mishravipul361-blip/Ferrite-motor-design/femm_em/dq_summary.txt

D-Q MAP  (path values, peak; phase current = 2 x path current)
  magnet flux linkage psi_m            0.0211 Wb-turn
  Ld per path, unsat (id=-37.5 A)      219.1 uH    -> per delta phase 109.6 uH
  Lq per path, unsat (iq=37.5 A)       307.2 uH    -> per delta phase 153.6 uH
  at load (id -75, iq 112.5, ~rated):    Ld 187.1 uH, Lq 228.8 uH per path (delta phase 93.5 / 114.4 uH), Lq/Ld 1.22
  characteristic current psi_m/Ld      96 A path peak = 236 A rms line  (current limit 360 A rms)
  d-q torque formula vs FEMM torque    max diff 0.4 N.m

TORQUE-SPEED ENVELOPE  360 A rms + 11 kW DC, 52 V (phase peak 49.4 V), R at 100 C, inverter eff 0.97
     rpm    T N.m  shaft kW  DC kW  Cu loss W  I A rms    id    iq   V peak
       0    44.96     0.00    0.90       871      360    -64   132     2.0
    1000    44.96     4.71    5.75       871      360    -64   132    17.0
    2000    44.96     9.42   10.60       871      360    -64   132    32.5
    3000    32.64    10.25   11.00       414      248    -26    98    45.3
    4000    24.84    10.40   10.98       245      191    -37    69    49.2
    5000    19.85    10.39   10.97       252      194    -60    51    44.8
    6000    16.55    10.40   10.95       220      181    -60    43    47.7
    7000    14.20    10.41   10.95       212      178    -62    37    49.1
    8000    12.34    10.34   10.91       245      191    -71    32    46.2
    9000    10.91    10.29   10.89       280      204    -78    28    43.2
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

Calibration (motor_config.json): {'magnet_temp_C': 35.0, 'stacking': 0.95, 'mu_mag': 1.1}
Not included: end-winding leakage inductance (adds to Ld and Lq -> lower base speed),
iron and mechanical losses (shaft power is a little lower, DC power a little higher), 3D magnet end leakage.
