mishravipul361-blip/Ferrite-motor-design/Design9795_1/report_alu_f40/index.html

12-slot / 10-pole ferrite spoke

# Design9795 aluminium winding

FEMM 4.2 · Motor-CAD-equivalent model
OD 160–170 · M235-35A
Al: fill ≤ 0.40, bundle AC loss, end winding 1.136
Cu: busbar, fill 0.513, 0.7
17 Oct 2026

Design9795 · aluminium winding · conventional winding, fill ≤ 0.40

## Summary

#### Busbar copper against conventional aluminium

The copper reference is Design9795_1 as built: busbar-connected tooth coils, insulated wire fill 0.513, Motor-CAD armature end-winding MLT multiplier 0.7 (mean turn 203.6 mm, 13.48 mΩ per path at 100 °C). Every aluminium design is a conventional winding: insulated wire fill at most 0.40, standard wire sizes, end-winding multiplier 1.136 (end turns 1.623 × longer), and the strands in hand treated as one bundle for proximity loss, as Motor-CAD does with Include Bundle Effect: more strands do not reduce the AC loss. The rotor is unchanged; only the stator, stack length and winding change.

Aluminium can replace the copper winding of Design9795_1 with stator-only changes (rotor cross-section, magnets, air gap and M235-35A kept), and a conventional winding at 40 % fill, but not at equal efficiency up to OD 170. The best balance saves ₹418 per motor (10 % of active-material cost) for 3.73 % range.

#### Recommended · OD 170 · 86 mm

−₹418

Range -3.73 % (telematics), -3.75 % (WMTC). Stator K6 (OD 170, yoke 7.85 mm, slot 23.65 mm deep, tooth 13.54 mm), 86 mm stack, 8 turns × 3 × 2.12 mm Al. Torque within 0.8 % of copper at every speed, +1.82 kg. Winding loss at peak torque +24 %.

#### Alternative, 98.5 % torque at high speed · OD 170 · 80 mm

−₹612

Range -3.10 % / -3.32 %. Stator K2 (OD 170, yoke 7.85 mm, slot 23.65 mm deep, tooth 15.54 mm), 80 mm stack, 8 turns × 1 × 3.55 mm Al. Winding loss at peak +28 %, +1.41 kg.

#### Least range loss · OD 170 · 90 mm

−₹124

Range -3.12 % / -3.38 %. Stator K1 (OD 170, yoke 8.85 mm, slot 22.65 mm deep, tooth 15.54 mm), 90 mm stack, 7 turns × 4 × 1.83 mm Al. Winding loss at peak +13 %, +2.68 kg.

### Cost against range, all designs

Every aluminium design evaluated (2946), Al wire at ₹370/kg. Lines: best designs at each O

Every aluminium design evaluated (2946), Al wire at ₹370/kg. Lines: best designs at each OD (none both cheaper and better on range). Left: torque within 1 % of copper at every speed. Right: up to 3 % short in the high-speed, DC-power-limited region.

### Best designs at each OD (full torque)

OD | Least range loss | Range | Saving (INR) | Largest saving | Range | Saving (INR)
OD 160 | no design keeps full torque (stack up to 100 mm) | – | – | – | – | –
OD 163 | G3 L94 N7 3x2.00 | −3.81 % | 252 | G5 L94 N7 1x3.55 | −3.97 % | 299
OD 165 | B3 L92 N7 1x3.55 | −3.57 % | 278 | B4 L92 N7 4x1.80 | −3.65 % | 281
OD 167 | F2 L90 N7 4x1.80 | −3.32 % | 263 | F2 L90 N7 4x1.80 | −3.32 % | 263
OD 170 | K1 L90 N7 4x1.83 | −3.12 % | 124 | K6 L86 N8 3x2.12 | −3.73 % | 418

Range parity is not reached: aluminium needs 1.64 × copper's conductor area for the same resistance (about 2.0 × with the longer end turns of the 1.136 multiplier). At 0.40 fill instead of 0.513, the stators up to OD 170 give only 0.78–1.30 × copper's conductor area at the same turns, so fewer turns and longer stacks carry the design. Each OD page has the details: stator variants, all best designs, efficiency maps, OP1–OP3, drive cycle and cost.

### Key designs

| Copper (today) | Least range loss | Alternative, 98.5 % torque at high speed | Recommended | Drop-in (reference)
Design | Cu SWG 11 | K1 L90 N7 4x1.83 | K2 L80 N8 1x3.55 | K6 L86 N8 3x2.12 | drop-in (SWG 11, 64 mm)
Stator OD (mm) | 160 | 170 | 170 | 170 | 160
Stator variant | D0 | K1 | K2 | K6 | D0
Stack length, stator = rotor = magnets (mm) | 64 | 90 | 80 | 86 | 64
Slot depth (mm) | 17.65 | 22.65 | 23.65 | 23.65 | 17.65
Tooth width (mm) | 15.54 | 15.54 | 15.54 | 13.54 | 15.54
Yoke (mm) | 8.85 | 8.85 | 7.85 | 7.85 | 8.85
Slot area (mm²) | 281.2 (×1.000) | 395.9 (×1.408) | 420.4 (×1.495) | 462.1 (×1.643) | 281.2 (×1.000)
Turns per coil | 10 | 7 | 8 | 8 | 10
Strands × bare diameter (mm) | 1 × 2.95 | 4 × 1.83 | 1 × 3.55 | 3 × 2.12 | 1 × 2.95
Conductor area (mm²) | 6.82 | 10.51 | 9.90 | 10.59 | 6.82
Insulated fill | 0.513 | 0.400 | 0.396 | 0.392 | 0.513
Mean turn length (mm) | 203.6 | 306.2 | 286.9 | 297.1 | 250.7
Resistance per path, 100 °C (mΩ) | 13.48 | 15.24 | 17.33 | 16.78 | 27.49
Peak torque, 1000 rpm (N·m) | 44.11 | 44.63 | 44.38 | 46.04 | 44.11
Worst envelope ratio vs copper | – | 99.4 % | 98.5 % | 99.2 % | 95.2 %
Winding loss at peak torque (W) | 885 | 996 | 1132 | 1096 | 1786
Current density at peak (A/mm² rms) | 15.2 | 9.9 | 10.5 | 9.8 | 15.2
Peak efficiency (%) | 95.36 | 94.54 | 94.40 | 94.44 | 94.27
Map efficiency, mean change (points) | – | −1.92 | −2.19 | −2.10 | −3.55
Telematics: Wh/km at motor terminals | 61.291 | 63.265 | 63.251 | 63.667 | 63.574
Range change, telematics | – | −3.12 % | −3.10 % | −3.73 % | −3.59 %
Range change, WMTC Class 1 | – | −3.38 % | −3.32 % | −3.75 % | −3.31 %
Winding mass (kg) | 1.488 | 0.731 | 0.737 | 0.816 | 0.555
Stator laminations (kg) | 3.635 | 5.921 | 5.089 | 5.151 | 3.635
Rotor laminations + magnets (kg) | 2.832 | 3.982 | 3.540 | 3.805 | 2.832
Active mass (kg) | 7.955 | 10.634 | 9.365 | 9.772 | 7.021
Material cost (INR) | 4349 | 4225 | 3737 | 3931 | 2846
Saving vs copper (INR) | – | 124 (2.8 %) | 612 (14.1 %) | 418 (9.6 %) | 1504 (34.6 %)

### Operating points OP1–OP3

Efficiency change vs copper (points) | Least range loss | Alternative, 98.5 % torque at high speed | Recommended | Drop-in
OP1: 9000 rpm, maximum power | +0.26 | −0.05 | −0.21 | −1.56
OP2: 9339 rpm, 3.24 N·m | −4.69 | −3.37 | −4.79 | −0.91
OP3: 2000 rpm, maximum torque | −1.00 | −2.20 | −1.60 | −7.12

AC winding loss at 9000 rpm (OP1): copper's single 2.95 mm wire 505 W; the key aluminium designs 327–351 W with the bundle effect (aluminium's higher resistivity lowers eddy loss at the same bundle size; its strands do not). At peak torque (OP3) the higher DC resistance costs efficiency. Full tables on the OD 170 page.

Design9795 · aluminium winding · conventional winding, fill ≤ 0.40

## Busbar fill vs 40 % fill

The same aluminium study run twice against the same copper reference (busbar, fill 0.513, multiplier 0.7). Earlier: aluminium allowed copper's 0.513 fill, AC loss strand by strand, OD up to 167. Now: conventional winding at fill ≤ 0.40, AC loss with the bundle effect, OD up to 170, stacks up to 100 mm, 7–10 turns.

OD | Choice | Fill 0.513 design | Range | Saving (INR) | Fill 0.40 design | Range | Saving (INR)
OD 160 | least range loss | A5 L82 N8 4x1.80 | −2.36 % | 819 | – | – | –
OD 160 | largest saving | A5 L82 N8 5x1.60 | −2.38 % | 823 | – | – | –
OD 163 | least range loss | G3 L80 N8 4x1.83 | −1.96 % | 782 | G3 L94 N7 3x2.00 | −3.81 % | 252
OD 163 | within 2 % range | G3 L80 N8 5x1.63 | −1.97 % | 786 | – | – | –
OD 163 | largest saving | G3 L78 N9 6x1.40 | −2.60 % | 871 | G5 L94 N7 1x3.55 | −3.97 % | 299
OD 165 | least range loss | B2 L80 N8 6x1.50 | −1.83 % | 698 | B3 L92 N7 1x3.55 | −3.57 % | 278
OD 165 | within 2 % range | B3 L80 N8 6x1.50 | −2.00 % | 739 | – | – | –
OD 165 | largest saving | B3 L78 N9 6x1.42 | −2.61 % | 822 | B4 L92 N7 4x1.80 | −3.65 % | 281
OD 167 | least range loss | F1 L78 N8 6x1.50 | −1.54 % | 696 | F2 L90 N7 4x1.80 | −3.32 % | 263
OD 167 | within 2 % range | F4 L74 N9 4x1.90 | −1.96 % | 952 | – | – | –
OD 167 | largest saving | F4 L74 N9 4x1.90 | −1.96 % | 952 | F2 L90 N7 4x1.80 | −3.32 % | 263
OD 170 | least range loss | – | – | – | K1 L90 N7 4x1.83 | −3.12 % | 124
OD 170 | largest saving | – | – | – | K6 L86 N8 3x2.12 | −3.73 % | 418
All ODs | least range loss | F1 L78 N8 6x1.50 | −1.54 % | 696 | K1 L90 N7 4x1.83 | −3.12 % | 124
All ODs | within 2 % range | F4 L74 N9 4x1.90 | −1.96 % | 952 | – | – | –
All ODs | largest saving | F4 L74 N9 4x1.90 | −1.96 % | 952 | K6 L86 N8 3x2.12 | −3.73 % | 418

Full torque at every speed (envelope ≥ 99 %, peak ≥ 99.5 % of copper). Range on the telematics cycle; savings against copper at Al ₹370/kg.

Design9795 · aluminium winding · conventional winding, fill ≤ 0.40

## Method and copper baseline

Every number comes from the Motor-CAD-equivalent FEMM model of Design9795_1, extended with FEMM solutions of each stator variant, then run through the vehicle drive cycles.

Stage | Script | What it computes | Count
1. Copper model | lab_model.py (v3), make_lab_v2.py | Motor-CAD-equivalent Lab model: skew slices, Motor-CAD torque, minor-loop hysteresis + harmonic eddy iron loss | validated on 840 Motor-CAD map points
2. Stator variants | alu9795_femm.py (FEMM) | Torque, d-q flux, stator iron-loss sums, slot field, tooth and yoke flux density on a 4 × 4 current grid × 2 rotor positions | 28 stators × 32 = 896 solves
3. Design search | alu9795_study.py, alu9795_search.py | Each stator × stack 64–100 mm × 7/8/9/10 turns per coil × wire (largest area at fill ≤ 0.40; also the fewest strands within 3 % of it): envelope, efficiency map, peak point, drive cycles, cost | 2946 designs
4. Best designs | alu9795_analyse.py | Cost against range fronts per OD and criterion; Al price sensitivity | 5 ODs × 2 criteria × 3 prices
5. FEMM check | alu9795_verify.py | Direct solves between grid nodes, 4 rotor positions, against the interpolation | 60 solves
6. Operating points | alu9795_ops.py | OP1–OP3: currents, phase advance, voltage, flux, power factor, loss breakdown | 16 designs

### Copper baseline (Design9795_1)

Stator OD 160 mm, bore 107 mm, 12 slots, slot depth 17.65 mm, tooth 15.54 mm, yoke 8.85 mm, slot 281.2 mm²; 10-pole spoke ferrite rotor; 64 mm stack; delta, 2 parallel paths, 10 turns per coil of SWG 11 (2.946 mm) copper, fill 0.513; M235-35A. Drive: 52 V, modulation 0.95 (49.4 V phase peak), 360 A rms line, 280 A DC, MTPA. Winding and magnets at 100 °C.

#### Busbar copper against conventional aluminium

The copper reference is Design9795_1 as built: busbar-connected tooth coils, insulated wire fill 0.513, Motor-CAD armature end-winding MLT multiplier 0.7 (mean turn 203.6 mm, 13.48 mΩ per path at 100 °C). Every aluminium design is a conventional winding: insulated wire fill at most 0.40, standard wire sizes, end-winding multiplier 1.136 (end turns 1.623 × longer), and the strands in hand treated as one bundle for proximity loss, as Motor-CAD does with Include Bundle Effect: more strands do not reduce the AC loss. The rotor is unchanged; only the stator, stack length and winding change.

The FEMM copper model matches Motor-CAD Lab within 0.28 efficiency points (mean over 840 map points), 1.6 % torque and 2.7 % total loss; envelope torque within 0.7 % from 1000 to 9000 rpm (see the Lab validation report).

Copper efficiency map from the Motor-CAD-equivalent FEMM model, with the three operating p

Copper efficiency map from the Motor-CAD-equivalent FEMM model, with the three operating points.

OP1 · 9000 rpm, maximum power | Motor-CAD, copper | Copper (FEMM)
Shaft torque (N·m) | 13.98 | 14.05
Electromagnetic torque (N·m) | 14.46 | 14.50
Shaft power (W) | 13178 | 13239
Input power (W) | 14560 | 14552
Efficiency (%) | 90.51 | 90.97
Line current (A rms) | 247.2 | 236.3
Phase current (A rms, delta) | 142.7 | 136.4
Id, phase (A peak) | −184.2 | −173.3
Iq, phase (A peak) | 82.5 | 84.7
Phase advance (° el) | 65.9 | 63.9
Phase voltage (V peak, limit 49.4) | 49.40 | 49.38
Power factor | 0.974 | 0.983
ψd (mV·s) | 1.72 | 2.68
ψq (mV·s) | 9.69 | 9.85
DC bus current (A) | 280.0 | 279.9
Current density (A/mm² rms) | – | 10.0
Active limit | – | voltage, DC current
DC winding loss (W) | 411.7 | 376.2
AC winding loss (W) | 526.5 | 505.5
Stator hysteresis (W) | – | 71.6
Stator eddy (W) | – | 125.7
Stator iron total (W) | 205.3 | 197.4
Rotor iron (W) | 89.4 | 85.7
Iron total (W) | 294.7 | 283.1
Bearings + windage (W) | 148.9 | 148.9
Total loss (W) | 1381.8 | 1313.6

OP2 · 9339 rpm, 3.24 N·m | Copper (FEMM)
Shaft torque (N·m) | 3.27
Electromagnetic torque (N·m) | 3.62
Shaft power (W) | 3195
Input power (W) | 3785
Efficiency (%) | 84.41
Line current (A rms) | 120.7
Phase current (A rms, delta) | 69.7
Id, phase (A peak) | −96.2
Iq, phase (A peak) | 21.8
Phase advance (° el) | 77.2
Phase voltage (V peak, limit 49.4) | 49.22
Power factor | 0.499
ψd (mV·s) | 9.59
ψq (mV·s) | 2.84
DC bus current (A) | 72.8
Current density (A/mm² rms) | 5.1
Active limit | voltage
DC winding loss (W) | 98.3
AC winding loss (W) | 150.4
Stator hysteresis (W) | 54.2
Stator eddy (W) | 99.6
Stator iron total (W) | 153.8
Rotor iron (W) | 31.6
Iron total (W) | 185.4
Bearings + windage (W) | 156.2
Total loss (W) | 590.2

OP3 · 2000 rpm, maximum torque | Motor-CAD, copper | Copper (FEMM)
Shaft torque (N·m) | 44.11 | 44.06
Electromagnetic torque (N·m) | 44.76 | 44.67
Shaft power (W) | 9239 | 9227
Input power (W) | 10306 | 10284
Efficiency (%) | 89.65 | 89.73
Line current (A rms) | 360.0 | 360.0
Phase current (A rms, delta) | 207.8 | 207.8
Id, phase (A peak) | −85.0 | −90.8
Iq, phase (A peak) | 281.4 | 279.6
Phase advance (° el) | 16.8 | 18.0
Phase voltage (V peak, limit 49.4) | 34.36 | 33.85
Power factor | 0.680 | 0.685
ψd (mV·s) | 12.48 | 12.00
ψq (mV·s) | 28.90 | 28.65
DC bus current (A) | 198.2 | 197.8
Current density (A/mm² rms) | – | 15.2
Active limit | – | 360 A
DC winding loss (W) | 873.5 | 873.5
AC winding loss (W) | 57.4 | 54.7
Stator hysteresis (W) | – | 61.2
Stator eddy (W) | – | 20.4
Stator iron total (W) | 87.4 | 81.5
Rotor iron (W) | 27.7 | 25.9
Iron total (W) | 115.1 | 107.4
Bearings + windage (W) | 21.1 | 21.1
Total loss (W) | 1067.1 | 1056.6

Motor-CAD values from its envelope export (OP1, OP3). Motor-CAD splits iron loss into stator/rotor and hysteresis/eddy for the machine; its OP1 hysteresis 111 W, eddy 184 W. FEMM's OP1 iron loss is lower (the known hysteresis gap), so copper's FEMM efficiency is +0.46 points against Motor-CAD at OP1 and +0.08 at OP3. Aluminium designs are compared with FEMM copper, so this offset cancels.

### How an aluminium design is evaluated

- Turns: currents scaled by turns (same ampere-turns give the same field), flux linkage × turns, end-winding inductance × turns².
- Stack length: flux, torque, iron loss and windage scale with length (2D); end-turn length unchanged.
- Stator variant: FEMM differences against the copper stator at the same ampere-turns, added to the copper model (flux), or as ratios (stator iron loss, slot field). Checked against direct FEMM solves: ψq within 0.88 %, iron-loss ratio within 1.6 %.
- Winding: aluminium EC-1350 (2.826 × 10⁻⁸ Ω·m at 20 °C, 0.00403/K, 2703 kg/m³) at 100 °C; conventional winding with insulated wire fill at most 0.40 (copper's busbar winding: 0.513); standard IEC and SWG wire sizes from 1.0 mm, 1–8 strands; mean turn = 2L + 1.136/0.7 × end turn corrected for tooth width and coil thickness; AC loss by Motor-CAD's hybrid method (factor 2) with FEMM's slot field and the bundle effect: the strands in hand count as one round conductor of the same total area (loss ∝ turns × (strands × d²)²), so it does not fall with more strands.
- Acceptance: full = peak torque ≥ 99.5 % of copper and envelope ≥ 99 % at every speed 0–9500 rpm; relaxed = envelope ≥ 97 % (shortfall only in the DC-power-limited region above about 3000 rpm).

Design9795 · aluminium winding · conventional winding, fill ≤ 0.40

## OD 160 mm

Same OD and housing as copper. The slot can only grow inward (thinner yoke) or sideways (thinner teeth), and both cost torque per ampere-turn: −1.3 % per mm of yoke, −1.9 % per mm of tooth. Aluminium therefore needs a long stack. 723 designs evaluated at this OD; 0 keep full torque at every speed, 120 stay within 3 %.

### Stator variants at OD 160

Stator | OD | Slot depth | Tooth | Yoke | Slot area (mm²) | vs copper | Max torque (N·m)* | vs copper | Tooth B 99 % (T) | Yoke B 99 % (T) | Stator steel (kg)*
D0 | 160 | 17.65 | 15.54 | 8.85 | 281.2 | ×1.000 | 50.62 | +0.0 % | 2.28 | 1.70 | 3.635
A1 | 160 | 18.65 | 15.54 | 7.85 | 303.1 | ×1.078 | 49.97 | −1.3 % | 2.28 | 1.78 | 3.510
A2 | 160 | 19.65 | 15.54 | 6.85 | 325.5 | ×1.157 | 48.38 | −4.4 % | 2.25 | 1.83 | 3.382
A3 | 160 | 17.65 | 14.54 | 8.85 | 296.2 | ×1.053 | 49.68 | −1.9 % | 2.27 | 1.66 | 3.550
A4 | 160 | 18.65 | 14.54 | 7.85 | 319.0 | ×1.135 | 49.16 | −2.9 % | 2.26 | 1.76 | 3.419
A5 | 160 | 19.65 | 14.54 | 6.85 | 342.5 | ×1.218 | 47.74 | −5.7 % | 2.24 | 1.82 | 3.285
A6 | 160 | 18.65 | 13.54 | 7.85 | 334.7 | ×1.190 | 48.06 | −5.0 % | 2.26 | 1.74 | 3.330

* FEMM 2D, 64 mm stack, 10 turns per coil, peak over the 4 × 4 current grid at 360 A (no skew). Dimensions in mm.

Slot outlines of the OD 160 stators against the copper stator (D0). Tooth tip and slot ope

Slot outlines of the OD 160 stators against the copper stator (D0). Tooth tip and slot opening are unchanged in every variant.

### Cost against range

All designs at OD 160. Dark: full torque at every speed; light blue: within 3 %; grey: nei

All designs at OD 160. Dark: full torque at every speed; light blue: within 3 %; grey: neither. Line: best designs (full). Circles: designs detailed below.

#### Best designs, full torque at every speed

No design at this OD meets this criterion.

#### Best designs, up to 3 % torque shortfall at high speed

Design | Stator | Yoke (mm) | Stack (mm) | Turns × (strands × d) | Worst envelope | Range, telematics | Range, WMTC | Saving (INR) | Winding loss at peak (W) | Mass change (kg)
A3 L90 N7 2x2.24 | A3 | 8.85 | 90 | 7 × (2 × 2.24) | 97.8 % | −3.67 % | −3.87 % | 477 | 1302 | +1.56
A3 L90 N7 1x3.15 | A3 | 8.85 | 90 | 7 × (1 × 3.15) | 97.8 % | −3.72 % | −3.93 % | 479 | 1317 | +1.55
A4 L90 N7 4x1.63 | A4 | 7.85 | 90 | 7 × (4 × 1.63) | 98.0 % | −3.74 % | −4.04 % | 520 | 1240 | +1.41
A4 L90 N7 1x3.25 | A4 | 7.85 | 90 | 7 × (1 × 3.25) | 98.0 % | −3.74 % | −4.04 % | 520 | 1241 | +1.41
A6 L82 N8 1x3.15 | A6 | 7.85 | 82 | 8 × (1 × 3.15) | 97.2 % | −3.94 % | −4.02 % | 872 | 1425 | +0.52
A5 L82 N8 3x1.83 | A5 | 6.85 | 82 | 8 × (3 × 1.83) | 97.2 % | −4.03 % | −4.15 % | 886 | 1416 | +0.47
A5 L82 N8 1x3.15 | A5 | 6.85 | 82 | 8 × (1 × 3.15) | 97.1 % | −4.09 % | −4.20 % | 888 | 1432 | +0.46

At the copper stack of 64 mm, no design at this OD meets either criterion: aluminium at 64 mm loses torque either at low speed (fewer turns, 360 A limit) or above 2500 rpm (10 turns, higher resistance).

### Effect of stack length and turns

Best design (range) at each stack length and turn count at OD 160, among those within 3 %

Best design (range) at each stack length and turn count at OD 160, among those within 3 % of copper torque; filled dots also meet the full criterion. Fewer turns need a longer stack for the same torque at 360 A.

### Designs in detail

| Copper (today) | Least range loss, ≤ 3 % high-speed torque | Largest saving, ≤ 3 % high-speed torque
Design | Cu SWG 11 | A3 L90 N7 2x2.24 | A5 L82 N8 1x3.15
Stator OD (mm) | 160 | 160 | 160
Stator variant | D0 | A3 | A5
Stack length, stator = rotor = magnets (mm) | 64 | 90 | 82
Slot depth (mm) | 17.65 | 17.65 | 19.65
Tooth width (mm) | 15.54 | 14.54 | 14.54
Yoke (mm) | 8.85 | 8.85 | 6.85
Slot area (mm²) | 281.2 (×1.000) | 296.2 (×1.053) | 342.5 (×1.218)
Turns per coil | 10 | 7 | 8
Strands × bare diameter (mm) | 1 × 2.95 | 2 × 2.24 | 1 × 3.15
Conductor area (mm²) | 6.82 | 7.88 | 7.79
Insulated fill | 0.513 | 0.397 | 0.384
Mean turn length (mm) | 203.6 | 301.8 | 287.2
Resistance per path, 100 °C (mΩ) | 13.48 | 20.04 | 22.04
Peak torque, 1000 rpm (N·m) | 44.11 | 44.25 | 44.32
Worst envelope ratio vs copper | – | 97.8 % | 97.1 %
Winding loss at peak torque (W) | 885 | 1302 | 1432
Current density at peak (A/mm² rms) | 15.2 | 13.2 | 13.3
Peak efficiency (%) | 95.36 | 94.31 | 94.13
Map efficiency, mean change (points) | – | −2.96 | −3.26
Telematics: Wh/km at motor terminals | 61.291 | 63.623 | 63.903
Range change, telematics | – | −3.67 % | −4.09 %
Range change, WMTC Class 1 | – | −3.87 % | −4.20 %
Winding mass (kg) | 1.488 | 0.540 | 0.581
Stator laminations (kg) | 3.635 | 4.992 | 4.209
Rotor laminations + magnets (kg) | 2.832 | 3.982 | 3.628
Active mass (kg) | 7.955 | 9.514 | 8.419
Material cost (INR) | 4349 | 3872 | 3461
Saving vs copper (INR) | – | 477 (11.0 %) | 888 (20.4 %)

### Torque-speed envelope

Maximum shaft torque at each speed against copper, same drive limits. Right: ratio to copp

Maximum shaft torque at each speed against copper, same drive limits. Right: ratio to copper; dotted lines 99 % and 97 %.

### Efficiency maps against copper

Efficiency change against copper at the same speed and shaft torque (blue = aluminium bett

Efficiency change against copper at the same speed and shaft torque (blue = aluminium better). Triangles: OP1–OP3.

Efficiency map of A5 L82 N8 1x3.15.

Efficiency map of A5 L82 N8 1x3.15.

### Operating points OP1, OP2, OP3

Efficiency change vs copper (points) | Least range loss, ≤ 3 % high-speed torque | Largest saving, ≤ 3 % high-speed torque
OP1: 9000 rpm, maximum power | −0.12 | −0.25
OP2: 9339 rpm, 3.24 N·m | −4.67 | −4.17
OP3: 2000 rpm, maximum torque | −3.40 | −4.47

Loss breakdown at the operating points; label = total loss and efficiency.

Loss breakdown at the operating points; label = total loss and efficiency.

OP1 · 9000 rpm, maximum power | Motor-CAD, copper | Copper (FEMM) | Least range loss, ≤ 3 % high-speed torque | Largest saving, ≤ 3 % high-speed torque
Shaft torque (N·m) | 13.98 | 14.05 | 14.03 | 13.99
Electromagnetic torque (N·m) | 14.46 | 14.50 | 14.54 | 14.51
Shaft power (W) | 13178 | 13239 | 13227 | 13187
Input power (W) | 14560 | 14552 | 14559 | 14535
Efficiency (%) | 90.51 | 90.97 | 90.85 | 90.73
Line current (A rms) | 247.2 | 236.3 | 254.2 | 240.0
Phase current (A rms, delta) | 142.7 | 136.4 | 146.8 | 138.6
Id, phase (A peak) | −184.2 | −173.3 | −187.7 | −176.6
Iq, phase (A peak) | 82.5 | 84.7 | 88.8 | 84.9
Phase advance (° el) | 65.9 | 63.9 | 64.7 | 64.3
Phase voltage (V peak, limit 49.4) | 49.40 | 49.38 | 47.86 | 49.18
Power factor | 0.974 | 0.983 | 0.963 | 0.990
ψd (mV·s) | 1.72 | 2.68 | 6.47 | 5.63
ψq (mV·s) | 9.69 | 9.85 | 7.27 | 8.25
DC bus current (A) | 280.0 | 279.9 | 280.0 | 279.5
Current density (A/mm² rms) | – | 10.0 | 9.3 | 8.9
Active limit | – | voltage, DC current | DC current | voltage, DC current
DC winding loss (W) | 411.7 | 376.2 | 647.6 | 634.7
AC winding loss (W) | 526.5 | 505.5 | 207.9 | 229.4
Stator hysteresis (W) | – | 71.6 | 84.8 | 89.2
Stator eddy (W) | – | 125.7 | 148.9 | 155.4
Stator iron total (W) | 205.3 | 197.4 | 233.7 | 244.7
Rotor iron (W) | 89.4 | 85.7 | 75.3 | 77.6
Iron total (W) | 294.7 | 283.1 | 309.0 | 322.3
Bearings + windage (W) | 148.9 | 148.9 | 167.0 | 161.4
Total loss (W) | 1381.8 | 1313.6 | 1331.5 | 1347.8

OP2 · 9339 rpm, 3.24 N·m | Copper (FEMM) | Least range loss, ≤ 3 % high-speed torque | Largest saving, ≤ 3 % high-speed torque
Shaft torque (N·m) | 3.27 | 3.29 | 3.24
Electromagnetic torque (N·m) | 3.62 | 3.75 | 3.69
Shaft power (W) | 3195 | 3221 | 3172
Input power (W) | 3785 | 4039 | 3953
Efficiency (%) | 84.41 | 79.74 | 80.24
Line current (A rms) | 120.7 | 165.0 | 150.0
Phase current (A rms, delta) | 69.7 | 95.3 | 86.6
Id, phase (A peak) | −96.2 | −132.7 | −120.5
Iq, phase (A peak) | 21.8 | 23.2 | 21.9
Phase advance (° el) | 77.2 | 80.1 | 79.7
Phase voltage (V peak, limit 49.4) | 49.22 | 49.39 | 49.36
Power factor | 0.499 | 0.395 | 0.425
ψd (mV·s) | 9.59 | 9.78 | 9.71
ψq (mV·s) | 2.84 | 2.05 | 2.31
DC bus current (A) | 72.8 | 77.7 | 76.0
Current density (A/mm² rms) | 5.1 | 6.0 | 5.6
Active limit | voltage | voltage | voltage
DC winding loss (W) | 98.3 | 272.7 | 247.9
AC winding loss (W) | 150.4 | 98.0 | 100.1
Stator hysteresis (W) | 54.2 | 81.8 | 79.7
Stator eddy (W) | 99.6 | 147.4 | 144.3
Stator iron total (W) | 153.8 | 229.2 | 223.9
Rotor iron (W) | 31.6 | 43.1 | 40.0
Iron total (W) | 185.4 | 272.3 | 264.0
Bearings + windage (W) | 156.2 | 175.2 | 169.4
Total loss (W) | 590.2 | 818.2 | 781.4

OP3 · 2000 rpm, maximum torque | Motor-CAD, copper | Copper (FEMM) | Least range loss, ≤ 3 % high-speed torque | Largest saving, ≤ 3 % high-speed torque
Shaft torque (N·m) | 44.11 | 44.06 | 44.17 | 44.25
Electromagnetic torque (N·m) | 44.76 | 44.67 | 44.87 | 44.97
Shaft power (W) | 9239 | 9227 | 9251 | 9268
Input power (W) | 10306 | 10284 | 10716 | 10870
Efficiency (%) | 89.65 | 89.73 | 86.33 | 85.26
Line current (A rms) | 360.0 | 360.0 | 360.0 | 360.0
Phase current (A rms, delta) | 207.8 | 207.8 | 207.8 | 207.8
Id, phase (A peak) | −85.0 | −90.8 | −72.4 | −89.9
Iq, phase (A peak) | 281.4 | 279.6 | 284.9 | 279.8
Phase advance (° el) | 16.8 | 18.0 | 14.3 | 17.8
Phase voltage (V peak, limit 49.4) | 34.36 | 33.85 | 30.32 | 31.57
Power factor | 0.680 | 0.685 | 0.800 | 0.779
ψd (mV·s) | 12.48 | 12.00 | 15.45 | 13.64
ψq (mV·s) | 28.90 | 28.65 | 21.85 | 24.22
DC bus current (A) | 198.2 | 197.8 | 206.1 | 209.0
Current density (A/mm² rms) | – | 15.2 | 13.2 | 13.3
Active limit | – | 360 A | 360 A | 360 A
DC winding loss (W) | 873.5 | 873.5 | 1298.3 | 1428.1
AC winding loss (W) | 57.4 | 54.7 | 20.5 | 23.3
Stator hysteresis (W) | – | 61.2 | 73.3 | 78.0
Stator eddy (W) | – | 20.4 | 23.1 | 24.5
Stator iron total (W) | 87.4 | 81.5 | 96.4 | 102.6
Rotor iron (W) | 27.7 | 25.9 | 25.9 | 25.5
Iron total (W) | 115.1 | 107.4 | 122.3 | 128.1
Bearings + windage (W) | 21.1 | 21.1 | 23.6 | 22.8
Total loss (W) | 1067.1 | 1056.6 | 1464.8 | 1602.2

### Drive cycle and range

Design | Cycle | Net Wh/km | Shaft out, motoring | Electrical in, motoring | η motoring (%) | Shaft in, regen | Electrical out, regen | η regen (%) | DC winding loss | AC winding loss | Iron loss | Mech. loss | Total loss | Range change
Copper | Telematics | 61.291 | 81.53 | 87.83 | 92.82 | 28.55 | 26.54 | 92.97 | 2.82 | 0.84 | 3.04 | 1.61 | 8.32 | –
| WMTC Class 1 | 60.520 | 76.21 | 81.72 | 93.26 | 22.91 | 21.20 | 92.55 | 2.13 | 0.40 | 3.10 | 1.59 | 7.22 | –
Least range loss, ≤ 3 % high-speed torque | Telematics | 63.623 | 81.52 | 89.58 | 91.01 | 28.55 | 25.95 | 90.91 | 4.35 | 0.32 | 4.17 | 1.81 | 10.65 | −3.67 %
| WMTC Class 1 | 62.958 | 76.21 | 83.56 | 91.21 | 22.91 | 20.60 | 89.92 | 3.45 | 0.16 | 4.27 | 1.78 | 9.66 | −3.87 %
Largest saving, ≤ 3 % high-speed torque | Telematics | 63.903 | 81.43 | 89.77 | 90.71 | 28.54 | 25.86 | 90.63 | 4.65 | 0.38 | 4.24 | 1.75 | 11.01 | −4.09 %
| WMTC Class 1 | 63.175 | 76.21 | 83.72 | 91.03 | 22.91 | 20.54 | 89.67 | 3.60 | 0.18 | 4.37 | 1.72 | 9.87 | −4.20 %

Energies and losses in Wh/km at the motor (motor losses only; inverter, battery and vehicle are the same for every design).

Motor losses over the telematics cycle by type.

Motor losses over the telematics cycle by type.

Where the range is lost: extra loss against copper over the telematics cycle, by motor spe

Where the range is lost: extra loss against copper over the telematics cycle, by motor speed band, motoring (left) and regenerating (right).

### Cost

Design | Winding (kg) | Wire (INR) | Laminations (kg) | Laminations (INR) | Magnets (kg) | Magnets (INR) | Total (INR) | Saving, Al ₹370 | Saving, Al ₹230 | Saving, Al ₹450
Copper | 1.488 | 1719 | 5.087 | 1526 | 1.380 | 1104 | 4349 | – | – | –
Least range loss, ≤ 3 % high-speed torque | 0.540 | 210 | 7.033 | 2110 | 1.941 | 1553 | 3872 | 477 | 556 | 431
Largest saving, ≤ 3 % high-speed torque | 0.581 | 226 | 6.069 | 1821 | 1.768 | 1415 | 3461 | 888 | 973 | 839

Design9795 · aluminium winding · conventional winding, fill ≤ 0.40

## OD 163 mm

Three extra millimetres of OD deepen the slot by 1.5 mm with the copper yoke and tooth (slot ×1.118), or by 2.5 mm with a 1 mm thinner yoke. 494 designs evaluated at this OD; 4 keep full torque at every speed, 109 stay within 3 %.

### Stator variants at OD 163

Stator | OD | Slot depth | Tooth | Yoke | Slot area (mm²) | vs copper | Max torque (N·m)* | vs copper | Tooth B 99 % (T) | Yoke B 99 % (T) | Stator steel (kg)*
D0 | 160 | 17.65 | 15.54 | 8.85 | 281.2 | ×1.000 | 50.62 | +0.0 % | 2.28 | 1.70 | 3.635
G1 | 163 | 19.15 | 15.54 | 8.85 | 314.3 | ×1.118 | 50.48 | −0.3 % | 2.29 | 1.71 | 3.808
G2 | 163 | 20.15 | 15.54 | 7.85 | 336.9 | ×1.198 | 49.80 | −1.6 % | 2.27 | 1.78 | 3.679
G3 | 163 | 20.15 | 14.54 | 7.85 | 354.4 | ×1.260 | 48.96 | −3.3 % | 2.26 | 1.76 | 3.579
G4 | 163 | 21.15 | 15.54 | 6.85 | 360.1 | ×1.281 | 48.17 | −4.8 % | 2.25 | 1.83 | 3.546
G5 | 163 | 21.15 | 14.54 | 6.85 | 378.6 | ×1.346 | 47.52 | −6.1 % | 2.24 | 1.82 | 3.441

* FEMM 2D, 64 mm stack, 10 turns per coil, peak over the 4 × 4 current grid at 360 A (no skew). Dimensions in mm.

Slot outlines of the OD 163 stators against the copper stator (D0). Tooth tip and slot ope

Slot outlines of the OD 163 stators against the copper stator (D0). Tooth tip and slot opening are unchanged in every variant.

### Cost against range

All designs at OD 163. Dark: full torque at every speed; light blue: within 3 %; grey: nei

All designs at OD 163. Dark: full torque at every speed; light blue: within 3 %; grey: neither. Line: best designs (full). Circles: designs detailed below.

#### Best designs, full torque at every speed

Design | Stator | Yoke (mm) | Stack (mm) | Turns × (strands × d) | Worst envelope | Range, telematics | Range, WMTC | Saving (INR) | Winding loss at peak (W) | Mass change (kg)
G3 L94 N7 3x2.00 | G3 | 7.85 | 94 | 7 × (3 × 2.00) | 99.1 % | −3.81 % | −3.90 % | 252 | 1127 | +2.13
G5 L94 N7 1x3.55 | G5 | 6.85 | 94 | 7 × (1 × 3.55) | 99.0 % | −3.97 % | −4.21 % | 299 | 1076 | +1.96

#### Best designs, up to 3 % torque shortfall at high speed

Design | Stator | Yoke (mm) | Stack (mm) | Turns × (strands × d) | Worst envelope | Range, telematics | Range, WMTC | Saving (INR) | Winding loss at peak (W) | Mass change (kg)
G3 L80 N8 1x3.25 | G3 | 7.85 | 80 | 8 × (1 × 3.25) | 97.5 % | −3.48 % | −3.70 % | 845 | 1330 | +0.67
G5 L78 N9 2x2.24 | G5 | 6.85 | 78 | 9 × (2 × 2.24) | 97.3 % | −4.27 % | −3.90 % | 964 | 1557 | +0.33
G5 L78 N9 1x3.15 | G5 | 6.85 | 78 | 9 × (1 × 3.15) | 97.2 % | −4.34 % | −3.95 % | 967 | 1574 | +0.33

At the copper stack of 64 mm, no design at this OD meets either criterion: aluminium at 64 mm loses torque either at low speed (fewer turns, 360 A limit) or above 2500 rpm (10 turns, higher resistance).

### Effect of stack length and turns

Best design (range) at each stack length and turn count at OD 163, among those within 3 %

Best design (range) at each stack length and turn count at OD 163, among those within 3 % of copper torque; filled dots also meet the full criterion. Fewer turns need a longer stack for the same torque at 360 A.

### Designs in detail

| Copper (today) | Least range loss | Largest saving, full torque | Largest saving, ≤ 3 % high-speed torque
Design | Cu SWG 11 | G3 L94 N7 3x2.00 | G5 L94 N7 1x3.55 | G5 L78 N9 1x3.15
Stator OD (mm) | 160 | 163 | 163 | 163
Stator variant | D0 | G3 | G5 | G5
Stack length, stator = rotor = magnets (mm) | 64 | 94 | 94 | 78
Slot depth (mm) | 17.65 | 20.15 | 21.15 | 21.15
Tooth width (mm) | 15.54 | 14.54 | 14.54 | 14.54
Yoke (mm) | 8.85 | 7.85 | 6.85 | 6.85
Slot area (mm²) | 281.2 (×1.000) | 354.4 (×1.260) | 378.6 (×1.346) | 378.6 (×1.346)
Turns per coil | 10 | 7 | 7 | 9
Strands × bare diameter (mm) | 1 × 2.95 | 3 × 2.00 | 1 × 3.55 | 1 × 3.15
Conductor area (mm²) | 6.82 | 9.42 | 9.90 | 7.79
Insulated fill | 0.513 | 0.399 | 0.385 | 0.391
Mean turn length (mm) | 203.6 | 311.6 | 312.3 | 280.3
Resistance per path, 100 °C (mΩ) | 13.48 | 17.30 | 16.51 | 24.19
Peak torque, 1000 rpm (N·m) | 44.11 | 45.73 | 44.89 | 46.55
Worst envelope ratio vs copper | – | 99.1 % | 99.0 % | 97.2 %
Winding loss at peak torque (W) | 885 | 1127 | 1076 | 1574
Current density at peak (A/mm² rms) | 15.2 | 11.0 | 10.5 | 13.3
Peak efficiency (%) | 95.36 | 94.44 | 94.37 | 94.16
Map efficiency, mean change (points) | – | −2.37 | −2.44 | −3.09
Telematics: Wh/km at motor terminals | 61.291 | 63.721 | 63.823 | 64.069
Range change, telematics | – | −3.81 % | −3.97 % | −4.34 %
Range change, WMTC Class 1 | – | −3.90 % | −4.21 % | −3.95 %
Winding mass (kg) | 1.488 | 0.667 | 0.702 | 0.638
Stator laminations (kg) | 3.635 | 5.256 | 5.053 | 4.193
Rotor laminations + magnets (kg) | 2.832 | 4.159 | 4.159 | 3.451
Active mass (kg) | 7.955 | 10.082 | 9.914 | 8.282
Material cost (INR) | 4349 | 4097 | 4050 | 3382
Saving vs copper (INR) | – | 252 (5.8 %) | 299 (6.9 %) | 967 (22.2 %)

### Torque-speed envelope

Maximum shaft torque at each speed against copper, same drive limits. Right: ratio to copp

Maximum shaft torque at each speed against copper, same drive limits. Right: ratio to copper; dotted lines 99 % and 97 %.

### Efficiency maps against copper

Efficiency change against copper at the same speed and shaft torque (blue = aluminium bett

Efficiency change against copper at the same speed and shaft torque (blue = aluminium better). Triangles: OP1–OP3.

Efficiency map of G5 L78 N9 1x3.15.

Efficiency map of G5 L78 N9 1x3.15.

### Operating points OP1, OP2, OP3

Efficiency change vs copper (points) | Least range loss | Largest saving, full torque | Largest saving, ≤ 3 % high-speed torque
OP1: 9000 rpm, maximum power | −0.11 | −0.05 | −0.98
OP2: 9339 rpm, 3.24 N·m | −5.86 | −5.80 | −4.06
OP3: 2000 rpm, maximum torque | −1.79 | −1.60 | −5.00

Loss breakdown at the operating points; label = total loss and efficiency.

Loss breakdown at the operating points; label = total loss and efficiency.

OP1 · 9000 rpm, maximum power | Motor-CAD, copper | Copper (FEMM) | Least range loss | Largest saving, full torque | Largest saving, ≤ 3 % high-speed torque
Shaft torque (N·m) | 13.98 | 14.05 | 14.04 | 14.05 | 13.89
Electromagnetic torque (N·m) | 14.46 | 14.50 | 14.57 | 14.60 | 14.41
Shaft power (W) | 13178 | 13239 | 13229 | 13238 | 13092
Input power (W) | 14560 | 14552 | 14560 | 14559 | 14548
Efficiency (%) | 90.51 | 90.97 | 90.86 | 90.92 | 89.99
Line current (A rms) | 247.2 | 236.3 | 251.2 | 248.3 | 237.0
Phase current (A rms, delta) | 142.7 | 136.4 | 145.1 | 143.3 | 136.8
Id, phase (A peak) | −184.2 | −173.3 | −186.6 | −183.8 | −176.8
Iq, phase (A peak) | 82.5 | 84.7 | 85.3 | 85.5 | 78.7
Phase advance (° el) | 65.9 | 63.9 | 65.4 | 65.1 | 66.0
Phase voltage (V peak, limit 49.4) | 49.40 | 49.38 | 48.44 | 48.95 | 49.13
Power factor | 0.974 | 0.983 | 0.958 | 0.958 | 1.000
ψd (mV·s) | 1.72 | 2.68 | 6.62 | 6.73 | 4.02
ψq (mV·s) | 9.69 | 9.85 | 7.39 | 7.46 | 9.08
DC bus current (A) | 280.0 | 279.9 | 280.0 | 280.0 | 279.8
Current density (A/mm² rms) | – | 10.0 | 7.7 | 7.2 | 8.8
Active limit | – | voltage, DC current | DC current | DC current | voltage, DC current
DC winding loss (W) | 411.7 | 376.2 | 545.9 | 508.6 | 679.4
AC winding loss (W) | 526.5 | 505.5 | 279.6 | 292.6 | 287.7
Stator hysteresis (W) | – | 71.6 | 93.8 | 99.6 | 88.6
Stator eddy (W) | – | 125.7 | 165.6 | 175.3 | 156.6
Stator iron total (W) | 205.3 | 197.4 | 259.4 | 274.8 | 245.2
Rotor iron (W) | 89.4 | 85.7 | 76.2 | 75.4 | 85.0
Iron total (W) | 294.7 | 283.1 | 335.6 | 350.2 | 330.2
Bearings + windage (W) | 148.9 | 148.9 | 169.8 | 169.8 | 158.6
Total loss (W) | 1381.8 | 1313.6 | 1331.0 | 1321.3 | 1456.0

OP2 · 9339 rpm, 3.24 N·m | Copper (FEMM) | Least range loss | Largest saving, full torque | Largest saving, ≤ 3 % high-speed torque
Shaft torque (N·m) | 3.27 | 3.26 | 3.28 | 3.24
Electromagnetic torque (N·m) | 3.62 | 3.74 | 3.78 | 3.67
Shaft power (W) | 3195 | 3184 | 3210 | 3173
Input power (W) | 3785 | 4053 | 4084 | 3949
Efficiency (%) | 84.41 | 78.55 | 78.61 | 80.35
Line current (A rms) | 120.7 | 170.2 | 168.7 | 141.8
Phase current (A rms, delta) | 69.7 | 98.3 | 97.4 | 81.8
Id, phase (A peak) | −96.2 | −137.2 | −135.9 | −113.9
Iq, phase (A peak) | 21.8 | 22.2 | 22.4 | 20.3
Phase advance (° el) | 77.2 | 80.8 | 80.6 | 79.9
Phase voltage (V peak, limit 49.4) | 49.22 | 49.20 | 49.37 | 49.34
Power factor | 0.499 | 0.381 | 0.386 | 0.448
ψd (mV·s) | 9.59 | 9.76 | 9.79 | 9.63
ψq (mV·s) | 2.84 | 2.06 | 2.09 | 2.58
DC bus current (A) | 72.8 | 77.9 | 78.5 | 75.9
Current density (A/mm² rms) | 5.1 | 5.2 | 4.9 | 5.3
Active limit | voltage | voltage | voltage | voltage
DC winding loss (W) | 98.3 | 250.7 | 235.0 | 243.1
AC winding loss (W) | 150.4 | 142.6 | 149.9 | 114.9
Stator hysteresis (W) | 54.2 | 90.0 | 94.7 | 75.0
Stator eddy (W) | 99.6 | 162.3 | 170.4 | 137.0
Stator iron total (W) | 153.8 | 252.3 | 265.0 | 212.0
Rotor iron (W) | 31.6 | 45.7 | 45.5 | 39.5
Iron total (W) | 185.4 | 298.0 | 310.5 | 251.6
Bearings + windage (W) | 156.2 | 178.2 | 178.2 | 166.4
Total loss (W) | 590.2 | 869.5 | 873.6 | 776.0

OP3 · 2000 rpm, maximum torque | Motor-CAD, copper | Copper (FEMM) | Least range loss | Largest saving, full torque | Largest saving, ≤ 3 % high-speed torque
Shaft torque (N·m) | 44.11 | 44.06 | 45.62 | 44.78 | 46.47
Electromagnetic torque (N·m) | 44.76 | 44.67 | 46.40 | 45.57 | 47.22
Shaft power (W) | 9239 | 9227 | 9555 | 9379 | 9733
Input power (W) | 10306 | 10284 | 10867 | 10642 | 11487
Efficiency (%) | 89.65 | 89.73 | 87.93 | 88.12 | 84.73
Line current (A rms) | 360.0 | 360.0 | 360.0 | 360.0 | 360.0
Phase current (A rms, delta) | 207.8 | 207.8 | 207.8 | 207.8 | 207.8
Id, phase (A peak) | −85.0 | −90.8 | −76.1 | −81.6 | −99.0
Iq, phase (A peak) | 281.4 | 279.6 | 283.9 | 282.4 | 276.8
Phase advance (° el) | 16.8 | 18.0 | 15.0 | 16.1 | 19.7
Phase voltage (V peak, limit 49.4) | 34.36 | 33.85 | 30.97 | 30.17 | 34.73
Power factor | 0.680 | 0.685 | 0.794 | 0.798 | 0.748
ψd (mV·s) | 12.48 | 12.00 | 15.68 | 15.04 | 12.76
ψq (mV·s) | 28.90 | 28.65 | 22.82 | 22.42 | 27.93
DC bus current (A) | 198.2 | 197.8 | 209.0 | 204.7 | 220.9
Current density (A/mm² rms) | – | 15.2 | 11.0 | 10.5 | 13.3
Active limit | – | 360 A | 360 A | 360 A | 360 A
DC winding loss (W) | 873.5 | 873.5 | 1120.8 | 1069.6 | 1567.7
AC winding loss (W) | 57.4 | 54.7 | 27.6 | 28.2 | 29.1
Stator hysteresis (W) | – | 61.2 | 85.5 | 88.5 | 82.0
Stator eddy (W) | – | 20.4 | 26.8 | 27.6 | 26.3
Stator iron total (W) | 87.4 | 81.5 | 112.3 | 116.1 | 108.3
Rotor iron (W) | 27.7 | 25.9 | 26.6 | 26.0 | 26.9
Iron total (W) | 115.1 | 107.4 | 138.9 | 142.1 | 135.2
Bearings + windage (W) | 21.1 | 21.1 | 24.0 | 24.0 | 22.4
Total loss (W) | 1067.1 | 1056.6 | 1311.3 | 1264.0 | 1754.5

### Drive cycle and range

Design | Cycle | Net Wh/km | Shaft out, motoring | Electrical in, motoring | η motoring (%) | Shaft in, regen | Electrical out, regen | η regen (%) | DC winding loss | AC winding loss | Iron loss | Mech. loss | Total loss | Range change
Copper | Telematics | 61.291 | 81.53 | 87.83 | 92.82 | 28.55 | 26.54 | 92.97 | 2.82 | 0.84 | 3.04 | 1.61 | 8.32 | –
| WMTC Class 1 | 60.520 | 76.21 | 81.72 | 93.26 | 22.91 | 21.20 | 92.55 | 2.13 | 0.40 | 3.10 | 1.59 | 7.22 | –
Least range loss | Telematics | 63.721 | 81.67 | 89.72 | 91.03 | 28.55 | 26.00 | 91.04 | 3.68 | 0.44 | 4.65 | 1.84 | 10.60 | −3.81 %
| WMTC Class 1 | 62.975 | 76.21 | 83.60 | 91.16 | 22.91 | 20.63 | 90.04 | 2.84 | 0.22 | 4.80 | 1.81 | 9.67 | −3.90 %
Largest saving, full torque | Telematics | 63.823 | 81.62 | 89.78 | 90.91 | 28.56 | 25.96 | 90.90 | 3.53 | 0.46 | 4.93 | 1.84 | 10.76 | −3.97 %
| WMTC Class 1 | 63.181 | 76.21 | 83.76 | 90.98 | 22.91 | 20.58 | 89.84 | 2.74 | 0.23 | 5.10 | 1.81 | 9.88 | −4.21 %
Largest saving, ≤ 3 % high-speed torque | Telematics | 64.069 | 81.46 | 89.91 | 90.60 | 28.52 | 25.84 | 90.61 | 4.89 | 0.48 | 4.05 | 1.72 | 11.13 | −4.34 %
| WMTC Class 1 | 63.010 | 76.21 | 83.60 | 91.16 | 22.91 | 20.59 | 89.89 | 3.59 | 0.22 | 4.20 | 1.69 | 9.71 | −3.95 %

Energies and losses in Wh/km at the motor (motor losses only; inverter, battery and vehicle are the same for every design).

Motor losses over the telematics cycle by type.

Motor losses over the telematics cycle by type.

Where the range is lost: extra loss against copper over the telematics cycle, by motor spe

Where the range is lost: extra loss against copper over the telematics cycle, by motor speed band, motoring (left) and regenerating (right).

### Cost

Design | Winding (kg) | Wire (INR) | Laminations (kg) | Laminations (INR) | Magnets (kg) | Magnets (INR) | Total (INR) | Saving, Al ₹370 | Saving, Al ₹230 | Saving, Al ₹450
Copper | 1.488 | 1719 | 5.087 | 1526 | 1.380 | 1104 | 4349 | – | – | –
Least range loss | 0.667 | 259 | 7.389 | 2217 | 2.027 | 1622 | 4097 | 252 | 350 | 196
Largest saving, full torque | 0.702 | 273 | 7.185 | 2156 | 2.027 | 1622 | 4050 | 299 | 402 | 240
Largest saving, ≤ 3 % high-speed torque | 0.638 | 248 | 5.962 | 1789 | 1.682 | 1346 | 3382 | 967 | 1061 | 914

Design9795 · aluminium winding · conventional winding, fill ≤ 0.40

## OD 165 mm

Five extra millimetres deepen the slot by 2.5 mm with the copper yoke and tooth (slot ×1.198), up to ×1.346 with a 1 mm thinner yoke and tooth. 570 designs evaluated at this OD; 11 keep full torque at every speed, 156 stay within 3 %.

### Stator variants at OD 165

Stator | OD | Slot depth | Tooth | Yoke | Slot area (mm²) | vs copper | Max torque (N·m)* | vs copper | Tooth B 99 % (T) | Yoke B 99 % (T) | Stator steel (kg)*
D0 | 160 | 17.65 | 15.54 | 8.85 | 281.2 | ×1.000 | 50.62 | +0.0 % | 2.28 | 1.70 | 3.635
B1 | 165 | 20.15 | 15.54 | 8.85 | 336.9 | ×1.198 | 50.41 | −0.4 % | 2.28 | 1.70 | 3.923
B2 | 165 | 21.15 | 15.54 | 7.85 | 360.1 | ×1.281 | 49.68 | −1.9 % | 2.28 | 1.78 | 3.791
B3 | 165 | 21.15 | 14.54 | 7.85 | 378.6 | ×1.346 | 48.81 | −3.6 % | 2.26 | 1.76 | 3.685
B4 | 165 | 22.15 | 15.54 | 6.85 | 383.8 | ×1.365 | 48.03 | −5.1 % | 2.25 | 1.83 | 3.655
B5 | 165 | 22.15 | 14.54 | 6.85 | 403.3 | ×1.434 | 47.37 | −6.4 % | 2.24 | 1.82 | 3.544

* FEMM 2D, 64 mm stack, 10 turns per coil, peak over the 4 × 4 current grid at 360 A (no skew). Dimensions in mm.

Slot outlines of the OD 165 stators against the copper stator (D0). Tooth tip and slot ope

Slot outlines of the OD 165 stators against the copper stator (D0). Tooth tip and slot opening are unchanged in every variant.

### Cost against range

All designs at OD 165. Dark: full torque at every speed; light blue: within 3 %; grey: nei

All designs at OD 165. Dark: full torque at every speed; light blue: within 3 %; grey: neither. Line: best designs (full). Circles: designs detailed below.

#### Best designs, full torque at every speed

Design | Stator | Yoke (mm) | Stack (mm) | Turns × (strands × d) | Worst envelope | Range, telematics | Range, WMTC | Saving (INR) | Winding loss at peak (W) | Mass change (kg)
B3 L92 N7 1x3.55 | B3 | 7.85 | 92 | 7 × (1 × 3.55) | 99.1 % | −3.57 % | −3.87 % | 278 | 1063 | +2.11
B4 L92 N7 4x1.80 | B4 | 6.85 | 92 | 7 × (4 × 1.80) | 99.0 % | −3.65 % | −3.98 % | 281 | 1040 | +2.09

#### Best designs, up to 3 % torque shortfall at high speed

Design | Stator | Yoke (mm) | Stack (mm) | Turns × (strands × d) | Worst envelope | Range, telematics | Range, WMTC | Saving (INR) | Winding loss at peak (W) | Mass change (kg)
B1 L78 N8 2x2.24 | B1 | 8.85 | 78 | 8 × (2 × 2.24) | 97.2 % | −3.31 % | −3.50 % | 816 | 1385 | +0.85
B1 L78 N8 1x3.15 | B1 | 8.85 | 78 | 8 × (1 × 3.15) | 97.1 % | −3.37 % | −3.55 % | 818 | 1401 | +0.84
B3 L76 N9 2x2.24 | B3 | 7.85 | 76 | 9 × (2 × 2.24) | 97.3 % | −3.93 % | −3.60 % | 961 | 1532 | +0.42
B5 L76 N9 1x3.25 | B5 | 6.85 | 76 | 9 × (1 × 3.25) | 97.2 % | −3.99 % | −3.84 % | 998 | 1462 | +0.29

At the copper stack of 64 mm, no design at this OD meets either criterion: aluminium at 64 mm loses torque either at low speed (fewer turns, 360 A limit) or above 2500 rpm (10 turns, higher resistance).

### Effect of stack length and turns

Best design (range) at each stack length and turn count at OD 165, among those within 3 %

Best design (range) at each stack length and turn count at OD 165, among those within 3 % of copper torque; filled dots also meet the full criterion. Fewer turns need a longer stack for the same torque at 360 A.

### Designs in detail

| Copper (today) | Least range loss | Largest saving, full torque | Largest saving, ≤ 3 % high-speed torque
Design | Cu SWG 11 | B3 L92 N7 1x3.55 | B4 L92 N7 4x1.80 | B5 L76 N9 1x3.25
Stator OD (mm) | 160 | 165 | 165 | 165
Stator variant | D0 | B3 | B4 | B5
Stack length, stator = rotor = magnets (mm) | 64 | 92 | 92 | 76
Slot depth (mm) | 17.65 | 21.15 | 22.15 | 22.15
Tooth width (mm) | 15.54 | 14.54 | 15.54 | 14.54
Yoke (mm) | 8.85 | 7.85 | 6.85 | 6.85
Slot area (mm²) | 281.2 (×1.000) | 378.6 (×1.346) | 383.8 (×1.365) | 403.3 (×1.434)
Turns per coil | 10 | 7 | 7 | 9
Strands × bare diameter (mm) | 1 × 2.95 | 1 × 3.55 | 4 × 1.80 | 1 × 3.25
Conductor area (mm²) | 6.82 | 9.90 | 10.18 | 8.30
Insulated fill | 0.513 | 0.385 | 0.399 | 0.391
Mean turn length (mm) | 203.6 | 308.3 | 309.8 | 277.0
Resistance per path, 100 °C (mΩ) | 13.48 | 16.30 | 15.93 | 22.44
Peak torque, 1000 rpm (N·m) | 44.11 | 44.68 | 44.36 | 45.26
Worst envelope ratio vs copper | – | 99.1 % | 99.0 % | 97.2 %
Winding loss at peak torque (W) | 885 | 1063 | 1040 | 1462
Current density at peak (A/mm² rms) | 15.2 | 10.5 | 10.2 | 12.5
Peak efficiency (%) | 95.36 | 94.44 | 94.39 | 94.19
Map efficiency, mean change (points) | – | −2.28 | −2.30 | −2.94
Telematics: Wh/km at motor terminals | 61.291 | 63.562 | 63.615 | 63.836
Range change, telematics | – | −3.57 % | −3.65 % | −3.99 %
Range change, WMTC Class 1 | – | −3.87 % | −3.98 % | −3.84 %
Winding mass (kg) | 1.488 | 0.693 | 0.716 | 0.671
Stator laminations (kg) | 3.635 | 5.297 | 5.254 | 4.208
Rotor laminations + magnets (kg) | 2.832 | 4.071 | 4.071 | 3.363
Active mass (kg) | 7.955 | 10.061 | 10.041 | 8.242
Material cost (INR) | 4349 | 4072 | 4068 | 3352
Saving vs copper (INR) | – | 278 (6.4 %) | 281 (6.5 %) | 998 (22.9 %)

### Torque-speed envelope

Maximum shaft torque at each speed against copper, same drive limits. Right: ratio to copp

Maximum shaft torque at each speed against copper, same drive limits. Right: ratio to copper; dotted lines 99 % and 97 %.

### Efficiency maps against copper

Efficiency change against copper at the same speed and shaft torque (blue = aluminium bett

Efficiency change against copper at the same speed and shaft torque (blue = aluminium better). Triangles: OP1–OP3.

Efficiency map of B5 L76 N9 1x3.25.

Efficiency map of B5 L76 N9 1x3.25.

### Operating points OP1, OP2, OP3

Efficiency change vs copper (points) | Least range loss | Largest saving, full torque | Largest saving, ≤ 3 % high-speed torque
OP1: 9000 rpm, maximum power | +0.18 | +0.03 | −0.77
OP2: 9339 rpm, 3.24 N·m | −5.11 | −5.33 | −3.45
OP3: 2000 rpm, maximum torque | −1.52 | −1.42 | −4.52

Loss breakdown at the operating points; label = total loss and efficiency.

Loss breakdown at the operating points; label = total loss and efficiency.

OP1 · 9000 rpm, maximum power | Motor-CAD, copper | Copper (FEMM) | Least range loss | Largest saving, full torque | Largest saving, ≤ 3 % high-speed torque
Shaft torque (N·m) | 13.98 | 14.05 | 14.07 | 14.04 | 13.90
Electromagnetic torque (N·m) | 14.46 | 14.50 | 14.61 | 14.58 | 14.42
Shaft power (W) | 13178 | 13239 | 13261 | 13229 | 13098
Input power (W) | 14560 | 14552 | 14548 | 14536 | 14521
Efficiency (%) | 90.51 | 90.97 | 91.16 | 91.01 | 90.20
Line current (A rms) | 247.2 | 236.3 | 246.7 | 244.5 | 236.2
Phase current (A rms, delta) | 142.7 | 136.4 | 142.5 | 141.2 | 136.4
Id, phase (A peak) | −184.2 | −173.3 | −181.6 | −180.2 | −175.2
Iq, phase (A peak) | 82.5 | 84.7 | 87.3 | 85.9 | 80.8
Phase advance (° el) | 65.9 | 63.9 | 64.3 | 64.5 | 65.2
Phase voltage (V peak, limit 49.4) | 49.40 | 49.38 | 49.07 | 49.29 | 49.13
Power factor | 0.974 | 0.983 | 0.962 | 0.963 | 1.000
ψd (mV·s) | 1.72 | 2.68 | 6.76 | 6.73 | 3.98
ψq (mV·s) | 9.69 | 9.85 | 7.48 | 7.58 | 9.14
DC bus current (A) | 280.0 | 279.9 | 279.8 | 279.5 | 279.2
Current density (A/mm² rms) | – | 10.0 | 7.2 | 6.9 | 8.2
Active limit | – | voltage, DC current | DC current | voltage, DC current | voltage
DC winding loss (W) | 411.7 | 376.2 | 496.1 | 476.0 | 626.4
AC winding loss (W) | 526.5 | 505.5 | 283.2 | 319.9 | 307.5
Stator hysteresis (W) | – | 71.6 | 96.1 | 97.9 | 90.2
Stator eddy (W) | – | 125.7 | 168.6 | 172.2 | 158.5
Stator iron total (W) | 205.3 | 197.4 | 264.7 | 270.1 | 248.6
Rotor iron (W) | 89.4 | 85.7 | 74.3 | 73.0 | 83.4
Iron total (W) | 294.7 | 283.1 | 339.0 | 343.1 | 332.1
Bearings + windage (W) | 148.9 | 148.9 | 168.4 | 168.4 | 157.2
Total loss (W) | 1381.8 | 1313.6 | 1286.6 | 1307.4 | 1423.1

OP2 · 9339 rpm, 3.24 N·m | Copper (FEMM) | Least range loss | Largest saving, full torque | Largest saving, ≤ 3 % high-speed torque
Shaft torque (N·m) | 3.27 | 3.29 | 3.29 | 3.24
Electromagnetic torque (N·m) | 3.62 | 3.78 | 3.78 | 3.67
Shaft power (W) | 3195 | 3218 | 3218 | 3173
Input power (W) | 3785 | 4059 | 4069 | 3920
Efficiency (%) | 84.41 | 79.29 | 79.08 | 80.95
Line current (A rms) | 120.7 | 165.8 | 164.2 | 138.0
Phase current (A rms, delta) | 69.7 | 95.7 | 94.8 | 79.7
Id, phase (A peak) | −96.2 | −133.4 | −132.2 | −110.7
Iq, phase (A peak) | 21.8 | 22.9 | 22.7 | 20.9
Phase advance (° el) | 77.2 | 80.2 | 80.2 | 79.3
Phase voltage (V peak, limit 49.4) | 49.22 | 49.23 | 49.28 | 49.30
Power factor | 0.499 | 0.392 | 0.394 | 0.456
ψd (mV·s) | 9.59 | 9.76 | 9.76 | 9.62
ψq (mV·s) | 2.84 | 2.10 | 2.13 | 2.60
DC bus current (A) | 72.8 | 78.1 | 78.2 | 75.4
Current density (A/mm² rms) | 5.1 | 4.8 | 4.7 | 4.8
Active limit | voltage | voltage | voltage | voltage
DC winding loss (W) | 98.3 | 223.8 | 214.8 | 213.7
AC winding loss (W) | 150.4 | 141.5 | 160.1 | 117.4
Stator hysteresis (W) | 54.2 | 90.8 | 91.2 | 75.2
Stator eddy (W) | 99.6 | 163.5 | 164.4 | 137.3
Stator iron total (W) | 153.8 | 254.3 | 255.6 | 212.6
Rotor iron (W) | 31.6 | 44.1 | 43.9 | 37.9
Iron total (W) | 185.4 | 298.4 | 299.5 | 250.4
Bearings + windage (W) | 156.2 | 176.7 | 176.7 | 165.0
Total loss (W) | 590.2 | 840.4 | 851.2 | 746.5

OP3 · 2000 rpm, maximum torque | Motor-CAD, copper | Copper (FEMM) | Least range loss | Largest saving, full torque | Largest saving, ≤ 3 % high-speed torque
Shaft torque (N·m) | 44.11 | 44.06 | 44.58 | 44.26 | 45.17
Electromagnetic torque (N·m) | 44.76 | 44.67 | 45.35 | 45.05 | 45.92
Shaft power (W) | 9239 | 9227 | 9336 | 9270 | 9460
Input power (W) | 10306 | 10284 | 10584 | 10498 | 11103
Efficiency (%) | 89.65 | 89.73 | 88.21 | 88.31 | 85.20
Line current (A rms) | 360.0 | 360.0 | 360.0 | 360.0 | 360.0
Phase current (A rms, delta) | 207.8 | 207.8 | 207.8 | 207.8 | 207.8
Id, phase (A peak) | −85.0 | −90.8 | −77.0 | −84.4 | −99.0
Iq, phase (A peak) | 281.4 | 279.6 | 283.7 | 281.6 | 276.8
Phase advance (° el) | 16.8 | 18.0 | 15.2 | 16.7 | 19.7
Phase voltage (V peak, limit 49.4) | 34.36 | 33.85 | 30.24 | 29.90 | 33.76
Power factor | 0.680 | 0.685 | 0.792 | 0.794 | 0.744
ψd (mV·s) | 12.48 | 12.00 | 15.23 | 14.59 | 12.35
ψq (mV·s) | 28.90 | 28.65 | 22.42 | 22.50 | 27.30
DC bus current (A) | 198.2 | 197.8 | 203.5 | 201.9 | 213.5
Current density (A/mm² rms) | – | 15.2 | 10.5 | 10.2 | 12.5
Active limit | – | 360 A | 360 A | 360 A | 360 A
DC winding loss (W) | 873.5 | 873.5 | 1055.9 | 1032.0 | 1454.4
AC winding loss (W) | 57.4 | 54.7 | 28.7 | 31.3 | 31.0
Stator hysteresis (W) | – | 61.2 | 86.4 | 87.9 | 82.6
Stator eddy (W) | – | 20.4 | 27.1 | 27.4 | 26.5
Stator iron total (W) | 87.4 | 81.5 | 113.5 | 115.3 | 109.0
Rotor iron (W) | 27.7 | 25.9 | 25.9 | 25.2 | 26.3
Iron total (W) | 115.1 | 107.4 | 139.4 | 140.5 | 135.3
Bearings + windage (W) | 21.1 | 21.1 | 23.8 | 23.8 | 22.3
Total loss (W) | 1067.1 | 1056.6 | 1247.9 | 1227.6 | 1643.0

### Drive cycle and range

Design | Cycle | Net Wh/km | Shaft out, motoring | Electrical in, motoring | η motoring (%) | Shaft in, regen | Electrical out, regen | η regen (%) | DC winding loss | AC winding loss | Iron loss | Mech. loss | Total loss | Range change
Copper | Telematics | 61.291 | 81.53 | 87.83 | 92.82 | 28.55 | 26.54 | 92.97 | 2.82 | 0.84 | 3.04 | 1.61 | 8.32 | –
| WMTC Class 1 | 60.520 | 76.21 | 81.72 | 93.26 | 22.91 | 21.20 | 92.55 | 2.13 | 0.40 | 3.10 | 1.59 | 7.22 | –
Least range loss | Telematics | 63.562 | 81.61 | 89.58 | 91.11 | 28.56 | 26.01 | 91.09 | 3.50 | 0.45 | 4.73 | 1.82 | 10.51 | −3.57 %
| WMTC Class 1 | 62.955 | 76.21 | 83.59 | 91.17 | 22.91 | 20.64 | 90.07 | 2.75 | 0.23 | 4.89 | 1.80 | 9.65 | −3.87 %
Largest saving, full torque | Telematics | 63.615 | 81.58 | 89.61 | 91.04 | 28.56 | 25.99 | 91.03 | 3.43 | 0.52 | 4.83 | 1.82 | 10.59 | −3.65 %
| WMTC Class 1 | 63.029 | 76.21 | 83.65 | 91.11 | 22.91 | 20.62 | 90.00 | 2.69 | 0.26 | 4.99 | 1.80 | 9.73 | −3.98 %
Largest saving, ≤ 3 % high-speed torque | Telematics | 63.836 | 81.42 | 89.73 | 90.75 | 28.53 | 25.89 | 90.75 | 4.61 | 0.51 | 4.13 | 1.70 | 10.94 | −3.99 %
| WMTC Class 1 | 62.936 | 76.21 | 83.54 | 91.23 | 22.91 | 20.61 | 89.94 | 3.44 | 0.24 | 4.28 | 1.68 | 9.63 | −3.84 %

Energies and losses in Wh/km at the motor (motor losses only; inverter, battery and vehicle are the same for every design).

Motor losses over the telematics cycle by type.

Motor losses over the telematics cycle by type.

Where the range is lost: extra loss against copper over the telematics cycle, by motor spe

Where the range is lost: extra loss against copper over the telematics cycle, by motor speed band, motoring (left) and regenerating (right).

### Cost

Design | Winding (kg) | Wire (INR) | Laminations (kg) | Laminations (INR) | Magnets (kg) | Magnets (INR) | Total (INR) | Saving, Al ₹370 | Saving, Al ₹230 | Saving, Al ₹450
Copper | 1.488 | 1719 | 5.087 | 1526 | 1.380 | 1104 | 4349 | – | – | –
Least range loss | 0.693 | 269 | 7.384 | 2215 | 1.984 | 1587 | 4072 | 278 | 379 | 219
Largest saving, full torque | 0.716 | 278 | 7.341 | 2202 | 1.984 | 1587 | 4068 | 281 | 387 | 221
Largest saving, ≤ 3 % high-speed torque | 0.671 | 261 | 5.932 | 1780 | 1.639 | 1311 | 3352 | 998 | 1096 | 941

Design9795 · aluminium winding · conventional winding, fill ≤ 0.40

## OD 167 mm

With the copper yoke and tooth the slot is 3.5 mm deeper (×1.281); with a 2 mm thinner yoke 5.5 mm deeper (×1.451), with 1 mm thinner teeth as well ×1.524. 551 designs evaluated at this OD; 19 keep full torque at every speed, 159 stay within 3 %.

### Stator variants at OD 167

Stator | OD | Slot depth | Tooth | Yoke | Slot area (mm²) | vs copper | Max torque (N·m)* | vs copper | Tooth B 99 % (T) | Yoke B 99 % (T) | Stator steel (kg)*
D0 | 160 | 17.65 | 15.54 | 8.85 | 281.2 | ×1.000 | 50.62 | +0.0 % | 2.28 | 1.70 | 3.635
F1 | 167 | 21.15 | 15.54 | 8.85 | 360.2 | ×1.281 | 50.31 | −0.6 % | 2.28 | 1.70 | 4.038
F2 | 167 | 22.15 | 15.54 | 7.85 | 383.8 | ×1.365 | 49.58 | −2.1 % | 2.27 | 1.78 | 3.903
F3 | 167 | 22.15 | 14.54 | 7.85 | 403.3 | ×1.434 | 48.67 | −3.9 % | 2.26 | 1.76 | 3.792
F4 | 167 | 23.15 | 14.54 | 6.85 | 428.6 | ×1.524 | 47.25 | −6.6 % | 2.24 | 1.82 | 3.647
F5 | 167 | 23.15 | 15.54 | 6.85 | 408.1 | ×1.451 | 47.86 | −5.4 % | 2.25 | 1.83 | 3.764

* FEMM 2D, 64 mm stack, 10 turns per coil, peak over the 4 × 4 current grid at 360 A (no skew). Dimensions in mm.

Slot outlines of the OD 167 stators against the copper stator (D0). Tooth tip and slot ope

Slot outlines of the OD 167 stators against the copper stator (D0). Tooth tip and slot opening are unchanged in every variant.

### Cost against range

All designs at OD 167. Dark: full torque at every speed; light blue: within 3 %; grey: nei

All designs at OD 167. Dark: full torque at every speed; light blue: within 3 %; grey: neither. Line: best designs (full). Circles: designs detailed below.

#### Best designs, full torque at every speed

Design | Stator | Yoke (mm) | Stack (mm) | Turns × (strands × d) | Worst envelope | Range, telematics | Range, WMTC | Saving (INR) | Winding loss at peak (W) | Mass change (kg)
F2 L90 N7 4x1.80 | F2 | 7.85 | 90 | 7 × (4 × 1.80) | 99.1 % | −3.32 % | −3.62 % | 263 | 1026 | +2.22

#### Best designs, up to 3 % torque shortfall at high speed

Design | Stator | Yoke (mm) | Stack (mm) | Turns × (strands × d) | Worst envelope | Range, telematics | Range, WMTC | Saving (INR) | Winding loss at peak (W) | Mass change (kg)
F1 L78 N8 4x1.63 | F1 | 8.85 | 78 | 8 × (4 × 1.63) | 97.5 % | −3.19 % | −3.41 % | 761 | 1318 | +1.02
F1 L78 N8 1x3.25 | F1 | 8.85 | 78 | 8 × (1 × 3.25) | 97.5 % | −3.20 % | −3.41 % | 761 | 1319 | +1.02
F3 L74 N9 1x3.25 | F3 | 7.85 | 74 | 9 × (1 × 3.25) | 97.2 % | −3.64 % | −3.55 % | 997 | 1438 | +0.36
F4 L74 N9 1x3.35 | F4 | 6.85 | 74 | 9 × (1 × 3.35) | 97.2 % | −3.65 % | −3.75 % | 1030 | 1361 | +0.24

At the copper stack of 64 mm, no design at this OD meets either criterion: aluminium at 64 mm loses torque either at low speed (fewer turns, 360 A limit) or above 2500 rpm (10 turns, higher resistance).

### Effect of stack length and turns

Best design (range) at each stack length and turn count at OD 167, among those within 3 %

Best design (range) at each stack length and turn count at OD 167, among those within 3 % of copper torque; filled dots also meet the full criterion. Fewer turns need a longer stack for the same torque at 360 A.

### Designs in detail

| Copper (today) | Largest saving, full torque / least range loss | Largest saving, ≤ 3 % high-speed torque
Design | Cu SWG 11 | F2 L90 N7 4x1.80 | F4 L74 N9 1x3.35
Stator OD (mm) | 160 | 167 | 167
Stator variant | D0 | F2 | F4
Stack length, stator = rotor = magnets (mm) | 64 | 90 | 74
Slot depth (mm) | 17.65 | 22.15 | 23.15
Tooth width (mm) | 15.54 | 15.54 | 14.54
Yoke (mm) | 8.85 | 7.85 | 6.85
Slot area (mm²) | 281.2 (×1.000) | 383.8 (×1.365) | 428.6 (×1.524)
Turns per coil | 10 | 7 | 9
Strands × bare diameter (mm) | 1 × 2.95 | 4 × 1.80 | 1 × 3.35
Conductor area (mm²) | 6.82 | 10.18 | 8.81
Insulated fill | 0.513 | 0.399 | 0.390
Mean turn length (mm) | 203.6 | 305.8 | 273.7
Resistance per path, 100 °C (mΩ) | 13.48 | 15.72 | 20.89
Peak torque, 1000 rpm (N·m) | 44.11 | 44.27 | 43.94
Worst envelope ratio vs copper | – | 99.1 % | 97.2 %
Winding loss at peak torque (W) | 885 | 1026 | 1361
Current density at peak (A/mm² rms) | 15.2 | 10.2 | 11.8
Peak efficiency (%) | 95.36 | 94.46 | 94.20
Map efficiency, mean change (points) | – | −2.13 | −2.84
Telematics: Wh/km at motor terminals | 61.291 | 63.394 | 63.610
Range change, telematics | – | −3.32 % | −3.65 %
Range change, WMTC Class 1 | – | −3.62 % | −3.75 %
Winding mass (kg) | 1.488 | 0.707 | 0.704
Stator laminations (kg) | 3.635 | 5.488 | 4.217
Rotor laminations + magnets (kg) | 2.832 | 3.982 | 3.274
Active mass (kg) | 7.955 | 10.177 | 8.196
Material cost (INR) | 4349 | 4086 | 3319
Saving vs copper (INR) | – | 263 (6.0 %) | 1030 (23.7 %)

### Torque-speed envelope

Maximum shaft torque at each speed against copper, same drive limits. Right: ratio to copp

Maximum shaft torque at each speed against copper, same drive limits. Right: ratio to copper; dotted lines 99 % and 97 %.

### Efficiency maps against copper

Efficiency change against copper at the same speed and shaft torque (blue = aluminium bett

Efficiency change against copper at the same speed and shaft torque (blue = aluminium better). Triangles: OP1–OP3.

Efficiency map of F4 L74 N9 1x3.35.

Efficiency map of F4 L74 N9 1x3.35.

### Operating points OP1, OP2, OP3

Efficiency change vs copper (points) | Largest saving, full torque / least range loss | Largest saving, ≤ 3 % high-speed torque
OP1: 9000 rpm, maximum power | +0.25 | −0.57
OP2: 9339 rpm, 3.24 N·m | −4.72 | −2.73
OP3: 2000 rpm, maximum torque | −1.32 | −4.11

Loss breakdown at the operating points; label = total loss and efficiency.

Loss breakdown at the operating points; label = total loss and efficiency.

OP1 · 9000 rpm, maximum power | Motor-CAD, copper | Copper (FEMM) | Largest saving, full torque / least range loss | Largest saving, ≤ 3 % high-speed torque
Shaft torque (N·m) | 13.98 | 14.05 | 14.08 | 13.96
Electromagnetic torque (N·m) | 14.46 | 14.50 | 14.61 | 14.49
Shaft power (W) | 13178 | 13239 | 13273 | 13161
Input power (W) | 14560 | 14552 | 14550 | 14559
Efficiency (%) | 90.51 | 90.97 | 91.22 | 90.40
Line current (A rms) | 247.2 | 236.3 | 243.8 | 235.5
Phase current (A rms, delta) | 142.7 | 136.4 | 140.7 | 136.0
Id, phase (A peak) | −184.2 | −173.3 | −178.5 | −173.3
Iq, phase (A peak) | 82.5 | 84.7 | 88.0 | 83.3
Phase advance (° el) | 65.9 | 63.9 | 63.8 | 64.3
Phase voltage (V peak, limit 49.4) | 49.40 | 49.38 | 49.31 | 49.39
Power factor | 0.974 | 0.983 | 0.967 | 0.999
ψd (mV·s) | 1.72 | 2.68 | 6.71 | 3.96
ψq (mV·s) | 9.69 | 9.85 | 7.61 | 9.24
DC bus current (A) | 280.0 | 279.9 | 279.8 | 280.0
Current density (A/mm² rms) | – | 10.0 | 6.9 | 7.7
Active limit | – | voltage, DC current | voltage, DC current | voltage, DC current
DC winding loss (W) | 411.7 | 376.2 | 467.0 | 579.1
AC winding loss (W) | 526.5 | 505.5 | 311.2 | 327.0
Stator hysteresis (W) | – | 71.6 | 94.4 | 92.4
Stator eddy (W) | – | 125.7 | 165.6 | 161.1
Stator iron total (W) | 205.3 | 197.4 | 260.0 | 253.6
Rotor iron (W) | 89.4 | 85.7 | 72.2 | 82.2
Iron total (W) | 294.7 | 283.1 | 332.2 | 335.7
Bearings + windage (W) | 148.9 | 148.9 | 167.0 | 155.8
Total loss (W) | 1381.8 | 1313.6 | 1277.5 | 1397.7

OP2 · 9339 rpm, 3.24 N·m | Copper (FEMM) | Largest saving, full torque / least range loss | Largest saving, ≤ 3 % high-speed torque
Shaft torque (N·m) | 3.27 | 3.27 | 3.28
Electromagnetic torque (N·m) | 3.62 | 3.75 | 3.71
Shaft power (W) | 3195 | 3200 | 3212
Input power (W) | 3785 | 4016 | 3932
Efficiency (%) | 84.41 | 79.69 | 81.68
Line current (A rms) | 120.7 | 160.5 | 134.2
Phase current (A rms, delta) | 69.7 | 92.7 | 77.5
Id, phase (A peak) | −96.2 | −129.0 | −107.4
Iq, phase (A peak) | 21.8 | 23.0 | 21.7
Phase advance (° el) | 77.2 | 79.9 | 78.6
Phase voltage (V peak, limit 49.4) | 49.22 | 49.30 | 49.30
Power factor | 0.499 | 0.399 | 0.470
ψd (mV·s) | 9.59 | 9.77 | 9.61
ψq (mV·s) | 2.84 | 2.13 | 2.66
DC bus current (A) | 72.8 | 77.2 | 75.6
Current density (A/mm² rms) | 5.1 | 4.6 | 4.4
Active limit | voltage | voltage | voltage
DC winding loss (W) | 98.3 | 202.5 | 188.2
AC winding loss (W) | 150.4 | 149.6 | 118.8
Stator hysteresis (W) | 54.2 | 87.7 | 75.6
Stator eddy (W) | 99.6 | 158.1 | 137.9
Stator iron total (W) | 153.8 | 245.8 | 213.5
Rotor iron (W) | 31.6 | 42.6 | 36.3
Iron total (W) | 185.4 | 288.3 | 249.9
Bearings + windage (W) | 156.2 | 175.2 | 163.5
Total loss (W) | 590.2 | 815.7 | 720.4

OP3 · 2000 rpm, maximum torque | Motor-CAD, copper | Copper (FEMM) | Largest saving, full torque / least range loss | Largest saving, ≤ 3 % high-speed torque
Shaft torque (N·m) | 44.11 | 44.06 | 44.16 | 43.86
Electromagnetic torque (N·m) | 44.76 | 44.67 | 44.94 | 44.61
Shaft power (W) | 9239 | 9227 | 9250 | 9185
Input power (W) | 10306 | 10284 | 10463 | 10729
Efficiency (%) | 89.65 | 89.73 | 88.41 | 85.61
Line current (A rms) | 360.0 | 360.0 | 360.0 | 360.0
Phase current (A rms, delta) | 207.8 | 207.8 | 207.8 | 207.8
Id, phase (A peak) | −85.0 | −90.8 | −78.9 | −99.9
Iq, phase (A peak) | 281.4 | 279.6 | 283.2 | 276.4
Phase advance (° el) | 16.8 | 18.0 | 15.6 | 19.9
Phase voltage (V peak, limit 49.4) | 34.36 | 33.85 | 30.08 | 32.76
Power factor | 0.680 | 0.685 | 0.786 | 0.740
ψd (mV·s) | 12.48 | 12.00 | 14.88 | 11.88
ψq (mV·s) | 28.90 | 28.65 | 22.56 | 26.66
DC bus current (A) | 198.2 | 197.8 | 201.2 | 206.3
Current density (A/mm² rms) | – | 15.2 | 10.2 | 11.8
Active limit | – | 360 A | 360 A | 360 A
DC winding loss (W) | 873.5 | 873.5 | 1018.7 | 1353.4
AC winding loss (W) | 57.4 | 54.7 | 32.1 | 33.1
Stator hysteresis (W) | – | 61.2 | 86.5 | 82.9
Stator eddy (W) | – | 20.4 | 27.1 | 26.6
Stator iron total (W) | 87.4 | 81.5 | 113.5 | 109.4
Rotor iron (W) | 27.7 | 25.9 | 25.2 | 25.5
Iron total (W) | 115.1 | 107.4 | 138.7 | 134.9
Bearings + windage (W) | 21.1 | 21.1 | 23.6 | 22.1
Total loss (W) | 1067.1 | 1056.6 | 1213.1 | 1543.4

### Drive cycle and range

Design | Cycle | Net Wh/km | Shaft out, motoring | Electrical in, motoring | η motoring (%) | Shaft in, regen | Electrical out, regen | η regen (%) | DC winding loss | AC winding loss | Iron loss | Mech. loss | Total loss | Range change
Copper | Telematics | 61.291 | 81.53 | 87.83 | 92.82 | 28.55 | 26.54 | 92.97 | 2.82 | 0.84 | 3.04 | 1.61 | 8.32 | –
| WMTC Class 1 | 60.520 | 76.21 | 81.72 | 93.26 | 22.91 | 21.20 | 92.55 | 2.13 | 0.40 | 3.10 | 1.59 | 7.22 | –
Largest saving, full torque / least range loss | Telematics | 63.394 | 81.59 | 89.45 | 91.22 | 28.56 | 26.05 | 91.22 | 3.40 | 0.50 | 4.66 | 1.81 | 10.37 | −3.32 %
| WMTC Class 1 | 62.792 | 76.21 | 83.46 | 91.31 | 22.91 | 20.67 | 90.22 | 2.69 | 0.25 | 4.77 | 1.78 | 9.49 | −3.62 %
Largest saving, ≤ 3 % high-speed torque | Telematics | 63.610 | 81.35 | 89.53 | 90.87 | 28.53 | 25.92 | 90.84 | 4.37 | 0.54 | 4.20 | 1.69 | 10.79 | −3.65 %
| WMTC Class 1 | 62.878 | 76.21 | 83.50 | 91.28 | 22.91 | 20.62 | 89.99 | 3.32 | 0.25 | 4.34 | 1.66 | 9.58 | −3.75 %

Energies and losses in Wh/km at the motor (motor losses only; inverter, battery and vehicle are the same for every design).

Motor losses over the telematics cycle by type.

Motor losses over the telematics cycle by type.

Where the range is lost: extra loss against copper over the telematics cycle, by motor spe

Where the range is lost: extra loss against copper over the telematics cycle, by motor speed band, motoring (left) and regenerating (right).

### Cost

Design | Winding (kg) | Wire (INR) | Laminations (kg) | Laminations (INR) | Magnets (kg) | Magnets (INR) | Total (INR) | Saving, Al ₹370 | Saving, Al ₹230 | Saving, Al ₹450
Copper | 1.488 | 1719 | 5.087 | 1526 | 1.380 | 1104 | 4349 | – | – | –
Largest saving, full torque / least range loss | 0.707 | 275 | 7.530 | 2259 | 1.941 | 1553 | 4086 | 263 | 367 | 204
Largest saving, ≤ 3 % high-speed torque | 0.704 | 274 | 5.896 | 1769 | 1.596 | 1277 | 3319 | 1030 | 1134 | 971

Design9795 · aluminium winding · conventional winding, fill ≤ 0.40

## Comparison across ODs

A larger OD moves the whole cost-range front up and to the right: each mm of OD adds 0.5 mm of slot depth (about 11 mm² per slot) for about 0.06 kg (₹18) of stator steel. That is cheaper than adding stack length, which also lengthens the rotor and magnets.

Left: least range loss at each OD. Right: largest saving at each OD, overall and within 1.

Left: least range loss at each OD. Right: largest saving at each OD, overall and within 1.5 % / 2 % range loss.

OD | Criterion | Choice | Design | Range, telematics | Range, WMTC | Saving (INR) | Winding loss at peak (W) | Mass change (kg)
160 | relaxed | least range loss | A3 L90 N7 2x2.24 | −3.67 % | −3.87 % | 477 | 1302 | +1.56
160 | relaxed | largest saving | A5 L82 N8 1x3.15 | −4.09 % | −4.20 % | 888 | 1432 | +0.46
163 | full | least range loss | G3 L94 N7 3x2.00 | −3.81 % | −3.90 % | 252 | 1127 | +2.13
163 | full | largest saving | G5 L94 N7 1x3.55 | −3.97 % | −4.21 % | 299 | 1076 | +1.96
163 | relaxed | least range loss | G3 L80 N8 1x3.25 | −3.48 % | −3.70 % | 845 | 1330 | +0.67
163 | relaxed | largest saving | G5 L78 N9 1x3.15 | −4.34 % | −3.95 % | 967 | 1574 | +0.33
165 | full | least range loss | B3 L92 N7 1x3.55 | −3.57 % | −3.87 % | 278 | 1063 | +2.11
165 | full | largest saving | B4 L92 N7 4x1.80 | −3.65 % | −3.98 % | 281 | 1040 | +2.09
165 | relaxed | least range loss | B1 L78 N8 2x2.24 | −3.31 % | −3.50 % | 816 | 1385 | +0.85
165 | relaxed | largest saving | B5 L76 N9 1x3.25 | −3.99 % | −3.84 % | 998 | 1462 | +0.29
167 | full | least range loss | F2 L90 N7 4x1.80 | −3.32 % | −3.62 % | 263 | 1026 | +2.22
167 | full | largest saving | F2 L90 N7 4x1.80 | −3.32 % | −3.62 % | 263 | 1026 | +2.22
167 | relaxed | least range loss | F1 L78 N8 4x1.63 | −3.19 % | −3.41 % | 761 | 1318 | +1.02
167 | relaxed | largest saving | F4 L74 N9 1x3.35 | −3.65 % | −3.75 % | 1030 | 1361 | +0.24
170 | full | least range loss | K1 L90 N7 4x1.83 | −3.12 % | −3.38 % | 124 | 996 | +2.68
170 | full | largest saving | K6 L86 N8 3x2.12 | −3.73 % | −3.75 % | 418 | 1096 | +1.82
170 | relaxed | least range loss | K2 L80 N8 1x3.55 | −3.10 % | −3.32 % | 612 | 1132 | +1.41
170 | relaxed | largest saving | K2 L72 N9 1x3.35 | −3.31 % | −3.31 % | 972 | 1345 | +0.51

### Efficiency maps of the key designs at each OD

OD 160: efficiency change against copper.

OD 163: efficiency change against copper.

OD 165: efficiency change against copper.

OD 167: efficiency change against copper.

OD 170: efficiency change against copper.

OD 170: efficiency change against copper.

### What each lever does

Change | Gain | Cost
OD +1 mm (yoke and tooth kept) | Slot +0.5 mm deep, +11 mm²; torque per amp −0.1 % | +0.06 kg stator steel (₹18); new die and housing bore
Yoke −1 mm | Slot +1 mm deep, +22 mm² | Peak torque −1.3 % (yoke B 1.70 → 1.78 T)
Tooth −1 mm | Slot +15 mm² | Peak torque −1.9 %; tooth saturates earlier
Stack +2 mm | Torque and flux +3 %; resistance per N·m falls | +₹83 to ₹86 stator steel, rotor laminations and magnets; iron loss and windage +3 %
10 → 9 → 8 turns per coil | Lower resistance per path (−19 % / −36 %), wider wire | Needs about 11 % / 25 % longer stack for the same torque at 360 A
More strands in hand (same area) | No change in AC or DC loss (bundle effect); thinner wire bends more easily | More wire ends to strip and join at each termination

Design9795 · aluminium winding · conventional winding, fill ≤ 0.40

## Drive cycle and range

Range is computed from energy per km at the motor terminals over two speed traces: the telematics log supplied earlier and WMTC Class 1. Range change = copper Wh/km ÷ aluminium Wh/km − 1, counting motor losses only.

Top: motor speed over the two cycles (the telematics log includes long stops). Bottom: tim

Top: motor speed over the two cycles (the telematics log includes long stops). Bottom: time spent at each operating point, over the copper efficiency map (grey).

### Vehicle and method

- Vehicle (given): GVW 757 kg, CdA 1.117 m², wheel radius 0.30 m, gear ratio 13.9. Assumed: rolling resistance 0.015, gearbox efficiency 0.95, rotating-mass factor 1.05, flat road.
- Motor torque from road load and acceleration at each 1 s step; regenerative braking down to −26.4 N·m (largest regen torque in the log), friction brakes beyond.
- Telematics: 10.75 km, 6363 steps (logging gaps skipped), motor up to 6908 rpm, 18 % of steps motoring. WMTC Class 1: 7.67 km, up to 6139 rpm.
- The logged motor torque is negative even at cruise, so energy is computed from the speed trace through the vehicle model, not from the logged torque.
- Losses are read from each design's own loss map (MTPA) at the cycle's speed and torque; points above a design's torque limit are held at the limit.
- Inverter, battery and vehicle are the same for every design, so the battery-level range change is about the motor-level change.

### All key designs

Design | Cycle | Net Wh/km | Shaft out, motoring | Electrical in, motoring | η motoring (%) | Shaft in, regen | Electrical out, regen | η regen (%) | DC winding loss | AC winding loss | Iron loss | Mech. loss | Total loss | Range change
Copper | Telematics | 61.291 | 81.53 | 87.83 | 92.82 | 28.55 | 26.54 | 92.97 | 2.82 | 0.84 | 3.04 | 1.61 | 8.32 | –
| WMTC Class 1 | 60.520 | 76.21 | 81.72 | 93.26 | 22.91 | 21.20 | 92.55 | 2.13 | 0.40 | 3.10 | 1.59 | 7.22 | –
A3 L90 N7 2x2.24 | Telematics | 63.623 | 81.52 | 89.58 | 91.01 | 28.55 | 25.95 | 90.91 | 4.35 | 0.32 | 4.17 | 1.81 | 10.65 | −3.67 %
| WMTC Class 1 | 62.958 | 76.21 | 83.56 | 91.21 | 22.91 | 20.60 | 89.92 | 3.45 | 0.16 | 4.27 | 1.78 | 9.66 | −3.87 %
A5 L82 N8 1x3.15 | Telematics | 63.903 | 81.43 | 89.77 | 90.71 | 28.54 | 25.86 | 90.63 | 4.65 | 0.38 | 4.24 | 1.75 | 11.01 | −4.09 %
| WMTC Class 1 | 63.175 | 76.21 | 83.72 | 91.03 | 22.91 | 20.54 | 89.67 | 3.60 | 0.18 | 4.37 | 1.72 | 9.87 | −4.20 %
drop-in (SWG 11, 64 mm) | Telematics | 63.574 | 81.14 | 89.41 | 90.75 | 28.50 | 25.83 | 90.64 | 5.79 | 0.52 | 3.02 | 1.61 | 10.94 | −3.59 %
| WMTC Class 1 | 62.589 | 76.21 | 83.23 | 91.57 | 22.91 | 20.64 | 90.08 | 4.37 | 0.24 | 3.08 | 1.59 | 9.29 | −3.31 %
G3 L94 N7 3x2.00 | Telematics | 63.721 | 81.67 | 89.72 | 91.03 | 28.55 | 26.00 | 91.04 | 3.68 | 0.44 | 4.65 | 1.84 | 10.60 | −3.81 %
| WMTC Class 1 | 62.975 | 76.21 | 83.60 | 91.16 | 22.91 | 20.63 | 90.04 | 2.84 | 0.22 | 4.80 | 1.81 | 9.67 | −3.90 %
G5 L78 N9 1x3.15 | Telematics | 64.069 | 81.46 | 89.91 | 90.60 | 28.52 | 25.84 | 90.61 | 4.89 | 0.48 | 4.05 | 1.72 | 11.13 | −4.34 %
| WMTC Class 1 | 63.010 | 76.21 | 83.60 | 91.16 | 22.91 | 20.59 | 89.89 | 3.59 | 0.22 | 4.20 | 1.69 | 9.71 | −3.95 %
G5 L94 N7 1x3.55 | Telematics | 63.823 | 81.62 | 89.78 | 90.91 | 28.56 | 25.96 | 90.90 | 3.53 | 0.46 | 4.93 | 1.84 | 10.76 | −3.97 %
| WMTC Class 1 | 63.181 | 76.21 | 83.76 | 90.98 | 22.91 | 20.58 | 89.84 | 2.74 | 0.23 | 5.10 | 1.81 | 9.88 | −4.21 %
B3 L92 N7 1x3.55 | Telematics | 63.562 | 81.61 | 89.58 | 91.11 | 28.56 | 26.01 | 91.09 | 3.50 | 0.45 | 4.73 | 1.82 | 10.51 | −3.57 %
| WMTC Class 1 | 62.955 | 76.21 | 83.59 | 91.17 | 22.91 | 20.64 | 90.07 | 2.75 | 0.23 | 4.89 | 1.80 | 9.65 | −3.87 %
B4 L92 N7 4x1.80 | Telematics | 63.615 | 81.58 | 89.61 | 91.04 | 28.56 | 25.99 | 91.03 | 3.43 | 0.52 | 4.83 | 1.82 | 10.59 | −3.65 %
| WMTC Class 1 | 63.029 | 76.21 | 83.65 | 91.11 | 22.91 | 20.62 | 90.00 | 2.69 | 0.26 | 4.99 | 1.80 | 9.73 | −3.98 %
B5 L76 N9 1x3.25 | Telematics | 63.836 | 81.42 | 89.73 | 90.75 | 28.53 | 25.89 | 90.75 | 4.61 | 0.51 | 4.13 | 1.70 | 10.94 | −3.99 %
| WMTC Class 1 | 62.936 | 76.21 | 83.54 | 91.23 | 22.91 | 20.61 | 89.94 | 3.44 | 0.24 | 4.28 | 1.68 | 9.63 | −3.84 %
F2 L90 N7 4x1.80 | Telematics | 63.394 | 81.59 | 89.45 | 91.22 | 28.56 | 26.05 | 91.22 | 3.40 | 0.50 | 4.66 | 1.81 | 10.37 | −3.32 %
| WMTC Class 1 | 62.792 | 76.21 | 83.46 | 91.31 | 22.91 | 20.67 | 90.22 | 2.69 | 0.25 | 4.77 | 1.78 | 9.49 | −3.62 %
F4 L74 N9 1x3.35 | Telematics | 63.610 | 81.35 | 89.53 | 90.87 | 28.53 | 25.92 | 90.84 | 4.37 | 0.54 | 4.20 | 1.69 | 10.79 | −3.65 %
| WMTC Class 1 | 62.878 | 76.21 | 83.50 | 91.28 | 22.91 | 20.62 | 89.99 | 3.32 | 0.25 | 4.34 | 1.66 | 9.58 | −3.75 %
K1 L90 N7 4x1.83 | Telematics | 63.265 | 81.62 | 89.36 | 91.34 | 28.56 | 26.09 | 91.36 | 3.28 | 0.53 | 4.58 | 1.81 | 10.20 | −3.12 %
| WMTC Class 1 | 62.639 | 76.21 | 83.35 | 91.44 | 22.91 | 20.71 | 90.38 | 2.60 | 0.27 | 4.69 | 1.78 | 9.34 | −3.38 %
K2 L72 N9 1x3.35 | Telematics | 63.392 | 81.39 | 89.37 | 91.07 | 28.53 | 25.98 | 91.05 | 4.33 | 0.58 | 3.96 | 1.67 | 10.54 | −3.31 %
| WMTC Class 1 | 62.592 | 76.21 | 83.27 | 91.52 | 22.91 | 20.68 | 90.25 | 3.31 | 0.27 | 4.06 | 1.65 | 9.29 | −3.31 %
K2 L80 N8 1x3.55 | Telematics | 63.251 | 81.51 | 89.30 | 91.28 | 28.55 | 26.05 | 91.25 | 3.66 | 0.58 | 4.31 | 1.73 | 10.29 | −3.10 %
| WMTC Class 1 | 62.600 | 76.21 | 83.30 | 91.49 | 22.91 | 20.70 | 90.35 | 2.86 | 0.28 | 4.45 | 1.71 | 9.30 | −3.32 %
K6 L86 N8 3x2.12 | Telematics | 63.667 | 81.64 | 89.67 | 91.04 | 28.55 | 26.00 | 91.09 | 3.46 | 0.58 | 4.75 | 1.78 | 10.57 | −3.73 %
| WMTC Class 1 | 62.879 | 76.21 | 83.53 | 91.24 | 22.91 | 20.65 | 90.14 | 2.61 | 0.28 | 4.94 | 1.75 | 9.58 | −3.75 %

Energies and losses in Wh/km at the motor (motor losses only; inverter, battery and vehicle are the same for every design).

### Where the range goes

Motor losses over the telematics cycle by type.

Motor losses over the telematics cycle by type.

Extra loss against copper by speed band, motoring and regenerating, telematics cycle.

Extra loss against copper by speed band, motoring and regenerating, telematics cycle.

Same for WMTC Class 1.

Same for WMTC Class 1.

- The cycles run mostly at light and medium torque below 6000 rpm. There, aluminium's higher DC resistance and the longer stacks' extra iron loss outweigh its lower AC loss.
- Copper's AC winding loss over the telematics cycle is 0.84 Wh/km; aluminium's is 0.58 Wh/km (recommended, bundle effect), but its DC loss rises from 2.82 to 3.46 Wh/km and iron loss from 3.04 to 4.75 Wh/km.
- Each 1 % of range is about 0.61 Wh/km at the motor. Battery capacity was not given, so the battery cost of making up the range is not included.

Design9795 · aluminium winding · conventional winding, fill ≤ 0.40

## Cost

Active-material cost per motor, at the prices given: copper wire ₹1100/kg, ferrite magnets ₹800/kg, M235-35A laminations ₹300/kg; aluminium wire ₹370/kg (copper ÷ 3.0, from Indian enamelled-wire prices).

Design | Winding (kg) | Wire (INR) | Laminations (kg) | Laminations (INR) | Magnets (kg) | Magnets (INR) | Total (INR) | Saving, Al ₹370 | Saving, Al ₹230 | Saving, Al ₹450
Copper | 1.488 | 1719 | 5.087 | 1526 | 1.380 | 1104 | 4349 | – | – | –
A3 L90 N7 2x2.24 | 0.540 | 210 | 7.033 | 2110 | 1.941 | 1553 | 3872 | 477 | 556 | 431
A5 L82 N8 1x3.15 | 0.581 | 226 | 6.069 | 1821 | 1.768 | 1415 | 3461 | 888 | 973 | 839
drop-in (SWG 11, 64 mm) | 0.555 | 215 | 5.087 | 1526 | 1.380 | 1104 | 2846 | 1504 | 1585 | 1457
G3 L94 N7 3x2.00 | 0.667 | 259 | 7.389 | 2217 | 2.027 | 1622 | 4097 | 252 | 350 | 196
G5 L78 N9 1x3.15 | 0.638 | 248 | 5.962 | 1789 | 1.682 | 1346 | 3382 | 967 | 1061 | 914
G5 L94 N7 1x3.55 | 0.702 | 273 | 7.185 | 2156 | 2.027 | 1622 | 4050 | 299 | 402 | 240
B3 L92 N7 1x3.55 | 0.693 | 269 | 7.384 | 2215 | 1.984 | 1587 | 4072 | 278 | 379 | 219
B4 L92 N7 4x1.80 | 0.716 | 278 | 7.341 | 2202 | 1.984 | 1587 | 4068 | 281 | 387 | 221
B5 L76 N9 1x3.25 | 0.671 | 261 | 5.932 | 1780 | 1.639 | 1311 | 3352 | 998 | 1096 | 941
F2 L90 N7 4x1.80 | 0.707 | 275 | 7.530 | 2259 | 1.941 | 1553 | 4086 | 263 | 367 | 204
F4 L74 N9 1x3.35 | 0.704 | 274 | 5.896 | 1769 | 1.596 | 1277 | 3319 | 1030 | 1134 | 971
K1 L90 N7 4x1.83 | 0.731 | 284 | 7.963 | 2389 | 1.941 | 1553 | 4225 | 124 | 231 | 62
K2 L72 N9 1x3.35 | 0.697 | 271 | 6.213 | 1864 | 1.553 | 1242 | 3377 | 972 | 1075 | 914
K2 L80 N8 1x3.55 | 0.737 | 286 | 6.903 | 2071 | 1.725 | 1380 | 3737 | 612 | 720 | 550
K6 L86 N8 3x2.12 | 0.816 | 317 | 7.101 | 2130 | 1.855 | 1484 | 3931 | 418 | 538 | 349

- Aluminium wire is about 8 % of the recommended motor's material cost, so its price moves the saving by only about ±₹100 between ₹230 and ₹450/kg. The ranking of the designs does not change.
- Longer stacks add stator steel, rotor laminations and magnets: about ₹41–43 per mm of stack. A larger OD adds only stator steel, about ₹18 per mm of OD.
- Lamination cost is on net mass (stator + rotor). The larger blank of a larger OD (gross 12.77 → 19.32 kg for the recommended design) is not included, nor are the die, housing, terminations and winding process.
- Copper's active-material cost is ₹4349: wire ₹1719, laminations ₹1526, magnets ₹1104.

Design9795 · aluminium winding · conventional winding, fill ≤ 0.40

## Recommended design: changes

Stator K6 (OD 170, yoke 7.85 mm, slot 23.65 mm deep, tooth 13.54 mm), 86 mm stack, 8 turns × 3 × 2.12 mm Al: −₹418 per motor, range -3.73 % (telematics) / -3.75 % (WMTC), torque within 0.8 % of copper at every speed.

| Copper (today) | Recommended
Design | Cu SWG 11 | K6 L86 N8 3x2.12
Stator OD (mm) | 160 | 170
Stator variant | D0 | K6
Stack length, stator = rotor = magnets (mm) | 64 | 86
Slot depth (mm) | 17.65 | 23.65
Tooth width (mm) | 15.54 | 13.54
Yoke (mm) | 8.85 | 7.85
Slot area (mm²) | 281.2 (×1.000) | 462.1 (×1.643)
Turns per coil | 10 | 8
Strands × bare diameter (mm) | 1 × 2.95 | 3 × 2.12
Conductor area (mm²) | 6.82 | 10.59
Insulated fill | 0.513 | 0.392
Mean turn length (mm) | 203.6 | 297.1
Resistance per path, 100 °C (mΩ) | 13.48 | 16.78
Peak torque, 1000 rpm (N·m) | 44.11 | 46.04
Worst envelope ratio vs copper | – | 99.2 %
Winding loss at peak torque (W) | 885 | 1096
Current density at peak (A/mm² rms) | 15.2 | 9.8
Peak efficiency (%) | 95.36 | 94.44
Map efficiency, mean change (points) | – | −2.10
Telematics: Wh/km at motor terminals | 61.291 | 63.667
Range change, telematics | – | −3.73 %
Range change, WMTC Class 1 | – | −3.75 %
Winding mass (kg) | 1.488 | 0.816
Stator laminations (kg) | 3.635 | 5.151
Rotor laminations + magnets (kg) | 2.832 | 3.805
Active mass (kg) | 7.955 | 9.772
Material cost (INR) | 4349 | 3931
Saving vs copper (INR) | – | 418 (9.6 %)

Stator lamination

OD 160 → 170 mm. Slot depth 17.65 → 23.65 mm (slot bottom radius 71.15 → 77.15 mm). Yoke 8.85 → 7.85 mm. Tooth 15.54 → 13.54 mm. Unchanged: bore 107 mm, 12 slots, tooth tip, slot opening, slot-bottom corner radius, M235-35A 0.35 mm. Slot area 281.2 → 462.1 mm². New lamination die and housing bore.

Stack length

64 → 86 mm for stator, rotor laminations and magnets (same cross-sections). Shaft, bearing span and housing +22 mm.

Winding

Aluminium EC-1350, grade-2 enamel, 3 strands in hand × 2.12 mm (about 2.19 mm over enamel), 8 turns per coil, delta, 2 parallel paths, one coil per tooth, needle- or flyer-wound with continuous inter-coil connections (no busbar). Insulated wire fill 0.392 (limit 0.40; copper busbar winding 0.513). Mean turn 297.1 mm; 16.78 mΩ per path at 100 °C (copper 13.48).

Terminations

Only the phase-path ends are joined: 3 strands per end, ultrasonic or laser welded to an aluminium lead or a friction-welded Al-Cu terminal (no soldering), sealed against galvanic corrosion.

Drive

Same limits. New flux and resistance tables in the controller (flux and torque per amp ×1.075 against copper: stack × turns); aluminium temperature coefficient 0.00403/K.

Thermal (to check)

Winding loss at peak torque 885 → 1096 W (+24 %), current density 15.2 → 9.8 A/mm². Check the peak duration in Motor-CAD Thermal. Alternative: Stator K2 (OD 170, yoke 7.85 mm, slot 23.65 mm deep, tooth 15.54 mm), 80 mm stack, 8 turns × 1 × 3.55 mm Al, winding loss at peak +28 %, worst-speed torque 98.5 % of copper, ₹194 more saving, range +0.63 % against the recommended design.

Design9795 · aluminium winding · conventional winding, fill ≤ 0.40

## FEMM stator variants

28 stators, each solved at 4 × 4 d-q currents over the 360 A circle and 2 rotor positions (half model, magnets 100 °C, FEA fill 1.0, as the copper model). Variants change only the slot depth, tooth width and OD; the tooth tip, slot opening, bore, rotor and air gap stay as Design9795_1.

Stator | OD | Slot depth | Tooth | Yoke | Slot area (mm²) | vs copper | Max torque (N·m)* | vs copper | Tooth B 99 % (T) | Yoke B 99 % (T) | Stator steel (kg)*
D0 | 160 | 17.65 | 15.54 | 8.85 | 281.2 | ×1.000 | 50.62 | +0.0 % | 2.28 | 1.70 | 3.635
A1 | 160 | 18.65 | 15.54 | 7.85 | 303.1 | ×1.078 | 49.97 | −1.3 % | 2.28 | 1.78 | 3.510
A2 | 160 | 19.65 | 15.54 | 6.85 | 325.5 | ×1.157 | 48.38 | −4.4 % | 2.25 | 1.83 | 3.382
A3 | 160 | 17.65 | 14.54 | 8.85 | 296.2 | ×1.053 | 49.68 | −1.9 % | 2.27 | 1.66 | 3.550
A4 | 160 | 18.65 | 14.54 | 7.85 | 319.0 | ×1.135 | 49.16 | −2.9 % | 2.26 | 1.76 | 3.419
A5 | 160 | 19.65 | 14.54 | 6.85 | 342.5 | ×1.218 | 47.74 | −5.7 % | 2.24 | 1.82 | 3.285
A6 | 160 | 18.65 | 13.54 | 7.85 | 334.7 | ×1.190 | 48.06 | −5.0 % | 2.26 | 1.74 | 3.330
G1 | 163 | 19.15 | 15.54 | 8.85 | 314.3 | ×1.118 | 50.48 | −0.3 % | 2.29 | 1.71 | 3.808
G2 | 163 | 20.15 | 15.54 | 7.85 | 336.9 | ×1.198 | 49.80 | −1.6 % | 2.27 | 1.78 | 3.679
G3 | 163 | 20.15 | 14.54 | 7.85 | 354.4 | ×1.260 | 48.96 | −3.3 % | 2.26 | 1.76 | 3.579
B1 | 165 | 20.15 | 15.54 | 8.85 | 336.9 | ×1.198 | 50.41 | −0.4 % | 2.28 | 1.70 | 3.923
B2 | 165 | 21.15 | 15.54 | 7.85 | 360.1 | ×1.281 | 49.68 | −1.9 % | 2.28 | 1.78 | 3.791
B3 | 165 | 21.15 | 14.54 | 7.85 | 378.6 | ×1.346 | 48.81 | −3.6 % | 2.26 | 1.76 | 3.685
F1 | 167 | 21.15 | 15.54 | 8.85 | 360.2 | ×1.281 | 50.31 | −0.6 % | 2.28 | 1.70 | 4.038
F2 | 167 | 22.15 | 15.54 | 7.85 | 383.8 | ×1.365 | 49.58 | −2.1 % | 2.27 | 1.78 | 3.903
F3 | 167 | 22.15 | 14.54 | 7.85 | 403.3 | ×1.434 | 48.67 | −3.9 % | 2.26 | 1.76 | 3.792
F4 | 167 | 23.15 | 14.54 | 6.85 | 428.6 | ×1.524 | 47.25 | −6.6 % | 2.24 | 1.82 | 3.647
G4 | 163 | 21.15 | 15.54 | 6.85 | 360.1 | ×1.281 | 48.17 | −4.8 % | 2.25 | 1.83 | 3.546
G5 | 163 | 21.15 | 14.54 | 6.85 | 378.6 | ×1.346 | 47.52 | −6.1 % | 2.24 | 1.82 | 3.441
B4 | 165 | 22.15 | 15.54 | 6.85 | 383.8 | ×1.365 | 48.03 | −5.1 % | 2.25 | 1.83 | 3.655
B5 | 165 | 22.15 | 14.54 | 6.85 | 403.3 | ×1.434 | 47.37 | −6.4 % | 2.24 | 1.82 | 3.544
F5 | 167 | 23.15 | 15.54 | 6.85 | 408.1 | ×1.451 | 47.86 | −5.4 % | 2.25 | 1.83 | 3.764
K1 | 170 | 22.65 | 15.54 | 8.85 | 395.9 | ×1.408 | 50.16 | −0.9 % | 2.28 | 1.71 | 4.211
K2 | 170 | 23.65 | 15.54 | 7.85 | 420.4 | ×1.495 | 49.36 | −2.5 % | 2.26 | 1.78 | 4.071
K3 | 170 | 24.65 | 15.54 | 6.85 | 445.5 | ×1.584 | 47.63 | −5.9 % | 2.24 | 1.83 | 3.928
K4 | 170 | 23.65 | 14.54 | 7.85 | 441.4 | ×1.570 | 48.50 | −4.2 % | 2.25 | 1.76 | 3.951
K5 | 170 | 24.65 | 14.54 | 6.85 | 467.4 | ×1.662 | 47.00 | −7.2 % | 2.23 | 1.82 | 3.803
K6 | 170 | 23.65 | 13.54 | 7.85 | 462.1 | ×1.643 | 47.27 | −6.6 % | 2.24 | 1.72 | 3.833

* FEMM 2D, 64 mm stack, 10 turns per coil, peak over the 4 × 4 current grid at 360 A (no skew). Dimensions in mm.

- Thinning the yoke by 1 mm costs about 1.3 % of peak torque (yoke B 1.70 → 1.78 T); by 2 mm, 4.4 %.
- Thinning the teeth by 1 mm costs about 1.9 %; tooth flux density is already 2.2–2.3 T at the 99th percentile at full current in every variant.
- A larger OD with the same yoke and teeth costs at most 0.6 % (deeper slot, slightly more slot leakage).

### Check of the interpolation against direct FEMM solves

Stator | id (A) | iq (A) | ψq, copper stator (mV·s) | Δψq FEMM | Δψq model | Δψd FEMM | Δψd model | Iron-loss ratio FEMM | Iron-loss ratio model
F2 | −22 | 132 | 26.91 | +0.080 | +0.064 | −0.460 | −0.454 | 1.191 | 1.192
F2 | −44 | 88 | 20.64 | +0.328 | +0.294 | −0.318 | −0.333 | 1.211 | 1.204
F2 | −15 | 44 | 12.05 | +0.220 | +0.187 | −0.099 | −0.121 | 1.200 | 1.194
F2 | −73 | 59 | 13.70 | +0.309 | +0.278 | −0.411 | −0.422 | 1.187 | 1.182
F2 | −103 | 103 | 22.21 | +0.407 | +0.396 | −0.591 | −0.589 | 1.232 | 1.232
A4 | −22 | 132 | 26.91 | −0.861 | −0.883 | −0.421 | −0.439 | 1.061 | 1.060
A4 | −44 | 88 | 20.64 | −0.492 | −0.502 | −0.180 | −0.195 | 1.082 | 1.079
A4 | −15 | 44 | 12.05 | −0.298 | −0.325 | −0.103 | −0.135 | 1.104 | 1.098
A4 | −73 | 59 | 13.70 | −0.279 | −0.281 | −0.080 | −0.083 | 1.075 | 1.077
A4 | −103 | 103 | 22.21 | −0.459 | −0.450 | −0.124 | −0.124 | 1.080 | 1.083
F4 | −22 | 132 | 26.91 | −1.315 | −1.313 | −1.100 | −1.094 | 1.219 | 1.223
F4 | −44 | 88 | 20.64 | −0.378 | −0.424 | −0.566 | −0.577 | 1.291 | 1.281
F4 | −15 | 44 | 12.05 | −0.117 | −0.223 | −0.225 | −0.322 | 1.325 | 1.305
F4 | −73 | 59 | 13.70 | +0.017 | −0.058 | −0.461 | −0.487 | 1.281 | 1.273
F4 | −103 | 103 | 22.21 | −0.302 | −0.312 | −0.695 | −0.709 | 1.305 | 1.311
K6 | −22 | 132 | 26.91 | −1.288 | −1.323 | −1.012 | −1.056 | 1.245 | 1.244
K6 | −44 | 88 | 20.64 | −0.598 | −0.629 | −0.564 | −0.593 | 1.294 | 1.286
K6 | −15 | 44 | 12.05 | −0.366 | −0.420 | −0.281 | −0.364 | 1.332 | 1.315
K6 | −73 | 59 | 13.70 | −0.259 | −0.270 | −0.477 | −0.487 | 1.264 | 1.268
K6 | −103 | 103 | 22.21 | −0.477 | −0.483 | −0.688 | −0.696 | 1.305 | 1.311
K2 | −22 | 132 | 26.91 | +0.205 | +0.190 | −0.548 | −0.541 | 1.249 | 1.251
K2 | −44 | 88 | 20.64 | +0.461 | +0.417 | −0.404 | −0.421 | 1.272 | 1.263
K2 | −15 | 44 | 12.05 | +0.285 | +0.250 | −0.128 | −0.152 | 1.254 | 1.247
K2 | −73 | 59 | 13.70 | +0.400 | +0.369 | −0.542 | −0.552 | 1.238 | 1.233
K2 | −103 | 103 | 22.21 | +0.562 | +0.551 | −0.776 | −0.774 | 1.301 | 1.301

Path currents between the grid nodes (10-turn equivalent), mean of 4 rotor positions (0, 3, 6, 9°). Δ = variant − copper stator at the same currents.

Design9795 · aluminium winding · conventional winding, fill ≤ 0.40

## Assumptions and files

### Limits of the study

- 2D FEA; end effects only through the end-turn resistance and end-winding inductance.
- Thermal behaviour not simulated; the higher winding loss at peak torque needs a Motor-CAD thermal check.
- Aluminium insulated wire fill held at or below 0.40 (conventional winding); the real fill depends on the winding process and should be measured on trial coils.
- AC loss by the low-frequency hybrid method with the bundle effect, as Motor-CAD; when the equivalent bundle diameter (√strands × d) exceeds the skin depth (about 2.6 mm hot copper, 3.3 mm aluminium at 750 Hz) it overestimates the loss, so the aluminium figures are on the safe side.
- Flux maps, demagnetisation, torque ripple and THD were not recomputed for these stator-only variants: the rotor is unchanged, and the slot opening and tooth tip are identical to copper's.
- Costs are active materials only.

### Files (folder Design9795_1)

File | Content
alu9795_femm.py / .json | FEMM stator variants (28 stators × 32 solves)
alu9795_study.py | Aluminium design model on the Motor-CAD-equivalent copper model
alu9795_search.py / .json | All 2946 designs: envelope, map, peak, drive cycles, cost
alu9795_analyse.py, alu9795_picks.json | Best designs per OD, criterion and Al price
alu9795_verify.py / .json | FEMM check of the interpolation
alu9795_ops.py / .json | OP1–OP3 details
build_alu9795_f40.py | This report (search: alu9795_search_f40.json)
