mishravipul361-blip/Ferrite-motor-design/Design9795_1/report_alu_ew1136/index.html

12-slot / 10-pole ferrite spoke

# Design9795 aluminium winding

FEMM 4.2 · Motor-CAD-equivalent model
OD 160–167 · M235-35A
Al end-winding multiplier 1.136 (Cu 0.7)
17 Oct 2026

Design9795 · aluminium winding · Al end-winding multiplier 1.136

## Summary

#### Aluminium end-winding multiplier 1.136

The copper reference is Design9795_1 as given, with Motor-CAD's armature end-winding MLT multiplier 0.7 (mean turn 203.6 mm, 13.48 mΩ per path, 6.74 mΩ phase, 4.49 mΩ line to line at 100 °C). Every aluminium winding uses a multiplier of 1.136: the end-winding part of each aluminium turn is 1.623 × longer than at 0.7. The copper-size drop-in, for example, goes from 203.6 to 250.7 mm mean turn and 27.49 mΩ per path. Everything else (fields, iron loss, prices, vehicle, criteria) is as in the 0.7 study.

Aluminium can replace the copper winding of Design9795_1 with stator-only changes (rotor cross-section, magnets, air gap and M235-35A kept), but not at equal efficiency within the 167 mm OD limit. The best balance saves ₹952 per motor (22 % of active-material cost) for 1.96 % range.

#### Recommended · OD 167 · 74 mm

−₹952

Range -1.96 % (telematics), -2.38 % (WMTC). Stator F4 (OD 167, yoke 6.85 mm, slot 23.15 mm deep, tooth 14.54 mm), 74 mm stack, 9 turns × 4 × 1.90 mm Al. Torque within 0.8 % of copper at every speed, +0.44 kg. Winding loss at peak torque +19 %.

#### Alternative, 98.8 % torque at high speed · OD 167 · 72 mm

−₹992

Range -1.86 % / -2.10 %. Stator F2 (OD 167, yoke 7.85 mm, slot 22.15 mm deep, tooth 15.54 mm), 72 mm stack, 9 turns × 5 × 1.60 mm Al. Winding loss at peak +32 %, +0.41 kg.

#### Least range loss · OD 167 · 78 mm

−₹696

Range -1.54 % / -2.01 %. Stator F1 (OD 167, yoke 8.85 mm, slot 21.15 mm deep, tooth 15.54 mm), 78 mm stack, 8 turns × 6 × 1.50 mm Al. Winding loss at peak +16 %, +1.19 kg.

### Cost against range, all designs

Every aluminium design evaluated (4285), Al wire at ₹370/kg. Lines: best designs at each O

Every aluminium design evaluated (4285), Al wire at ₹370/kg. Lines: best designs at each OD (none both cheaper and better on range). Left: torque within 1 % of copper at every speed. Right: up to 3 % short in the high-speed, DC-power-limited region.

### Best designs at each OD (full torque)

OD | Least range loss | Range | Saving (INR) | Largest saving | Range | Saving (INR)
OD 160 | A5 L82 N8 4x1.80 | −2.36 % | 819 | A5 L82 N8 5x1.60 | −2.38 % | 823
OD 163 | G3 L80 N8 4x1.83 | −1.96 % | 782 | G3 L78 N9 6x1.40 | −2.60 % | 871
OD 165 | B2 L80 N8 6x1.50 | −1.83 % | 698 | B3 L78 N9 6x1.42 | −2.61 % | 822
OD 167 | F1 L78 N8 6x1.50 | −1.54 % | 696 | F4 L74 N9 4x1.90 | −1.96 % | 952

Range parity is not reached: aluminium needs 1.64 × copper's conductor area for the same resistance (about 2.0 × with the longer end turns of the 1.136 multiplier); the largest slot that keeps the teeth and yoke from saturating gives 1.37–1.52 ×. Each OD page has the details: stator variants, all best designs, efficiency maps, OP1–OP3, drive cycle and cost.

### Key designs

| Copper (today) | Least range loss | Alternative, 98.8 % torque at high speed | Recommended | Drop-in (reference)
Design | Cu SWG 11 | F1 L78 N8 6x1.50 | F2 L72 N9 5x1.60 | F4 L74 N9 4x1.90 | drop-in (SWG 11, 64 mm)
Stator OD (mm) | 160 | 167 | 167 | 167 | 160
Stator variant | D0 | F1 | F2 | F4 | D0
Stack length, stator = rotor = magnets (mm) | 64 | 78 | 72 | 74 | 64
Slot depth (mm) | 17.65 | 21.15 | 22.15 | 23.15 | 17.65
Tooth width (mm) | 15.54 | 15.54 | 15.54 | 14.54 | 15.54
Yoke (mm) | 8.85 | 8.85 | 7.85 | 6.85 | 8.85
Slot area (mm²) | 281.2 (×1.000) | 360.2 (×1.281) | 383.8 (×1.365) | 428.6 (×1.524) | 281.2 (×1.000)
Turns per coil | 10 | 8 | 9 | 9 | 10
Strands × bare diameter (mm) | 1 × 2.95 | 6 × 1.50 | 5 × 1.60 | 4 × 1.90 | 1 × 2.95
Conductor area (mm²) | 6.82 | 10.60 | 10.05 | 11.34 | 6.82
Insulated fill | 0.513 | 0.511 | 0.510 | 0.511 | 0.513
Mean turn length (mm) | 203.6 | 281.2 | 269.8 | 273.7 | 250.7
Resistance per path, 100 °C (mΩ) | 13.48 | 15.86 | 18.06 | 16.23 | 27.49
Peak torque, 1000 rpm (N·m) | 44.11 | 43.91 | 44.44 | 43.94 | 44.11
Worst envelope ratio vs copper | – | 99.4 % | 98.8 % | 99.2 % | 95.2 %
Winding loss at peak torque (W) | 885 | 1029 | 1170 | 1055 | 1786
Current density at peak (A/mm² rms) | 15.2 | 9.8 | 10.3 | 9.2 | 15.2
Peak efficiency (%) | 95.36 | 95.05 | 94.91 | 94.90 | 94.27
Map efficiency, mean change (points) | – | −1.15 | −1.39 | −1.27 | −3.55
Telematics: Wh/km at motor terminals | 61.291 | 62.248 | 62.454 | 62.517 | 63.574
Range change, telematics | – | −1.54 % | −1.86 % | −1.96 % | −3.59 %
Range change, WMTC Class 1 | – | −2.01 % | −2.10 % | −2.38 % | −3.31 %
Winding mass (kg) | 1.488 | 0.774 | 0.792 | 0.906 | 0.555
Stator laminations (kg) | 3.635 | 4.921 | 4.391 | 4.217 | 3.635
Rotor laminations + magnets (kg) | 2.832 | 3.451 | 3.186 | 3.274 | 2.832
Active mass (kg) | 7.955 | 9.146 | 8.368 | 8.398 | 7.021
Material cost (INR) | 4349 | 3653 | 3357 | 3397 | 2846
Saving vs copper (INR) | – | 696 (16.0 %) | 992 (22.8 %) | 952 (21.9 %) | 1504 (34.6 %)

### Operating points OP1–OP3

Efficiency change vs copper (points) | Least range loss | Alternative, 98.8 % torque at high speed | Recommended | Drop-in
OP1: 9000 rpm, maximum power | +2.15 | +1.50 | +1.47 | −1.56
OP2: 9339 rpm, 3.24 N·m | −0.11 | +0.33 | −0.34 | −0.91
OP3: 2000 rpm, maximum torque | −1.15 | −2.25 | −1.47 | −7.12

Aluminium is better than copper at 9000 rpm (OP1) and at the 9339 rpm cruise point (OP2): copper's single 2.95 mm wire has 505 W AC loss at OP1, aluminium's 1.50–1.90 mm strands 72–139 W. At peak torque (OP3) the higher DC resistance costs efficiency. Full tables on the OD 167 page.

Design9795 · aluminium winding · Al end-winding multiplier 1.136

## Al multiplier 1.136 vs 0.7

The copper reference is unchanged (Design9795_1, multiplier 0.7). Aluminium windings now use an end-winding MLT multiplier of 1.136: longer end turns raise their resistance, mass and loss, so every aluminium design loses more range and saves slightly less than in the 0.7 study.

### Copper reference and the aluminium drop-in (copper wire size, 64 mm)

| Copper (0.7) | Al drop-in, 0.7 | Al drop-in, 1.136
Mean turn length (mm) | 203.6 | 203.6 | 250.7
Resistance per path, 100 °C (mΩ) | 13.48 | 22.32 | 27.49
Phase resistance (mΩ) | 6.740 | 11.161 | 13.743
Line-to-line resistance, delta (mΩ) | 4.493 | 7.441 | 9.162
Winding mass (kg) | 1.488 | 0.450 | 0.555
Winding loss at peak torque (W) | 885 | 1452 | 1786
Telematics Wh/km | 61.291 | 62.650 | 63.574
Range vs copper, telematics | – | −2.17 % | −3.59 %
Range vs copper, WMTC | – | −2.02 % | −3.31 %
Saving vs copper (INR) | – | 1544 | 1504

### Best designs: 0.7 against 1.136 (full torque at every speed)

OD | Choice | Design (0.7) | Range | Saving (INR) | Design (1.136) | Range | Saving (INR)
OD 160 | least range loss | D0 L78 N8 4x1.63 | −1.25 % | 950 | A5 L82 N8 4x1.80 | −2.36 % | 819
OD 160 | largest saving | A5 L74 N9 5x1.50 | −1.58 % | 1205 | A5 L82 N8 5x1.60 | −2.38 % | 823
OD 163 | least range loss | G1 L78 N8 6x1.40 | −0.96 % | 864 | G3 L80 N8 4x1.83 | −1.96 % | 782
OD 163 | largest saving | G3 L72 N9 5x1.50 | −1.33 % | 1189 | G3 L78 N9 6x1.40 | −2.60 % | 871
OD 165 | least range loss | B1 L78 N8 6x1.42 | −0.98 % | 815 | B2 L80 N8 6x1.50 | −1.83 % | 698
OD 165 | largest saving | B3 L68 N10 5x1.50 | −1.35 % | 1302 | B3 L78 N9 6x1.42 | −2.61 % | 822
OD 167 | least range loss | F1 L78 N8 6x1.50 | −0.74 % | 747 | F1 L78 N8 6x1.50 | −1.54 % | 696
OD 167 | largest saving | F2 L66 N10 4x1.70 | −1.09 % | 1314 | F4 L74 N9 4x1.90 | −1.96 % | 952
All ODs | least range loss | F1 L78 N8 6x1.50 | −0.74 % | 747 | F1 L78 N8 6x1.50 | −1.54 % | 696
All ODs | largest saving | F2 L66 N10 4x1.70 | −1.09 % | 1314 | F4 L74 N9 4x1.90 | −1.96 % | 952

Range and saving are against the same copper reference (multiplier 0.7) in both columns.

### The same designs at both multipliers

Design | Mean turn 0.7 (mm) | Mean turn 1.136 | R/path 0.7 (mΩ) | R/path 1.136 | Range 0.7 | Range 1.136 | Saving 0.7 (INR) | Saving 1.136 (INR) | Peak winding loss 0.7 (W) | Peak winding loss 1.136 (W)
F4 L74 N9 4x1.90 | 225.4 | 273.7 | 13.37 | 16.23 | −1.16 % | −1.96 % | 1014 | 952 | 869 | 1055
F2 L72 N9 5x1.60 | 221.5 | 269.8 | 14.82 | 18.06 | −0.95 % | −1.86 % | 1047 | 992 | 961 | 1170
F1 L78 N8 6x1.50 | 233.1 | 281.2 | 13.15 | 15.86 | −0.74 % | −1.54 % | 747 | 696 | 854 | 1029

Design9795 · aluminium winding · Al end-winding multiplier 1.136

## Method and copper baseline

Every number comes from the Motor-CAD-equivalent FEMM model of Design9795_1, extended with FEMM solutions of each stator variant, then run through the vehicle drive cycles.

Stage | Script | What it computes | Count
1. Copper model | lab_model.py (v3), make_lab_v2.py | Motor-CAD-equivalent Lab model: skew slices, Motor-CAD torque, minor-loop hysteresis + harmonic eddy iron loss | validated on 840 Motor-CAD map points
2. Stator variants | alu9795_femm.py (FEMM) | Torque, d-q flux, stator iron-loss sums, slot field, tooth and yoke flux density on a 4 × 4 current grid × 2 rotor positions | 17 stators × 32 = 544 solves
3. Design search | alu9795_study.py, alu9795_search.py | Each stator × stack 64–90 mm × 8/9/10 turns per coil × 1–6 strands: envelope, efficiency map, peak point, drive cycles, cost | 4285 designs
4. Best designs | alu9795_analyse.py | Cost against range fronts per OD and criterion; Al price sensitivity | 4 ODs × 2 criteria × 3 prices
5. FEMM check | alu9795_verify.py | Direct solves between grid nodes, 4 rotor positions, against the interpolation | 60 solves
6. Operating points | alu9795_ops.py | OP1–OP3: currents, phase advance, voltage, flux, power factor, loss breakdown | 13 designs

### Copper baseline (Design9795_1)

Stator OD 160 mm, bore 107 mm, 12 slots, slot depth 17.65 mm, tooth 15.54 mm, yoke 8.85 mm, slot 281.2 mm²; 10-pole spoke ferrite rotor; 64 mm stack; delta, 2 parallel paths, 10 turns per coil of SWG 11 (2.946 mm) copper, fill 0.513; M235-35A. Drive: 52 V, modulation 0.95 (49.4 V phase peak), 360 A rms line, 280 A DC, MTPA. Winding and magnets at 100 °C.

#### Aluminium end-winding multiplier 1.136

The copper reference is Design9795_1 as given, with Motor-CAD's armature end-winding MLT multiplier 0.7 (mean turn 203.6 mm, 13.48 mΩ per path, 6.74 mΩ phase, 4.49 mΩ line to line at 100 °C). Every aluminium winding uses a multiplier of 1.136: the end-winding part of each aluminium turn is 1.623 × longer than at 0.7. The copper-size drop-in, for example, goes from 203.6 to 250.7 mm mean turn and 27.49 mΩ per path. Everything else (fields, iron loss, prices, vehicle, criteria) is as in the 0.7 study.

The FEMM copper model matches Motor-CAD Lab within 0.28 efficiency points (mean over 840 map points), 1.6 % torque and 2.7 % total loss; envelope torque within 0.7 % from 1000 to 9000 rpm (see the Lab validation report).

Copper efficiency map from the Motor-CAD-equivalent FEMM model, with the three operating p

Copper efficiency map from the Motor-CAD-equivalent FEMM model, with the three operating points.

OP1 · 9000 rpm, maximum power | Motor-CAD, copper | Copper (FEMM)
Shaft torque (N·m) | 13.98 | 14.05
Electromagnetic torque (N·m) | 14.46 | 14.50
Shaft power (W) | 13178 | 13239
Input power (W) | 14560 | 14552
Efficiency (%) | 90.51 | 90.97
Line current (A rms) | 247.2 | 236.3
Phase current (A rms, delta) | 142.7 | 136.4
Id, phase (A peak) | −184.2 | −173.3
Iq, phase (A peak) | 82.5 | 84.7
Phase advance (° el) | 65.9 | 63.9
Phase voltage (V peak, limit 49.4) | 49.40 | 49.38
Power factor | 0.974 | 0.983
ψd (mV·s) | 1.72 | 2.68
ψq (mV·s) | 9.69 | 9.85
DC bus current (A) | 280.0 | 279.9
Current density (A/mm² rms) | – | 10.0
Active limit | – | voltage, DC current
DC winding loss (W) | 411.7 | 376.2
AC winding loss (W) | 526.5 | 505.5
Stator hysteresis (W) | – | 71.6
Stator eddy (W) | – | 125.7
Stator iron total (W) | 205.3 | 197.4
Rotor iron (W) | 89.4 | 85.7
Iron total (W) | 294.7 | 283.1
Bearings + windage (W) | 148.9 | 148.9
Total loss (W) | 1381.8 | 1313.6

OP2 · 9339 rpm, 3.24 N·m | Copper (FEMM)
Shaft torque (N·m) | 3.27
Electromagnetic torque (N·m) | 3.62
Shaft power (W) | 3195
Input power (W) | 3785
Efficiency (%) | 84.41
Line current (A rms) | 120.7
Phase current (A rms, delta) | 69.7
Id, phase (A peak) | −96.2
Iq, phase (A peak) | 21.8
Phase advance (° el) | 77.2
Phase voltage (V peak, limit 49.4) | 49.22
Power factor | 0.499
ψd (mV·s) | 9.59
ψq (mV·s) | 2.84
DC bus current (A) | 72.8
Current density (A/mm² rms) | 5.1
Active limit | voltage
DC winding loss (W) | 98.3
AC winding loss (W) | 150.4
Stator hysteresis (W) | 54.2
Stator eddy (W) | 99.6
Stator iron total (W) | 153.8
Rotor iron (W) | 31.6
Iron total (W) | 185.4
Bearings + windage (W) | 156.2
Total loss (W) | 590.2

OP3 · 2000 rpm, maximum torque | Motor-CAD, copper | Copper (FEMM)
Shaft torque (N·m) | 44.11 | 44.06
Electromagnetic torque (N·m) | 44.76 | 44.67
Shaft power (W) | 9239 | 9227
Input power (W) | 10306 | 10284
Efficiency (%) | 89.65 | 89.73
Line current (A rms) | 360.0 | 360.0
Phase current (A rms, delta) | 207.8 | 207.8
Id, phase (A peak) | −85.0 | −90.8
Iq, phase (A peak) | 281.4 | 279.6
Phase advance (° el) | 16.8 | 18.0
Phase voltage (V peak, limit 49.4) | 34.36 | 33.85
Power factor | 0.680 | 0.685
ψd (mV·s) | 12.48 | 12.00
ψq (mV·s) | 28.90 | 28.65
DC bus current (A) | 198.2 | 197.8
Current density (A/mm² rms) | – | 15.2
Active limit | – | 360 A
DC winding loss (W) | 873.5 | 873.5
AC winding loss (W) | 57.4 | 54.7
Stator hysteresis (W) | – | 61.2
Stator eddy (W) | – | 20.4
Stator iron total (W) | 87.4 | 81.5
Rotor iron (W) | 27.7 | 25.9
Iron total (W) | 115.1 | 107.4
Bearings + windage (W) | 21.1 | 21.1
Total loss (W) | 1067.1 | 1056.6

Motor-CAD values from its envelope export (OP1, OP3). Motor-CAD splits iron loss into stator/rotor and hysteresis/eddy for the machine; its OP1 hysteresis 111 W, eddy 184 W. FEMM's OP1 iron loss is lower (the known hysteresis gap), so copper's FEMM efficiency is +0.46 points against Motor-CAD at OP1 and +0.08 at OP3. Aluminium designs are compared with FEMM copper, so this offset cancels.

### How an aluminium design is evaluated

- Turns: currents scaled by turns (same ampere-turns give the same field), flux linkage × turns, end-winding inductance × turns².
- Stack length: flux, torque, iron loss and windage scale with length (2D); end-turn length unchanged.
- Stator variant: FEMM differences against the copper stator at the same ampere-turns, added to the copper model (flux), or as ratios (stator iron loss, slot field). Checked against direct FEMM solves: ψq within 0.88 %, iron-loss ratio within 1.6 %.
- Winding: aluminium EC-1350 (2.826 × 10⁻⁸ Ω·m at 20 °C, 0.00403/K, 2703 kg/m³) at 100 °C; insulated fill at or below copper's 0.513; IEC and SWG wire sizes from 1.0 mm, 1–6 strands; mean turn = 2L + end turn corrected for tooth width and coil thickness; AC loss by Motor-CAD's hybrid method (factor 2) with FEMM's slot field.
- Acceptance: full = peak torque ≥ 99.5 % of copper and envelope ≥ 99 % at every speed 0–9500 rpm; relaxed = envelope ≥ 97 % (shortfall only in the DC-power-limited region above about 3000 rpm).

Design9795 · aluminium winding · Al end-winding multiplier 1.136

## OD 160 mm

Same OD and housing as copper. The slot can only grow inward (thinner yoke) or sideways (thinner teeth), and both cost torque per ampere-turn: −1.3 % per mm of yoke, −1.9 % per mm of tooth. Aluminium therefore needs a long stack. 1765 designs evaluated at this OD; 100 keep full torque at every speed, 656 stay within 3 %.

### Stator variants at OD 160

Stator | OD | Slot depth | Tooth | Yoke | Slot area (mm²) | vs copper | Max torque (N·m)* | vs copper | Tooth B 99 % (T) | Yoke B 99 % (T) | Stator steel (kg)*
D0 | 160 | 17.65 | 15.54 | 8.85 | 281.2 | ×1.000 | 50.62 | +0.0 % | 2.28 | 1.70 | 3.635
A1 | 160 | 18.65 | 15.54 | 7.85 | 303.1 | ×1.078 | 49.97 | −1.3 % | 2.28 | 1.78 | 3.510
A2 | 160 | 19.65 | 15.54 | 6.85 | 325.5 | ×1.157 | 48.38 | −4.4 % | 2.25 | 1.83 | 3.382
A3 | 160 | 17.65 | 14.54 | 8.85 | 296.2 | ×1.053 | 49.68 | −1.9 % | 2.27 | 1.66 | 3.550
A4 | 160 | 18.65 | 14.54 | 7.85 | 319.0 | ×1.135 | 49.16 | −2.9 % | 2.26 | 1.76 | 3.419
A5 | 160 | 19.65 | 14.54 | 6.85 | 342.5 | ×1.218 | 47.74 | −5.7 % | 2.24 | 1.82 | 3.285
A6 | 160 | 18.65 | 13.54 | 7.85 | 334.7 | ×1.190 | 48.06 | −5.0 % | 2.26 | 1.74 | 3.330

* FEMM 2D, 64 mm stack, 10 turns per coil, peak over the 4 × 4 current grid at 360 A (no skew). Dimensions in mm.

Slot outlines of the OD 160 stators against the copper stator (D0). Tooth tip and slot ope

Slot outlines of the OD 160 stators against the copper stator (D0). Tooth tip and slot opening are unchanged in every variant.

### Cost against range

All designs at OD 160. Dark: full torque at every speed; light blue: within 3 %; grey: nei

All designs at OD 160. Dark: full torque at every speed; light blue: within 3 %; grey: neither. Line: best designs (full). Circles: designs detailed below.

#### Best designs, full torque at every speed

Design | Stator | Yoke (mm) | Stack (mm) | Turns × (strands × d) | Worst envelope | Range, telematics | Range, WMTC | Saving (INR) | Winding loss at peak (W) | Mass change (kg)
A5 L82 N8 4x1.80 | A5 | 6.85 | 82 | 8 × (4 × 1.80) | 99.1 % | −2.36 % | −2.74 % | 819 | 1094 | +0.64
A5 L82 N8 5x1.60 | A5 | 6.85 | 82 | 8 × (5 × 1.60) | 99.1 % | −2.38 % | −2.77 % | 823 | 1107 | +0.63

#### Best designs, up to 3 % torque shortfall at high speed

Design | Stator | Yoke (mm) | Stack (mm) | Turns × (strands × d) | Worst envelope | Range, telematics | Range, WMTC | Saving (INR) | Winding loss at peak (W) | Mass change (kg)
A4 L80 N8 6x1.40 | A4 | 7.85 | 80 | 8 × (6 × 1.40) | 98.7 % | −2.26 % | −2.63 % | 879 | 1186 | +0.54
D0 L78 N8 4x1.63 | D0 | 8.85 | 78 | 8 × (4 × 1.63) | 98.0 % | −2.26 % | −2.54 % | 910 | 1302 | +0.53
D0 L78 N8 6x1.32 | D0 | 8.85 | 78 | 8 × (6 × 1.32) | 98.0 % | −2.27 % | −2.57 % | 913 | 1316 | +0.52
D0 L78 N8 5x1.42 | D0 | 8.85 | 78 | 8 × (5 × 1.42) | 97.7 % | −2.48 % | −2.76 % | 921 | 1361 | +0.50
A4 L72 N9 4x1.63 | A4 | 7.85 | 72 | 9 × (4 × 1.63) | 97.4 % | −2.53 % | −2.71 % | 1212 | 1399 | −0.28
A4 L72 N9 6x1.32 | A4 | 7.85 | 72 | 9 × (6 × 1.32) | 97.4 % | −2.55 % | −2.73 % | 1215 | 1415 | −0.28
A4 L72 N9 5x1.42 | A4 | 7.85 | 72 | 9 × (5 × 1.42) | 97.1 % | −2.78 % | −2.93 % | 1223 | 1463 | −0.31
A5 L70 N10 4x1.60 | A5 | 6.85 | 70 | 10 × (4 × 1.60) | 97.2 % | −3.13 % | −2.83 % | 1320 | 1584 | −0.58
A5 L70 N10 5x1.42 | A5 | 6.85 | 70 | 10 × (5 × 1.42) | 97.0 % | −3.16 % | −2.87 % | 1324 | 1604 | −0.59

At the copper stack of 64 mm, no design at this OD meets either criterion: aluminium at 64 mm loses torque either at low speed (fewer turns, 360 A limit) or above 2500 rpm (10 turns, higher resistance).

### Effect of stack length and turns

Best design (range) at each stack length and turn count at OD 160, among those within 3 %

Best design (range) at each stack length and turn count at OD 160, among those within 3 % of copper torque; filled dots also meet the full criterion. Fewer turns need a longer stack for the same torque at 360 A.

### Designs in detail

| Copper (today) | Largest saving, full torque / least range loss | Largest saving, ≤ 3 % high-speed torque
Design | Cu SWG 11 | A5 L82 N8 5x1.60 | A5 L70 N10 5x1.42
Stator OD (mm) | 160 | 160 | 160
Stator variant | D0 | A5 | A5
Stack length, stator = rotor = magnets (mm) | 64 | 82 | 70
Slot depth (mm) | 17.65 | 19.65 | 19.65
Tooth width (mm) | 15.54 | 14.54 | 14.54
Yoke (mm) | 8.85 | 6.85 | 6.85
Slot area (mm²) | 281.2 (×1.000) | 342.5 (×1.218) | 342.5 (×1.218)
Turns per coil | 10 | 8 | 10
Strands × bare diameter (mm) | 1 × 2.95 | 5 × 1.60 | 5 × 1.42
Conductor area (mm²) | 6.82 | 10.05 | 7.94
Insulated fill | 0.513 | 0.508 | 0.505
Mean turn length (mm) | 203.6 | 287.2 | 263.2
Resistance per path, 100 °C (mΩ) | 13.48 | 17.08 | 24.78
Peak torque, 1000 rpm (N·m) | 44.11 | 44.32 | 45.83
Worst envelope ratio vs copper | – | 99.1 % | 97.0 %
Winding loss at peak torque (W) | 885 | 1107 | 1604
Current density at peak (A/mm² rms) | 15.2 | 10.3 | 13.1
Peak efficiency (%) | 95.36 | 94.85 | 94.55
Map efficiency, mean change (points) | – | −1.64 | −2.57
Telematics: Wh/km at motor terminals | 61.291 | 62.785 | 63.294
Range change, telematics | – | −2.38 % | −3.16 %
Range change, WMTC Class 1 | – | −2.77 % | −2.87 %
Winding mass (kg) | 1.488 | 0.749 | 0.678
Stator laminations (kg) | 3.635 | 4.209 | 3.593
Rotor laminations + magnets (kg) | 2.832 | 3.628 | 3.097
Active mass (kg) | 7.955 | 8.587 | 7.369
Material cost (INR) | 4349 | 3527 | 3025
Saving vs copper (INR) | – | 823 (18.9 %) | 1324 (30.4 %)

### Torque-speed envelope

Maximum shaft torque at each speed against copper, same drive limits. Right: ratio to copp

Maximum shaft torque at each speed against copper, same drive limits. Right: ratio to copper; dotted lines 99 % and 97 %.

### Efficiency maps against copper

Efficiency change against copper at the same speed and shaft torque (blue = aluminium bett

Efficiency change against copper at the same speed and shaft torque (blue = aluminium better). Triangles: OP1–OP3.

Efficiency map of A5 L70 N10 5x1.42.

Efficiency map of A5 L70 N10 5x1.42.

### Operating points OP1, OP2, OP3

Efficiency change vs copper (points) | Largest saving, full torque / least range loss | Largest saving, ≤ 3 % high-speed torque
OP1: 9000 rpm, maximum power | +1.70 | −0.13
OP2: 9339 rpm, 3.24 N·m | −1.61 | −0.55
OP3: 2000 rpm, maximum torque | −1.74 | −5.24

Loss breakdown at the operating points; label = total loss and efficiency.

Loss breakdown at the operating points; label = total loss and efficiency.

OP1 · 9000 rpm, maximum power | Motor-CAD, copper | Copper (FEMM) | Largest saving, full torque / least range loss | Largest saving, ≤ 3 % high-speed torque
Shaft torque (N·m) | 13.98 | 14.05 | 14.28 | 14.02
Electromagnetic torque (N·m) | 14.46 | 14.50 | 14.80 | 14.54
Shaft power (W) | 13178 | 13239 | 13460 | 13218
Input power (W) | 14560 | 14552 | 14523 | 14551
Efficiency (%) | 90.51 | 90.97 | 92.68 | 90.84
Line current (A rms) | 247.2 | 236.3 | 241.5 | 248.3
Phase current (A rms, delta) | 142.7 | 136.4 | 139.4 | 143.3
Id, phase (A peak) | −184.2 | −173.3 | −177.1 | −186.5
Iq, phase (A peak) | 82.5 | 84.7 | 86.6 | 79.4
Phase advance (° el) | 65.9 | 63.9 | 63.9 | 66.9
Phase voltage (V peak, limit 49.4) | 49.40 | 49.38 | 49.24 | 49.10
Power factor | 0.974 | 0.983 | 0.992 | 0.969
ψd (mV·s) | 1.72 | 2.68 | 5.60 | 1.38
ψq (mV·s) | 9.69 | 9.85 | 8.40 | 9.81
DC bus current (A) | 280.0 | 279.9 | 279.3 | 279.8
Current density (A/mm² rms) | – | 10.0 | 6.9 | 9.0
Active limit | – | voltage, DC current | voltage | voltage, DC current
DC winding loss (W) | 411.7 | 376.2 | 498.2 | 763.5
AC winding loss (W) | 526.5 | 505.5 | 77.3 | 83.6
Stator hysteresis (W) | – | 71.6 | 90.5 | 83.5
Stator eddy (W) | – | 125.7 | 157.2 | 151.6
Stator iron total (W) | 205.3 | 197.4 | 247.7 | 235.1
Rotor iron (W) | 89.4 | 85.7 | 78.9 | 97.7
Iron total (W) | 294.7 | 283.1 | 326.6 | 332.7
Bearings + windage (W) | 148.9 | 148.9 | 161.4 | 153.0
Total loss (W) | 1381.8 | 1313.6 | 1063.5 | 1332.8

OP2 · 9339 rpm, 3.24 N·m | Copper (FEMM) | Largest saving, full torque / least range loss | Largest saving, ≤ 3 % high-speed torque
Shaft torque (N·m) | 3.27 | 3.24 | 3.27
Electromagnetic torque (N·m) | 3.62 | 3.69 | 3.66
Shaft power (W) | 3195 | 3172 | 3198
Input power (W) | 3785 | 3831 | 3814
Efficiency (%) | 84.41 | 82.80 | 83.86
Line current (A rms) | 120.7 | 150.0 | 129.8
Phase current (A rms, delta) | 69.7 | 86.6 | 74.9
Id, phase (A peak) | −96.2 | −120.5 | −104.0
Iq, phase (A peak) | 21.8 | 21.9 | 20.3
Phase advance (° el) | 77.2 | 79.7 | 78.9
Phase voltage (V peak, limit 49.4) | 49.22 | 49.23 | 49.25
Power factor | 0.499 | 0.420 | 0.484
ψd (mV·s) | 9.59 | 9.71 | 9.53
ψq (mV·s) | 2.84 | 2.31 | 2.83
DC bus current (A) | 72.8 | 73.7 | 73.3
Current density (A/mm² rms) | 5.1 | 4.3 | 4.7
Active limit | voltage | voltage | voltage
DC winding loss (W) | 98.3 | 192.2 | 208.6
AC winding loss (W) | 150.4 | 33.3 | 25.7
Stator hysteresis (W) | 54.2 | 79.7 | 65.1
Stator eddy (W) | 99.6 | 144.3 | 119.6
Stator iron total (W) | 153.8 | 223.9 | 184.6
Rotor iron (W) | 31.6 | 40.0 | 36.0
Iron total (W) | 185.4 | 264.0 | 220.6
Bearings + windage (W) | 156.2 | 169.4 | 160.6
Total loss (W) | 590.2 | 658.8 | 615.5

OP3 · 2000 rpm, maximum torque | Motor-CAD, copper | Copper (FEMM) | Largest saving, full torque / least range loss | Largest saving, ≤ 3 % high-speed torque
Shaft torque (N·m) | 44.11 | 44.06 | 44.25 | 45.76
Electromagnetic torque (N·m) | 44.76 | 44.67 | 44.97 | 46.46
Shaft power (W) | 9239 | 9227 | 9268 | 9585
Input power (W) | 10306 | 10284 | 10534 | 11345
Efficiency (%) | 89.65 | 89.73 | 87.98 | 84.49
Line current (A rms) | 360.0 | 360.0 | 360.0 | 360.0
Phase current (A rms, delta) | 207.8 | 207.8 | 207.8 | 207.8
Id, phase (A peak) | −85.0 | −90.8 | −89.9 | −98.1
Iq, phase (A peak) | 281.4 | 279.6 | 279.8 | 277.1
Phase advance (° el) | 16.8 | 18.0 | 17.8 | 19.5
Phase voltage (V peak, limit 49.4) | 34.36 | 33.85 | 31.00 | 35.94
Power factor | 0.680 | 0.685 | 0.770 | 0.715
ψd (mV·s) | 12.48 | 12.00 | 13.64 | 11.86
ψq (mV·s) | 28.90 | 28.65 | 24.22 | 29.64
DC bus current (A) | 198.2 | 197.8 | 202.6 | 218.2
Current density (A/mm² rms) | – | 15.2 | 10.3 | 13.1
Active limit | – | 360 A | 360 A | 360 A
DC winding loss (W) | 873.5 | 873.5 | 1107.0 | 1605.5
AC winding loss (W) | 57.4 | 54.7 | 7.7 | 7.5
Stator hysteresis (W) | – | 61.2 | 78.0 | 73.3
Stator eddy (W) | – | 20.4 | 24.5 | 24.3
Stator iron total (W) | 87.4 | 81.5 | 102.6 | 97.6
Rotor iron (W) | 27.7 | 25.9 | 25.5 | 27.7
Iron total (W) | 115.1 | 107.4 | 128.1 | 125.3
Bearings + windage (W) | 21.1 | 21.1 | 22.8 | 21.7
Total loss (W) | 1067.1 | 1056.6 | 1265.7 | 1760.0

### Drive cycle and range

Design | Cycle | Net Wh/km | Shaft out, motoring | Electrical in, motoring | η motoring (%) | Shaft in, regen | Electrical out, regen | η regen (%) | DC winding loss | AC winding loss | Iron loss | Mech. loss | Total loss | Range change
Copper | Telematics | 61.291 | 81.53 | 87.83 | 92.82 | 28.55 | 26.54 | 92.97 | 2.82 | 0.84 | 3.04 | 1.61 | 8.32 | –
| WMTC Class 1 | 60.520 | 76.21 | 81.72 | 93.26 | 22.91 | 21.20 | 92.55 | 2.13 | 0.40 | 3.10 | 1.59 | 7.22 | –
Largest saving, full torque / least range loss | Telematics | 62.785 | 81.63 | 89.00 | 91.72 | 28.57 | 26.21 | 91.76 | 3.60 | 0.12 | 4.25 | 1.75 | 9.72 | −2.38 %
| WMTC Class 1 | 62.243 | 76.21 | 83.02 | 91.80 | 22.91 | 20.78 | 90.70 | 2.79 | 0.06 | 4.37 | 1.72 | 8.94 | −2.77 %
Largest saving, ≤ 3 % high-speed torque | Telematics | 63.294 | 81.40 | 89.31 | 91.15 | 28.52 | 26.02 | 91.22 | 5.05 | 0.13 | 3.58 | 1.66 | 10.41 | −3.16 %
| WMTC Class 1 | 62.311 | 76.21 | 83.05 | 91.77 | 22.91 | 20.74 | 90.51 | 3.64 | 0.06 | 3.68 | 1.63 | 9.01 | −2.87 %

Energies and losses in Wh/km at the motor (motor losses only; inverter, battery and vehicle are the same for every design).

Motor losses over the telematics cycle by type.

Motor losses over the telematics cycle by type.

Where the range is lost: extra loss against copper over the telematics cycle, by motor spe

Where the range is lost: extra loss against copper over the telematics cycle, by motor speed band, motoring (left) and regenerating (right).

### Cost

Design | Winding (kg) | Wire (INR) | Laminations (kg) | Laminations (INR) | Magnets (kg) | Magnets (INR) | Total (INR) | Saving, Al ₹370 | Saving, Al ₹230 | Saving, Al ₹450
Copper | 1.488 | 1719 | 5.087 | 1526 | 1.380 | 1104 | 4349 | – | – | –
Largest saving, full torque / least range loss | 0.749 | 291 | 6.069 | 1821 | 1.768 | 1415 | 3527 | 823 | 933 | 760
Largest saving, ≤ 3 % high-speed torque | 0.678 | 263 | 5.181 | 1554 | 1.510 | 1208 | 3025 | 1324 | 1423 | 1267

Design9795 · aluminium winding · Al end-winding multiplier 1.136

## OD 163 mm

Three extra millimetres of OD deepen the slot by 1.5 mm with the copper yoke and tooth (slot ×1.118), or by 2.5 mm with a 1 mm thinner yoke. 756 designs evaluated at this OD; 77 keep full torque at every speed, 349 stay within 3 %.

### Stator variants at OD 163

Stator | OD | Slot depth | Tooth | Yoke | Slot area (mm²) | vs copper | Max torque (N·m)* | vs copper | Tooth B 99 % (T) | Yoke B 99 % (T) | Stator steel (kg)*
D0 | 160 | 17.65 | 15.54 | 8.85 | 281.2 | ×1.000 | 50.62 | +0.0 % | 2.28 | 1.70 | 3.635
G1 | 163 | 19.15 | 15.54 | 8.85 | 314.3 | ×1.118 | 50.48 | −0.3 % | 2.29 | 1.71 | 3.808
G2 | 163 | 20.15 | 15.54 | 7.85 | 336.9 | ×1.198 | 49.80 | −1.6 % | 2.27 | 1.78 | 3.679
G3 | 163 | 20.15 | 14.54 | 7.85 | 354.4 | ×1.260 | 48.96 | −3.3 % | 2.26 | 1.76 | 3.579

* FEMM 2D, 64 mm stack, 10 turns per coil, peak over the 4 × 4 current grid at 360 A (no skew). Dimensions in mm.

Slot outlines of the OD 163 stators against the copper stator (D0). Tooth tip and slot ope

Slot outlines of the OD 163 stators against the copper stator (D0). Tooth tip and slot opening are unchanged in every variant.

### Cost against range

All designs at OD 163. Dark: full torque at every speed; light blue: within 3 %; grey: nei

All designs at OD 163. Dark: full torque at every speed; light blue: within 3 %; grey: neither. Line: best designs (full). Circles: designs detailed below.

#### Best designs, full torque at every speed

Design | Stator | Yoke (mm) | Stack (mm) | Turns × (strands × d) | Worst envelope | Range, telematics | Range, WMTC | Saving (INR) | Winding loss at peak (W) | Mass change (kg)
G3 L80 N8 4x1.83 | G3 | 7.85 | 80 | 8 × (4 × 1.83) | 99.3 % | −1.96 % | −2.40 % | 782 | 1048 | +0.83
G3 L80 N8 5x1.63 | G3 | 7.85 | 80 | 8 × (5 × 1.63) | 99.2 % | −1.97 % | −2.43 % | 786 | 1060 | +0.82
G3 L78 N9 6x1.40 | G3 | 7.85 | 78 | 9 × (6 × 1.40) | 99.0 % | −2.60 % | −2.35 % | 871 | 1319 | +0.61

#### Best designs, up to 3 % torque shortfall at high speed

Design | Stator | Yoke (mm) | Stack (mm) | Turns × (strands × d) | Worst envelope | Range, telematics | Range, WMTC | Saving (INR) | Winding loss at peak (W) | Mass change (kg)
G1 L78 N8 6x1.40 | G1 | 8.85 | 78 | 8 × (6 × 1.40) | 98.7 % | −1.87 % | −2.25 % | 820 | 1175 | +0.81
G1 L78 N8 4x1.70 | G1 | 8.85 | 78 | 8 × (4 × 1.70) | 98.5 % | −2.00 % | −2.37 % | 824 | 1196 | +0.80
G1 L78 N8 5x1.50 | G1 | 8.85 | 78 | 8 × (5 × 1.50) | 98.4 % | −2.11 % | −2.48 % | 831 | 1228 | +0.78
G3 L72 N9 6x1.40 | G3 | 7.85 | 72 | 9 × (6 × 1.40) | 98.1 % | −2.12 % | −2.41 % | 1129 | 1262 | −0.02
G3 L72 N9 4x1.70 | G3 | 7.85 | 72 | 9 × (4 × 1.70) | 98.0 % | −2.27 % | −2.54 % | 1134 | 1284 | −0.03
G1 L70 N9 4x1.60 | G1 | 8.85 | 70 | 9 × (4 × 1.60) | 97.2 % | −2.38 % | −2.55 % | 1175 | 1432 | −0.07
G1 L70 N9 5x1.42 | G1 | 8.85 | 70 | 9 × (5 × 1.42) | 97.1 % | −2.43 % | −2.60 % | 1178 | 1449 | −0.08
G1 L70 N9 3x1.83 | G1 | 8.85 | 70 | 9 × (3 × 1.83) | 97.0 % | −2.57 % | −2.70 % | 1180 | 1461 | −0.09
G3 L68 N10 4x1.63 | G3 | 7.85 | 68 | 10 × (4 × 1.63) | 97.3 % | −2.72 % | −2.52 % | 1301 | 1513 | −0.44
G3 L68 N10 6x1.32 | G3 | 7.85 | 68 | 10 × (6 × 1.32) | 97.2 % | −2.73 % | −2.54 % | 1304 | 1530 | −0.45

At the copper stack of 64 mm, no design at this OD meets either criterion: aluminium at 64 mm loses torque either at low speed (fewer turns, 360 A limit) or above 2500 rpm (10 turns, higher resistance).

### Effect of stack length and turns

Best design (range) at each stack length and turn count at OD 163, among those within 3 %

Best design (range) at each stack length and turn count at OD 163, among those within 3 % of copper torque; filled dots also meet the full criterion. Fewer turns need a longer stack for the same torque at 360 A.

### Designs in detail

| Copper (today) | Largest saving within 2.0 % range, ≤ 3 % high-speed torque | Least range loss | Largest saving, full torque
Design | Cu SWG 11 | G1 L78 N8 6x1.40 | G3 L80 N8 4x1.83 | G3 L78 N9 6x1.40
Stator OD (mm) | 160 | 163 | 163 | 163
Stator variant | D0 | G1 | G3 | G3
Stack length, stator = rotor = magnets (mm) | 64 | 78 | 80 | 78
Slot depth (mm) | 17.65 | 19.15 | 20.15 | 20.15
Tooth width (mm) | 15.54 | 15.54 | 14.54 | 14.54
Yoke (mm) | 8.85 | 8.85 | 7.85 | 7.85
Slot area (mm²) | 281.2 (×1.000) | 314.3 (×1.118) | 354.4 (×1.260) | 354.4 (×1.260)
Turns per coil | 10 | 8 | 8 | 9
Strands × bare diameter (mm) | 1 × 2.95 | 6 × 1.40 | 4 × 1.83 | 6 × 1.40
Conductor area (mm²) | 6.82 | 9.24 | 10.51 | 9.24
Insulated fill | 0.513 | 0.513 | 0.510 | 0.511
Mean turn length (mm) | 203.6 | 279.8 | 283.6 | 279.6
Resistance per path, 100 °C (mΩ) | 13.48 | 18.11 | 16.13 | 20.36
Peak torque, 1000 rpm (N·m) | 44.11 | 44.05 | 44.02 | 47.61
Worst envelope ratio vs copper | – | 98.7 % | 99.3 % | 99.0 %
Winding loss at peak torque (W) | 885 | 1175 | 1048 | 1319
Current density at peak (A/mm² rms) | 15.2 | 11.3 | 9.9 | 11.2
Peak efficiency (%) | 95.36 | 94.91 | 94.94 | 94.87
Map efficiency, mean change (points) | – | −1.64 | −1.39 | −1.52
Telematics: Wh/km at motor terminals | 61.291 | 62.457 | 62.515 | 62.926
Range change, telematics | – | −1.87 % | −1.96 % | −2.60 %
Range change, WMTC Class 1 | – | −2.25 % | −2.40 % | −2.35 %
Winding mass (kg) | 1.488 | 0.671 | 0.773 | 0.754
Stator laminations (kg) | 3.635 | 4.641 | 4.473 | 4.362
Rotor laminations + magnets (kg) | 2.832 | 3.451 | 3.540 | 3.451
Active mass (kg) | 7.955 | 8.763 | 8.787 | 8.567
Material cost (INR) | 4349 | 3529 | 3567 | 3478
Saving vs copper (INR) | – | 820 (18.9 %) | 782 (18.0 %) | 871 (20.0 %)

### Torque-speed envelope

Maximum shaft torque at each speed against copper, same drive limits. Right: ratio to copp

Maximum shaft torque at each speed against copper, same drive limits. Right: ratio to copper; dotted lines 99 % and 97 %.

### Efficiency maps against copper

Efficiency change against copper at the same speed and shaft torque (blue = aluminium bett

Efficiency change against copper at the same speed and shaft torque (blue = aluminium better). Triangles: OP1–OP3.

Efficiency map of G3 L78 N9 6x1.40.

Efficiency map of G3 L78 N9 6x1.40.

### Operating points OP1, OP2, OP3

Efficiency change vs copper (points) | Largest saving within 2.0 % range, ≤ 3 % high-speed torque | Least range loss | Largest saving, full torque
OP1: 9000 rpm, maximum power | +1.86 | +1.80 | +1.04
OP2: 9339 rpm, 3.24 N·m | −0.38 | −1.08 | −1.14
OP3: 2000 rpm, maximum torque | −2.28 | −1.32 | −2.68

Loss breakdown at the operating points; label = total loss and efficiency.

Loss breakdown at the operating points; label = total loss and efficiency.

OP1 · 9000 rpm, maximum power | Motor-CAD, copper | Copper (FEMM) | Largest saving within 2.0 % range, ≤ 3 % high-speed torque | Least range loss | Largest saving, full torque
Shaft torque (N·m) | 13.98 | 14.05 | 14.33 | 14.32 | 14.21
Electromagnetic torque (N·m) | 14.46 | 14.50 | 14.81 | 14.83 | 14.72
Shaft power (W) | 13178 | 13239 | 13503 | 13498 | 13392
Input power (W) | 14560 | 14552 | 14545 | 14550 | 14553
Efficiency (%) | 90.51 | 90.97 | 92.83 | 92.77 | 92.02
Line current (A rms) | 247.2 | 236.3 | 241.5 | 241.5 | 243.8
Phase current (A rms, delta) | 142.7 | 136.4 | 139.4 | 139.4 | 140.7
Id, phase (A peak) | −184.2 | −173.3 | −175.7 | −176.0 | −182.1
Iq, phase (A peak) | 82.5 | 84.7 | 89.5 | 88.9 | 80.4
Phase advance (° el) | 65.9 | 63.9 | 63.0 | 63.2 | 66.2
Phase voltage (V peak, limit 49.4) | 49.40 | 49.38 | 49.21 | 49.13 | 48.54
Power factor | 0.974 | 0.983 | 0.995 | 0.994 | 0.999
ψd (mV·s) | 1.72 | 2.68 | 5.45 | 5.52 | 3.63
ψq (mV·s) | 9.69 | 9.85 | 8.46 | 8.45 | 9.18
DC bus current (A) | 280.0 | 279.9 | 279.7 | 279.8 | 279.9
Current density (A/mm² rms) | – | 10.0 | 7.5 | 6.6 | 7.6
Active limit | – | voltage, DC current | voltage, DC current | voltage, DC current | DC current
DC winding loss (W) | 411.7 | 376.2 | 528.2 | 470.5 | 604.9
AC winding loss (W) | 526.5 | 505.5 | 58.7 | 101.6 | 73.2
Stator hysteresis (W) | – | 71.6 | 80.7 | 88.4 | 85.1
Stator eddy (W) | – | 125.7 | 139.8 | 153.0 | 151.1
Stator iron total (W) | 205.3 | 197.4 | 220.5 | 241.4 | 236.2
Rotor iron (W) | 89.4 | 85.7 | 76.5 | 78.1 | 88.9
Iron total (W) | 294.7 | 283.1 | 297.0 | 319.5 | 325.0
Bearings + windage (W) | 148.9 | 148.9 | 158.6 | 160.0 | 158.6
Total loss (W) | 1381.8 | 1313.6 | 1042.5 | 1051.6 | 1161.8

OP2 · 9339 rpm, 3.24 N·m | Copper (FEMM) | Largest saving within 2.0 % range, ≤ 3 % high-speed torque | Least range loss | Largest saving, full torque
Shaft torque (N·m) | 3.27 | 3.28 | 3.26 | 3.27
Electromagnetic torque (N·m) | 3.62 | 3.69 | 3.69 | 3.69
Shaft power (W) | 3195 | 3204 | 3185 | 3202
Input power (W) | 3785 | 3813 | 3822 | 3845
Efficiency (%) | 84.41 | 84.03 | 83.33 | 83.27
Line current (A rms) | 120.7 | 143.2 | 146.2 | 142.5
Phase current (A rms, delta) | 69.7 | 82.7 | 84.4 | 82.3
Id, phase (A peak) | −96.2 | −114.7 | −117.3 | −114.5
Iq, phase (A peak) | 21.8 | 22.8 | 22.5 | 20.5
Phase advance (° el) | 77.2 | 78.8 | 79.1 | 79.9
Phase voltage (V peak, limit 49.4) | 49.22 | 49.24 | 49.18 | 49.29
Power factor | 0.499 | 0.439 | 0.429 | 0.444
ψd (mV·s) | 9.59 | 9.69 | 9.70 | 9.64
ψq (mV·s) | 2.84 | 2.36 | 2.33 | 2.58
DC bus current (A) | 72.8 | 73.3 | 73.5 | 73.9
Current density (A/mm² rms) | 5.1 | 4.5 | 4.0 | 4.5
Active limit | voltage | voltage | voltage | voltage
DC winding loss (W) | 98.3 | 185.8 | 172.6 | 206.7
AC winding loss (W) | 150.4 | 23.3 | 41.6 | 28.0
Stator hysteresis (W) | 54.2 | 69.7 | 77.1 | 71.5
Stator eddy (W) | 99.6 | 126.6 | 139.7 | 130.9
Stator iron total (W) | 153.8 | 196.4 | 216.8 | 202.4
Rotor iron (W) | 31.6 | 37.3 | 38.6 | 39.7
Iron total (W) | 185.4 | 233.6 | 255.4 | 242.1
Bearings + windage (W) | 156.2 | 166.4 | 167.9 | 166.4
Total loss (W) | 590.2 | 609.2 | 637.4 | 643.3

OP3 · 2000 rpm, maximum torque | Motor-CAD, copper | Copper (FEMM) | Largest saving within 2.0 % range, ≤ 3 % high-speed torque | Least range loss | Largest saving, full torque
Shaft torque (N·m) | 44.11 | 44.06 | 43.96 | 43.92 | 47.55
Electromagnetic torque (N·m) | 44.76 | 44.67 | 44.63 | 44.64 | 48.29
Shaft power (W) | 9239 | 9227 | 9206 | 9199 | 9958
Input power (W) | 10306 | 10284 | 10528 | 10405 | 11440
Efficiency (%) | 89.65 | 89.73 | 87.45 | 88.41 | 87.04
Line current (A rms) | 360.0 | 360.0 | 360.0 | 360.0 | 360.0
Phase current (A rms, delta) | 207.8 | 207.8 | 207.8 | 207.8 | 207.8
Id, phase (A peak) | −85.0 | −90.8 | −81.6 | −84.4 | −91.7
Iq, phase (A peak) | 281.4 | 279.6 | 282.4 | 281.6 | 279.3
Phase advance (° el) | 16.8 | 18.0 | 16.1 | 16.7 | 18.2
Phase voltage (V peak, limit 49.4) | 34.36 | 33.85 | 31.43 | 31.01 | 35.33
Power factor | 0.680 | 0.685 | 0.759 | 0.760 | 0.734
ψd (mV·s) | 12.48 | 12.00 | 14.02 | 13.87 | 13.66
ψq (mV·s) | 28.90 | 28.65 | 24.39 | 24.24 | 28.60
DC bus current (A) | 198.2 | 197.8 | 202.5 | 200.1 | 220.0
Current density (A/mm² rms) | – | 15.2 | 11.3 | 9.9 | 11.3
Active limit | – | 360 A | 360 A | 360 A | 360 A
DC winding loss (W) | 873.5 | 873.5 | 1173.7 | 1045.5 | 1319.5
AC winding loss (W) | 57.4 | 54.7 | 6.3 | 10.6 | 7.4
Stator hysteresis (W) | – | 61.2 | 71.3 | 77.5 | 79.8
Stator eddy (W) | – | 20.4 | 22.6 | 24.5 | 25.7
Stator iron total (W) | 87.4 | 81.5 | 93.9 | 102.0 | 105.5
Rotor iron (W) | 27.7 | 25.9 | 25.1 | 25.4 | 27.6
Iron total (W) | 115.1 | 107.4 | 119.0 | 127.4 | 133.2
Bearings + windage (W) | 21.1 | 21.1 | 22.4 | 22.6 | 22.4
Total loss (W) | 1067.1 | 1056.6 | 1321.4 | 1206.2 | 1482.5

### Drive cycle and range

Design | Cycle | Net Wh/km | Shaft out, motoring | Electrical in, motoring | η motoring (%) | Shaft in, regen | Electrical out, regen | η regen (%) | DC winding loss | AC winding loss | Iron loss | Mech. loss | Total loss | Range change
Copper | Telematics | 61.291 | 81.53 | 87.83 | 92.82 | 28.55 | 26.54 | 92.97 | 2.82 | 0.84 | 3.04 | 1.61 | 8.32 | –
| WMTC Class 1 | 60.520 | 76.21 | 81.72 | 93.26 | 22.91 | 21.20 | 92.55 | 2.13 | 0.40 | 3.10 | 1.59 | 7.22 | –
Largest saving within 2.0 % range, ≤ 3 % high-speed torque | Telematics | 62.457 | 81.61 | 88.72 | 91.98 | 28.57 | 26.27 | 91.95 | 3.87 | 0.10 | 3.73 | 1.72 | 9.42 | −1.87 %
| WMTC Class 1 | 61.914 | 76.21 | 82.75 | 92.09 | 22.91 | 20.84 | 90.96 | 3.06 | 0.05 | 3.82 | 1.69 | 8.61 | −2.25 %
Least range loss | Telematics | 62.515 | 81.63 | 88.79 | 91.94 | 28.57 | 26.27 | 91.97 | 3.43 | 0.16 | 4.12 | 1.73 | 9.45 | −1.96 %
| WMTC Class 1 | 62.010 | 76.21 | 82.85 | 91.99 | 22.91 | 20.84 | 90.95 | 2.69 | 0.08 | 4.24 | 1.71 | 8.71 | −2.40 %
Largest saving, full torque | Telematics | 62.926 | 81.74 | 89.14 | 91.70 | 28.55 | 26.21 | 91.80 | 4.08 | 0.12 | 3.83 | 1.72 | 9.74 | −2.60 %
| WMTC Class 1 | 61.975 | 76.21 | 82.81 | 92.03 | 22.91 | 20.84 | 90.96 | 2.98 | 0.05 | 3.95 | 1.69 | 8.67 | −2.35 %

Energies and losses in Wh/km at the motor (motor losses only; inverter, battery and vehicle are the same for every design).

Motor losses over the telematics cycle by type.

Motor losses over the telematics cycle by type.

Where the range is lost: extra loss against copper over the telematics cycle, by motor spe

Where the range is lost: extra loss against copper over the telematics cycle, by motor speed band, motoring (left) and regenerating (right).

### Cost

Design | Winding (kg) | Wire (INR) | Laminations (kg) | Laminations (INR) | Magnets (kg) | Magnets (INR) | Total (INR) | Saving, Al ₹370 | Saving, Al ₹230 | Saving, Al ₹450
Copper | 1.488 | 1719 | 5.087 | 1526 | 1.380 | 1104 | 4349 | – | – | –
Largest saving within 2.0 % range, ≤ 3 % high-speed torque | 0.671 | 261 | 6.410 | 1923 | 1.682 | 1346 | 3529 | 820 | 919 | 764
Least range loss | 0.773 | 300 | 6.288 | 1886 | 1.725 | 1380 | 3567 | 782 | 896 | 717
Largest saving, full torque | 0.754 | 293 | 6.131 | 1839 | 1.682 | 1346 | 3478 | 871 | 982 | 808

Design9795 · aluminium winding · Al end-winding multiplier 1.136

## OD 165 mm

Five extra millimetres deepen the slot by 2.5 mm with the copper yoke and tooth (slot ×1.198), up to ×1.346 with a 1 mm thinner yoke and tooth. 756 designs evaluated at this OD; 114 keep full torque at every speed, 401 stay within 3 %.

### Stator variants at OD 165

Stator | OD | Slot depth | Tooth | Yoke | Slot area (mm²) | vs copper | Max torque (N·m)* | vs copper | Tooth B 99 % (T) | Yoke B 99 % (T) | Stator steel (kg)*
D0 | 160 | 17.65 | 15.54 | 8.85 | 281.2 | ×1.000 | 50.62 | +0.0 % | 2.28 | 1.70 | 3.635
B1 | 165 | 20.15 | 15.54 | 8.85 | 336.9 | ×1.198 | 50.41 | −0.4 % | 2.28 | 1.70 | 3.923
B2 | 165 | 21.15 | 15.54 | 7.85 | 360.1 | ×1.281 | 49.68 | −1.9 % | 2.28 | 1.78 | 3.791
B3 | 165 | 21.15 | 14.54 | 7.85 | 378.6 | ×1.346 | 48.81 | −3.6 % | 2.26 | 1.76 | 3.685

* FEMM 2D, 64 mm stack, 10 turns per coil, peak over the 4 × 4 current grid at 360 A (no skew). Dimensions in mm.

Slot outlines of the OD 165 stators against the copper stator (D0). Tooth tip and slot ope

Slot outlines of the OD 165 stators against the copper stator (D0). Tooth tip and slot opening are unchanged in every variant.

### Cost against range

All designs at OD 165. Dark: full torque at every speed; light blue: within 3 %; grey: nei

All designs at OD 165. Dark: full torque at every speed; light blue: within 3 %; grey: neither. Line: best designs (full). Circles: designs detailed below.

#### Best designs, full torque at every speed

Design | Stator | Yoke (mm) | Stack (mm) | Turns × (strands × d) | Worst envelope | Range, telematics | Range, WMTC | Saving (INR) | Winding loss at peak (W) | Mass change (kg)
B2 L80 N8 6x1.50 | B2 | 7.85 | 80 | 8 × (6 × 1.50) | 99.5 % | −1.83 % | −2.21 % | 698 | 1044 | +1.11
B2 L80 N8 4x1.83 | B2 | 7.85 | 80 | 8 × (4 × 1.83) | 99.4 % | −1.94 % | −2.29 % | 701 | 1054 | +1.10
B2 L80 N8 5x1.63 | B2 | 7.85 | 80 | 8 × (5 × 1.63) | 99.4 % | −1.95 % | −2.32 % | 705 | 1066 | +1.09
B3 L80 N8 6x1.50 | B3 | 7.85 | 80 | 8 × (6 × 1.50) | 99.3 % | −2.00 % | −2.52 % | 739 | 1040 | +0.97
B3 L80 N8 4x1.83 | B3 | 7.85 | 80 | 8 × (4 × 1.83) | 99.2 % | −2.11 % | −2.59 % | 742 | 1050 | +0.97
B3 L80 N8 5x1.63 | B3 | 7.85 | 80 | 8 × (5 × 1.63) | 99.2 % | −2.12 % | −2.62 % | 745 | 1063 | +0.96
B1 L78 N9 5x1.50 | B1 | 8.85 | 78 | 9 × (5 × 1.50) | 99.0 % | −2.58 % | −2.09 % | 757 | 1386 | +1.00
B2 L78 N9 6x1.40 | B2 | 7.85 | 78 | 9 × (6 × 1.40) | 99.1 % | −2.59 % | −2.23 % | 792 | 1326 | +0.87
B3 L78 N9 6x1.42 | B3 | 7.85 | 78 | 9 × (6 × 1.42) | 99.2 % | −2.61 % | −2.39 % | 822 | 1281 | +0.77

#### Best designs, up to 3 % torque shortfall at high speed

Design | Stator | Yoke (mm) | Stack (mm) | Turns × (strands × d) | Worst envelope | Range, telematics | Range, WMTC | Saving (INR) | Winding loss at peak (W) | Mass change (kg)
B2 L80 N8 6x1.50 | B2 | 7.85 | 80 | 8 × (6 × 1.50) | 99.5 % | −1.83 % | −2.21 % | 698 | 1044 | +1.11
B1 L78 N8 6x1.42 | B1 | 8.85 | 78 | 8 × (6 × 1.42) | 98.9 % | −1.87 % | −2.29 % | 769 | 1142 | +0.97
B1 L72 N9 5x1.50 | B1 | 8.85 | 72 | 9 × (5 × 1.50) | 98.2 % | −2.10 % | −2.15 % | 1024 | 1326 | +0.34
B2 L72 N9 6x1.40 | B2 | 7.85 | 72 | 9 × (6 × 1.40) | 98.3 % | −2.13 % | −2.29 % | 1056 | 1269 | +0.22
B2 L72 N9 4x1.70 | B2 | 7.85 | 72 | 9 × (4 × 1.70) | 98.1 % | −2.28 % | −2.41 % | 1061 | 1292 | +0.21
B3 L66 N10 5x1.50 | B3 | 7.85 | 66 | 10 × (5 × 1.50) | 97.3 % | −2.30 % | −2.42 % | 1336 | 1404 | −0.50
B3 L66 N10 2x2.36 | B3 | 7.85 | 66 | 10 × (2 × 2.36) | 97.1 % | −2.60 % | −2.62 % | 1339 | 1421 | −0.51

At the copper stack of 64 mm, no design at this OD meets either criterion: aluminium at 64 mm loses torque either at low speed (fewer turns, 360 A limit) or above 2500 rpm (10 turns, higher resistance).

### Effect of stack length and turns

Best design (range) at each stack length and turn count at OD 165, among those within 3 %

Best design (range) at each stack length and turn count at OD 165, among those within 3 % of copper torque; filled dots also meet the full criterion. Fewer turns need a longer stack for the same torque at 360 A.

### Designs in detail

| Copper (today) | Least range loss | Largest saving within 2.0 % range, ≤ 3 % high-speed torque | Largest saving, full torque
Design | Cu SWG 11 | B2 L80 N8 6x1.50 | B1 L78 N8 6x1.42 | B3 L78 N9 6x1.42
Stator OD (mm) | 160 | 165 | 165 | 165
Stator variant | D0 | B2 | B1 | B3
Stack length, stator = rotor = magnets (mm) | 64 | 80 | 78 | 78
Slot depth (mm) | 17.65 | 21.15 | 20.15 | 21.15
Tooth width (mm) | 15.54 | 15.54 | 15.54 | 14.54
Yoke (mm) | 8.85 | 7.85 | 8.85 | 7.85
Slot area (mm²) | 281.2 (×1.000) | 360.1 (×1.281) | 336.9 (×1.198) | 378.6 (×1.346)
Turns per coil | 10 | 8 | 8 | 9
Strands × bare diameter (mm) | 1 × 2.95 | 6 × 1.50 | 6 × 1.42 | 6 × 1.42
Conductor area (mm²) | 6.82 | 10.60 | 9.53 | 9.53
Insulated fill | 0.513 | 0.512 | 0.493 | 0.493
Mean turn length (mm) | 203.6 | 285.1 | 280.5 | 280.3
Resistance per path, 100 °C (mΩ) | 13.48 | 16.08 | 17.60 | 19.79
Peak torque, 1000 rpm (N·m) | 44.11 | 44.59 | 43.98 | 47.50
Worst envelope ratio vs copper | – | 99.5 % | 98.9 % | 99.2 %
Winding loss at peak torque (W) | 885 | 1044 | 1142 | 1281
Current density at peak (A/mm² rms) | 15.2 | 9.8 | 10.9 | 10.9
Peak efficiency (%) | 95.36 | 95.02 | 94.91 | 94.87
Map efficiency, mean change (points) | – | −1.20 | −1.57 | −1.46
Telematics: Wh/km at motor terminals | 61.291 | 62.431 | 62.460 | 62.933
Range change, telematics | – | −1.83 % | −1.87 % | −2.61 %
Range change, WMTC Class 1 | – | −2.21 % | −2.29 % | −2.39 %
Winding mass (kg) | 1.488 | 0.785 | 0.693 | 0.780
Stator laminations (kg) | 3.635 | 4.738 | 4.781 | 4.491
Rotor laminations + magnets (kg) | 2.832 | 3.540 | 3.451 | 3.451
Active mass (kg) | 7.955 | 9.063 | 8.926 | 8.722
Material cost (INR) | 4349 | 3651 | 3580 | 3527
Saving vs copper (INR) | – | 698 (16.1 %) | 769 (17.7 %) | 822 (18.9 %)

### Torque-speed envelope

Maximum shaft torque at each speed against copper, same drive limits. Right: ratio to copp

Maximum shaft torque at each speed against copper, same drive limits. Right: ratio to copper; dotted lines 99 % and 97 %.

### Efficiency maps against copper

Efficiency change against copper at the same speed and shaft torque (blue = aluminium bett

Efficiency change against copper at the same speed and shaft torque (blue = aluminium better). Triangles: OP1–OP3.

Efficiency map of B3 L78 N9 6x1.42.

Efficiency map of B3 L78 N9 6x1.42.

### Operating points OP1, OP2, OP3

Efficiency change vs copper (points) | Least range loss | Largest saving within 2.0 % range, ≤ 3 % high-speed torque | Largest saving, full torque
OP1: 9000 rpm, maximum power | +2.03 | +1.91 | +1.23
OP2: 9339 rpm, 3.24 N·m | −0.59 | −0.42 | −1.15
OP3: 2000 rpm, maximum torque | −1.15 | −2.05 | −2.45

Loss breakdown at the operating points; label = total loss and efficiency.

Loss breakdown at the operating points; label = total loss and efficiency.

OP1 · 9000 rpm, maximum power | Motor-CAD, copper | Copper (FEMM) | Least range loss | Largest saving within 2.0 % range, ≤ 3 % high-speed torque | Largest saving, full torque
Shaft torque (N·m) | 13.98 | 14.05 | 14.33 | 14.32 | 14.24
Electromagnetic torque (N·m) | 14.46 | 14.50 | 14.84 | 14.81 | 14.76
Shaft power (W) | 13178 | 13239 | 13510 | 13501 | 13423
Input power (W) | 14560 | 14552 | 14527 | 14535 | 14558
Efficiency (%) | 90.51 | 90.97 | 93.00 | 92.88 | 92.20
Line current (A rms) | 247.2 | 236.3 | 240.8 | 241.5 | 240.8
Phase current (A rms, delta) | 142.7 | 136.4 | 139.0 | 139.4 | 139.0
Id, phase (A peak) | −184.2 | −173.3 | −176.0 | −175.7 | −179.3
Iq, phase (A peak) | 82.5 | 84.7 | 87.5 | 89.5 | 80.5
Phase advance (° el) | 65.9 | 63.9 | 63.6 | 63.0 | 65.8
Phase voltage (V peak, limit 49.4) | 49.40 | 49.38 | 49.25 | 49.13 | 49.15
Power factor | 0.974 | 0.983 | 0.995 | 0.996 | 0.999
ψd (mV·s) | 1.72 | 2.68 | 5.39 | 5.37 | 3.79
ψq (mV·s) | 9.69 | 9.85 | 8.56 | 8.51 | 9.27
DC bus current (A) | 280.0 | 279.9 | 279.4 | 279.5 | 280.0
Current density (A/mm² rms) | – | 10.0 | 6.6 | 7.3 | 7.3
Active limit | – | voltage, DC current | voltage | voltage, DC current | voltage, DC current
DC winding loss (W) | 411.7 | 376.2 | 466.0 | 513.2 | 573.4
AC winding loss (W) | 526.5 | 505.5 | 74.3 | 60.6 | 73.9
Stator hysteresis (W) | – | 71.6 | 87.3 | 82.6 | 87.3
Stator eddy (W) | – | 125.7 | 151.9 | 143.2 | 154.5
Stator iron total (W) | 205.3 | 197.4 | 239.3 | 225.8 | 241.7
Rotor iron (W) | 89.4 | 85.7 | 77.2 | 76.5 | 87.6
Iron total (W) | 294.7 | 283.1 | 316.5 | 302.3 | 329.3
Bearings + windage (W) | 148.9 | 148.9 | 160.0 | 158.6 | 158.6
Total loss (W) | 1381.8 | 1313.6 | 1016.8 | 1034.7 | 1135.2

OP2 · 9339 rpm, 3.24 N·m | Copper (FEMM) | Least range loss | Largest saving within 2.0 % range, ≤ 3 % high-speed torque | Largest saving, full torque
Shaft torque (N·m) | 3.27 | 3.27 | 3.25 | 3.25
Electromagnetic torque (N·m) | 3.62 | 3.69 | 3.66 | 3.67
Shaft power (W) | 3195 | 3194 | 3180 | 3179
Input power (W) | 3785 | 3811 | 3786 | 3819
Efficiency (%) | 84.41 | 83.81 | 83.99 | 83.25
Line current (A rms) | 120.7 | 144.8 | 142.5 | 141.8
Phase current (A rms, delta) | 69.7 | 83.6 | 82.3 | 81.8
Id, phase (A peak) | −96.2 | −116.1 | −114.1 | −113.9
Iq, phase (A peak) | 21.8 | 22.3 | 22.7 | 20.3
Phase advance (° el) | 77.2 | 79.1 | 78.8 | 79.9
Phase voltage (V peak, limit 49.4) | 49.22 | 49.34 | 49.18 | 49.23
Power factor | 0.499 | 0.432 | 0.438 | 0.443
ψd (mV·s) | 9.59 | 9.72 | 9.69 | 9.63
ψq (mV·s) | 2.84 | 2.38 | 2.36 | 2.58
DC bus current (A) | 72.8 | 73.3 | 72.8 | 73.4
Current density (A/mm² rms) | 5.1 | 3.9 | 4.3 | 4.3
Active limit | voltage | voltage | voltage | voltage
DC winding loss (W) | 98.3 | 168.5 | 178.7 | 198.8
AC winding loss (W) | 150.4 | 30.1 | 23.7 | 28.6
Stator hysteresis (W) | 54.2 | 75.3 | 71.1 | 72.8
Stator eddy (W) | 99.6 | 136.7 | 129.1 | 133.3
Stator iron total (W) | 153.8 | 212.0 | 200.3 | 206.1
Rotor iron (W) | 31.6 | 38.4 | 37.2 | 39.5
Iron total (W) | 185.4 | 250.4 | 237.5 | 245.7
Bearings + windage (W) | 156.2 | 167.9 | 166.4 | 166.4
Total loss (W) | 590.2 | 616.8 | 606.3 | 639.5

OP3 · 2000 rpm, maximum torque | Motor-CAD, copper | Copper (FEMM) | Least range loss | Largest saving within 2.0 % range, ≤ 3 % high-speed torque | Largest saving, full torque
Shaft torque (N·m) | 44.11 | 44.06 | 44.51 | 43.89 | 47.44
Electromagnetic torque (N·m) | 44.76 | 44.67 | 45.23 | 44.58 | 48.20
Shaft power (W) | 9239 | 9227 | 9321 | 9192 | 9936
Input power (W) | 10306 | 10284 | 10523 | 10483 | 11385
Efficiency (%) | 89.65 | 89.73 | 88.58 | 87.68 | 87.27
Line current (A rms) | 360.0 | 360.0 | 360.0 | 360.0 | 360.0
Phase current (A rms, delta) | 207.8 | 207.8 | 207.8 | 207.8 | 207.8
Id, phase (A peak) | −85.0 | −90.8 | −86.2 | −82.6 | −92.7
Iq, phase (A peak) | 281.4 | 279.6 | 281.0 | 282.1 | 279.0
Phase advance (° el) | 16.8 | 18.0 | 17.1 | 16.3 | 18.4
Phase voltage (V peak, limit 49.4) | 34.36 | 33.85 | 31.57 | 31.40 | 35.27
Power factor | 0.680 | 0.685 | 0.756 | 0.757 | 0.732
ψd (mV·s) | 12.48 | 12.00 | 13.82 | 13.90 | 13.51
ψq (mV·s) | 28.90 | 28.65 | 24.90 | 24.49 | 28.69
DC bus current (A) | 198.2 | 197.8 | 202.4 | 201.6 | 218.9
Current density (A/mm² rms) | – | 15.2 | 9.8 | 10.9 | 10.9
Active limit | – | 360 A | 360 A | 360 A | 360 A
DC winding loss (W) | 873.5 | 873.5 | 1042.0 | 1140.4 | 1282.1
AC winding loss (W) | 57.4 | 54.7 | 7.7 | 6.4 | 7.6
Stator hysteresis (W) | – | 61.2 | 79.5 | 73.9 | 82.5
Stator eddy (W) | – | 20.4 | 25.1 | 23.4 | 26.6
Stator iron total (W) | 87.4 | 81.5 | 104.6 | 97.3 | 109.1
Rotor iron (W) | 27.7 | 25.9 | 25.2 | 25.0 | 27.5
Iron total (W) | 115.1 | 107.4 | 129.8 | 122.3 | 136.6
Bearings + windage (W) | 21.1 | 21.1 | 22.6 | 22.4 | 22.4
Total loss (W) | 1067.1 | 1056.6 | 1202.2 | 1291.6 | 1448.8

### Drive cycle and range

Design | Cycle | Net Wh/km | Shaft out, motoring | Electrical in, motoring | η motoring (%) | Shaft in, regen | Electrical out, regen | η regen (%) | DC winding loss | AC winding loss | Iron loss | Mech. loss | Total loss | Range change
Copper | Telematics | 61.291 | 81.53 | 87.83 | 92.82 | 28.55 | 26.54 | 92.97 | 2.82 | 0.84 | 3.04 | 1.61 | 8.32 | –
| WMTC Class 1 | 60.520 | 76.21 | 81.72 | 93.26 | 22.91 | 21.20 | 92.55 | 2.13 | 0.40 | 3.10 | 1.59 | 7.22 | –
Least range loss | Telematics | 62.431 | 81.69 | 88.74 | 92.05 | 28.57 | 26.31 | 92.09 | 3.40 | 0.12 | 4.07 | 1.73 | 9.32 | −1.83 %
| WMTC Class 1 | 61.889 | 76.21 | 82.75 | 92.10 | 22.91 | 20.86 | 91.06 | 2.64 | 0.06 | 4.18 | 1.71 | 8.59 | −2.21 %
Largest saving within 2.0 % range, ≤ 3 % high-speed torque | Telematics | 62.460 | 81.61 | 88.73 | 91.98 | 28.57 | 26.27 | 91.96 | 3.77 | 0.10 | 3.83 | 1.72 | 9.42 | −1.87 %
| WMTC Class 1 | 61.939 | 76.21 | 82.78 | 92.07 | 22.91 | 20.84 | 90.95 | 2.97 | 0.05 | 3.92 | 1.69 | 8.64 | −2.29 %
Largest saving, full torque | Telematics | 62.933 | 81.75 | 89.15 | 91.70 | 28.56 | 26.22 | 91.81 | 3.98 | 0.12 | 3.93 | 1.72 | 9.74 | −2.61 %
| WMTC Class 1 | 61.999 | 76.21 | 82.84 | 92.00 | 22.91 | 20.84 | 90.94 | 2.90 | 0.06 | 4.06 | 1.69 | 8.70 | −2.39 %

Energies and losses in Wh/km at the motor (motor losses only; inverter, battery and vehicle are the same for every design).

Motor losses over the telematics cycle by type.

Motor losses over the telematics cycle by type.

Where the range is lost: extra loss against copper over the telematics cycle, by motor spe

Where the range is lost: extra loss against copper over the telematics cycle, by motor speed band, motoring (left) and regenerating (right).

### Cost

Design | Winding (kg) | Wire (INR) | Laminations (kg) | Laminations (INR) | Magnets (kg) | Magnets (INR) | Total (INR) | Saving, Al ₹370 | Saving, Al ₹230 | Saving, Al ₹450
Copper | 1.488 | 1719 | 5.087 | 1526 | 1.380 | 1104 | 4349 | – | – | –
Least range loss | 0.785 | 305 | 6.553 | 1966 | 1.725 | 1380 | 3651 | 698 | 814 | 632
Largest saving within 2.0 % range, ≤ 3 % high-speed torque | 0.693 | 269 | 6.550 | 1965 | 1.682 | 1346 | 3580 | 769 | 871 | 711
Largest saving, full torque | 0.780 | 303 | 6.261 | 1878 | 1.682 | 1346 | 3527 | 822 | 937 | 757

Design9795 · aluminium winding · Al end-winding multiplier 1.136

## OD 167 mm

The housing limit. With the copper yoke and tooth the slot is 3.5 mm deeper (×1.281); with a 1 mm thinner yoke 4.5 mm deeper (×1.365). This OD gives the best designs at every cost level. 1008 designs evaluated at this OD; 215 keep full torque at every speed, 563 stay within 3 %.

### Stator variants at OD 167

Stator | OD | Slot depth | Tooth | Yoke | Slot area (mm²) | vs copper | Max torque (N·m)* | vs copper | Tooth B 99 % (T) | Yoke B 99 % (T) | Stator steel (kg)*
D0 | 160 | 17.65 | 15.54 | 8.85 | 281.2 | ×1.000 | 50.62 | +0.0 % | 2.28 | 1.70 | 3.635
F1 | 167 | 21.15 | 15.54 | 8.85 | 360.2 | ×1.281 | 50.31 | −0.6 % | 2.28 | 1.70 | 4.038
F2 | 167 | 22.15 | 15.54 | 7.85 | 383.8 | ×1.365 | 49.58 | −2.1 % | 2.27 | 1.78 | 3.903
F3 | 167 | 22.15 | 14.54 | 7.85 | 403.3 | ×1.434 | 48.67 | −3.9 % | 2.26 | 1.76 | 3.792
F4 | 167 | 23.15 | 14.54 | 6.85 | 428.6 | ×1.524 | 47.25 | −6.6 % | 2.24 | 1.82 | 3.647

* FEMM 2D, 64 mm stack, 10 turns per coil, peak over the 4 × 4 current grid at 360 A (no skew). Dimensions in mm.

Slot outlines of the OD 167 stators against the copper stator (D0). Tooth tip and slot ope

Slot outlines of the OD 167 stators against the copper stator (D0). Tooth tip and slot opening are unchanged in every variant.

### Cost against range

All designs at OD 167. Dark: full torque at every speed; light blue: within 3 %; grey: nei

All designs at OD 167. Dark: full torque at every speed; light blue: within 3 %; grey: neither. Line: best designs (full). Circles: designs detailed below.

#### Best designs, full torque at every speed

Design | Stator | Yoke (mm) | Stack (mm) | Turns × (strands × d) | Worst envelope | Range, telematics | Range, WMTC | Saving (INR) | Winding loss at peak (W) | Mass change (kg)
F1 L78 N8 6x1.50 | F1 | 8.85 | 78 | 8 × (6 × 1.50) | 99.4 % | −1.54 % | −2.01 % | 696 | 1029 | +1.19
F1 L78 N8 4x1.83 | F1 | 8.85 | 78 | 8 × (4 × 1.83) | 99.3 % | −1.65 % | −2.09 % | 698 | 1039 | +1.18
F1 L78 N8 5x1.63 | F1 | 8.85 | 78 | 8 × (5 × 1.63) | 99.3 % | −1.66 % | −2.11 % | 702 | 1051 | +1.17
F4 L74 N9 4x1.90 | F4 | 6.85 | 74 | 9 × (4 × 1.90) | 99.2 % | −1.96 % | −2.38 % | 952 | 1055 | +0.44

#### Best designs, up to 3 % torque shortfall at high speed

Design | Stator | Yoke (mm) | Stack (mm) | Turns × (strands × d) | Worst envelope | Range, telematics | Range, WMTC | Saving (INR) | Winding loss at peak (W) | Mass change (kg)
F1 L78 N8 6x1.50 | F1 | 8.85 | 78 | 8 × (6 × 1.50) | 99.4 % | −1.54 % | −2.01 % | 696 | 1029 | +1.19
F1 L78 N8 4x1.83 | F1 | 8.85 | 78 | 8 × (4 × 1.83) | 99.3 % | −1.65 % | −2.09 % | 698 | 1039 | +1.18
F1 L78 N8 5x1.63 | F1 | 8.85 | 78 | 8 × (5 × 1.63) | 99.3 % | −1.66 % | −2.11 % | 702 | 1051 | +1.17
F2 L72 N9 5x1.60 | F2 | 7.85 | 72 | 9 × (5 × 1.60) | 98.8 % | −1.86 % | −2.10 % | 992 | 1170 | +0.41
F2 L72 N9 6x1.42 | F2 | 7.85 | 72 | 9 × (6 × 1.42) | 98.4 % | −2.11 % | −2.32 % | 1008 | 1233 | +0.37
F4 L68 N10 4x1.80 | F4 | 6.85 | 68 | 10 × (4 × 1.80) | 98.1 % | −2.20 % | −2.36 % | 1215 | 1246 | −0.21
F2 L66 N10 4x1.70 | F2 | 7.85 | 66 | 10 × (4 × 1.70) | 97.6 % | −2.21 % | −2.19 % | 1259 | 1376 | −0.25
F2 L66 N10 5x1.50 | F2 | 7.85 | 66 | 10 × (5 × 1.50) | 97.5 % | −2.32 % | −2.30 % | 1267 | 1413 | −0.27
F2 L66 N10 2x2.36 | F2 | 7.85 | 66 | 10 × (2 × 2.36) | 97.2 % | −2.63 % | −2.51 % | 1270 | 1430 | −0.28
F2 L66 N10 3x1.90 | F2 | 7.85 | 66 | 10 × (3 × 1.90) | 97.1 % | −2.64 % | −2.56 % | 1278 | 1469 | −0.30

At the copper stack of 64 mm, no design at this OD meets either criterion: aluminium at 64 mm loses torque either at low speed (fewer turns, 360 A limit) or above 2500 rpm (10 turns, higher resistance).

### Effect of stack length and turns

Best design (range) at each stack length and turn count at OD 167, among those within 3 %

Best design (range) at each stack length and turn count at OD 167, among those within 3 % of copper torque; filled dots also meet the full criterion. Fewer turns need a longer stack for the same torque at 360 A.

### Designs in detail

| Copper (today) | Least range loss | Alternative, 98.8 % torque at high speed | Recommended
Design | Cu SWG 11 | F1 L78 N8 6x1.50 | F2 L72 N9 5x1.60 | F4 L74 N9 4x1.90
Stator OD (mm) | 160 | 167 | 167 | 167
Stator variant | D0 | F1 | F2 | F4
Stack length, stator = rotor = magnets (mm) | 64 | 78 | 72 | 74
Slot depth (mm) | 17.65 | 21.15 | 22.15 | 23.15
Tooth width (mm) | 15.54 | 15.54 | 15.54 | 14.54
Yoke (mm) | 8.85 | 8.85 | 7.85 | 6.85
Slot area (mm²) | 281.2 (×1.000) | 360.2 (×1.281) | 383.8 (×1.365) | 428.6 (×1.524)
Turns per coil | 10 | 8 | 9 | 9
Strands × bare diameter (mm) | 1 × 2.95 | 6 × 1.50 | 5 × 1.60 | 4 × 1.90
Conductor area (mm²) | 6.82 | 10.60 | 10.05 | 11.34
Insulated fill | 0.513 | 0.511 | 0.510 | 0.511
Mean turn length (mm) | 203.6 | 281.2 | 269.8 | 273.7
Resistance per path, 100 °C (mΩ) | 13.48 | 15.86 | 18.06 | 16.23
Peak torque, 1000 rpm (N·m) | 44.11 | 43.91 | 44.44 | 43.94
Worst envelope ratio vs copper | – | 99.4 % | 98.8 % | 99.2 %
Winding loss at peak torque (W) | 885 | 1029 | 1170 | 1055
Current density at peak (A/mm² rms) | 15.2 | 9.8 | 10.3 | 9.2
Peak efficiency (%) | 95.36 | 95.05 | 94.91 | 94.90
Map efficiency, mean change (points) | – | −1.15 | −1.39 | −1.27
Telematics: Wh/km at motor terminals | 61.291 | 62.248 | 62.454 | 62.517
Range change, telematics | – | −1.54 % | −1.86 % | −1.96 %
Range change, WMTC Class 1 | – | −2.01 % | −2.10 % | −2.38 %
Winding mass (kg) | 1.488 | 0.774 | 0.792 | 0.906
Stator laminations (kg) | 3.635 | 4.921 | 4.391 | 4.217
Rotor laminations + magnets (kg) | 2.832 | 3.451 | 3.186 | 3.274
Active mass (kg) | 7.955 | 9.146 | 8.368 | 8.398
Material cost (INR) | 4349 | 3653 | 3357 | 3397
Saving vs copper (INR) | – | 696 (16.0 %) | 992 (22.8 %) | 952 (21.9 %)

### Torque-speed envelope

Maximum shaft torque at each speed against copper, same drive limits. Right: ratio to copp

Maximum shaft torque at each speed against copper, same drive limits. Right: ratio to copper; dotted lines 99 % and 97 %.

### Efficiency maps against copper

Efficiency change against copper at the same speed and shaft torque (blue = aluminium bett

Efficiency change against copper at the same speed and shaft torque (blue = aluminium better). Triangles: OP1–OP3.

Efficiency map of F4 L74 N9 4x1.90.

Efficiency map of F4 L74 N9 4x1.90.

### Operating points OP1, OP2, OP3

Efficiency change vs copper (points) | Least range loss | Alternative, 98.8 % torque at high speed | Recommended
OP1: 9000 rpm, maximum power | +2.15 | +1.50 | +1.47
OP2: 9339 rpm, 3.24 N·m | −0.11 | +0.33 | −0.34
OP3: 2000 rpm, maximum torque | −1.15 | −2.25 | −1.47

Loss breakdown at the operating points; label = total loss and efficiency.

Loss breakdown at the operating points; label = total loss and efficiency.

OP1 · 9000 rpm, maximum power | Motor-CAD, copper | Copper (FEMM) | Least range loss | Alternative, 98.8 % torque at high speed | Recommended
Shaft torque (N·m) | 13.98 | 14.05 | 14.35 | 14.29 | 14.25
Electromagnetic torque (N·m) | 14.46 | 14.50 | 14.84 | 14.79 | 14.78
Shaft power (W) | 13178 | 13239 | 13520 | 13464 | 13430
Input power (W) | 14560 | 14552 | 14519 | 14559 | 14528
Efficiency (%) | 90.51 | 90.97 | 93.12 | 92.48 | 92.44
Line current (A rms) | 247.2 | 236.3 | 240.8 | 240.8 | 238.5
Phase current (A rms, delta) | 142.7 | 136.4 | 139.0 | 139.0 | 137.7
Id, phase (A peak) | −184.2 | −173.3 | −174.9 | −176.9 | −175.2
Iq, phase (A peak) | 82.5 | 84.7 | 89.8 | 85.8 | 85.0
Phase advance (° el) | 65.9 | 63.9 | 62.8 | 64.1 | 64.1
Phase voltage (V peak, limit 49.4) | 49.40 | 49.38 | 49.16 | 49.22 | 49.36
Power factor | 0.974 | 0.983 | 0.997 | 0.996 | 0.998
ψd (mV·s) | 1.72 | 2.68 | 5.35 | 3.58 | 3.80
ψq (mV·s) | 9.69 | 9.85 | 8.57 | 9.41 | 9.40
DC bus current (A) | 280.0 | 279.9 | 279.2 | 280.0 | 279.4
Current density (A/mm² rms) | – | 10.0 | 6.6 | 6.9 | 6.1
Active limit | – | voltage, DC current | voltage | voltage, DC current | voltage
DC winding loss (W) | 411.7 | 376.2 | 459.5 | 523.2 | 461.6
AC winding loss (W) | 526.5 | 505.5 | 72.5 | 99.2 | 138.7
Stator hysteresis (W) | – | 71.6 | 84.8 | 85.6 | 93.8
Stator eddy (W) | – | 125.7 | 146.8 | 149.6 | 163.4
Stator iron total (W) | 205.3 | 197.4 | 231.5 | 235.2 | 257.3
Rotor iron (W) | 89.4 | 85.7 | 76.4 | 83.2 | 84.2
Iron total (W) | 294.7 | 283.1 | 307.9 | 318.3 | 341.4
Bearings + windage (W) | 148.9 | 148.9 | 158.6 | 154.4 | 155.8
Total loss (W) | 1381.8 | 1313.6 | 998.5 | 1095.2 | 1097.7

OP2 · 9339 rpm, 3.24 N·m | Copper (FEMM) | Least range loss | Alternative, 98.8 % torque at high speed | Recommended
Shaft torque (N·m) | 3.27 | 3.26 | 3.28 | 3.28
Electromagnetic torque (N·m) | 3.62 | 3.68 | 3.68 | 3.71
Shaft power (W) | 3195 | 3188 | 3209 | 3212
Input power (W) | 3785 | 3781 | 3787 | 3821
Efficiency (%) | 84.41 | 84.30 | 84.73 | 84.06
Line current (A rms) | 120.7 | 141.0 | 131.2 | 134.2
Phase current (A rms, delta) | 69.7 | 81.4 | 75.8 | 77.5
Id, phase (A peak) | −96.2 | −112.8 | −104.9 | −107.4
Iq, phase (A peak) | 21.8 | 22.8 | 21.9 | 21.7
Phase advance (° el) | 77.2 | 78.6 | 78.2 | 78.6
Phase voltage (V peak, limit 49.4) | 49.22 | 49.38 | 49.25 | 49.18
Power factor | 0.499 | 0.440 | 0.474 | 0.466
ψd (mV·s) | 9.59 | 9.73 | 9.62 | 9.61
ψq (mV·s) | 2.84 | 2.38 | 2.67 | 2.66
DC bus current (A) | 72.8 | 72.7 | 72.8 | 73.5
Current density (A/mm² rms) | 5.1 | 3.8 | 3.8 | 3.4
Active limit | voltage | voltage | voltage | voltage
DC winding loss (W) | 98.3 | 157.6 | 155.5 | 146.3
AC winding loss (W) | 150.4 | 27.8 | 33.1 | 49.2
Stator hysteresis (W) | 54.2 | 72.7 | 68.1 | 75.6
Stator eddy (W) | 99.6 | 132.1 | 124.5 | 137.9
Stator iron total (W) | 153.8 | 204.8 | 192.6 | 213.5
Rotor iron (W) | 31.6 | 37.1 | 35.0 | 36.3
Iron total (W) | 185.4 | 241.8 | 227.5 | 249.9
Bearings + windage (W) | 156.2 | 166.4 | 162.0 | 163.5
Total loss (W) | 590.2 | 593.7 | 578.2 | 608.8

OP3 · 2000 rpm, maximum torque | Motor-CAD, copper | Copper (FEMM) | Least range loss | Alternative, 98.8 % torque at high speed | Recommended
Shaft torque (N·m) | 44.11 | 44.06 | 43.81 | 44.39 | 43.86
Electromagnetic torque (N·m) | 44.76 | 44.67 | 44.52 | 45.11 | 44.61
Shaft power (W) | 9239 | 9227 | 9176 | 9296 | 9185
Input power (W) | 10306 | 10284 | 10359 | 10627 | 10408
Efficiency (%) | 89.65 | 89.73 | 88.58 | 87.47 | 88.25
Line current (A rms) | 360.0 | 360.0 | 360.0 | 360.0 | 360.0
Phase current (A rms, delta) | 207.8 | 207.8 | 207.8 | 207.8 | 207.8
Id, phase (A peak) | −85.0 | −90.8 | −82.6 | −92.7 | −99.9
Iq, phase (A peak) | 281.4 | 279.6 | 282.1 | 279.0 | 276.4
Phase advance (° el) | 16.8 | 18.0 | 16.3 | 18.4 | 19.9
Phase voltage (V peak, limit 49.4) | 34.36 | 33.85 | 31.25 | 33.26 | 32.26
Power factor | 0.680 | 0.685 | 0.751 | 0.724 | 0.731
ψd (mV·s) | 12.48 | 12.00 | 13.85 | 12.51 | 11.88
ψq (mV·s) | 28.90 | 28.65 | 24.58 | 27.24 | 26.66
DC bus current (A) | 198.2 | 197.8 | 199.2 | 204.4 | 200.1
Current density (A/mm² rms) | – | 15.2 | 9.8 | 10.3 | 9.2
Active limit | – | 360 A | 360 A | 360 A | 360 A
DC winding loss (W) | 873.5 | 873.5 | 1027.4 | 1170.0 | 1051.8
AC winding loss (W) | 57.4 | 54.7 | 7.7 | 10.1 | 13.7
Stator hysteresis (W) | – | 61.2 | 76.5 | 78.5 | 82.9
Stator eddy (W) | – | 20.4 | 24.3 | 25.3 | 26.6
Stator iron total (W) | 87.4 | 81.5 | 100.8 | 103.7 | 109.4
Rotor iron (W) | 27.7 | 25.9 | 25.0 | 25.4 | 25.5
Iron total (W) | 115.1 | 107.4 | 125.8 | 129.2 | 134.9
Bearings + windage (W) | 21.1 | 21.1 | 22.4 | 21.9 | 22.1
Total loss (W) | 1067.1 | 1056.6 | 1183.4 | 1331.1 | 1222.4

### Drive cycle and range

Design | Cycle | Net Wh/km | Shaft out, motoring | Electrical in, motoring | η motoring (%) | Shaft in, regen | Electrical out, regen | η regen (%) | DC winding loss | AC winding loss | Iron loss | Mech. loss | Total loss | Range change
Copper | Telematics | 61.291 | 81.53 | 87.83 | 92.82 | 28.55 | 26.54 | 92.97 | 2.82 | 0.84 | 3.04 | 1.61 | 8.32 | –
| WMTC Class 1 | 60.520 | 76.21 | 81.72 | 93.26 | 22.91 | 21.20 | 92.55 | 2.13 | 0.40 | 3.10 | 1.59 | 7.22 | –
Least range loss | Telematics | 62.248 | 81.65 | 88.59 | 92.17 | 28.57 | 26.34 | 92.20 | 3.40 | 0.12 | 3.94 | 1.72 | 9.17 | −1.54 %
| WMTC Class 1 | 61.760 | 76.21 | 82.65 | 92.21 | 22.91 | 20.89 | 91.18 | 2.68 | 0.06 | 4.03 | 1.69 | 8.46 | −2.01 %
Alternative, 98.8 % torque at high speed | Telematics | 62.454 | 81.57 | 88.73 | 91.94 | 28.56 | 26.27 | 92.00 | 3.79 | 0.16 | 3.82 | 1.67 | 9.44 | −1.86 %
| WMTC Class 1 | 61.821 | 76.21 | 82.69 | 92.17 | 22.91 | 20.86 | 91.07 | 2.88 | 0.07 | 3.92 | 1.65 | 8.52 | −2.10 %
Recommended | Telematics | 62.517 | 81.56 | 88.78 | 91.87 | 28.56 | 26.26 | 91.95 | 3.40 | 0.22 | 4.21 | 1.69 | 9.52 | −1.96 %
| WMTC Class 1 | 61.993 | 76.21 | 82.83 | 92.01 | 22.91 | 20.84 | 90.96 | 2.58 | 0.10 | 4.35 | 1.66 | 8.69 | −2.38 %

Energies and losses in Wh/km at the motor (motor losses only; inverter, battery and vehicle are the same for every design).

Motor losses over the telematics cycle by type.

Motor losses over the telematics cycle by type.

Where the range is lost: extra loss against copper over the telematics cycle, by motor spe

Where the range is lost: extra loss against copper over the telematics cycle, by motor speed band, motoring (left) and regenerating (right).

### Cost

Design | Winding (kg) | Wire (INR) | Laminations (kg) | Laminations (INR) | Magnets (kg) | Magnets (INR) | Total (INR) | Saving, Al ₹370 | Saving, Al ₹230 | Saving, Al ₹450
Copper | 1.488 | 1719 | 5.087 | 1526 | 1.380 | 1104 | 4349 | – | – | –
Least range loss | 0.774 | 301 | 6.691 | 2007 | 1.682 | 1346 | 3653 | 696 | 810 | 631
Alternative, 98.8 % torque at high speed | 0.792 | 308 | 6.024 | 1807 | 1.553 | 1242 | 3357 | 992 | 1109 | 926
Recommended | 0.906 | 352 | 5.896 | 1769 | 1.596 | 1277 | 3397 | 952 | 1085 | 876

Design9795 · aluminium winding · Al end-winding multiplier 1.136

## Comparison across ODs

A larger OD moves the whole cost-range front up and to the right: each mm of OD adds 0.5 mm of slot depth (about 11 mm² per slot) for about 0.06 kg (₹18) of stator steel. That is cheaper than adding stack length, which also lengthens the rotor and magnets.

Left: least range loss at each OD. Right: largest saving at each OD, overall and within 1.

Left: least range loss at each OD. Right: largest saving at each OD, overall and within 1.5 % / 2 % range loss.

OD | Criterion | Choice | Design | Range, telematics | Range, WMTC | Saving (INR) | Winding loss at peak (W) | Mass change (kg)
160 | full | least range loss | A5 L82 N8 4x1.80 | −2.36 % | −2.74 % | 819 | 1094 | +0.64
160 | full | largest saving | A5 L82 N8 5x1.60 | −2.38 % | −2.77 % | 823 | 1107 | +0.63
160 | relaxed | least range loss | A4 L80 N8 6x1.40 | −2.26 % | −2.63 % | 879 | 1186 | +0.54
160 | relaxed | largest saving | A5 L70 N10 5x1.42 | −3.16 % | −2.87 % | 1324 | 1604 | −0.59
163 | full | least range loss | G3 L80 N8 4x1.83 | −1.96 % | −2.40 % | 782 | 1048 | +0.83
163 | full | within 2 % | G3 L80 N8 5x1.63 | −1.97 % | −2.43 % | 786 | 1060 | +0.82
163 | full | largest saving | G3 L78 N9 6x1.40 | −2.60 % | −2.35 % | 871 | 1319 | +0.61
163 | relaxed | least range loss | G1 L78 N8 6x1.40 | −1.87 % | −2.25 % | 820 | 1175 | +0.81
163 | relaxed | within 2 % | G1 L78 N8 6x1.40 | −1.87 % | −2.25 % | 820 | 1175 | +0.81
163 | relaxed | largest saving | G3 L68 N10 6x1.32 | −2.73 % | −2.54 % | 1304 | 1530 | −0.45
165 | full | least range loss | B2 L80 N8 6x1.50 | −1.83 % | −2.21 % | 698 | 1044 | +1.11
165 | full | within 2 % | B3 L80 N8 6x1.50 | −2.00 % | −2.52 % | 739 | 1040 | +0.97
165 | full | largest saving | B3 L78 N9 6x1.42 | −2.61 % | −2.39 % | 822 | 1281 | +0.77
165 | relaxed | least range loss | B2 L80 N8 6x1.50 | −1.83 % | −2.21 % | 698 | 1044 | +1.11
165 | relaxed | within 2 % | B1 L78 N8 6x1.42 | −1.87 % | −2.29 % | 769 | 1142 | +0.97
165 | relaxed | largest saving | B3 L66 N10 2x2.36 | −2.60 % | −2.62 % | 1339 | 1421 | −0.51
167 | full | least range loss | F1 L78 N8 6x1.50 | −1.54 % | −2.01 % | 696 | 1029 | +1.19
167 | full | within 2 % | F4 L74 N9 4x1.90 | −1.96 % | −2.38 % | 952 | 1055 | +0.44
167 | full | largest saving | F4 L74 N9 4x1.90 | −1.96 % | −2.38 % | 952 | 1055 | +0.44
167 | relaxed | least range loss | F1 L78 N8 6x1.50 | −1.54 % | −2.01 % | 696 | 1029 | +1.19
167 | relaxed | within 2 % | F2 L72 N9 5x1.60 | −1.86 % | −2.10 % | 992 | 1170 | +0.41
167 | relaxed | largest saving | F2 L66 N10 3x1.90 | −2.64 % | −2.56 % | 1278 | 1469 | −0.30

### Efficiency maps of the key designs at each OD

OD 160: efficiency change against copper.

OD 163: efficiency change against copper.

OD 165: efficiency change against copper.

OD 167: efficiency change against copper.

### What each lever does

Change | Gain | Cost
OD +1 mm (yoke and tooth kept) | Slot +0.5 mm deep, +11 mm²; torque per amp −0.1 % | +0.06 kg stator steel (₹18); new die and housing bore
Yoke −1 mm | Slot +1 mm deep, +22 mm² | Peak torque −1.3 % (yoke B 1.70 → 1.78 T)
Tooth −1 mm | Slot +15 mm² | Peak torque −1.9 %; tooth saturates earlier
Stack +2 mm | Torque and flux +3 %; resistance per N·m falls | +₹83 to ₹86 stator steel, rotor laminations and magnets; iron loss and windage +3 %
10 → 9 → 8 turns per coil | Lower resistance per path (−19 % / −36 %), wider wire | Needs about 11 % / 25 % longer stack for the same torque at 360 A
More strands of thinner wire | AC loss at high speed falls steeply (∝ d²) | Wire cost about the same; more strands to handle in winding

Design9795 · aluminium winding · Al end-winding multiplier 1.136

## Drive cycle and range

Range is computed from energy per km at the motor terminals over two speed traces: the telematics log supplied earlier and WMTC Class 1. Range change = copper Wh/km ÷ aluminium Wh/km − 1, counting motor losses only.

Top: motor speed over the two cycles (the telematics log includes long stops). Bottom: tim

Top: motor speed over the two cycles (the telematics log includes long stops). Bottom: time spent at each operating point, over the copper efficiency map (grey).

### Vehicle and method

- Vehicle (given): GVW 757 kg, CdA 1.117 m², wheel radius 0.30 m, gear ratio 13.9. Assumed: rolling resistance 0.015, gearbox efficiency 0.95, rotating-mass factor 1.05, flat road.
- Motor torque from road load and acceleration at each 1 s step; regenerative braking down to −26.4 N·m (largest regen torque in the log), friction brakes beyond.
- Telematics: 10.75 km, 6363 steps (logging gaps skipped), motor up to 6908 rpm, 18 % of steps motoring. WMTC Class 1: 7.67 km, up to 6139 rpm.
- The logged motor torque is negative even at cruise, so energy is computed from the speed trace through the vehicle model, not from the logged torque.
- Losses are read from each design's own loss map (MTPA) at the cycle's speed and torque; points above a design's torque limit are held at the limit.
- Inverter, battery and vehicle are the same for every design, so the battery-level range change is about the motor-level change.

### All key designs

Design | Cycle | Net Wh/km | Shaft out, motoring | Electrical in, motoring | η motoring (%) | Shaft in, regen | Electrical out, regen | η regen (%) | DC winding loss | AC winding loss | Iron loss | Mech. loss | Total loss | Range change
Copper | Telematics | 61.291 | 81.53 | 87.83 | 92.82 | 28.55 | 26.54 | 92.97 | 2.82 | 0.84 | 3.04 | 1.61 | 8.32 | –
| WMTC Class 1 | 60.520 | 76.21 | 81.72 | 93.26 | 22.91 | 21.20 | 92.55 | 2.13 | 0.40 | 3.10 | 1.59 | 7.22 | –
A5 L70 N10 5x1.42 | Telematics | 63.294 | 81.40 | 89.31 | 91.15 | 28.52 | 26.02 | 91.22 | 5.05 | 0.13 | 3.58 | 1.66 | 10.41 | −3.16 %
| WMTC Class 1 | 62.311 | 76.21 | 83.05 | 91.77 | 22.91 | 20.74 | 90.51 | 3.64 | 0.06 | 3.68 | 1.63 | 9.01 | −2.87 %
A5 L82 N8 5x1.60 | Telematics | 62.785 | 81.63 | 89.00 | 91.72 | 28.57 | 26.21 | 91.76 | 3.60 | 0.12 | 4.25 | 1.75 | 9.72 | −2.38 %
| WMTC Class 1 | 62.243 | 76.21 | 83.02 | 91.80 | 22.91 | 20.78 | 90.70 | 2.79 | 0.06 | 4.37 | 1.72 | 8.94 | −2.77 %
drop-in (SWG 11, 64 mm) | Telematics | 63.574 | 81.14 | 89.41 | 90.75 | 28.50 | 25.83 | 90.64 | 5.79 | 0.52 | 3.02 | 1.61 | 10.94 | −3.59 %
| WMTC Class 1 | 62.589 | 76.21 | 83.23 | 91.57 | 22.91 | 20.64 | 90.08 | 4.37 | 0.24 | 3.08 | 1.59 | 9.29 | −3.31 %
G1 L78 N8 6x1.40 | Telematics | 62.457 | 81.61 | 88.72 | 91.98 | 28.57 | 26.27 | 91.95 | 3.87 | 0.10 | 3.73 | 1.72 | 9.42 | −1.87 %
| WMTC Class 1 | 61.914 | 76.21 | 82.75 | 92.09 | 22.91 | 20.84 | 90.96 | 3.06 | 0.05 | 3.82 | 1.69 | 8.61 | −2.25 %
G3 L78 N9 6x1.40 | Telematics | 62.926 | 81.74 | 89.14 | 91.70 | 28.55 | 26.21 | 91.80 | 4.08 | 0.12 | 3.83 | 1.72 | 9.74 | −2.60 %
| WMTC Class 1 | 61.975 | 76.21 | 82.81 | 92.03 | 22.91 | 20.84 | 90.96 | 2.98 | 0.05 | 3.95 | 1.69 | 8.67 | −2.35 %
G3 L80 N8 4x1.83 | Telematics | 62.515 | 81.63 | 88.79 | 91.94 | 28.57 | 26.27 | 91.97 | 3.43 | 0.16 | 4.12 | 1.73 | 9.45 | −1.96 %
| WMTC Class 1 | 62.010 | 76.21 | 82.85 | 91.99 | 22.91 | 20.84 | 90.95 | 2.69 | 0.08 | 4.24 | 1.71 | 8.71 | −2.40 %
B1 L78 N8 6x1.42 | Telematics | 62.460 | 81.61 | 88.73 | 91.98 | 28.57 | 26.27 | 91.96 | 3.77 | 0.10 | 3.83 | 1.72 | 9.42 | −1.87 %
| WMTC Class 1 | 61.939 | 76.21 | 82.78 | 92.07 | 22.91 | 20.84 | 90.95 | 2.97 | 0.05 | 3.92 | 1.69 | 8.64 | −2.29 %
B2 L80 N8 6x1.50 | Telematics | 62.431 | 81.69 | 88.74 | 92.05 | 28.57 | 26.31 | 92.09 | 3.40 | 0.12 | 4.07 | 1.73 | 9.32 | −1.83 %
| WMTC Class 1 | 61.889 | 76.21 | 82.75 | 92.10 | 22.91 | 20.86 | 91.06 | 2.64 | 0.06 | 4.18 | 1.71 | 8.59 | −2.21 %
B3 L78 N9 6x1.42 | Telematics | 62.933 | 81.75 | 89.15 | 91.70 | 28.56 | 26.22 | 91.81 | 3.98 | 0.12 | 3.93 | 1.72 | 9.74 | −2.61 %
| WMTC Class 1 | 61.999 | 76.21 | 82.84 | 92.00 | 22.91 | 20.84 | 90.94 | 2.90 | 0.06 | 4.06 | 1.69 | 8.70 | −2.39 %
F1 L78 N8 6x1.50 | Telematics | 62.248 | 81.65 | 88.59 | 92.17 | 28.57 | 26.34 | 92.20 | 3.40 | 0.12 | 3.94 | 1.72 | 9.17 | −1.54 %
| WMTC Class 1 | 61.760 | 76.21 | 82.65 | 92.21 | 22.91 | 20.89 | 91.18 | 2.68 | 0.06 | 4.03 | 1.69 | 8.46 | −2.01 %
F2 L72 N9 5x1.60 | Telematics | 62.454 | 81.57 | 88.73 | 91.94 | 28.56 | 26.27 | 92.00 | 3.79 | 0.16 | 3.82 | 1.67 | 9.44 | −1.86 %
| WMTC Class 1 | 61.821 | 76.21 | 82.69 | 92.17 | 22.91 | 20.86 | 91.07 | 2.88 | 0.07 | 3.92 | 1.65 | 8.52 | −2.10 %
F4 L74 N9 4x1.90 | Telematics | 62.517 | 81.56 | 88.78 | 91.87 | 28.56 | 26.26 | 91.95 | 3.40 | 0.22 | 4.21 | 1.69 | 9.52 | −1.96 %
| WMTC Class 1 | 61.993 | 76.21 | 82.83 | 92.01 | 22.91 | 20.84 | 90.96 | 2.58 | 0.10 | 4.35 | 1.66 | 8.69 | −2.38 %

Energies and losses in Wh/km at the motor (motor losses only; inverter, battery and vehicle are the same for every design).

### Where the range goes

Motor losses over the telematics cycle by type.

Motor losses over the telematics cycle by type.

Extra loss against copper by speed band, motoring and regenerating, telematics cycle.

Extra loss against copper by speed band, motoring and regenerating, telematics cycle.

Same for WMTC Class 1.

Same for WMTC Class 1.

- The cycles run mostly at light and medium torque below 6000 rpm. There, aluminium's higher DC resistance and the longer stacks' extra iron loss outweigh its lower AC loss.
- Copper's AC winding loss over the telematics cycle is 0.84 Wh/km; aluminium's thin strands cut it to 0.22 Wh/km (recommended), but its DC loss rises from 2.82 to 3.40 Wh/km and iron loss from 3.04 to 4.21 Wh/km.
- Each 1 % of range is about 0.61 Wh/km at the motor. Battery capacity was not given, so the battery cost of making up the range is not included.

Design9795 · aluminium winding · Al end-winding multiplier 1.136

## Cost

Active-material cost per motor, at the prices given: copper wire ₹1100/kg, ferrite magnets ₹800/kg, M235-35A laminations ₹300/kg; aluminium wire ₹370/kg (copper ÷ 3.0, from Indian enamelled-wire prices).

Design | Winding (kg) | Wire (INR) | Laminations (kg) | Laminations (INR) | Magnets (kg) | Magnets (INR) | Total (INR) | Saving, Al ₹370 | Saving, Al ₹230 | Saving, Al ₹450
Copper | 1.488 | 1719 | 5.087 | 1526 | 1.380 | 1104 | 4349 | – | – | –
A5 L70 N10 5x1.42 | 0.678 | 263 | 5.181 | 1554 | 1.510 | 1208 | 3025 | 1324 | 1423 | 1267
A5 L82 N8 5x1.60 | 0.749 | 291 | 6.069 | 1821 | 1.768 | 1415 | 3527 | 823 | 933 | 760
drop-in (SWG 11, 64 mm) | 0.555 | 215 | 5.087 | 1526 | 1.380 | 1104 | 2846 | 1504 | 1585 | 1457
G1 L78 N8 6x1.40 | 0.671 | 261 | 6.410 | 1923 | 1.682 | 1346 | 3529 | 820 | 919 | 764
G3 L78 N9 6x1.40 | 0.754 | 293 | 6.131 | 1839 | 1.682 | 1346 | 3478 | 871 | 982 | 808
G3 L80 N8 4x1.83 | 0.773 | 300 | 6.288 | 1886 | 1.725 | 1380 | 3567 | 782 | 896 | 717
B1 L78 N8 6x1.42 | 0.693 | 269 | 6.550 | 1965 | 1.682 | 1346 | 3580 | 769 | 871 | 711
B2 L80 N8 6x1.50 | 0.785 | 305 | 6.553 | 1966 | 1.725 | 1380 | 3651 | 698 | 814 | 632
B3 L78 N9 6x1.42 | 0.780 | 303 | 6.261 | 1878 | 1.682 | 1346 | 3527 | 822 | 937 | 757
F1 L78 N8 6x1.50 | 0.774 | 301 | 6.691 | 2007 | 1.682 | 1346 | 3653 | 696 | 810 | 631
F2 L72 N9 5x1.60 | 0.792 | 308 | 6.024 | 1807 | 1.553 | 1242 | 3357 | 992 | 1109 | 926
F4 L74 N9 4x1.90 | 0.906 | 352 | 5.896 | 1769 | 1.596 | 1277 | 3397 | 952 | 1085 | 876

- Aluminium wire is about 10 % of the recommended motor's material cost, so its price moves the saving by only about ±₹100 between ₹230 and ₹450/kg. The ranking of the designs does not change.
- Longer stacks add stator steel, rotor laminations and magnets: about ₹41–43 per mm of stack. A larger OD adds only stator steel, about ₹18 per mm of OD.
- Lamination cost is on net mass (stator + rotor). The larger blank at OD 167 (gross 12.77 → 16.06 kg for the recommended design) is not included, nor are the die, housing, terminations and winding process.
- Copper's active-material cost is ₹4349: wire ₹1719, laminations ₹1526, magnets ₹1104.

Design9795 · aluminium winding · Al end-winding multiplier 1.136

## Recommended design: changes

Stator F4 (OD 167, yoke 6.85 mm, slot 23.15 mm deep, tooth 14.54 mm), 74 mm stack, 9 turns × 4 × 1.90 mm Al: −₹952 per motor, range -1.96 % (telematics) / -2.38 % (WMTC), torque within 0.8 % of copper at every speed.

| Copper (today) | Recommended
Design | Cu SWG 11 | F4 L74 N9 4x1.90
Stator OD (mm) | 160 | 167
Stator variant | D0 | F4
Stack length, stator = rotor = magnets (mm) | 64 | 74
Slot depth (mm) | 17.65 | 23.15
Tooth width (mm) | 15.54 | 14.54
Yoke (mm) | 8.85 | 6.85
Slot area (mm²) | 281.2 (×1.000) | 428.6 (×1.524)
Turns per coil | 10 | 9
Strands × bare diameter (mm) | 1 × 2.95 | 4 × 1.90
Conductor area (mm²) | 6.82 | 11.34
Insulated fill | 0.513 | 0.511
Mean turn length (mm) | 203.6 | 273.7
Resistance per path, 100 °C (mΩ) | 13.48 | 16.23
Peak torque, 1000 rpm (N·m) | 44.11 | 43.94
Worst envelope ratio vs copper | – | 99.2 %
Winding loss at peak torque (W) | 885 | 1055
Current density at peak (A/mm² rms) | 15.2 | 9.2
Peak efficiency (%) | 95.36 | 94.90
Map efficiency, mean change (points) | – | −1.27
Telematics: Wh/km at motor terminals | 61.291 | 62.517
Range change, telematics | – | −1.96 %
Range change, WMTC Class 1 | – | −2.38 %
Winding mass (kg) | 1.488 | 0.906
Stator laminations (kg) | 3.635 | 4.217
Rotor laminations + magnets (kg) | 2.832 | 3.274
Active mass (kg) | 7.955 | 8.398
Material cost (INR) | 4349 | 3397
Saving vs copper (INR) | – | 952 (21.9 %)

Stator lamination

OD 160 → 167 mm. Slot depth 17.65 → 23.15 mm (slot bottom radius 71.15 → 76.65 mm). Yoke 8.85 → 6.85 mm. Tooth 15.54 → 14.54 mm. Unchanged: bore 107 mm, 12 slots, tooth tip, slot opening, slot-bottom corner radius, M235-35A 0.35 mm. Slot area 281.2 → 428.6 mm². New lamination die and housing bore.

Stack length

64 → 74 mm for stator, rotor laminations and magnets (same cross-sections). Shaft, bearing span and housing +10 mm.

Winding

Aluminium EC-1350, grade-2 enamel, 4 strands in hand × 1.90 mm (about 1.97 mm over enamel), 9 turns per coil, delta, 2 parallel paths, one coil per tooth. Fill 0.511 (copper 0.513). Mean turn 273.7 mm; 16.23 mΩ per path at 100 °C (copper 13.48).

Terminations

Welded or crimped joints with aluminium-rated lugs or Al-Cu transitions (no soldering), sealed against galvanic corrosion.

Drive

Same limits. New flux and resistance tables in the controller (flux and torque per amp ×1.041 against copper: stack × turns); aluminium temperature coefficient 0.00403/K.

Thermal (to check)

Winding loss at peak torque 885 → 1055 W (+19 %), current density 15.2 → 9.2 A/mm². Check the peak duration in Motor-CAD Thermal. Alternative: Stator F2 (OD 167, yoke 7.85 mm, slot 22.15 mm deep, tooth 15.54 mm), 72 mm stack, 9 turns × 5 × 1.60 mm Al, winding loss at peak +32 %, worst-speed torque 98.8 % of copper, ₹40 more saving, range +0.10 % against the recommended design.

Design9795 · aluminium winding · Al end-winding multiplier 1.136

## FEMM stator variants

17 stators, each solved at 4 × 4 d-q currents over the 360 A circle and 2 rotor positions (half model, magnets 100 °C, FEA fill 1.0, as the copper model). Variants change only the slot depth, tooth width and OD; the tooth tip, slot opening, bore, rotor and air gap stay as Design9795_1.

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

* FEMM 2D, 64 mm stack, 10 turns per coil, peak over the 4 × 4 current grid at 360 A (no skew). Dimensions in mm.

- Thinning the yoke by 1 mm costs about 1.3 % of peak torque (yoke B 1.70 → 1.78 T); by 2 mm, 4.4 %.
- Thinning the teeth by 1 mm costs about 1.9 %; tooth flux density is already 2.2–2.3 T at the 99th percentile at full current in every variant.
- A larger OD with the same yoke and teeth costs at most 0.6 % (deeper slot, slightly more slot leakage).

### Check of the interpolation against direct FEMM solves

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

Path currents between the grid nodes (10-turn equivalent), mean of 4 rotor positions (0, 3, 6, 9°). Δ = variant − copper stator at the same currents.

Design9795 · aluminium winding · Al end-winding multiplier 1.136

## Assumptions and files

### Limits of the study

- 2D FEA; end effects only through the end-turn resistance and end-winding inductance.
- Thermal behaviour not simulated; the higher winding loss at peak torque needs a Motor-CAD thermal check.
- Aluminium wire fill held at copper's 0.513; a real aluminium winding with several strands may reach a different fill.
- AC loss by the low-frequency hybrid method; for single wires near the skin depth (about 2.6 mm hot copper, 3.3 mm aluminium at 750 Hz) it is approximate.
- Flux maps, demagnetisation, torque ripple and THD were not recomputed for these stator-only variants: the rotor is unchanged, and the slot opening and tooth tip are identical to copper's.
- Costs are active materials only.

### Files (folder Design9795_1)

File | Content
alu9795_femm.py / .json | FEMM stator variants (17 stators × 32 solves)
alu9795_study.py | Aluminium design model on the Motor-CAD-equivalent copper model
alu9795_search.py / .json | All 4285 designs: envelope, map, peak, drive cycles, cost
alu9795_analyse.py, alu9795_picks.json | Best designs per OD, criterion and Al price
alu9795_verify.py / .json | FEMM check of the interpolation
alu9795_ops.py / .json | OP1–OP3 details
build_alu9795_full.py | This report
