mishravipul361-blip/Ferrite-motor-design/Design9795_1/report_alu/index.html

12-slot / 10-pole ferrite spoke

# Design9795 aluminium winding

FEMM 4.2 · Motor-CAD-equivalent model
OD 160–167 · M235-35A
17 Oct 2026

Design9795 · aluminium winding

## Summary

Aluminium can replace the copper winding of Design9795_1 with stator-only changes (rotor cross-section, magnets, air gap and M235-35A kept), but not at equal efficiency within the 167 mm OD limit. The best balance saves ₹1314 per motor (30 % of active-material cost) for 1.09 % range.

#### Recommended · OD 167 · 66 mm

−₹1314

Range -1.09 % (telematics), -1.21 % (WMTC). Stator F2 (yoke 7.85 mm, slot 22.15 mm deep), 10 turns × 4 × 1.70 mm Al. Torque within 1 % of copper at every speed, -0.39 kg. Winding loss at peak torque +26 %.

#### Cooler alternative · OD 167 · 72 mm

−₹1047

Range -0.95 % / -1.28 %. 9 turns × 5 × 1.60 mm. Winding loss at peak +9 %, +0.27 kg.

#### Least range loss · OD 167 · 78 mm

−₹747

Range -0.74 % / -1.28 %. Stator F1 (copper yoke), 8 turns × 6 × 1.50 mm. Winding loss at peak -4 %, +1.06 kg.

### Cost against range, all designs

Every aluminium design evaluated (2755), Al wire at ₹370/kg. Lines: best designs at each O

Every aluminium design evaluated (2755), Al wire at ₹370/kg. Lines: best designs at each OD (none both cheaper and better on range). Left: torque within 1 % of copper at every speed. Right: up to 3 % short in the high-speed, DC-power-limited region.

### Best designs at each OD (full torque)

OD | Least range loss | Range | Saving (INR) | Largest saving | Range | Saving (INR)
OD 160 | D0 L78 N8 4x1.63 | −1.25 % | 950 | A5 L74 N9 5x1.50 | −1.58 % | 1205
OD 163 | G1 L78 N8 6x1.40 | −0.96 % | 864 | G3 L72 N9 5x1.50 | −1.33 % | 1189
OD 165 | B1 L78 N8 6x1.42 | −0.98 % | 815 | B3 L68 N10 5x1.50 | −1.35 % | 1302
OD 167 | F1 L78 N8 6x1.50 | −0.74 % | 747 | F2 L66 N10 4x1.70 | −1.09 % | 1314

Range parity is not reached: aluminium needs 1.64 × copper's conductor area for the same resistance; the largest slot that keeps the teeth and yoke from saturating gives 1.37–1.52 ×. Each OD page has the details: stator variants, all best designs, efficiency maps, OP1–OP3, drive cycle and cost.

### Key designs

| Copper (today) | Least range loss | Cooler alternative | Recommended | Drop-in (reference)
Design | Cu SWG 11 | F1 L78 N8 6x1.50 | F2 L72 N9 5x1.60 | F2 L66 N10 4x1.70 | drop-in (SWG 11, 64 mm)
Stator OD (mm) | 160 | 167 | 167 | 167 | 160
Stator variant | D0 | F1 | F2 | F2 | D0
Stack length, stator = rotor = magnets (mm) | 64 | 78 | 72 | 66 | 64
Slot depth (mm) | 17.65 | 21.15 | 22.15 | 22.15 | 17.65
Tooth width (mm) | 15.54 | 15.54 | 15.54 | 15.54 | 15.54
Yoke (mm) | 8.85 | 8.85 | 7.85 | 7.85 | 8.85
Slot area (mm²) | 281.2 (×1.000) | 360.2 (×1.281) | 383.8 (×1.365) | 383.8 (×1.365) | 281.2 (×1.000)
Turns per coil | 10 | 8 | 9 | 10 | 10
Strands × bare diameter (mm) | 1 × 2.95 | 6 × 1.50 | 5 × 1.60 | 4 × 1.70 | 1 × 2.95
Conductor area (mm²) | 6.82 | 10.60 | 10.05 | 9.08 | 6.82
Insulated fill | 0.513 | 0.511 | 0.510 | 0.510 | 0.513
Mean turn length (mm) | 203.6 | 233.1 | 221.5 | 209.5 | 203.6
Resistance per path, 100 °C (mΩ) | 13.48 | 13.15 | 14.82 | 17.25 | 22.32
Peak torque, 1000 rpm (N·m) | 44.11 | 43.91 | 44.44 | 44.62 | 44.11
Worst envelope ratio vs copper | – | 99.5 % | 100.0 % | 99.0 % | 97.0 %
Winding loss at peak torque (W) | 885 | 854 | 961 | 1119 | 1452
Current density at peak (A/mm² rms) | 15.2 | 9.8 | 10.3 | 11.4 | 15.2
Peak efficiency (%) | 95.36 | 95.40 | 95.28 | 95.16 | 94.71
Map efficiency, mean change (points) | – | −0.30 | −0.45 | −0.78 | −2.24
Telematics: Wh/km at motor terminals | 61.291 | 61.750 | 61.878 | 61.968 | 62.650
Range change, telematics | – | −0.74 % | −0.95 % | −1.09 % | −2.17 %
Range change, WMTC Class 1 | – | −1.28 % | −1.28 % | −1.21 % | −2.02 %
Winding mass (kg) | 1.488 | 0.641 | 0.650 | 0.617 | 0.450
Stator laminations (kg) | 3.635 | 4.921 | 4.391 | 4.025 | 3.635
Rotor laminations + magnets (kg) | 2.832 | 3.451 | 3.186 | 2.920 | 2.832
Active mass (kg) | 7.955 | 9.014 | 8.227 | 7.562 | 6.917
Material cost (INR) | 4349 | 3602 | 3302 | 3035 | 2805
Saving vs copper (INR) | – | 747 (17.2 %) | 1047 (24.1 %) | 1314 (30.2 %) | 1544 (35.5 %)

### Operating points OP1–OP3

Efficiency change vs copper (points) | Least range loss | Cooler alternative | Recommended | Drop-in
OP1: 9000 rpm, maximum power | +2.65 | +1.89 | +0.97 | −0.59
OP2: 9339 rpm, 3.24 N·m | +0.50 | +0.95 | +1.39 | −0.07
OP3: 2000 rpm, maximum torque | +0.38 | −0.49 | −1.77 | −4.57

Aluminium is better than copper at 9000 rpm (OP1) and at the 9339 rpm cruise point (OP2): copper's single 2.95 mm wire has 505 W AC loss at OP1, aluminium's 1.50–1.70 mm strands 73–139 W. At peak torque (OP3) the higher DC resistance costs efficiency. Full tables on the OD 167 page.

Design9795 · aluminium winding

## Method and copper baseline

Every number comes from the Motor-CAD-equivalent FEMM model of Design9795_1, extended with FEMM solutions of each stator variant, then run through the vehicle drive cycles.

Stage | Script | What it computes | Count
1. Copper model | lab_model.py (v3), make_lab_v2.py | Motor-CAD-equivalent Lab model: skew slices, Motor-CAD torque, minor-loop hysteresis + harmonic eddy iron loss | validated on 840 Motor-CAD map points
2. Stator variants | alu9795_femm.py (FEMM) | Torque, d-q flux, stator iron-loss sums, slot field, tooth and yoke flux density on a 4 × 4 current grid × 2 rotor positions | 17 stators × 32 = 544 solves
3. Design search | alu9795_study.py, alu9795_search.py | Each stator × stack 64–80 mm × 8/9/10 turns per coil × 1–6 strands: envelope, efficiency map, peak point, drive cycles, cost | 2755 designs
4. Best designs | alu9795_analyse.py | Cost against range fronts per OD and criterion; Al price sensitivity | 4 ODs × 2 criteria × 3 prices
5. FEMM check | alu9795_verify.py | Direct solves between grid nodes, 4 rotor positions, against the interpolation | 60 solves
6. Operating points | alu9795_ops.py | OP1–OP3: currents, phase advance, voltage, flux, power factor, loss breakdown | 14 designs

### Copper baseline (Design9795_1)

Stator OD 160 mm, bore 107 mm, 12 slots, slot depth 17.65 mm, tooth 15.54 mm, yoke 8.85 mm, slot 281.2 mm²; 10-pole spoke ferrite rotor; 64 mm stack; delta, 2 parallel paths, 10 turns per coil of SWG 11 (2.946 mm) copper, fill 0.513; M235-35A. Drive: 52 V, modulation 0.95 (49.4 V phase peak), 360 A rms line, 280 A DC, MTPA. Winding and magnets at 100 °C.

The FEMM model matches Motor-CAD Lab within 0.28 efficiency points (mean over 840 map points), 1.6 % torque and 2.7 % total loss; envelope torque within 0.7 % from 1000 to 9000 rpm (see the Lab validation report).

Copper efficiency map from the Motor-CAD-equivalent FEMM model, with the three operating p

Copper efficiency map from the Motor-CAD-equivalent FEMM model, with the three operating points.

OP1 · 9000 rpm, maximum power | Motor-CAD, copper | Copper (FEMM)
Shaft torque (N·m) | 13.98 | 14.05
Electromagnetic torque (N·m) | 14.46 | 14.50
Shaft power (W) | 13178 | 13239
Input power (W) | 14560 | 14552
Efficiency (%) | 90.51 | 90.97
Line current (A rms) | 247.2 | 236.3
Phase current (A rms, delta) | 142.7 | 136.4
Id, phase (A peak) | −184.2 | −173.3
Iq, phase (A peak) | 82.5 | 84.7
Phase advance (° el) | 65.9 | 63.9
Phase voltage (V peak, limit 49.4) | 49.40 | 49.38
Power factor | 0.974 | 0.983
ψd (mV·s) | 1.72 | 2.68
ψq (mV·s) | 9.69 | 9.85
DC bus current (A) | 280.0 | 279.9
Current density (A/mm² rms) | – | 10.0
Active limit | – | voltage, DC current
DC winding loss (W) | 411.7 | 376.2
AC winding loss (W) | 526.5 | 505.5
Stator hysteresis (W) | – | 71.6
Stator eddy (W) | – | 125.7
Stator iron total (W) | 205.3 | 197.4
Rotor iron (W) | 89.4 | 85.7
Iron total (W) | 294.7 | 283.1
Bearings + windage (W) | 148.9 | 148.9
Total loss (W) | 1381.8 | 1313.6

OP2 · 9339 rpm, 3.24 N·m | Copper (FEMM)
Shaft torque (N·m) | 3.27
Electromagnetic torque (N·m) | 3.62
Shaft power (W) | 3195
Input power (W) | 3785
Efficiency (%) | 84.41
Line current (A rms) | 120.7
Phase current (A rms, delta) | 69.7
Id, phase (A peak) | −96.2
Iq, phase (A peak) | 21.8
Phase advance (° el) | 77.2
Phase voltage (V peak, limit 49.4) | 49.22
Power factor | 0.499
ψd (mV·s) | 9.59
ψq (mV·s) | 2.84
DC bus current (A) | 72.8
Current density (A/mm² rms) | 5.1
Active limit | voltage
DC winding loss (W) | 98.3
AC winding loss (W) | 150.4
Stator hysteresis (W) | 54.2
Stator eddy (W) | 99.6
Stator iron total (W) | 153.8
Rotor iron (W) | 31.6
Iron total (W) | 185.4
Bearings + windage (W) | 156.2
Total loss (W) | 590.2

OP3 · 2000 rpm, maximum torque | Motor-CAD, copper | Copper (FEMM)
Shaft torque (N·m) | 44.11 | 44.06
Electromagnetic torque (N·m) | 44.76 | 44.67
Shaft power (W) | 9239 | 9227
Input power (W) | 10306 | 10284
Efficiency (%) | 89.65 | 89.73
Line current (A rms) | 360.0 | 360.0
Phase current (A rms, delta) | 207.8 | 207.8
Id, phase (A peak) | −85.0 | −90.8
Iq, phase (A peak) | 281.4 | 279.6
Phase advance (° el) | 16.8 | 18.0
Phase voltage (V peak, limit 49.4) | 34.36 | 33.85
Power factor | 0.680 | 0.685
ψd (mV·s) | 12.48 | 12.00
ψq (mV·s) | 28.90 | 28.65
DC bus current (A) | 198.2 | 197.8
Current density (A/mm² rms) | – | 15.2
Active limit | – | 360 A
DC winding loss (W) | 873.5 | 873.5
AC winding loss (W) | 57.4 | 54.7
Stator hysteresis (W) | – | 61.2
Stator eddy (W) | – | 20.4
Stator iron total (W) | 87.4 | 81.5
Rotor iron (W) | 27.7 | 25.9
Iron total (W) | 115.1 | 107.4
Bearings + windage (W) | 21.1 | 21.1
Total loss (W) | 1067.1 | 1056.6

Motor-CAD values from its envelope export (OP1, OP3). Motor-CAD splits iron loss into stator/rotor and hysteresis/eddy for the machine; its OP1 hysteresis 111 W, eddy 184 W. FEMM's OP1 iron loss is lower (the known hysteresis gap), so copper's FEMM efficiency is +0.46 points against Motor-CAD at OP1 and +0.08 at OP3. Aluminium designs are compared with FEMM copper, so this offset cancels.

### How an aluminium design is evaluated

- Turns: currents scaled by turns (same ampere-turns give the same field), flux linkage × turns, end-winding inductance × turns².
- Stack length: flux, torque, iron loss and windage scale with length (2D); end-turn length unchanged.
- Stator variant: FEMM differences against the copper stator at the same ampere-turns, added to the copper model (flux), or as ratios (stator iron loss, slot field). Checked against direct FEMM solves: ψq within 0.27 %, iron-loss ratio within 0.6 %.
- Winding: aluminium EC-1350 (2.826 × 10⁻⁸ Ω·m at 20 °C, 0.00403/K, 2703 kg/m³) at 100 °C; insulated fill at or below copper's 0.513; IEC and SWG wire sizes from 1.0 mm, 1–6 strands; mean turn = 2L + end turn corrected for tooth width and coil thickness; AC loss by Motor-CAD's hybrid method (factor 2) with FEMM's slot field.
- Acceptance: full = peak torque ≥ 99.5 % of copper and envelope ≥ 99 % at every speed 0–9500 rpm; relaxed = envelope ≥ 97 % (shortfall only in the DC-power-limited region above about 3000 rpm).

Design9795 · aluminium winding

## OD 160 mm

Same OD and housing as copper. The slot can only grow inward (thinner yoke) or sideways (thinner teeth), and both cost torque per ampere-turn: −1.3 % per mm of yoke, −1.9 % per mm of tooth. Aluminium therefore needs a long stack (72–78 mm). 1135 designs evaluated at this OD; 117 keep full torque at every speed, 526 stay within 3 %.

### Stator variants at OD 160

Stator | OD | Slot depth | Tooth | Yoke | Slot area (mm²) | vs copper | Max torque (N·m)* | vs copper | Tooth B 99 % (T) | Yoke B 99 % (T) | Stator steel (kg)*
D0 | 160 | 17.65 | 15.54 | 8.85 | 281.2 | ×1.000 | 50.62 | +0.0 % | 2.28 | 1.70 | 3.635
A1 | 160 | 18.65 | 15.54 | 7.85 | 303.1 | ×1.078 | 49.97 | −1.3 % | 2.28 | 1.78 | 3.510
A2 | 160 | 19.65 | 15.54 | 6.85 | 325.5 | ×1.157 | 48.38 | −4.4 % | 2.25 | 1.83 | 3.382
A3 | 160 | 17.65 | 14.54 | 8.85 | 296.2 | ×1.053 | 49.68 | −1.9 % | 2.27 | 1.66 | 3.550
A4 | 160 | 18.65 | 14.54 | 7.85 | 319.0 | ×1.135 | 49.16 | −2.9 % | 2.26 | 1.76 | 3.419
A5 | 160 | 19.65 | 14.54 | 6.85 | 342.5 | ×1.218 | 47.74 | −5.7 % | 2.24 | 1.82 | 3.285
A6 | 160 | 18.65 | 13.54 | 7.85 | 334.7 | ×1.190 | 48.06 | −5.0 % | 2.26 | 1.74 | 3.330

* FEMM 2D, 64 mm stack, 10 turns per coil, peak over the 4 × 4 current grid at 360 A (no skew). Dimensions in mm.

Slot outlines of the OD 160 stators against the copper stator (D0). Tooth tip and slot ope

Slot outlines of the OD 160 stators against the copper stator (D0). Tooth tip and slot opening are unchanged in every variant.

### Cost against range

All designs at OD 160. Dark: full torque at every speed; light blue: within 3 %; grey: nei

All designs at OD 160. Dark: full torque at every speed; light blue: within 3 %; grey: neither. Line: best designs (full). Circles: designs detailed below.

#### Best designs, full torque at every speed

Design | Stator | Yoke (mm) | Stack (mm) | Turns × (strands × d) | Worst envelope | Range, telematics | Range, WMTC | Saving (INR) | Winding loss at peak (W) | Mass change (kg)
D0 L78 N8 4x1.63 | D0 | 8.85 | 78 | 8 × (4 × 1.63) | 99.3 % | −1.25 % | −1.63 % | 950 | 1082 | +0.43
D0 L78 N8 6x1.32 | D0 | 8.85 | 78 | 8 × (6 × 1.32) | 99.3 % | −1.26 % | −1.65 % | 952 | 1094 | +0.42
D0 L78 N8 5x1.42 | D0 | 8.85 | 78 | 8 × (5 × 1.42) | 99.0 % | −1.43 % | −1.81 % | 958 | 1131 | +0.40
A5 L74 N9 5x1.50 | A5 | 6.85 | 74 | 9 × (5 × 1.50) | 99.2 % | −1.58 % | −1.90 % | 1205 | 1106 | −0.30

#### Best designs, up to 3 % torque shortfall at high speed

Design | Stator | Yoke (mm) | Stack (mm) | Turns × (strands × d) | Worst envelope | Range, telematics | Range, WMTC | Saving (INR) | Winding loss at peak (W) | Mass change (kg)
D0 L78 N8 4x1.63 | D0 | 8.85 | 78 | 8 × (4 × 1.63) | 99.3 % | −1.25 % | −1.63 % | 950 | 1082 | +0.43
D0 L78 N8 6x1.32 | D0 | 8.85 | 78 | 8 × (6 × 1.32) | 99.3 % | −1.26 % | −1.65 % | 952 | 1094 | +0.42
D0 L78 N8 5x1.42 | D0 | 8.85 | 78 | 8 × (5 × 1.42) | 99.0 % | −1.43 % | −1.81 % | 958 | 1131 | +0.40
A4 L72 N9 4x1.63 | A4 | 7.85 | 72 | 9 × (4 × 1.63) | 98.9 % | −1.45 % | −1.74 % | 1256 | 1153 | −0.39
A4 L72 N9 6x1.32 | A4 | 7.85 | 72 | 9 × (6 × 1.32) | 98.8 % | −1.45 % | −1.75 % | 1259 | 1165 | −0.40
A4 L72 N9 5x1.42 | A4 | 7.85 | 72 | 9 × (5 × 1.42) | 98.6 % | −1.65 % | −1.92 % | 1265 | 1205 | −0.41
D0 L70 N9 4x1.50 | D0 | 8.85 | 70 | 9 × (4 × 1.50) | 97.9 % | −1.70 % | −1.89 % | 1300 | 1331 | −0.44
A4 L66 N10 6x1.25 | A4 | 7.85 | 66 | 10 × (6 × 1.25) | 97.8 % | −1.73 % | −1.82 % | 1511 | 1363 | −1.01
A4 L66 N10 4x1.50 | A4 | 7.85 | 66 | 10 × (4 × 1.50) | 97.4 % | −2.03 % | −2.06 % | 1519 | 1421 | −1.03
A4 L66 N10 2x2.12 | A4 | 7.85 | 66 | 10 × (2 × 2.12) | 97.3 % | −2.17 % | −2.16 % | 1519 | 1424 | −1.03
A4 L66 N10 5x1.32 | A4 | 7.85 | 66 | 10 × (5 × 1.32) | 97.2 % | −2.19 % | −2.22 % | 1525 | 1467 | −1.05
A4 L66 N10 3x1.70 | A4 | 7.85 | 66 | 10 × (3 × 1.70) | 97.1 % | −2.29 % | −2.29 % | 1526 | 1475 | −1.05

At the copper stack of 64 mm, no design at this OD meets either criterion: aluminium at 64 mm loses torque either at low speed (fewer turns, 360 A limit) or above 2500 rpm (10 turns, higher resistance).

### Effect of stack length and turns

Best design (range) at each stack length and turn count at OD 160, among those within 3 %

Best design (range) at each stack length and turn count at OD 160, among those within 3 % of copper torque; filled dots also meet the full criterion. Fewer turns need a longer stack for the same torque at 360 A.

### Designs in detail

| Copper (today) | Least range loss | Largest saving, full torque | Largest saving, ≤ 3 % high-speed torque
Design | Cu SWG 11 | D0 L78 N8 4x1.63 | A5 L74 N9 5x1.50 | A4 L72 N9 6x1.32
Stator OD (mm) | 160 | 160 | 160 | 160
Stator variant | D0 | D0 | A5 | A4
Stack length, stator = rotor = magnets (mm) | 64 | 78 | 74 | 72
Slot depth (mm) | 17.65 | 17.65 | 19.65 | 18.65
Tooth width (mm) | 15.54 | 15.54 | 14.54 | 14.54
Yoke (mm) | 8.85 | 8.85 | 6.85 | 7.85
Slot area (mm²) | 281.2 (×1.000) | 281.2 (×1.000) | 342.5 (×1.218) | 319.0 (×1.135)
Turns per coil | 10 | 8 | 9 | 9
Strands × bare diameter (mm) | 1 × 2.95 | 4 × 1.63 | 5 × 1.50 | 6 × 1.32
Conductor area (mm²) | 6.82 | 8.31 | 8.84 | 8.21
Insulated fill | 0.513 | 0.511 | 0.504 | 0.507
Mean turn length (mm) | 203.6 | 231.6 | 223.9 | 219.5
Resistance per path, 100 °C (mΩ) | 13.48 | 16.68 | 17.05 | 17.98
Peak torque, 1000 rpm (N·m) | 44.11 | 44.15 | 44.33 | 44.09
Worst envelope ratio vs copper | – | 99.3 % | 99.2 % | 98.8 %
Winding loss at peak torque (W) | 885 | 1082 | 1106 | 1165
Current density at peak (A/mm² rms) | 15.2 | 12.5 | 11.8 | 12.6
Peak efficiency (%) | 95.36 | 95.14 | 95.06 | 95.06
Map efficiency, mean change (points) | – | −1.12 | −1.11 | −1.24
Telematics: Wh/km at motor terminals | 61.291 | 62.069 | 62.274 | 62.196
Range change, telematics | – | −1.25 % | −1.58 % | −1.45 %
Range change, WMTC Class 1 | – | −1.63 % | −1.90 % | −1.75 %
Winding mass (kg) | 1.488 | 0.499 | 0.578 | 0.526
Stator laminations (kg) | 3.635 | 4.430 | 3.799 | 3.846
Rotor laminations + magnets (kg) | 2.832 | 3.451 | 3.274 | 3.186
Active mass (kg) | 7.955 | 8.381 | 7.651 | 7.558
Material cost (INR) | 4349 | 3399 | 3144 | 3090
Saving vs copper (INR) | – | 950 (21.8 %) | 1205 (27.7 %) | 1259 (28.9 %)

### Torque-speed envelope

Maximum shaft torque at each speed against copper, same drive limits. Right: ratio to copp

Maximum shaft torque at each speed against copper, same drive limits. Right: ratio to copper; dotted lines 99 % and 97 %.

### Efficiency maps against copper

Efficiency change against copper at the same speed and shaft torque (blue = aluminium bett

Efficiency change against copper at the same speed and shaft torque (blue = aluminium better). Triangles: OP1–OP3.

Efficiency map of A4 L72 N9 6x1.32.

Efficiency map of A4 L72 N9 6x1.32.

### Operating points OP1, OP2, OP3

Efficiency change vs copper (points) | Least range loss | Largest saving, full torque | Largest saving, ≤ 3 % high-speed torque
OP1: 9000 rpm, maximum power | +2.08 | +1.87 | +1.90
OP2: 9339 rpm, 3.24 N·m | −0.26 | −0.00 | +0.53
OP3: 2000 rpm, maximum torque | −1.44 | −1.67 | −2.17

Loss breakdown at the operating points; label = total loss and efficiency.

Loss breakdown at the operating points; label = total loss and efficiency.

OP1 · 9000 rpm, maximum power | Motor-CAD, copper | Copper (FEMM) | Least range loss | Largest saving, full torque | Largest saving, ≤ 3 % high-speed torque
Shaft torque (N·m) | 13.98 | 14.05 | 14.34 | 14.32 | 14.33
Electromagnetic torque (N·m) | 14.46 | 14.50 | 14.82 | 14.83 | 14.82
Shaft power (W) | 13178 | 13239 | 13516 | 13496 | 13510
Input power (W) | 14560 | 14552 | 14524 | 14536 | 14547
Efficiency (%) | 90.51 | 90.97 | 93.05 | 92.84 | 92.87
Line current (A rms) | 247.2 | 236.3 | 241.5 | 239.3 | 240.8
Phase current (A rms, delta) | 142.7 | 136.4 | 139.4 | 138.1 | 139.0
Id, phase (A peak) | −184.2 | −173.3 | −175.7 | −175.8 | −176.0
Iq, phase (A peak) | 82.5 | 84.7 | 89.5 | 85.3 | 87.5
Phase advance (° el) | 65.9 | 63.9 | 63.0 | 64.1 | 63.6
Phase voltage (V peak, limit 49.4) | 49.40 | 49.38 | 49.16 | 49.38 | 49.20
Power factor | 0.974 | 0.983 | 0.994 | 0.999 | 0.999
ψd (mV·s) | 1.72 | 2.68 | 5.58 | 4.08 | 4.06
ψq (mV·s) | 9.69 | 9.85 | 8.40 | 9.27 | 9.21
DC bus current (A) | 280.0 | 279.9 | 279.3 | 279.5 | 279.7
Current density (A/mm² rms) | – | 10.0 | 8.4 | 7.8 | 8.5
Active limit | – | voltage, DC current | voltage | voltage, DC current | voltage, DC current
DC winding loss (W) | 411.7 | 376.2 | 486.3 | 487.9 | 521.2
AC winding loss (W) | 526.5 | 505.5 | 74.9 | 74.8 | 54.8
Stator hysteresis (W) | – | 71.6 | 77.8 | 86.6 | 81.4
Stator eddy (W) | – | 125.7 | 134.7 | 150.7 | 141.2
Stator iron total (W) | 205.3 | 197.4 | 212.5 | 237.4 | 222.6
Rotor iron (W) | 89.4 | 85.7 | 76.5 | 84.6 | 84.0
Iron total (W) | 294.7 | 283.1 | 288.9 | 322.0 | 306.6
Bearings + windage (W) | 148.9 | 148.9 | 158.6 | 155.8 | 154.4
Total loss (W) | 1381.8 | 1313.6 | 1008.8 | 1040.5 | 1036.9

OP2 · 9339 rpm, 3.24 N·m | Copper (FEMM) | Least range loss | Largest saving, full torque | Largest saving, ≤ 3 % high-speed torque
Shaft torque (N·m) | 3.27 | 3.24 | 3.25 | 3.25
Electromagnetic torque (N·m) | 3.62 | 3.65 | 3.65 | 3.65
Shaft power (W) | 3195 | 3172 | 3174 | 3183
Input power (W) | 3785 | 3770 | 3760 | 3747
Efficiency (%) | 84.41 | 84.15 | 84.41 | 84.94
Line current (A rms) | 120.7 | 144.0 | 136.5 | 133.5
Phase current (A rms, delta) | 69.7 | 83.1 | 78.8 | 77.1
Id, phase (A peak) | −96.2 | −115.4 | −109.4 | −106.8
Iq, phase (A peak) | 21.8 | 22.6 | 21.4 | 22.0
Phase advance (° el) | 77.2 | 78.9 | 78.9 | 78.4
Phase voltage (V peak, limit 49.4) | 49.22 | 49.31 | 49.21 | 49.37
Power factor | 0.499 | 0.430 | 0.454 | 0.462
ψd (mV·s) | 9.59 | 9.73 | 9.64 | 9.67
ψq (mV·s) | 2.84 | 2.31 | 2.57 | 2.57
DC bus current (A) | 72.8 | 72.5 | 72.3 | 72.1
Current density (A/mm² rms) | 5.1 | 5.0 | 4.5 | 4.7
Active limit | voltage | voltage | voltage | voltage
DC winding loss (W) | 98.3 | 172.9 | 158.8 | 160.2
AC winding loss (W) | 150.4 | 30.1 | 27.3 | 19.0
Stator hysteresis (W) | 54.2 | 67.7 | 70.9 | 66.5
Stator eddy (W) | 99.6 | 122.9 | 129.2 | 121.4
Stator iron total (W) | 153.8 | 190.6 | 200.1 | 187.9
Rotor iron (W) | 31.6 | 37.4 | 36.7 | 35.3
Iron total (W) | 185.4 | 227.9 | 236.7 | 223.2
Bearings + windage (W) | 156.2 | 166.4 | 163.5 | 162.0
Total loss (W) | 590.2 | 597.4 | 586.4 | 564.4

OP3 · 2000 rpm, maximum torque | Motor-CAD, copper | Copper (FEMM) | Least range loss | Largest saving, full torque | Largest saving, ≤ 3 % high-speed torque
Shaft torque (N·m) | 44.11 | 44.06 | 44.06 | 44.26 | 44.03
Electromagnetic torque (N·m) | 44.76 | 44.67 | 44.71 | 44.95 | 44.70
Shaft power (W) | 9239 | 9227 | 9228 | 9270 | 9222
Input power (W) | 10306 | 10284 | 10452 | 10528 | 10533
Efficiency (%) | 89.65 | 89.73 | 88.28 | 88.05 | 87.55
Line current (A rms) | 360.0 | 360.0 | 360.0 | 360.0 | 360.0
Phase current (A rms, delta) | 207.8 | 207.8 | 207.8 | 207.8 | 207.8
Id, phase (A peak) | −85.0 | −90.8 | −80.7 | −98.1 | −89.9
Iq, phase (A peak) | 281.4 | 279.6 | 282.6 | 277.1 | 279.8
Phase advance (° el) | 16.8 | 18.0 | 15.9 | 19.5 | 17.8
Phase voltage (V peak, limit 49.4) | 34.36 | 33.85 | 31.23 | 32.31 | 32.56
Power factor | 0.680 | 0.685 | 0.759 | 0.738 | 0.733
ψd (mV·s) | 12.48 | 12.00 | 14.17 | 12.28 | 12.84
ψq (mV·s) | 28.90 | 28.65 | 24.25 | 26.42 | 26.33
DC bus current (A) | 198.2 | 197.8 | 201.0 | 202.5 | 202.6
Current density (A/mm² rms) | – | 15.2 | 12.5 | 11.8 | 12.7
Active limit | – | 360 A | 360 A | 360 A | 360 A
DC winding loss (W) | 873.5 | 873.5 | 1080.5 | 1104.7 | 1165.3
AC winding loss (W) | 57.4 | 54.7 | 8.0 | 7.5 | 5.7
Stator hysteresis (W) | – | 61.2 | 67.4 | 74.0 | 70.0
Stator eddy (W) | – | 20.4 | 21.4 | 23.7 | 22.5
Stator iron total (W) | 87.4 | 81.5 | 88.8 | 97.8 | 92.5
Rotor iron (W) | 27.7 | 25.9 | 25.2 | 25.6 | 25.7
Iron total (W) | 115.1 | 107.4 | 113.9 | 123.4 | 118.2
Bearings + windage (W) | 21.1 | 21.1 | 22.4 | 22.1 | 21.9
Total loss (W) | 1067.1 | 1056.6 | 1224.9 | 1257.7 | 1311.0

### Drive cycle and range

Design | Cycle | Net Wh/km | Shaft out, motoring | Electrical in, motoring | η motoring (%) | Shaft in, regen | Electrical out, regen | η regen (%) | DC winding loss | AC winding loss | Iron loss | Mech. loss | Total loss | Range change
Copper | Telematics | 61.291 | 81.53 | 87.83 | 92.82 | 28.55 | 26.54 | 92.97 | 2.82 | 0.84 | 3.04 | 1.61 | 8.32 | –
| WMTC Class 1 | 60.520 | 76.21 | 81.72 | 93.26 | 22.91 | 21.20 | 92.55 | 2.13 | 0.40 | 3.10 | 1.59 | 7.22 | –
Least range loss | Telematics | 62.069 | 81.67 | 88.45 | 92.33 | 28.57 | 26.38 | 92.33 | 3.56 | 0.12 | 3.58 | 1.72 | 8.97 | −1.25 %
| WMTC Class 1 | 61.525 | 76.21 | 82.47 | 92.42 | 22.91 | 20.94 | 91.40 | 2.81 | 0.06 | 3.66 | 1.69 | 8.22 | −1.63 %
Largest saving, full torque | Telematics | 62.274 | 81.62 | 88.61 | 92.12 | 28.56 | 26.33 | 92.19 | 3.55 | 0.12 | 3.86 | 1.69 | 9.22 | −1.58 %
| WMTC Class 1 | 61.689 | 76.21 | 82.59 | 92.27 | 22.91 | 20.91 | 91.25 | 2.69 | 0.06 | 3.98 | 1.66 | 8.39 | −1.90 %
Largest saving, ≤ 3 % high-speed torque | Telematics | 62.196 | 81.59 | 88.54 | 92.16 | 28.56 | 26.34 | 92.21 | 3.78 | 0.09 | 3.63 | 1.67 | 9.17 | −1.45 %
| WMTC Class 1 | 61.600 | 76.21 | 82.51 | 92.36 | 22.91 | 20.92 | 91.29 | 2.90 | 0.04 | 3.71 | 1.65 | 8.30 | −1.75 %

Energies and losses in Wh/km at the motor (motor losses only; inverter, battery and vehicle are the same for every design).

Motor losses over the telematics cycle by type.

Motor losses over the telematics cycle by type.

Where the range is lost: extra loss against copper over the telematics cycle, by motor spe

Where the range is lost: extra loss against copper over the telematics cycle, by motor speed band, motoring (left) and regenerating (right).

### Cost

Design | Winding (kg) | Wire (INR) | Laminations (kg) | Laminations (INR) | Magnets (kg) | Magnets (INR) | Total (INR) | Saving, Al ₹370 | Saving, Al ₹230 | Saving, Al ₹450
Copper | 1.488 | 1719 | 5.087 | 1526 | 1.380 | 1104 | 4349 | – | – | –
Least range loss | 0.499 | 194 | 6.200 | 1860 | 1.682 | 1346 | 3399 | 950 | 1023 | 908
Largest saving, full torque | 0.578 | 224 | 5.477 | 1643 | 1.596 | 1277 | 3144 | 1205 | 1290 | 1156
Largest saving, ≤ 3 % high-speed torque | 0.526 | 204 | 5.480 | 1644 | 1.553 | 1242 | 3090 | 1259 | 1336 | 1215

Design9795 · aluminium winding

## OD 163 mm

Three extra millimetres of OD deepen the slot by 1.5 mm with the copper yoke and tooth (slot ×1.118), or by 2.5 mm with a 1 mm thinner yoke. 486 designs evaluated at this OD; 90 keep full torque at every speed, 263 stay within 3 %.

### Stator variants at OD 163

Stator | OD | Slot depth | Tooth | Yoke | Slot area (mm²) | vs copper | Max torque (N·m)* | vs copper | Tooth B 99 % (T) | Yoke B 99 % (T) | Stator steel (kg)*
D0 | 160 | 17.65 | 15.54 | 8.85 | 281.2 | ×1.000 | 50.62 | +0.0 % | 2.28 | 1.70 | 3.635
G1 | 163 | 19.15 | 15.54 | 8.85 | 314.3 | ×1.118 | 50.48 | −0.3 % | 2.29 | 1.71 | 3.808
G2 | 163 | 20.15 | 15.54 | 7.85 | 336.9 | ×1.198 | 49.80 | −1.6 % | 2.27 | 1.78 | 3.679
G3 | 163 | 20.15 | 14.54 | 7.85 | 354.4 | ×1.260 | 48.96 | −3.3 % | 2.26 | 1.76 | 3.579

* FEMM 2D, 64 mm stack, 10 turns per coil, peak over the 4 × 4 current grid at 360 A (no skew). Dimensions in mm.

Slot outlines of the OD 163 stators against the copper stator (D0). Tooth tip and slot ope

Slot outlines of the OD 163 stators against the copper stator (D0). Tooth tip and slot opening are unchanged in every variant.

### Cost against range

All designs at OD 163. Dark: full torque at every speed; light blue: within 3 %; grey: nei

All designs at OD 163. Dark: full torque at every speed; light blue: within 3 %; grey: neither. Line: best designs (full). Circles: designs detailed below.

#### Best designs, full torque at every speed

Design | Stator | Yoke (mm) | Stack (mm) | Turns × (strands × d) | Worst envelope | Range, telematics | Range, WMTC | Saving (INR) | Winding loss at peak (W) | Mass change (kg)
G1 L78 N8 6x1.40 | G1 | 8.85 | 78 | 8 × (6 × 1.40) | 99.8 % | −0.96 % | −1.43 % | 864 | 976 | +0.69
G1 L78 N8 4x1.70 | G1 | 8.85 | 78 | 8 × (4 × 1.70) | 99.7 % | −1.09 % | −1.53 % | 868 | 993 | +0.68
G3 L72 N9 6x1.40 | G3 | 7.85 | 72 | 9 × (6 × 1.40) | 99.4 % | −1.12 % | −1.53 % | 1179 | 1039 | −0.15
G3 L72 N9 4x1.70 | G3 | 7.85 | 72 | 9 × (4 × 1.70) | 99.3 % | −1.24 % | −1.64 % | 1183 | 1057 | −0.16
G3 L72 N9 5x1.50 | G3 | 7.85 | 72 | 9 × (5 × 1.50) | 99.2 % | −1.33 % | −1.72 % | 1189 | 1086 | −0.18

#### Best designs, up to 3 % torque shortfall at high speed

Design | Stator | Yoke (mm) | Stack (mm) | Turns × (strands × d) | Worst envelope | Range, telematics | Range, WMTC | Saving (INR) | Winding loss at peak (W) | Mass change (kg)
G1 L78 N8 6x1.40 | G1 | 8.85 | 78 | 8 × (6 × 1.40) | 99.8 % | −0.96 % | −1.43 % | 864 | 976 | +0.69
G1 L78 N8 4x1.70 | G1 | 8.85 | 78 | 8 × (4 × 1.70) | 99.7 % | −1.09 % | −1.53 % | 868 | 993 | +0.68
G3 L72 N9 6x1.40 | G3 | 7.85 | 72 | 9 × (6 × 1.40) | 99.4 % | −1.12 % | −1.53 % | 1179 | 1039 | −0.15
G1 L70 N9 4x1.60 | G1 | 8.85 | 70 | 9 × (4 × 1.60) | 98.7 % | −1.23 % | −1.52 % | 1219 | 1174 | −0.19
G1 L70 N9 5x1.42 | G1 | 8.85 | 70 | 9 × (5 × 1.42) | 98.6 % | −1.27 % | −1.56 % | 1221 | 1189 | −0.19
G3 L66 N10 6x1.32 | G3 | 7.85 | 66 | 10 × (6 × 1.32) | 98.4 % | −1.32 % | −1.55 % | 1439 | 1227 | −0.79
G3 L66 N10 5x1.42 | G3 | 7.85 | 66 | 10 × (5 × 1.42) | 98.2 % | −1.54 % | −1.72 % | 1446 | 1269 | −0.81
G3 L66 N10 3x1.83 | G3 | 7.85 | 66 | 10 × (3 × 1.83) | 98.1 % | −1.68 % | −1.81 % | 1448 | 1279 | −0.81
G1 L64 N10 4x1.50 | G1 | 8.85 | 64 | 10 × (4 × 1.50) | 97.4 % | −1.70 % | −1.76 % | 1485 | 1398 | −0.85
G1 L64 N10 2x2.12 | G1 | 8.85 | 64 | 10 × (2 × 2.12) | 97.3 % | −1.83 % | −1.87 % | 1485 | 1402 | −0.85
G1 L64 N10 5x1.32 | G1 | 8.85 | 64 | 10 × (5 × 1.32) | 97.2 % | −1.85 % | −1.92 % | 1491 | 1444 | −0.86
G1 L64 N10 3x1.70 | G1 | 8.85 | 64 | 10 × (3 × 1.70) | 97.1 % | −1.95 % | −1.99 % | 1492 | 1452 | −0.86

At the copper stack of 64 mm, no design at this OD keeps full torque at every speed; with up to 3 % shortfall at high speed the best is G1 L64 N10 4x1.50: range -1.70 %, saving ₹1485.

### Effect of stack length and turns

Best design (range) at each stack length and turn count at OD 163, among those within 3 %

Best design (range) at each stack length and turn count at OD 163, among those within 3 % of copper torque; filled dots also meet the full criterion. Fewer turns need a longer stack for the same torque at 360 A.

### Designs in detail

| Copper (today) | Least range loss | Largest saving, full torque | Largest saving, ≤ 3 % high-speed torque
Design | Cu SWG 11 | G1 L78 N8 6x1.40 | G3 L72 N9 5x1.50 | G3 L66 N10 6x1.32
Stator OD (mm) | 160 | 163 | 163 | 163
Stator variant | D0 | G1 | G3 | G3
Stack length, stator = rotor = magnets (mm) | 64 | 78 | 72 | 66
Slot depth (mm) | 17.65 | 19.15 | 20.15 | 20.15
Tooth width (mm) | 15.54 | 15.54 | 14.54 | 14.54
Yoke (mm) | 8.85 | 8.85 | 7.85 | 7.85
Slot area (mm²) | 281.2 (×1.000) | 314.3 (×1.118) | 354.4 (×1.260) | 354.4 (×1.260)
Turns per coil | 10 | 8 | 9 | 10
Strands × bare diameter (mm) | 1 × 2.95 | 6 × 1.40 | 5 × 1.50 | 6 × 1.32
Conductor area (mm²) | 6.82 | 9.24 | 8.84 | 8.21
Insulated fill | 0.513 | 0.513 | 0.487 | 0.507
Mean turn length (mm) | 203.6 | 232.3 | 220.2 | 208.2
Resistance per path, 100 °C (mΩ) | 13.48 | 15.04 | 16.76 | 18.95
Peak torque, 1000 rpm (N·m) | 44.11 | 44.05 | 43.94 | 44.11
Worst envelope ratio vs copper | – | 99.8 % | 99.2 % | 98.4 %
Winding loss at peak torque (W) | 885 | 976 | 1086 | 1227
Current density at peak (A/mm² rms) | 15.2 | 11.3 | 11.7 | 12.6
Peak efficiency (%) | 95.36 | 95.28 | 95.10 | 95.06
Map efficiency, mean change (points) | – | −0.72 | −1.04 | −1.23
Telematics: Wh/km at motor terminals | 61.291 | 61.883 | 62.118 | 62.113
Range change, telematics | – | −0.96 % | −1.33 % | −1.32 %
Range change, WMTC Class 1 | – | −1.43 % | −1.72 % | −1.55 %
Winding mass (kg) | 1.488 | 0.557 | 0.568 | 0.554
Stator laminations (kg) | 3.635 | 4.641 | 4.026 | 3.691
Rotor laminations + magnets (kg) | 2.832 | 3.451 | 3.186 | 2.920
Active mass (kg) | 7.955 | 8.649 | 7.780 | 7.165
Material cost (INR) | 4349 | 3485 | 3161 | 2910
Saving vs copper (INR) | – | 864 (19.9 %) | 1189 (27.3 %) | 1439 (33.1 %)

### Torque-speed envelope

Maximum shaft torque at each speed against copper, same drive limits. Right: ratio to copp

Maximum shaft torque at each speed against copper, same drive limits. Right: ratio to copper; dotted lines 99 % and 97 %.

### Efficiency maps against copper

Efficiency change against copper at the same speed and shaft torque (blue = aluminium bett

Efficiency change against copper at the same speed and shaft torque (blue = aluminium better). Triangles: OP1–OP3.

Efficiency map of G3 L66 N10 6x1.32.

Efficiency map of G3 L66 N10 6x1.32.

### Operating points OP1, OP2, OP3

Efficiency change vs copper (points) | Least range loss | Largest saving, full torque | Largest saving, ≤ 3 % high-speed torque
OP1: 9000 rpm, maximum power | +2.47 | +2.00 | +1.25
OP2: 9339 rpm, 3.24 N·m | +0.27 | +0.67 | +1.41
OP3: 2000 rpm, maximum torque | −0.59 | −1.60 | −2.70

Loss breakdown at the operating points; label = total loss and efficiency.

Loss breakdown at the operating points; label = total loss and efficiency.

OP1 · 9000 rpm, maximum power | Motor-CAD, copper | Copper (FEMM) | Least range loss | Largest saving, full torque | Largest saving, ≤ 3 % high-speed torque
Shaft torque (N·m) | 13.98 | 14.05 | 14.42 | 14.33 | 14.22
Electromagnetic torque (N·m) | 14.46 | 14.50 | 14.91 | 14.82 | 14.72
Shaft power (W) | 13178 | 13239 | 13592 | 13502 | 13401
Input power (W) | 14560 | 14552 | 14546 | 14523 | 14532
Efficiency (%) | 90.51 | 90.97 | 93.44 | 92.97 | 92.22
Line current (A rms) | 247.2 | 236.3 | 241.5 | 239.3 | 249.0
Phase current (A rms, delta) | 142.7 | 136.4 | 139.4 | 138.1 | 143.8
Id, phase (A peak) | −184.2 | −173.3 | −175.4 | −174.6 | −184.6
Iq, phase (A peak) | 82.5 | 84.7 | 90.1 | 87.5 | 85.1
Phase advance (° el) | 65.9 | 63.9 | 62.8 | 63.4 | 65.2
Phase voltage (V peak, limit 49.4) | 49.40 | 49.38 | 49.20 | 49.39 | 49.28
Power factor | 0.974 | 0.983 | 0.996 | 0.999 | 0.962
ψd (mV·s) | 1.72 | 2.68 | 5.48 | 4.04 | 1.46
ψq (mV·s) | 9.69 | 9.85 | 8.52 | 9.29 | 9.96
DC bus current (A) | 280.0 | 279.9 | 279.7 | 279.3 | 279.5
Current density (A/mm² rms) | – | 10.0 | 7.5 | 7.8 | 8.8
Active limit | – | voltage, DC current | voltage, DC current | voltage | voltage, DC current
DC winding loss (W) | 411.7 | 376.2 | 438.5 | 479.7 | 587.4
AC winding loss (W) | 526.5 | 505.5 | 58.8 | 71.8 | 69.7
Stator hysteresis (W) | – | 71.6 | 81.1 | 84.6 | 81.9
Stator eddy (W) | – | 125.7 | 140.4 | 146.5 | 146.6
Stator iron total (W) | 205.3 | 197.4 | 221.5 | 231.2 | 228.5
Rotor iron (W) | 89.4 | 85.7 | 76.8 | 83.4 | 94.8
Iron total (W) | 294.7 | 283.1 | 298.2 | 314.6 | 323.3
Bearings + windage (W) | 148.9 | 148.9 | 158.6 | 154.4 | 150.3
Total loss (W) | 1381.8 | 1313.6 | 954.1 | 1020.5 | 1130.6

OP2 · 9339 rpm, 3.24 N·m | Copper (FEMM) | Least range loss | Largest saving, full torque | Largest saving, ≤ 3 % high-speed torque
Shaft torque (N·m) | 3.27 | 3.26 | 3.28 | 3.27
Electromagnetic torque (N·m) | 3.62 | 3.67 | 3.68 | 3.64
Shaft power (W) | 3195 | 3184 | 3211 | 3198
Input power (W) | 3785 | 3760 | 3774 | 3726
Efficiency (%) | 84.41 | 84.68 | 85.08 | 85.82
Line current (A rms) | 120.7 | 142.5 | 132.8 | 123.0
Phase current (A rms, delta) | 69.7 | 82.3 | 76.6 | 71.0
Id, phase (A peak) | −96.2 | −114.1 | −106.1 | −98.1
Iq, phase (A peak) | 21.8 | 22.7 | 22.2 | 21.5
Phase advance (° el) | 77.2 | 78.8 | 78.2 | 77.6
Phase voltage (V peak, limit 49.4) | 49.22 | 49.36 | 49.29 | 49.22
Power factor | 0.499 | 0.434 | 0.468 | 0.500
ψd (mV·s) | 9.59 | 9.74 | 9.65 | 9.55
ψq (mV·s) | 2.84 | 2.34 | 2.61 | 2.86
DC bus current (A) | 72.8 | 72.3 | 72.6 | 71.7
Current density (A/mm² rms) | 5.1 | 4.5 | 4.3 | 4.3
Active limit | voltage | voltage | voltage | voltage
DC winding loss (W) | 98.3 | 152.7 | 147.7 | 143.3
AC winding loss (W) | 150.4 | 23.0 | 24.8 | 19.2
Stator hysteresis (W) | 54.2 | 69.9 | 68.5 | 61.8
Stator eddy (W) | 99.6 | 126.9 | 125.0 | 113.5
Stator iron total (W) | 153.8 | 196.8 | 193.5 | 175.3
Rotor iron (W) | 31.6 | 37.2 | 35.2 | 32.9
Iron total (W) | 185.4 | 234.0 | 228.7 | 208.2
Bearings + windage (W) | 156.2 | 166.4 | 162.0 | 157.7
Total loss (W) | 590.2 | 576.2 | 563.2 | 528.4

OP3 · 2000 rpm, maximum torque | Motor-CAD, copper | Copper (FEMM) | Least range loss | Largest saving, full torque | Largest saving, ≤ 3 % high-speed torque
Shaft torque (N·m) | 44.11 | 44.06 | 43.96 | 43.88 | 44.04
Electromagnetic torque (N·m) | 44.76 | 44.67 | 44.63 | 44.57 | 44.72
Shaft power (W) | 9239 | 9227 | 9206 | 9191 | 9224
Input power (W) | 10306 | 10284 | 10328 | 10429 | 10600
Efficiency (%) | 89.65 | 89.73 | 89.14 | 88.13 | 87.02
Line current (A rms) | 360.0 | 360.0 | 360.0 | 360.0 | 360.0
Phase current (A rms, delta) | 207.8 | 207.8 | 207.8 | 207.8 | 207.8
Id, phase (A peak) | −85.0 | −90.8 | −81.6 | −91.7 | −97.2
Iq, phase (A peak) | 281.4 | 279.6 | 282.4 | 279.3 | 277.4
Phase advance (° el) | 16.8 | 18.0 | 16.1 | 18.2 | 19.3
Phase voltage (V peak, limit 49.4) | 34.36 | 33.85 | 31.09 | 32.42 | 34.28
Power factor | 0.680 | 0.685 | 0.753 | 0.729 | 0.701
ψd (mV·s) | 12.48 | 12.00 | 14.02 | 12.60 | 11.42
ψq (mV·s) | 28.90 | 28.65 | 24.39 | 26.44 | 28.74
DC bus current (A) | 198.2 | 197.8 | 198.6 | 200.6 | 203.8
Current density (A/mm² rms) | – | 15.2 | 11.3 | 11.8 | 12.7
Active limit | – | 360 A | 360 A | 360 A | 360 A
DC winding loss (W) | 873.5 | 873.5 | 974.4 | 1086.1 | 1227.8
AC winding loss (W) | 57.4 | 54.7 | 6.3 | 7.5 | 6.6
Stator hysteresis (W) | – | 61.2 | 71.3 | 73.7 | 70.5
Stator eddy (W) | – | 20.4 | 22.6 | 23.7 | 23.4
Stator iron total (W) | 87.4 | 81.5 | 93.9 | 97.4 | 93.9
Rotor iron (W) | 27.7 | 25.9 | 25.1 | 25.5 | 26.2
Iron total (W) | 115.1 | 107.4 | 119.0 | 122.9 | 120.0
Bearings + windage (W) | 21.1 | 21.1 | 22.4 | 21.9 | 21.3
Total loss (W) | 1067.1 | 1056.6 | 1122.1 | 1238.3 | 1375.7

### Drive cycle and range

Design | Cycle | Net Wh/km | Shaft out, motoring | Electrical in, motoring | η motoring (%) | Shaft in, regen | Electrical out, regen | η regen (%) | DC winding loss | AC winding loss | Iron loss | Mech. loss | Total loss | Range change
Copper | Telematics | 61.291 | 81.53 | 87.83 | 92.82 | 28.55 | 26.54 | 92.97 | 2.82 | 0.84 | 3.04 | 1.61 | 8.32 | –
| WMTC Class 1 | 60.520 | 76.21 | 81.72 | 93.26 | 22.91 | 21.20 | 92.55 | 2.13 | 0.40 | 3.10 | 1.59 | 7.22 | –
Least range loss | Telematics | 61.883 | 81.70 | 88.33 | 92.49 | 28.58 | 26.45 | 92.54 | 3.21 | 0.10 | 3.74 | 1.72 | 8.76 | −0.96 %
| WMTC Class 1 | 61.397 | 76.21 | 82.38 | 92.52 | 22.91 | 20.98 | 91.57 | 2.53 | 0.05 | 3.82 | 1.69 | 8.10 | −1.43 %
Largest saving, full torque | Telematics | 62.118 | 81.59 | 88.48 | 92.21 | 28.57 | 26.36 | 92.29 | 3.53 | 0.12 | 3.78 | 1.67 | 9.09 | −1.33 %
| WMTC Class 1 | 61.581 | 76.21 | 82.51 | 92.37 | 22.91 | 20.93 | 91.35 | 2.71 | 0.06 | 3.87 | 1.65 | 8.28 | −1.72 %
Largest saving, ≤ 3 % high-speed torque | Telematics | 62.113 | 81.47 | 88.44 | 92.12 | 28.55 | 26.33 | 92.21 | 3.98 | 0.11 | 3.48 | 1.62 | 9.19 | −1.32 %
| WMTC Class 1 | 61.471 | 76.21 | 82.41 | 92.48 | 22.91 | 20.94 | 91.40 | 2.96 | 0.05 | 3.56 | 1.60 | 8.17 | −1.55 %

Energies and losses in Wh/km at the motor (motor losses only; inverter, battery and vehicle are the same for every design).

Motor losses over the telematics cycle by type.

Motor losses over the telematics cycle by type.

Where the range is lost: extra loss against copper over the telematics cycle, by motor spe

Where the range is lost: extra loss against copper over the telematics cycle, by motor speed band, motoring (left) and regenerating (right).

### Cost

Design | Winding (kg) | Wire (INR) | Laminations (kg) | Laminations (INR) | Magnets (kg) | Magnets (INR) | Total (INR) | Saving, Al ₹370 | Saving, Al ₹230 | Saving, Al ₹450
Copper | 1.488 | 1719 | 5.087 | 1526 | 1.380 | 1104 | 4349 | – | – | –
Least range loss | 0.557 | 216 | 6.410 | 1923 | 1.682 | 1346 | 3485 | 864 | 946 | 817
Largest saving, full torque | 0.568 | 221 | 5.659 | 1698 | 1.553 | 1242 | 3161 | 1189 | 1272 | 1141
Largest saving, ≤ 3 % high-speed torque | 0.554 | 215 | 5.188 | 1556 | 1.423 | 1139 | 2910 | 1439 | 1520 | 1392

Design9795 · aluminium winding

## OD 165 mm

Five extra millimetres deepen the slot by 2.5 mm with the copper yoke and tooth (slot ×1.198), up to ×1.346 with a 1 mm thinner yoke and tooth. 486 designs evaluated at this OD; 97 keep full torque at every speed, 251 stay within 3 %.

### Stator variants at OD 165

Stator | OD | Slot depth | Tooth | Yoke | Slot area (mm²) | vs copper | Max torque (N·m)* | vs copper | Tooth B 99 % (T) | Yoke B 99 % (T) | Stator steel (kg)*
D0 | 160 | 17.65 | 15.54 | 8.85 | 281.2 | ×1.000 | 50.62 | +0.0 % | 2.28 | 1.70 | 3.635
B1 | 165 | 20.15 | 15.54 | 8.85 | 336.9 | ×1.198 | 50.41 | −0.4 % | 2.28 | 1.70 | 3.923
B2 | 165 | 21.15 | 15.54 | 7.85 | 360.1 | ×1.281 | 49.68 | −1.9 % | 2.28 | 1.78 | 3.791
B3 | 165 | 21.15 | 14.54 | 7.85 | 378.6 | ×1.346 | 48.81 | −3.6 % | 2.26 | 1.76 | 3.685

* FEMM 2D, 64 mm stack, 10 turns per coil, peak over the 4 × 4 current grid at 360 A (no skew). Dimensions in mm.

Slot outlines of the OD 165 stators against the copper stator (D0). Tooth tip and slot ope

Slot outlines of the OD 165 stators against the copper stator (D0). Tooth tip and slot opening are unchanged in every variant.

### Cost against range

All designs at OD 165. Dark: full torque at every speed; light blue: within 3 %; grey: nei

All designs at OD 165. Dark: full torque at every speed; light blue: within 3 %; grey: neither. Line: best designs (full). Circles: designs detailed below.

#### Best designs, full torque at every speed

Design | Stator | Yoke (mm) | Stack (mm) | Turns × (strands × d) | Worst envelope | Range, telematics | Range, WMTC | Saving (INR) | Winding loss at peak (W) | Mass change (kg)
B1 L78 N8 6x1.42 | B1 | 8.85 | 78 | 8 × (6 × 1.42) | 99.7 % | −0.98 % | −1.49 % | 815 | 948 | +0.85
B1 L72 N9 5x1.50 | B1 | 8.85 | 72 | 9 × (5 × 1.50) | 99.5 % | −1.06 % | −1.23 % | 1072 | 1091 | +0.21
B2 L72 N9 6x1.40 | B2 | 7.85 | 72 | 9 × (6 × 1.40) | 99.6 % | −1.11 % | −1.40 % | 1106 | 1043 | +0.09
B2 L72 N9 4x1.70 | B2 | 7.85 | 72 | 9 × (4 × 1.70) | 99.5 % | −1.26 % | −1.51 % | 1110 | 1062 | +0.08
B2 L72 N9 5x1.50 | B2 | 7.85 | 72 | 9 × (5 × 1.50) | 99.3 % | −1.34 % | −1.60 % | 1116 | 1090 | +0.07
B3 L68 N10 5x1.50 | B3 | 7.85 | 68 | 10 × (5 × 1.50) | 99.1 % | −1.35 % | −1.37 % | 1302 | 1165 | −0.42

#### Best designs, up to 3 % torque shortfall at high speed

Design | Stator | Yoke (mm) | Stack (mm) | Turns × (strands × d) | Worst envelope | Range, telematics | Range, WMTC | Saving (INR) | Winding loss at peak (W) | Mass change (kg)
B1 L78 N8 6x1.42 | B1 | 8.85 | 78 | 8 × (6 × 1.42) | 99.7 % | −0.98 % | −1.49 % | 815 | 948 | +0.85
B1 L72 N9 5x1.50 | B1 | 8.85 | 72 | 9 × (5 × 1.50) | 99.5 % | −1.06 % | −1.23 % | 1072 | 1091 | +0.21
B2 L72 N9 6x1.40 | B2 | 7.85 | 72 | 9 × (6 × 1.40) | 99.6 % | −1.11 % | −1.40 % | 1106 | 1043 | +0.09
B3 L66 N10 5x1.50 | B3 | 7.85 | 66 | 10 × (5 × 1.50) | 98.8 % | −1.14 % | −1.41 % | 1389 | 1143 | −0.64
B1 L64 N10 3x1.83 | B1 | 8.85 | 64 | 10 × (3 × 1.83) | 98.1 % | −1.27 % | −1.41 % | 1429 | 1258 | −0.68
B1 L64 N10 5x1.40 | B1 | 8.85 | 64 | 10 × (5 × 1.40) | 98.0 % | −1.29 % | −1.46 % | 1434 | 1287 | −0.69
B1 L64 N10 6x1.25 | B1 | 8.85 | 64 | 10 × (6 × 1.25) | 97.7 % | −1.54 % | −1.67 % | 1443 | 1345 | −0.71
B1 L64 N10 4x1.50 | B1 | 8.85 | 64 | 10 × (4 × 1.50) | 97.4 % | −1.82 % | −1.92 % | 1450 | 1401 | −0.73

At the copper stack of 64 mm, no design at this OD keeps full torque at every speed; with up to 3 % shortfall at high speed the best is B1 L64 N10 3x1.83: range -1.27 %, saving ₹1429.

### Effect of stack length and turns

Best design (range) at each stack length and turn count at OD 165, among those within 3 %

Best design (range) at each stack length and turn count at OD 165, among those within 3 % of copper torque; filled dots also meet the full criterion. Fewer turns need a longer stack for the same torque at 360 A.

### Designs in detail

| Copper (today) | Least range loss | Largest saving, full torque | Largest saving, ≤ 3 % high-speed torque
Design | Cu SWG 11 | B1 L78 N8 6x1.42 | B3 L68 N10 5x1.50 | B1 L64 N10 5x1.40
Stator OD (mm) | 160 | 165 | 165 | 165
Stator variant | D0 | B1 | B3 | B1
Stack length, stator = rotor = magnets (mm) | 64 | 78 | 68 | 64
Slot depth (mm) | 17.65 | 20.15 | 21.15 | 20.15
Tooth width (mm) | 15.54 | 15.54 | 14.54 | 15.54
Yoke (mm) | 8.85 | 8.85 | 7.85 | 8.85
Slot area (mm²) | 281.2 (×1.000) | 336.9 (×1.198) | 378.6 (×1.346) | 336.9 (×1.198)
Turns per coil | 10 | 8 | 10 | 10
Strands × bare diameter (mm) | 1 × 2.95 | 6 × 1.42 | 5 × 1.50 | 5 × 1.40
Conductor area (mm²) | 6.82 | 9.53 | 8.84 | 7.70
Insulated fill | 0.513 | 0.493 | 0.507 | 0.498
Mean turn length (mm) | 203.6 | 232.7 | 212.6 | 204.7
Resistance per path, 100 °C (mΩ) | 13.48 | 14.60 | 17.98 | 19.88
Peak torque, 1000 rpm (N·m) | 44.11 | 43.98 | 45.34 | 43.90
Worst envelope ratio vs copper | – | 99.7 % | 99.1 % | 98.0 %
Winding loss at peak torque (W) | 885 | 948 | 1165 | 1287
Current density at peak (A/mm² rms) | 15.2 | 10.9 | 11.7 | 13.5
Peak efficiency (%) | 95.36 | 95.28 | 95.14 | 95.04
Map efficiency, mean change (points) | – | −0.66 | −0.93 | −1.37
Telematics: Wh/km at motor terminals | 61.291 | 61.900 | 62.132 | 62.092
Range change, telematics | – | −0.98 % | −1.35 % | −1.29 %
Range change, WMTC Class 1 | – | −1.49 % | −1.37 % | −1.46 %
Winding mass (kg) | 1.488 | 0.575 | 0.609 | 0.511
Stator laminations (kg) | 3.635 | 4.781 | 3.916 | 3.923
Rotor laminations + magnets (kg) | 2.832 | 3.451 | 3.009 | 2.832
Active mass (kg) | 7.955 | 8.808 | 7.534 | 7.266
Material cost (INR) | 4349 | 3534 | 3047 | 2915
Saving vs copper (INR) | – | 815 (18.7 %) | 1302 (29.9 %) | 1434 (33.0 %)

### Torque-speed envelope

Maximum shaft torque at each speed against copper, same drive limits. Right: ratio to copp

Maximum shaft torque at each speed against copper, same drive limits. Right: ratio to copper; dotted lines 99 % and 97 %.

### Efficiency maps against copper

Efficiency change against copper at the same speed and shaft torque (blue = aluminium bett

Efficiency change against copper at the same speed and shaft torque (blue = aluminium better). Triangles: OP1–OP3.

Efficiency map of B1 L64 N10 5x1.40.

Efficiency map of B1 L64 N10 5x1.40.

### Operating points OP1, OP2, OP3

Efficiency change vs copper (points) | Least range loss | Largest saving, full torque | Largest saving, ≤ 3 % high-speed torque
OP1: 9000 rpm, maximum power | +2.50 | +1.19 | +1.04
OP2: 9339 rpm, 3.24 N·m | +0.44 | +1.06 | +1.77
OP3: 2000 rpm, maximum torque | −0.39 | −1.97 | −3.22

Loss breakdown at the operating points; label = total loss and efficiency.

Loss breakdown at the operating points; label = total loss and efficiency.

OP1 · 9000 rpm, maximum power | Motor-CAD, copper | Copper (FEMM) | Least range loss | Largest saving, full torque | Largest saving, ≤ 3 % high-speed torque
Shaft torque (N·m) | 13.98 | 14.05 | 14.42 | 14.22 | 14.19
Electromagnetic torque (N·m) | 14.46 | 14.50 | 14.91 | 14.73 | 14.68
Shaft power (W) | 13178 | 13239 | 13590 | 13398 | 13378
Input power (W) | 14560 | 14552 | 14538 | 14537 | 14540
Efficiency (%) | 90.51 | 90.97 | 93.47 | 92.16 | 92.01
Line current (A rms) | 247.2 | 236.3 | 241.5 | 249.0 | 250.5
Phase current (A rms, delta) | 142.7 | 136.4 | 139.4 | 143.8 | 144.6
Id, phase (A peak) | −184.2 | −173.3 | −175.4 | −185.7 | −185.7
Iq, phase (A peak) | 82.5 | 84.7 | 90.1 | 82.7 | 85.6
Phase advance (° el) | 65.9 | 63.9 | 62.8 | 66.0 | 65.2
Phase voltage (V peak, limit 49.4) | 49.40 | 49.38 | 49.13 | 49.30 | 49.27
Power factor | 0.974 | 0.983 | 0.996 | 0.960 | 0.957
ψd (mV·s) | 1.72 | 2.68 | 5.40 | 1.27 | 1.24
ψq (mV·s) | 9.69 | 9.85 | 8.56 | 10.01 | 9.97
DC bus current (A) | 280.0 | 279.9 | 279.6 | 279.6 | 279.6
Current density (A/mm² rms) | – | 10.0 | 7.3 | 8.1 | 9.4
Active limit | – | voltage, DC current | voltage, DC current | voltage, DC current | voltage, DC current
DC winding loss (W) | 411.7 | 376.2 | 425.8 | 557.5 | 623.7
AC winding loss (W) | 526.5 | 505.5 | 60.6 | 96.9 | 80.5
Stator hysteresis (W) | – | 71.6 | 83.1 | 84.3 | 77.2
Stator eddy (W) | – | 125.7 | 143.8 | 152.1 | 138.7
Stator iron total (W) | 205.3 | 197.4 | 226.9 | 236.4 | 215.9
Rotor iron (W) | 89.4 | 85.7 | 76.8 | 96.6 | 92.9
Iron total (W) | 294.7 | 283.1 | 303.6 | 333.1 | 308.8
Bearings + windage (W) | 148.9 | 148.9 | 158.6 | 151.7 | 148.9
Total loss (W) | 1381.8 | 1313.6 | 948.7 | 1139.1 | 1161.8

OP2 · 9339 rpm, 3.24 N·m | Copper (FEMM) | Least range loss | Largest saving, full torque | Largest saving, ≤ 3 % high-speed torque
Shaft torque (N·m) | 3.27 | 3.29 | 3.27 | 3.26
Electromagnetic torque (N·m) | 3.62 | 3.70 | 3.66 | 3.62
Shaft power (W) | 3195 | 3218 | 3200 | 3189
Input power (W) | 3785 | 3793 | 3744 | 3700
Efficiency (%) | 84.41 | 84.85 | 85.47 | 86.18
Line current (A rms) | 120.7 | 141.8 | 125.2 | 119.2
Phase current (A rms, delta) | 69.7 | 81.8 | 72.3 | 68.8
Id, phase (A peak) | −96.2 | −113.4 | −100.1 | −94.9
Iq, phase (A peak) | 21.8 | 23.0 | 20.9 | 21.8
Phase advance (° el) | 77.2 | 78.6 | 78.2 | 77.1
Phase voltage (V peak, limit 49.4) | 49.22 | 49.39 | 49.30 | 49.32
Power factor | 0.499 | 0.440 | 0.491 | 0.511
ψd (mV·s) | 9.59 | 9.74 | 9.57 | 9.56
ψq (mV·s) | 2.84 | 2.38 | 2.87 | 2.89
DC bus current (A) | 72.8 | 72.9 | 72.0 | 71.2
Current density (A/mm² rms) | 5.1 | 4.3 | 4.1 | 4.5
Active limit | voltage | voltage | voltage | voltage
DC winding loss (W) | 98.3 | 146.7 | 141.0 | 141.3
AC winding loss (W) | 150.4 | 23.5 | 27.7 | 20.7
Stator hysteresis (W) | 54.2 | 71.3 | 64.1 | 57.0
Stator eddy (W) | 99.6 | 129.5 | 117.8 | 104.8
Stator iron total (W) | 153.8 | 200.8 | 181.9 | 161.7
Rotor iron (W) | 31.6 | 37.1 | 34.2 | 31.4
Iron total (W) | 185.4 | 237.9 | 216.1 | 193.1
Bearings + windage (W) | 156.2 | 166.4 | 159.1 | 156.2
Total loss (W) | 590.2 | 574.5 | 543.9 | 511.4

OP3 · 2000 rpm, maximum torque | Motor-CAD, copper | Copper (FEMM) | Least range loss | Largest saving, full torque | Largest saving, ≤ 3 % high-speed torque
Shaft torque (N·m) | 44.11 | 44.06 | 43.89 | 45.27 | 43.85
Electromagnetic torque (N·m) | 44.76 | 44.67 | 44.58 | 45.98 | 44.50
Shaft power (W) | 9239 | 9227 | 9192 | 9481 | 9184
Input power (W) | 10306 | 10284 | 10289 | 10804 | 10616
Efficiency (%) | 89.65 | 89.73 | 89.33 | 87.76 | 86.51
Line current (A rms) | 360.0 | 360.0 | 360.0 | 360.0 | 360.0
Phase current (A rms, delta) | 207.8 | 207.8 | 207.8 | 207.8 | 207.8
Id, phase (A peak) | −85.0 | −90.8 | −82.6 | −98.1 | −92.7
Iq, phase (A peak) | 281.4 | 279.6 | 282.1 | 277.1 | 279.0
Phase advance (° el) | 16.8 | 18.0 | 16.3 | 19.5 | 18.4
Phase voltage (V peak, limit 49.4) | 34.36 | 33.85 | 31.07 | 35.16 | 34.63
Power factor | 0.680 | 0.685 | 0.751 | 0.696 | 0.695
ψd (mV·s) | 12.48 | 12.00 | 13.90 | 11.62 | 11.66
ψq (mV·s) | 28.90 | 28.65 | 24.49 | 29.68 | 28.93
DC bus current (A) | 198.2 | 197.8 | 197.9 | 207.8 | 204.2
Current density (A/mm² rms) | – | 15.2 | 10.9 | 11.8 | 13.5
Active limit | – | 360 A | 360 A | 360 A | 360 A
DC winding loss (W) | 873.5 | 873.5 | 946.2 | 1165.2 | 1288.0
AC winding loss (W) | 57.4 | 54.7 | 6.4 | 9.1 | 7.7
Stator hysteresis (W) | – | 61.2 | 73.9 | 75.1 | 67.3
Stator eddy (W) | – | 20.4 | 23.4 | 24.9 | 22.4
Stator iron total (W) | 87.4 | 81.5 | 97.3 | 100.0 | 89.7
Rotor iron (W) | 27.7 | 25.9 | 25.0 | 26.9 | 25.8
Iron total (W) | 115.1 | 107.4 | 122.3 | 126.9 | 115.5
Bearings + windage (W) | 21.1 | 21.1 | 22.4 | 21.5 | 21.1
Total loss (W) | 1067.1 | 1056.6 | 1097.4 | 1322.7 | 1432.3

### Drive cycle and range

Design | Cycle | Net Wh/km | Shaft out, motoring | Electrical in, motoring | η motoring (%) | Shaft in, regen | Electrical out, regen | η regen (%) | DC winding loss | AC winding loss | Iron loss | Mech. loss | Total loss | Range change
Copper | Telematics | 61.291 | 81.53 | 87.83 | 92.82 | 28.55 | 26.54 | 92.97 | 2.82 | 0.84 | 3.04 | 1.61 | 8.32 | –
| WMTC Class 1 | 60.520 | 76.21 | 81.72 | 93.26 | 22.91 | 21.20 | 92.55 | 2.13 | 0.40 | 3.10 | 1.59 | 7.22 | –
Least range loss | Telematics | 61.900 | 81.70 | 88.35 | 92.48 | 28.58 | 26.45 | 92.54 | 3.13 | 0.10 | 3.84 | 1.72 | 8.78 | −0.98 %
| WMTC Class 1 | 61.433 | 76.21 | 82.41 | 92.48 | 22.91 | 20.97 | 91.55 | 2.46 | 0.05 | 3.93 | 1.69 | 8.13 | −1.49 %
Largest saving, full torque | Telematics | 62.132 | 81.60 | 88.50 | 92.20 | 28.55 | 26.37 | 92.35 | 3.70 | 0.15 | 3.60 | 1.64 | 9.09 | −1.35 %
| WMTC Class 1 | 61.363 | 76.21 | 82.34 | 92.56 | 22.91 | 20.98 | 91.56 | 2.70 | 0.07 | 3.68 | 1.62 | 8.06 | −1.37 %
Largest saving, ≤ 3 % high-speed torque | Telematics | 62.092 | 81.42 | 88.40 | 92.11 | 28.54 | 26.31 | 92.17 | 4.22 | 0.12 | 3.25 | 1.61 | 9.21 | −1.29 %
| WMTC Class 1 | 61.418 | 76.21 | 82.36 | 92.53 | 22.91 | 20.94 | 91.42 | 3.17 | 0.06 | 3.31 | 1.59 | 8.12 | −1.46 %

Energies and losses in Wh/km at the motor (motor losses only; inverter, battery and vehicle are the same for every design).

Motor losses over the telematics cycle by type.

Motor losses over the telematics cycle by type.

Where the range is lost: extra loss against copper over the telematics cycle, by motor spe

Where the range is lost: extra loss against copper over the telematics cycle, by motor speed band, motoring (left) and regenerating (right).

### Cost

Design | Winding (kg) | Wire (INR) | Laminations (kg) | Laminations (INR) | Magnets (kg) | Magnets (INR) | Total (INR) | Saving, Al ₹370 | Saving, Al ₹230 | Saving, Al ₹450
Copper | 1.488 | 1719 | 5.087 | 1526 | 1.380 | 1104 | 4349 | – | – | –
Least range loss | 0.575 | 224 | 6.550 | 1965 | 1.682 | 1346 | 3534 | 815 | 899 | 767
Largest saving, full torque | 0.609 | 237 | 5.458 | 1637 | 1.466 | 1173 | 3047 | 1302 | 1392 | 1251
Largest saving, ≤ 3 % high-speed torque | 0.511 | 199 | 5.375 | 1612 | 1.380 | 1104 | 2915 | 1434 | 1509 | 1391

Design9795 · aluminium winding

## OD 167 mm

The housing limit. With the copper yoke and tooth the slot is 3.5 mm deeper (×1.281); with a 1 mm thinner yoke 4.5 mm deeper (×1.365). This OD gives the best designs at every cost level. 648 designs evaluated at this OD; 129 keep full torque at every speed, 295 stay within 3 %.

### Stator variants at OD 167

Stator | OD | Slot depth | Tooth | Yoke | Slot area (mm²) | vs copper | Max torque (N·m)* | vs copper | Tooth B 99 % (T) | Yoke B 99 % (T) | Stator steel (kg)*
D0 | 160 | 17.65 | 15.54 | 8.85 | 281.2 | ×1.000 | 50.62 | +0.0 % | 2.28 | 1.70 | 3.635
F1 | 167 | 21.15 | 15.54 | 8.85 | 360.2 | ×1.281 | 50.31 | −0.6 % | 2.28 | 1.70 | 4.038
F2 | 167 | 22.15 | 15.54 | 7.85 | 383.8 | ×1.365 | 49.58 | −2.1 % | 2.27 | 1.78 | 3.903
F3 | 167 | 22.15 | 14.54 | 7.85 | 403.3 | ×1.434 | 48.67 | −3.9 % | 2.26 | 1.76 | 3.792
F4 | 167 | 23.15 | 14.54 | 6.85 | 428.6 | ×1.524 | 47.25 | −6.6 % | 2.24 | 1.82 | 3.647

* FEMM 2D, 64 mm stack, 10 turns per coil, peak over the 4 × 4 current grid at 360 A (no skew). Dimensions in mm.

Slot outlines of the OD 167 stators against the copper stator (D0). Tooth tip and slot ope

Slot outlines of the OD 167 stators against the copper stator (D0). Tooth tip and slot opening are unchanged in every variant.

### Cost against range

All designs at OD 167. Dark: full torque at every speed; light blue: within 3 %; grey: nei

All designs at OD 167. Dark: full torque at every speed; light blue: within 3 %; grey: neither. Line: best designs (full). Circles: designs detailed below.

#### Best designs, full torque at every speed

Design | Stator | Yoke (mm) | Stack (mm) | Turns × (strands × d) | Worst envelope | Range, telematics | Range, WMTC | Saving (INR) | Winding loss at peak (W) | Mass change (kg)
F1 L78 N8 6x1.50 | F1 | 8.85 | 78 | 8 × (6 × 1.50) | 99.5 % | −0.74 % | −1.28 % | 747 | 854 | +1.06
F1 L78 N8 5x1.63 | F1 | 8.85 | 78 | 8 × (5 × 1.63) | 99.5 % | −0.83 % | −1.37 % | 752 | 872 | +1.05
F2 L72 N9 5x1.60 | F2 | 7.85 | 72 | 9 × (5 × 1.60) | 100.0 % | −0.95 % | −1.28 % | 1047 | 961 | +0.27
F2 L66 N10 4x1.70 | F2 | 7.85 | 66 | 10 × (4 × 1.70) | 99.0 % | −1.09 % | −1.21 % | 1314 | 1119 | −0.39

#### Best designs, up to 3 % torque shortfall at high speed

Design | Stator | Yoke (mm) | Stack (mm) | Turns × (strands × d) | Worst envelope | Range, telematics | Range, WMTC | Saving (INR) | Winding loss at peak (W) | Mass change (kg)
F1 L78 N8 6x1.50 | F1 | 8.85 | 78 | 8 × (6 × 1.50) | 99.5 % | −0.74 % | −1.28 % | 747 | 854 | +1.06
F1 L78 N8 5x1.63 | F1 | 8.85 | 78 | 8 × (5 × 1.63) | 99.5 % | −0.83 % | −1.37 % | 752 | 872 | +1.05
F2 L72 N9 5x1.60 | F2 | 7.85 | 72 | 9 × (5 × 1.60) | 100.0 % | −0.95 % | −1.28 % | 1047 | 961 | +0.27
F2 L66 N10 4x1.70 | F2 | 7.85 | 66 | 10 × (4 × 1.70) | 99.0 % | −1.09 % | −1.21 % | 1314 | 1119 | −0.39
F2 L66 N10 5x1.50 | F2 | 7.85 | 66 | 10 × (5 × 1.50) | 98.9 % | −1.16 % | −1.30 % | 1321 | 1148 | −0.41
F2 L66 N10 3x1.90 | F2 | 7.85 | 66 | 10 × (3 × 1.90) | 98.7 % | −1.45 % | −1.53 % | 1329 | 1194 | −0.43
F2 L66 N10 6x1.32 | F2 | 7.85 | 66 | 10 × (6 × 1.32) | 98.5 % | −1.49 % | −1.60 % | 1337 | 1235 | −0.45

At the copper stack of 64 mm, no design at this OD meets either criterion: aluminium at 64 mm loses torque either at low speed (fewer turns, 360 A limit) or above 2500 rpm (10 turns, higher resistance).

### Effect of stack length and turns

Best design (range) at each stack length and turn count at OD 167, among those within 3 %

Best design (range) at each stack length and turn count at OD 167, among those within 3 % of copper torque; filled dots also meet the full criterion. Fewer turns need a longer stack for the same torque at 360 A.

### Designs in detail

| Copper (today) | Least range loss | Cooler alternative | Recommended
Design | Cu SWG 11 | F1 L78 N8 6x1.50 | F2 L72 N9 5x1.60 | F2 L66 N10 4x1.70
Stator OD (mm) | 160 | 167 | 167 | 167
Stator variant | D0 | F1 | F2 | F2
Stack length, stator = rotor = magnets (mm) | 64 | 78 | 72 | 66
Slot depth (mm) | 17.65 | 21.15 | 22.15 | 22.15
Tooth width (mm) | 15.54 | 15.54 | 15.54 | 15.54
Yoke (mm) | 8.85 | 8.85 | 7.85 | 7.85
Slot area (mm²) | 281.2 (×1.000) | 360.2 (×1.281) | 383.8 (×1.365) | 383.8 (×1.365)
Turns per coil | 10 | 8 | 9 | 10
Strands × bare diameter (mm) | 1 × 2.95 | 6 × 1.50 | 5 × 1.60 | 4 × 1.70
Conductor area (mm²) | 6.82 | 10.60 | 10.05 | 9.08
Insulated fill | 0.513 | 0.511 | 0.510 | 0.510
Mean turn length (mm) | 203.6 | 233.1 | 221.5 | 209.5
Resistance per path, 100 °C (mΩ) | 13.48 | 13.15 | 14.82 | 17.25
Peak torque, 1000 rpm (N·m) | 44.11 | 43.91 | 44.44 | 44.62
Worst envelope ratio vs copper | – | 99.5 % | 100.0 % | 99.0 %
Winding loss at peak torque (W) | 885 | 854 | 961 | 1119
Current density at peak (A/mm² rms) | 15.2 | 9.8 | 10.3 | 11.4
Peak efficiency (%) | 95.36 | 95.40 | 95.28 | 95.16
Map efficiency, mean change (points) | – | −0.30 | −0.45 | −0.78
Telematics: Wh/km at motor terminals | 61.291 | 61.750 | 61.878 | 61.968
Range change, telematics | – | −0.74 % | −0.95 % | −1.09 %
Range change, WMTC Class 1 | – | −1.28 % | −1.28 % | −1.21 %
Winding mass (kg) | 1.488 | 0.641 | 0.650 | 0.617
Stator laminations (kg) | 3.635 | 4.921 | 4.391 | 4.025
Rotor laminations + magnets (kg) | 2.832 | 3.451 | 3.186 | 2.920
Active mass (kg) | 7.955 | 9.014 | 8.227 | 7.562
Material cost (INR) | 4349 | 3602 | 3302 | 3035
Saving vs copper (INR) | – | 747 (17.2 %) | 1047 (24.1 %) | 1314 (30.2 %)

### Torque-speed envelope

Maximum shaft torque at each speed against copper, same drive limits. Right: ratio to copp

Maximum shaft torque at each speed against copper, same drive limits. Right: ratio to copper; dotted lines 99 % and 97 %.

### Efficiency maps against copper

Efficiency change against copper at the same speed and shaft torque (blue = aluminium bett

Efficiency change against copper at the same speed and shaft torque (blue = aluminium better). Triangles: OP1–OP3.

Efficiency map of F2 L66 N10 4x1.70.

Efficiency map of F2 L66 N10 4x1.70.

### Operating points OP1, OP2, OP3

Efficiency change vs copper (points) | Least range loss | Cooler alternative | Recommended
OP1: 9000 rpm, maximum power | +2.65 | +1.89 | +0.97
OP2: 9339 rpm, 3.24 N·m | +0.50 | +0.95 | +1.39
OP3: 2000 rpm, maximum torque | +0.38 | −0.49 | −1.77

Loss breakdown at the operating points; label = total loss and efficiency.

Loss breakdown at the operating points; label = total loss and efficiency.

OP1 · 9000 rpm, maximum power | Motor-CAD, copper | Copper (FEMM) | Least range loss | Cooler alternative | Recommended
Shaft torque (N·m) | 13.98 | 14.05 | 14.44 | 14.34 | 14.20
Electromagnetic torque (N·m) | 14.46 | 14.50 | 14.94 | 14.85 | 14.71
Shaft power (W) | 13178 | 13239 | 13609 | 13518 | 13379
Input power (W) | 14560 | 14552 | 14537 | 14557 | 14551
Efficiency (%) | 90.51 | 90.97 | 93.62 | 92.86 | 91.95
Line current (A rms) | 247.2 | 236.3 | 242.2 | 248.3 | 252.7
Phase current (A rms, delta) | 142.7 | 136.4 | 139.9 | 143.3 | 145.9
Id, phase (A peak) | −184.2 | −173.3 | −175.9 | −183.5 | −188.8
Iq, phase (A peak) | 82.5 | 84.7 | 90.4 | 86.1 | 83.3
Phase advance (° el) | 65.9 | 63.9 | 62.8 | 64.9 | 66.2
Phase voltage (V peak, limit 49.4) | 49.40 | 49.38 | 48.88 | 47.91 | 49.23
Power factor | 0.974 | 0.983 | 0.997 | 0.992 | 0.946
ψd (mV·s) | 1.72 | 2.68 | 5.27 | 3.00 | 0.73
ψq (mV·s) | 9.69 | 9.85 | 8.61 | 9.38 | 10.06
DC bus current (A) | 280.0 | 279.9 | 279.6 | 279.9 | 279.8
Current density (A/mm² rms) | – | 10.0 | 6.6 | 7.1 | 8.0
Active limit | – | voltage, DC current | DC current | DC current | voltage, DC current
DC winding loss (W) | 411.7 | 376.2 | 385.7 | 456.8 | 551.0
AC winding loss (W) | 526.5 | 505.5 | 73.4 | 105.2 | 138.9
Stator hysteresis (W) | – | 71.6 | 85.1 | 85.6 | 83.8
Stator eddy (W) | – | 125.7 | 147.3 | 150.8 | 152.1
Stator iron total (W) | 205.3 | 197.4 | 232.4 | 236.3 | 235.9
Rotor iron (W) | 89.4 | 85.7 | 77.1 | 86.5 | 96.0
Iron total (W) | 294.7 | 283.1 | 309.5 | 322.8 | 331.9
Bearings + windage (W) | 148.9 | 148.9 | 158.6 | 154.4 | 150.3
Total loss (W) | 1381.8 | 1313.6 | 927.2 | 1039.3 | 1172.1

OP2 · 9339 rpm, 3.24 N·m | Copper (FEMM) | Least range loss | Cooler alternative | Recommended
Shaft torque (N·m) | 3.27 | 3.26 | 3.28 | 3.26
Electromagnetic torque (N·m) | 3.62 | 3.68 | 3.68 | 3.64
Shaft power (W) | 3195 | 3188 | 3209 | 3193
Input power (W) | 3785 | 3755 | 3760 | 3722
Efficiency (%) | 84.41 | 84.90 | 85.36 | 85.80
Line current (A rms) | 120.7 | 141.0 | 131.2 | 121.5
Phase current (A rms, delta) | 69.7 | 81.4 | 75.8 | 70.1
Id, phase (A peak) | −96.2 | −112.8 | −104.9 | −96.9
Iq, phase (A peak) | 21.8 | 22.8 | 21.9 | 21.3
Phase advance (° el) | 77.2 | 78.6 | 78.2 | 77.6
Phase voltage (V peak, limit 49.4) | 49.22 | 49.31 | 49.17 | 49.15
Power factor | 0.499 | 0.438 | 0.471 | 0.504
ψd (mV·s) | 9.59 | 9.73 | 9.62 | 9.53
ψq (mV·s) | 2.84 | 2.38 | 2.67 | 2.92
DC bus current (A) | 72.8 | 72.2 | 72.3 | 71.6
Current density (A/mm² rms) | 5.1 | 3.8 | 3.8 | 3.9
Active limit | voltage | voltage | voltage | voltage
DC winding loss (W) | 98.3 | 130.7 | 127.7 | 127.3
AC winding loss (W) | 150.4 | 27.8 | 33.1 | 36.4
Stator hysteresis (W) | 54.2 | 72.7 | 68.1 | 61.5
Stator eddy (W) | 99.6 | 132.1 | 124.5 | 113.1
Stator iron total (W) | 153.8 | 204.8 | 192.6 | 174.5
Rotor iron (W) | 31.6 | 37.1 | 35.0 | 32.6
Iron total (W) | 185.4 | 241.8 | 227.5 | 207.2
Bearings + windage (W) | 156.2 | 166.4 | 162.0 | 157.7
Total loss (W) | 590.2 | 566.8 | 550.4 | 528.5

OP3 · 2000 rpm, maximum torque | Motor-CAD, copper | Copper (FEMM) | Least range loss | Cooler alternative | Recommended
Shaft torque (N·m) | 44.11 | 44.06 | 43.81 | 44.39 | 44.55
Electromagnetic torque (N·m) | 44.76 | 44.67 | 44.52 | 45.11 | 45.26
Shaft power (W) | 9239 | 9227 | 9176 | 9296 | 9331
Input power (W) | 10306 | 10284 | 10184 | 10418 | 10609
Efficiency (%) | 89.65 | 89.73 | 90.10 | 89.23 | 87.96
Line current (A rms) | 360.0 | 360.0 | 360.0 | 360.0 | 360.0
Phase current (A rms, delta) | 207.8 | 207.8 | 207.8 | 207.8 | 207.8
Id, phase (A peak) | −85.0 | −90.8 | −82.6 | −92.7 | −98.1
Iq, phase (A peak) | 281.4 | 279.6 | 282.1 | 279.0 | 277.1
Phase advance (° el) | 16.8 | 18.0 | 16.3 | 18.4 | 19.5
Phase voltage (V peak, limit 49.4) | 34.36 | 33.85 | 30.96 | 32.92 | 34.87
Power factor | 0.680 | 0.685 | 0.746 | 0.717 | 0.689
ψd (mV·s) | 12.48 | 12.00 | 13.85 | 12.51 | 11.30
ψq (mV·s) | 28.90 | 28.65 | 24.58 | 27.24 | 29.60
DC bus current (A) | 198.2 | 197.8 | 195.8 | 200.3 | 204.0
Current density (A/mm² rms) | – | 15.2 | 9.8 | 10.3 | 11.4
Active limit | – | 360 A | 360 A | 360 A | 360 A
DC winding loss (W) | 873.5 | 873.5 | 851.9 | 960.6 | 1117.8
AC winding loss (W) | 57.4 | 54.7 | 7.7 | 10.1 | 12.6
Stator hysteresis (W) | – | 61.2 | 76.5 | 78.5 | 75.2
Stator eddy (W) | – | 20.4 | 24.3 | 25.3 | 24.9
Stator iron total (W) | 87.4 | 81.5 | 100.8 | 103.7 | 100.1
Rotor iron (W) | 27.7 | 25.9 | 25.0 | 25.4 | 26.1
Iron total (W) | 115.1 | 107.4 | 125.8 | 129.2 | 126.2
Bearings + windage (W) | 21.1 | 21.1 | 22.4 | 21.9 | 21.3
Total loss (W) | 1067.1 | 1056.6 | 1007.8 | 1121.7 | 1277.8

### Drive cycle and range

Design | Cycle | Net Wh/km | Shaft out, motoring | Electrical in, motoring | η motoring (%) | Shaft in, regen | Electrical out, regen | η regen (%) | DC winding loss | AC winding loss | Iron loss | Mech. loss | Total loss | Range change
Copper | Telematics | 61.291 | 81.53 | 87.83 | 92.82 | 28.55 | 26.54 | 92.97 | 2.82 | 0.84 | 3.04 | 1.61 | 8.32 | –
| WMTC Class 1 | 60.520 | 76.21 | 81.72 | 93.26 | 22.91 | 21.20 | 92.55 | 2.13 | 0.40 | 3.10 | 1.59 | 7.22 | –
Least range loss | Telematics | 61.750 | 81.74 | 88.25 | 92.62 | 28.59 | 26.50 | 92.71 | 2.82 | 0.12 | 3.95 | 1.72 | 8.60 | −0.74 %
| WMTC Class 1 | 61.303 | 76.21 | 82.32 | 92.58 | 22.91 | 21.01 | 91.72 | 2.22 | 0.06 | 4.03 | 1.69 | 8.00 | −1.28 %
Cooler alternative | Telematics | 61.878 | 81.69 | 88.33 | 92.48 | 28.57 | 26.46 | 92.59 | 3.11 | 0.16 | 3.83 | 1.67 | 8.76 | −0.95 %
| WMTC Class 1 | 61.306 | 76.21 | 82.31 | 92.59 | 22.91 | 21.00 | 91.67 | 2.36 | 0.07 | 3.92 | 1.65 | 8.00 | −1.28 %
Recommended | Telematics | 61.968 | 81.54 | 88.36 | 92.29 | 28.55 | 26.39 | 92.43 | 3.62 | 0.20 | 3.53 | 1.62 | 8.98 | −1.09 %
| WMTC Class 1 | 61.263 | 76.21 | 82.26 | 92.64 | 22.91 | 21.00 | 91.66 | 2.66 | 0.09 | 3.61 | 1.60 | 7.96 | −1.21 %

Energies and losses in Wh/km at the motor (motor losses only; inverter, battery and vehicle are the same for every design).

Motor losses over the telematics cycle by type.

Motor losses over the telematics cycle by type.

Where the range is lost: extra loss against copper over the telematics cycle, by motor spe

Where the range is lost: extra loss against copper over the telematics cycle, by motor speed band, motoring (left) and regenerating (right).

### Cost

Design | Winding (kg) | Wire (INR) | Laminations (kg) | Laminations (INR) | Magnets (kg) | Magnets (INR) | Total (INR) | Saving, Al ₹370 | Saving, Al ₹230 | Saving, Al ₹450
Copper | 1.488 | 1719 | 5.087 | 1526 | 1.380 | 1104 | 4349 | – | – | –
Least range loss | 0.641 | 249 | 6.691 | 2007 | 1.682 | 1346 | 3602 | 747 | 841 | 693
Cooler alternative | 0.650 | 253 | 6.024 | 1807 | 1.553 | 1242 | 3302 | 1047 | 1143 | 993
Recommended | 0.617 | 240 | 5.522 | 1657 | 1.423 | 1139 | 3035 | 1314 | 1405 | 1262

Design9795 · aluminium winding

## Comparison across ODs

A larger OD moves the whole cost-range front up and to the right: each mm of OD adds 0.5 mm of slot depth (about 11 mm² per slot) for about 0.06 kg (₹18) of stator steel. That is cheaper than adding stack length, which also lengthens the rotor and magnets.

Left: least range loss at each OD. Right: largest saving at each OD, overall and within 1

Left: least range loss at each OD. Right: largest saving at each OD, overall and within 1 % / 1.5 % range loss.

OD | Criterion | Choice | Design | Range, telematics | Range, WMTC | Saving (INR) | Winding loss at peak (W) | Mass change (kg)
160 | full | least range loss | D0 L78 N8 4x1.63 | −1.25 % | −1.63 % | 950 | 1082 | +0.43
160 | full | within 1.5 % | D0 L78 N8 5x1.42 | −1.43 % | −1.81 % | 958 | 1131 | +0.40
160 | full | within 2 % | A5 L74 N9 5x1.50 | −1.58 % | −1.90 % | 1205 | 1106 | −0.30
160 | full | largest saving | A5 L74 N9 5x1.50 | −1.58 % | −1.90 % | 1205 | 1106 | −0.30
160 | relaxed | least range loss | D0 L78 N8 4x1.63 | −1.25 % | −1.63 % | 950 | 1082 | +0.43
160 | relaxed | within 1.5 % | A4 L72 N9 6x1.32 | −1.45 % | −1.75 % | 1259 | 1165 | −0.40
160 | relaxed | within 2 % | A4 L66 N10 6x1.25 | −1.73 % | −1.82 % | 1511 | 1363 | −1.01
160 | relaxed | largest saving | A4 L66 N10 3x1.70 | −2.29 % | −2.29 % | 1526 | 1475 | −1.05
163 | full | least range loss | G1 L78 N8 6x1.40 | −0.96 % | −1.43 % | 864 | 976 | +0.69
163 | full | within 1 % range | G1 L78 N8 6x1.40 | −0.96 % | −1.43 % | 864 | 976 | +0.69
163 | full | within 1.5 % | G3 L72 N9 5x1.50 | −1.33 % | −1.72 % | 1189 | 1086 | −0.18
163 | full | within 2 % | G3 L72 N9 5x1.50 | −1.33 % | −1.72 % | 1189 | 1086 | −0.18
163 | full | largest saving | G3 L72 N9 5x1.50 | −1.33 % | −1.72 % | 1189 | 1086 | −0.18
163 | relaxed | least range loss | G1 L78 N8 6x1.40 | −0.96 % | −1.43 % | 864 | 976 | +0.69
163 | relaxed | within 1 % range | G1 L78 N8 6x1.40 | −0.96 % | −1.43 % | 864 | 976 | +0.69
163 | relaxed | within 1.5 % | G3 L66 N10 6x1.32 | −1.32 % | −1.55 % | 1439 | 1227 | −0.79
163 | relaxed | within 2 % | G1 L64 N10 3x1.70 | −1.95 % | −1.99 % | 1492 | 1452 | −0.86
163 | relaxed | largest saving | G1 L64 N10 3x1.70 | −1.95 % | −1.99 % | 1492 | 1452 | −0.86
165 | full | least range loss | B1 L78 N8 6x1.42 | −0.98 % | −1.49 % | 815 | 948 | +0.85
165 | full | within 1 % range | B1 L78 N8 6x1.42 | −0.98 % | −1.49 % | 815 | 948 | +0.85
165 | full | within 1.5 % | B3 L68 N10 5x1.50 | −1.35 % | −1.37 % | 1302 | 1165 | −0.42
165 | full | within 2 % | B3 L68 N10 5x1.50 | −1.35 % | −1.37 % | 1302 | 1165 | −0.42
165 | full | largest saving | B3 L68 N10 5x1.50 | −1.35 % | −1.37 % | 1302 | 1165 | −0.42
165 | relaxed | least range loss | B1 L78 N8 6x1.42 | −0.98 % | −1.49 % | 815 | 948 | +0.85
165 | relaxed | within 1 % range | B1 L78 N8 6x1.42 | −0.98 % | −1.49 % | 815 | 948 | +0.85
165 | relaxed | within 1.5 % | B1 L64 N10 5x1.40 | −1.29 % | −1.46 % | 1434 | 1287 | −0.69
165 | relaxed | within 2 % | B1 L64 N10 4x1.50 | −1.82 % | −1.92 % | 1450 | 1401 | −0.73
165 | relaxed | largest saving | B1 L64 N10 4x1.50 | −1.82 % | −1.92 % | 1450 | 1401 | −0.73
167 | full | least range loss | F1 L78 N8 6x1.50 | −0.74 % | −1.28 % | 747 | 854 | +1.06
167 | full | within 1 % range | F2 L72 N9 5x1.60 | −0.95 % | −1.28 % | 1047 | 961 | +0.27
167 | full | within 1.5 % | F2 L66 N10 4x1.70 | −1.09 % | −1.21 % | 1314 | 1119 | −0.39
167 | full | within 2 % | F2 L66 N10 4x1.70 | −1.09 % | −1.21 % | 1314 | 1119 | −0.39
167 | full | largest saving | F2 L66 N10 4x1.70 | −1.09 % | −1.21 % | 1314 | 1119 | −0.39
167 | relaxed | least range loss | F1 L78 N8 6x1.50 | −0.74 % | −1.28 % | 747 | 854 | +1.06
167 | relaxed | within 1 % range | F2 L72 N9 5x1.60 | −0.95 % | −1.28 % | 1047 | 961 | +0.27
167 | relaxed | within 1.5 % | F2 L66 N10 6x1.32 | −1.49 % | −1.60 % | 1337 | 1235 | −0.45
167 | relaxed | within 2 % | F2 L66 N10 6x1.32 | −1.49 % | −1.60 % | 1337 | 1235 | −0.45
167 | relaxed | largest saving | F2 L66 N10 6x1.32 | −1.49 % | −1.60 % | 1337 | 1235 | −0.45

### Efficiency maps of the key designs at each OD

OD 160: efficiency change against copper.

OD 163: efficiency change against copper.

OD 165: efficiency change against copper.

OD 167: efficiency change against copper.

### What each lever does

Change | Gain | Cost
OD +1 mm (yoke and tooth kept) | Slot +0.5 mm deep, +11 mm²; torque per amp −0.1 % | +0.06 kg stator steel (₹18); new die and housing bore
Yoke −1 mm | Slot +1 mm deep, +22 mm² | Peak torque −1.3 % (yoke B 1.70 → 1.78 T)
Tooth −1 mm | Slot +15 mm² | Peak torque −1.9 %; tooth saturates earlier
Stack +2 mm | Torque and flux +3 %; resistance per N·m falls | +₹83 to ₹86 stator steel, rotor laminations and magnets; iron loss and windage +3 %
10 → 9 → 8 turns per coil | Lower resistance per path (−19 % / −36 %), wider wire | Needs about 11 % / 25 % longer stack for the same torque at 360 A
More strands of thinner wire | AC loss at high speed falls steeply (∝ d²) | Wire cost about the same; more strands to handle in winding

Design9795 · aluminium winding

## Drive cycle and range

Range is computed from energy per km at the motor terminals over two speed traces: the telematics log supplied earlier and WMTC Class 1. Range change = copper Wh/km ÷ aluminium Wh/km − 1, counting motor losses only.

Top: motor speed over the two cycles (the telematics log includes long stops). Bottom: tim

Top: motor speed over the two cycles (the telematics log includes long stops). Bottom: time spent at each operating point, over the copper efficiency map (grey).

### Vehicle and method

- Vehicle (given): GVW 757 kg, CdA 1.117 m², wheel radius 0.30 m, gear ratio 13.9. Assumed: rolling resistance 0.015, gearbox efficiency 0.95, rotating-mass factor 1.05, flat road.
- Motor torque from road load and acceleration at each 1 s step; regenerative braking down to −26.4 N·m (largest regen torque in the log), friction brakes beyond.
- Telematics: 10.75 km, 6363 steps (logging gaps skipped), motor up to 6908 rpm, 18 % of steps motoring. WMTC Class 1: 7.67 km, up to 6139 rpm.
- The logged motor torque is negative even at cruise, so energy is computed from the speed trace through the vehicle model, not from the logged torque.
- Losses are read from each design's own loss map (MTPA) at the cycle's speed and torque; points above a design's torque limit are held at the limit.
- Inverter, battery and vehicle are the same for every design, so the battery-level range change is about the motor-level change.

### All key designs

Design | Cycle | Net Wh/km | Shaft out, motoring | Electrical in, motoring | η motoring (%) | Shaft in, regen | Electrical out, regen | η regen (%) | DC winding loss | AC winding loss | Iron loss | Mech. loss | Total loss | Range change
Copper | Telematics | 61.291 | 81.53 | 87.83 | 92.82 | 28.55 | 26.54 | 92.97 | 2.82 | 0.84 | 3.04 | 1.61 | 8.32 | –
| WMTC Class 1 | 60.520 | 76.21 | 81.72 | 93.26 | 22.91 | 21.20 | 92.55 | 2.13 | 0.40 | 3.10 | 1.59 | 7.22 | –
A4 L72 N9 6x1.32 | Telematics | 62.196 | 81.59 | 88.54 | 92.16 | 28.56 | 26.34 | 92.21 | 3.78 | 0.09 | 3.63 | 1.67 | 9.17 | −1.45 %
| WMTC Class 1 | 61.600 | 76.21 | 82.51 | 92.36 | 22.91 | 20.92 | 91.29 | 2.90 | 0.04 | 3.71 | 1.65 | 8.30 | −1.75 %
A5 L74 N9 5x1.50 | Telematics | 62.274 | 81.62 | 88.61 | 92.12 | 28.56 | 26.33 | 92.19 | 3.55 | 0.12 | 3.86 | 1.69 | 9.22 | −1.58 %
| WMTC Class 1 | 61.689 | 76.21 | 82.59 | 92.27 | 22.91 | 20.91 | 91.25 | 2.69 | 0.06 | 3.98 | 1.66 | 8.39 | −1.90 %
D0 L78 N8 4x1.63 | Telematics | 62.069 | 81.67 | 88.45 | 92.33 | 28.57 | 26.38 | 92.33 | 3.56 | 0.12 | 3.58 | 1.72 | 8.97 | −1.25 %
| WMTC Class 1 | 61.525 | 76.21 | 82.47 | 92.42 | 22.91 | 20.94 | 91.40 | 2.81 | 0.06 | 3.66 | 1.69 | 8.22 | −1.63 %
drop-in (SWG 11, 64 mm) | Telematics | 62.650 | 81.32 | 88.78 | 91.60 | 28.52 | 26.13 | 91.60 | 4.70 | 0.51 | 3.03 | 1.61 | 9.85 | −2.17 %
| WMTC Class 1 | 61.765 | 76.21 | 82.62 | 92.24 | 22.91 | 20.86 | 91.04 | 3.54 | 0.24 | 3.09 | 1.59 | 8.46 | −2.02 %
G1 L78 N8 6x1.40 | Telematics | 61.883 | 81.70 | 88.33 | 92.49 | 28.58 | 26.45 | 92.54 | 3.21 | 0.10 | 3.74 | 1.72 | 8.76 | −0.96 %
| WMTC Class 1 | 61.397 | 76.21 | 82.38 | 92.52 | 22.91 | 20.98 | 91.57 | 2.53 | 0.05 | 3.82 | 1.69 | 8.10 | −1.43 %
G3 L66 N10 6x1.32 | Telematics | 62.113 | 81.47 | 88.44 | 92.12 | 28.55 | 26.33 | 92.21 | 3.98 | 0.11 | 3.48 | 1.62 | 9.19 | −1.32 %
| WMTC Class 1 | 61.471 | 76.21 | 82.41 | 92.48 | 22.91 | 20.94 | 91.40 | 2.96 | 0.05 | 3.56 | 1.60 | 8.17 | −1.55 %
G3 L72 N9 5x1.50 | Telematics | 62.118 | 81.59 | 88.48 | 92.21 | 28.57 | 26.36 | 92.29 | 3.53 | 0.12 | 3.78 | 1.67 | 9.09 | −1.33 %
| WMTC Class 1 | 61.581 | 76.21 | 82.51 | 92.37 | 22.91 | 20.93 | 91.35 | 2.71 | 0.06 | 3.87 | 1.65 | 8.28 | −1.72 %
B1 L64 N10 5x1.40 | Telematics | 62.092 | 81.42 | 88.40 | 92.11 | 28.54 | 26.31 | 92.17 | 4.22 | 0.12 | 3.25 | 1.61 | 9.21 | −1.29 %
| WMTC Class 1 | 61.418 | 76.21 | 82.36 | 92.53 | 22.91 | 20.94 | 91.42 | 3.17 | 0.06 | 3.31 | 1.59 | 8.12 | −1.46 %
B1 L78 N8 6x1.42 | Telematics | 61.900 | 81.70 | 88.35 | 92.48 | 28.58 | 26.45 | 92.54 | 3.13 | 0.10 | 3.84 | 1.72 | 8.78 | −0.98 %
| WMTC Class 1 | 61.433 | 76.21 | 82.41 | 92.48 | 22.91 | 20.97 | 91.55 | 2.46 | 0.05 | 3.93 | 1.69 | 8.13 | −1.49 %
B3 L68 N10 5x1.50 | Telematics | 62.132 | 81.60 | 88.50 | 92.20 | 28.55 | 26.37 | 92.35 | 3.70 | 0.15 | 3.60 | 1.64 | 9.09 | −1.35 %
| WMTC Class 1 | 61.363 | 76.21 | 82.34 | 92.56 | 22.91 | 20.98 | 91.56 | 2.70 | 0.07 | 3.68 | 1.62 | 8.06 | −1.37 %
F1 L78 N8 6x1.50 | Telematics | 61.750 | 81.74 | 88.25 | 92.62 | 28.59 | 26.50 | 92.71 | 2.82 | 0.12 | 3.95 | 1.72 | 8.60 | −0.74 %
| WMTC Class 1 | 61.303 | 76.21 | 82.32 | 92.58 | 22.91 | 21.01 | 91.72 | 2.22 | 0.06 | 4.03 | 1.69 | 8.00 | −1.28 %
F2 L66 N10 4x1.70 | Telematics | 61.968 | 81.54 | 88.36 | 92.29 | 28.55 | 26.39 | 92.43 | 3.62 | 0.20 | 3.53 | 1.62 | 8.98 | −1.09 %
| WMTC Class 1 | 61.263 | 76.21 | 82.26 | 92.64 | 22.91 | 21.00 | 91.66 | 2.66 | 0.09 | 3.61 | 1.60 | 7.96 | −1.21 %
F2 L72 N9 5x1.60 | Telematics | 61.878 | 81.69 | 88.33 | 92.48 | 28.57 | 26.46 | 92.59 | 3.11 | 0.16 | 3.83 | 1.67 | 8.76 | −0.95 %
| WMTC Class 1 | 61.306 | 76.21 | 82.31 | 92.59 | 22.91 | 21.00 | 91.67 | 2.36 | 0.07 | 3.92 | 1.65 | 8.00 | −1.28 %

Energies and losses in Wh/km at the motor (motor losses only; inverter, battery and vehicle are the same for every design).

### Where the range goes

Motor losses over the telematics cycle by type.

Motor losses over the telematics cycle by type.

Extra loss against copper by speed band, motoring and regenerating, telematics cycle.

Extra loss against copper by speed band, motoring and regenerating, telematics cycle.

Same for WMTC Class 1.

Same for WMTC Class 1.

- The cycles run mostly at light and medium torque below 6000 rpm. There, aluminium's higher DC resistance and the longer stacks' extra iron loss outweigh its lower AC loss.
- Copper's AC winding loss over the telematics cycle is 0.84 Wh/km; aluminium's thin strands cut it to 0.20 Wh/km (recommended), but its DC loss rises from 2.82 to 3.62 Wh/km and iron loss from 3.04 to 3.53 Wh/km.
- Each 1 % of range is about 0.61 Wh/km at the motor. Battery capacity was not given, so the battery cost of making up the range is not included.

Design9795 · aluminium winding

## Cost

Active-material cost per motor, at the prices given: copper wire ₹1100/kg, ferrite magnets ₹800/kg, M235-35A laminations ₹300/kg; aluminium wire ₹370/kg (copper ÷ 3.0, from Indian enamelled-wire prices).

Design | Winding (kg) | Wire (INR) | Laminations (kg) | Laminations (INR) | Magnets (kg) | Magnets (INR) | Total (INR) | Saving, Al ₹370 | Saving, Al ₹230 | Saving, Al ₹450
Copper | 1.488 | 1719 | 5.087 | 1526 | 1.380 | 1104 | 4349 | – | – | –
A4 L72 N9 6x1.32 | 0.526 | 204 | 5.480 | 1644 | 1.553 | 1242 | 3090 | 1259 | 1336 | 1215
A5 L74 N9 5x1.50 | 0.578 | 224 | 5.477 | 1643 | 1.596 | 1277 | 3144 | 1205 | 1290 | 1156
D0 L78 N8 4x1.63 | 0.499 | 194 | 6.200 | 1860 | 1.682 | 1346 | 3399 | 950 | 1023 | 908
drop-in (SWG 11, 64 mm) | 0.450 | 175 | 5.087 | 1526 | 1.380 | 1104 | 2805 | 1544 | 1610 | 1506
G1 L78 N8 6x1.40 | 0.557 | 216 | 6.410 | 1923 | 1.682 | 1346 | 3485 | 864 | 946 | 817
G3 L66 N10 6x1.32 | 0.554 | 215 | 5.188 | 1556 | 1.423 | 1139 | 2910 | 1439 | 1520 | 1392
G3 L72 N9 5x1.50 | 0.568 | 221 | 5.659 | 1698 | 1.553 | 1242 | 3161 | 1189 | 1272 | 1141
B1 L64 N10 5x1.40 | 0.511 | 199 | 5.375 | 1612 | 1.380 | 1104 | 2915 | 1434 | 1509 | 1391
B1 L78 N8 6x1.42 | 0.575 | 224 | 6.550 | 1965 | 1.682 | 1346 | 3534 | 815 | 899 | 767
B3 L68 N10 5x1.50 | 0.609 | 237 | 5.458 | 1637 | 1.466 | 1173 | 3047 | 1302 | 1392 | 1251
F1 L78 N8 6x1.50 | 0.641 | 249 | 6.691 | 2007 | 1.682 | 1346 | 3602 | 747 | 841 | 693
F2 L66 N10 4x1.70 | 0.617 | 240 | 5.522 | 1657 | 1.423 | 1139 | 3035 | 1314 | 1405 | 1262
F2 L72 N9 5x1.60 | 0.650 | 253 | 6.024 | 1807 | 1.553 | 1242 | 3302 | 1047 | 1143 | 993

- Aluminium wire is about 8 % of the motor's material cost, so its price moves the saving by only about ±₹100 between ₹230 and ₹450/kg. The ranking of the designs does not change.
- Longer stacks add stator steel, rotor laminations and magnets: about ₹41–43 per mm of stack. A larger OD adds only stator steel, about ₹18 per mm of OD.
- Lamination cost is on net mass (stator + rotor). The larger blank at OD 167 (gross 12.77 → 14.32 kg for the recommended design) is not included, nor are the die, housing, terminations and winding process.
- Copper's active-material cost is ₹4349: wire ₹1719, laminations ₹1526, magnets ₹1104.

Design9795 · aluminium winding

## Recommended design: changes

OD 167 mm, stator F2, 66 mm stack, 10 turns of 4 × 1.70 mm aluminium: −₹1314 per motor, range -1.09 % (telematics) / -1.21 % (WMTC), torque within 1 % of copper at every speed.

| Copper (today) | Recommended
Design | Cu SWG 11 | F2 L66 N10 4x1.70
Stator OD (mm) | 160 | 167
Stator variant | D0 | F2
Stack length, stator = rotor = magnets (mm) | 64 | 66
Slot depth (mm) | 17.65 | 22.15
Tooth width (mm) | 15.54 | 15.54
Yoke (mm) | 8.85 | 7.85
Slot area (mm²) | 281.2 (×1.000) | 383.8 (×1.365)
Turns per coil | 10 | 10
Strands × bare diameter (mm) | 1 × 2.95 | 4 × 1.70
Conductor area (mm²) | 6.82 | 9.08
Insulated fill | 0.513 | 0.510
Mean turn length (mm) | 203.6 | 209.5
Resistance per path, 100 °C (mΩ) | 13.48 | 17.25
Peak torque, 1000 rpm (N·m) | 44.11 | 44.62
Worst envelope ratio vs copper | – | 99.0 %
Winding loss at peak torque (W) | 885 | 1119
Current density at peak (A/mm² rms) | 15.2 | 11.4
Peak efficiency (%) | 95.36 | 95.16
Map efficiency, mean change (points) | – | −0.78
Telematics: Wh/km at motor terminals | 61.291 | 61.968
Range change, telematics | – | −1.09 %
Range change, WMTC Class 1 | – | −1.21 %
Winding mass (kg) | 1.488 | 0.617
Stator laminations (kg) | 3.635 | 4.025
Rotor laminations + magnets (kg) | 2.832 | 2.920
Active mass (kg) | 7.955 | 7.562
Material cost (INR) | 4349 | 3035
Saving vs copper (INR) | – | 1314 (30.2 %)

Stator lamination

OD 160 → 167 mm. Slot depth 17.65 → 22.15 mm (slot bottom radius 71.15 → 75.65 mm). Yoke 8.85 → 7.85 mm. Unchanged: bore 107 mm, 12 slots, tooth 15.54 mm, tooth tip, slot opening, slot-bottom corner radius, M235-35A 0.35 mm. Slot area 281.2 → 383.8 mm². New lamination die and housing bore.

Stack length

64 → 66 mm for stator, rotor laminations and magnets (same cross-sections). Shaft, bearing span and housing +2 mm.

Winding

Aluminium EC-1350, grade-2 enamel, 4 strands in hand × 1.70 mm (about 1.77 mm over enamel), 10 turns per coil, delta, 2 parallel paths, one coil per tooth. Fill 0.510 (copper 0.513). Mean turn 209.5 mm; 17.25 mΩ per path at 100 °C (copper 13.48).

Terminations

Welded or crimped joints with aluminium-rated lugs or Al-Cu transitions (no soldering), sealed against galvanic corrosion.

Drive

Same limits. New flux and resistance tables in the controller (flux and torque per amp +3 % with the 66 mm stack); aluminium temperature coefficient 0.00403/K.

Thermal (to check)

Winding loss at peak torque 885 → 1119 W (+26 %), current density 15.2 → 11.4 A/mm². Check the peak duration in Motor-CAD Thermal. Fallback: the cooler alternative (72 mm, 9 turns × 5 × 1.60 mm, +9 %), ₹267 less saving, range +0.14 %.

Design9795 · aluminium winding

## FEMM stator variants

17 stators, each solved at 4 × 4 d-q currents over the 360 A circle and 2 rotor positions (half model, magnets 100 °C, FEA fill 1.0, as the copper model). Variants change only the slot depth, tooth width and OD; the tooth tip, slot opening, bore, rotor and air gap stay as Design9795_1.

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

* FEMM 2D, 64 mm stack, 10 turns per coil, peak over the 4 × 4 current grid at 360 A (no skew). Dimensions in mm.

- Thinning the yoke by 1 mm costs about 1.3 % of peak torque (yoke B 1.70 → 1.78 T); by 2 mm, 4.4 %.
- Thinning the teeth by 1 mm costs about 1.9 %; tooth flux density is already 2.2–2.3 T at the 99th percentile at full current in every variant.
- A larger OD with the same yoke and teeth costs at most 0.6 % (deeper slot, slightly more slot leakage).

### Check of the interpolation against direct FEMM solves

Stator | id (A) | iq (A) | ψq, copper stator (mV·s) | Δψq FEMM | Δψq model | Δψd FEMM | Δψd model | Iron-loss ratio FEMM | Iron-loss ratio model
F2 | −22 | 132 | 26.91 | +0.080 | +0.064 | −0.460 | −0.454 | 1.191 | 1.192
F2 | −44 | 88 | 20.64 | +0.328 | +0.294 | −0.318 | −0.333 | 1.211 | 1.204
F2 | −15 | 44 | 12.05 | +0.220 | +0.187 | −0.099 | −0.121 | 1.200 | 1.194
F2 | −73 | 59 | 13.70 | +0.309 | +0.278 | −0.411 | −0.422 | 1.187 | 1.182
F2 | −103 | 103 | 22.21 | +0.407 | +0.396 | −0.591 | −0.589 | 1.232 | 1.232
A4 | −22 | 132 | 26.91 | −0.861 | −0.883 | −0.421 | −0.439 | 1.061 | 1.060
A4 | −44 | 88 | 20.64 | −0.492 | −0.502 | −0.180 | −0.195 | 1.082 | 1.079
A4 | −15 | 44 | 12.05 | −0.298 | −0.325 | −0.103 | −0.135 | 1.104 | 1.098
A4 | −73 | 59 | 13.70 | −0.279 | −0.281 | −0.080 | −0.083 | 1.075 | 1.077
A4 | −103 | 103 | 22.21 | −0.459 | −0.450 | −0.124 | −0.124 | 1.080 | 1.083

Path currents between the grid nodes (10-turn equivalent), mean of 4 rotor positions (0, 3, 6, 9°). Δ = variant − copper stator at the same currents.

Design9795 · aluminium winding

## Assumptions and files

### Limits of the study

- 2D FEA; end effects only through the end-turn resistance and end-winding inductance.
- Thermal behaviour not simulated; the higher winding loss at peak torque needs a Motor-CAD thermal check.
- Aluminium wire fill held at copper's 0.513; a real aluminium winding with several strands may reach a different fill.
- AC loss by the low-frequency hybrid method; for single wires near the skin depth (about 2.6 mm hot copper, 3.3 mm aluminium at 750 Hz) it is approximate.
- Flux maps, demagnetisation, torque ripple and THD were not recomputed for these stator-only variants: the rotor is unchanged, and the slot opening and tooth tip are identical to copper's.
- Costs are active materials only.

### Files (folder Design9795_1)

File | Content
alu9795_femm.py / .json | FEMM stator variants (17 stators × 32 solves)
alu9795_study.py | Aluminium design model on the Motor-CAD-equivalent copper model
alu9795_search.py / .json | All 2755 designs: envelope, map, peak, drive cycles, cost
alu9795_analyse.py, alu9795_picks.json | Best designs per OD, criterion and Al price
alu9795_verify.py / .json | FEMM check of the interpolation
alu9795_ops.py / .json | OP1–OP3 details
build_alu9795_full.py | This report
