mishravipul361-blip/Ferrite-motor-design/Design9795_1/report_alu/alu_winding.html

Design9795_1 · copper to aluminium winding · stator only · M235-35A unchanged · OD 160–167 mm (167 hard limit) · 52 V · 360 A rms · Idc 280 A

# Aluminium winding for Design9795: cost against range

Recommended: OD 167 mm, 66 mm stack, 1 mm thinner back-iron with a 4.5 mm deeper slot, 10 turns of 4 × 1.70 mm aluminium. It saves ₹1314 per motor (30 % of the active-material cost), loses 1.09 % of range on the telematics cycle (1.21 % on WMTC Class 1), keeps the copper motor's torque within 1 % at every speed, and is 0.39 kg lighter. Aluminium cannot reach copper's efficiency within OD 167: the smallest range loss found is 0.74 % (OD 167, 78 mm stack, 8 turns), and it saves ₹747. Going from that design to the recommended one buys a further ₹567 for 0.35 % of range.

Headline (telematics cycle, Al wire ₹370/kg) | Copper | Recommended Al | Change
Active-material cost | ₹4349 | ₹3035 | −₹1314 (-30.2 %)
Energy at the motor terminals | 61.29 Wh/km | 61.97 Wh/km | range -1.09 %
Cycle motor efficiency (motoring) | 92.82 % | 92.29 % | -0.53 points
Peak efficiency | 95.36 % | 95.16 % | -0.21 points
Peak torque, 1000 rpm | 44.11 N·m | 44.62 N·m | +1.2 %
Active mass | 7.96 kg | 7.56 kg | -0.39 kg
Winding loss at peak torque (thermal) | 885 W | 1119 W | +26 %

## 1. The trade-off

Cost saving against range change

Every aluminium design evaluated (2755 designs: 17 stators × stack 64–80 mm × 8/9/10 turns per coil × 1–6 strands in hand), Al wire at ₹370/kg. Lines: best designs at each OD (no design is both cheaper and better on range). Left: designs that keep the copper motor's torque within 1 % at every speed. Right: designs allowed to lose up to 3 % in the high-speed, DC-power-limited region.

Points to the right have less range loss, points higher up save more. Every curve slopes down: moving to aluminium always costs some range, and saving more money costs more range. A larger OD moves the whole curve up and to the right, because the deeper slot holds more aluminium, so OD 167 gives the best designs. Range parity with copper is not reached anywhere within OD 167: aluminium needs 1.64× the copper's conductor area for the same resistance, while the largest slot that keeps the teeth and yoke from saturating gives at most 1.37–1.52×.

### Three aluminium designs worth considering

| Copper (today) | Drop-in (same wire size) | Least range loss | Cooler alternative | Recommended
Winding metal | Copper | Aluminium EC-1350 | Aluminium EC-1350 | Aluminium EC-1350 | Aluminium EC-1350
Stator OD (mm) | 160 | 160 | 167 | 167 | 167
Stack length, stator = rotor = magnets (mm) | 64 | 64 | 78 | 72 | 66
Slot depth (mm) | 17.65 | 17.65 | 21.15 | 22.15 | 22.15
Tooth width (mm) | 15.54 | 15.54 | 15.54 | 15.54 | 15.54
Back-iron (yoke) (mm) | 8.85 | 8.85 | 8.85 | 7.85 | 7.85
Slot area (mm²) | 281.2 (×1.000) | 281.2 (×1.000) | 360.2 (×1.281) | 383.8 (×1.365) | 383.8 (×1.365)
Turns per coil | 10 | 10 | 8 | 9 | 10
Strands in hand × bare diameter (mm) | 1 × 2.95 | 1 × 2.95 | 6 × 1.50 | 5 × 1.60 | 4 × 1.70
Conductor area per turn (mm²) | 6.82 | 6.82 | 10.60 | 10.05 | 9.08
Wire fill (insulated) | 0.513 | 0.513 | 0.511 | 0.510 | 0.510
Mean turn length (mm) | 0.2 | 0.2 | 0.2 | 0.2 | 0.2
Resistance per path, 100 °C (mΩ) | 13.48 | 22.32 | 13.15 | 14.82 | 17.25
Peak torque, 1000 rpm (N·m) | 44.11 | 44.11 | 43.91 | 44.44 | 44.62
Lowest envelope ratio vs copper | — | 97.0 % | 99.5 % | 100.0 % | 99.0 %
Winding loss at peak torque (W) | 885 | 1452 | 854 | 961 | 1119
Current density at peak (A/mm² rms) | 15.2 | 15.2 | 9.8 | 10.3 | 11.4
Peak efficiency (%) | 95.36 | 94.71 | 95.40 | 95.28 | 95.16
Map efficiency, mean change (points) | — | -2.24 | -0.30 | -0.45 | -0.78
Telematics energy (Wh/km) | 61.291 | 62.650 | 61.750 | 61.878 | 61.968
Range change, telematics | — | -2.17 % | -0.74 % | -0.95 % | -1.09 %
Range change, WMTC Class 1 | — | -2.02 % | -1.28 % | -1.28 % | -1.21 %
Winding mass (kg) | 1.488 | 0.450 | 0.641 | 0.650 | 0.617
Stator laminations (kg, net) | 3.635 | 3.635 | 4.921 | 4.391 | 4.025
Rotor laminations + magnets (kg) | 2.832 | 2.832 | 3.451 | 3.186 | 2.920
Active mass (kg) | 7.955 | 6.917 | 9.014 | 8.227 | 7.562
Material cost (INR) | 4349 | 2805 | 3602 | 3302 | 3035
Saving vs copper (INR) | — | 1544 (35.5 %) | 747 (17.2 %) | 1047 (24.1 %) | 1314 (30.2 %)

Rows highlighted: what changes against copper. All designs keep the rotor cross-section, magnets, air gap, bore 107 mm, tooth tip and slot opening, delta connection, 2 parallel paths and M235-35A. The drop-in (copper's SWG 11 size in aluminium, nothing else changed) is shown for reference: it saves the most but loses 3 % torque at 3000 rpm (1–2 % above) and 2.2 % range, and its winding loss at peak torque is 64 % higher.

Cost breakdown

Active-material cost: wire (with 5 % waste) at ₹1100/kg copper or ₹370/kg aluminium, net laminations ₹300/kg, ferrite ₹800/kg. A longer stack adds rotor laminations and magnets as well as stator steel, which is why the least-range-loss design saves less.

## 2. Results for each OD from 160 to 167 mm

Best designs at each OD (none of them both cheaper and better on range than another one at the same OD), keeping the copper motor's torque within 1 % at every speed. Highlighted: the recommended design.

OD | Stator | Stack (mm) | Turns × (strands × d) | Yoke (mm) | Envelope (worst) | Range, telematics | Range, WMTC | Saving (INR) | Winding loss at peak
160 | D0 | 78 | 8 × (4 × 1.63) | 8.85 | 99.3 % | -1.25 % | -1.63 % | 950 (21.8 %) | 1082 W
160 | D0 | 78 | 8 × (6 × 1.32) | 8.85 | 99.3 % | -1.26 % | -1.65 % | 952 (21.9 %) | 1094 W
160 | D0 | 78 | 8 × (5 × 1.42) | 8.85 | 99.0 % | -1.43 % | -1.81 % | 958 (22.0 %) | 1131 W
160 | A5 | 74 | 9 × (5 × 1.50) | 6.85 | 99.2 % | -1.58 % | -1.90 % | 1205 (27.7 %) | 1106 W
163 | G1 | 78 | 8 × (6 × 1.40) | 8.85 | 99.8 % | -0.96 % | -1.43 % | 864 (19.9 %) | 976 W
163 | G1 | 78 | 8 × (4 × 1.70) | 8.85 | 99.7 % | -1.09 % | -1.53 % | 868 (20.0 %) | 993 W
163 | G3 | 72 | 9 × (6 × 1.40) | 7.85 | 99.4 % | -1.12 % | -1.53 % | 1179 (27.1 %) | 1039 W
163 | G3 | 72 | 9 × (4 × 1.70) | 7.85 | 99.3 % | -1.24 % | -1.64 % | 1183 (27.2 %) | 1057 W
163 | G3 | 72 | 9 × (5 × 1.50) | 7.85 | 99.2 % | -1.33 % | -1.72 % | 1189 (27.3 %) | 1086 W
165 | B1 | 78 | 8 × (6 × 1.42) | 8.85 | 99.7 % | -0.98 % | -1.49 % | 815 (18.7 %) | 948 W
165 | B1 | 72 | 9 × (5 × 1.50) | 8.85 | 99.5 % | -1.06 % | -1.23 % | 1072 (24.6 %) | 1091 W
165 | B2 | 72 | 9 × (6 × 1.40) | 7.85 | 99.6 % | -1.11 % | -1.40 % | 1106 (25.4 %) | 1043 W
165 | B2 | 72 | 9 × (4 × 1.70) | 7.85 | 99.5 % | -1.26 % | -1.51 % | 1110 (25.5 %) | 1062 W
165 | B2 | 72 | 9 × (5 × 1.50) | 7.85 | 99.3 % | -1.34 % | -1.60 % | 1116 (25.7 %) | 1090 W
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
165 | B3 | 66 | 10 × (5 × 1.50) | 7.85 | 98.8 % | -1.14 % | -1.41 % | 1389 (31.9 %) | 1143 W
165 | B1 | 64 | 10 × (3 × 1.83) | 8.85 | 98.1 % | -1.27 % | -1.41 % | 1429 (32.9 %) | 1258 W
165 | B1 | 64 | 10 × (5 × 1.40) | 8.85 | 98.0 % | -1.29 % | -1.46 % | 1434 (33.0 %) | 1287 W
165 | B1 | 64 | 10 × (6 × 1.25) | 8.85 | 97.7 % | -1.54 % | -1.67 % | 1443 (33.2 %) | 1345 W
165 | B1 | 64 | 10 × (4 × 1.50) | 8.85 | 97.4 % | -1.82 % | -1.92 % | 1450 (33.3 %) | 1401 W
167 | F1 | 78 | 8 × (6 × 1.50) | 8.85 | 99.5 % | -0.74 % | -1.28 % | 747 (17.2 %) | 854 W
167 | F1 | 78 | 8 × (5 × 1.63) | 8.85 | 99.5 % | -0.83 % | -1.37 % | 752 (17.3 %) | 872 W
167 | F2 | 72 | 9 × (5 × 1.60) | 7.85 | 100.0 % | -0.95 % | -1.28 % | 1047 (24.1 %) | 961 W
167 | F2 | 66 | 10 × (4 × 1.70) | 7.85 | 99.0 % | -1.09 % | -1.21 % | 1314 (30.2 %) | 1119 W
167 | F2 | 66 | 10 × (5 × 1.50) | 7.85 | 98.9 % | -1.16 % | -1.30 % | 1321 (30.4 %) | 1148 W
167 | F2 | 66 | 10 × (3 × 1.90) | 7.85 | 98.7 % | -1.45 % | -1.53 % | 1329 (30.6 %) | 1194 W
167 | F2 | 66 | 10 × (6 × 1.32) | 7.85 | 98.5 % | -1.49 % | -1.60 % | 1337 (30.7 %) | 1235 W

What the OD buys, at full performance:

- OD 160 (same housing and lamination blank): the slot can only grow by thinning the yoke and teeth, which costs torque, so a longer stack (74–78 mm) is needed. Best range -1.25 %, best saving ₹1205 at -1.58 %.
- OD 163: best range -0.96 %, best saving ₹1189 at -1.33 %.
- OD 165: best range -0.98 %, best saving ₹1302 at -1.35 %.
- OD 167: best range -0.74 %, best saving ₹1314 at -1.09 %. Each mm of OD adds 0.5 mm of slot depth and about 11 mm² of slot area per slot, for about 0.06 kg of stator steel (₹18).

At the original 64 mm stack, no aluminium design keeps full torque at every speed at any OD up to 167. With 10 turns, the higher resistance costs voltage and power above 2500 rpm; with fewer turns, the 360 A current limit costs low-speed torque. A slightly longer stack (66 mm at OD 167) restores the torque, so the stack length had to change. The rotor lamination and magnet cross-sections stay exactly as they are; only their length changes.

## 3. Effect of stack length and turns (OD 167)

Stack length sweep

Best wire option for each stack length and turn count, stators F1 (OD 167, yoke 8.85 mm as copper) and F2 (OD 167, yoke 7.85 mm). Fewer turns need a longer stack to make the same torque at the 360 A limit; the longer stack then lowers the copper loss per N·m but adds iron loss, windage and material cost.

## 4. Performance of the recommended design

Torque envelopes

Maximum shaft torque at each speed, same drive limits as copper (52 V, modulation 0.95, 360 A rms, 280 A DC, MTPA).

Efficiency maps

Efficiency maps (winding and magnets at 100 °C). Right: change in efficiency points at the same speed and torque. Mean over the map -0.78 points; high torque below 2500 rpm -2.49 points; light load above 2000 rpm +0.07 points. Aluminium is better at high speed and light load, where copper's single 2.95 mm wire has more AC (eddy) loss than 1.70 mm strands. The small steps in the torque ratio come from the current grid of the model (±0.3 %).

### Where the extra energy goes, telematics cycle (Wh/km)

Design | DC winding | AC winding | Iron | Bearings and windage | Total loss | Motoring efficiency (%) | Energy at terminals
Copper | 2.82 | 0.84 | 3.04 | 1.61 | 8.32 | 92.82 | 61.291
Least range loss | 2.82 | 0.12 | 3.95 | 1.72 | 8.60 | 92.62 | 61.750
Cooler alternative | 3.11 | 0.16 | 3.83 | 1.67 | 8.76 | 92.48 | 61.878
Recommended | 3.62 | 0.20 | 3.53 | 1.62 | 8.98 | 92.29 | 61.968
Drop-in (same wire size) | 4.70 | 0.51 | 3.03 | 1.61 | 9.85 | 91.60 | 62.650

The recommended design has more DC winding loss (higher resistance) and more iron loss (longer stack and a slightly more saturated yoke). It has less AC winding loss, because its strands are thinner than the single 2.95 mm copper wire. On this cycle the motor works mostly at light and medium load, where iron loss counts as much as winding loss. That is why making the stack longer for less resistance stops paying back beyond about 78 mm.

## 5. Operating points OP1, OP2 and OP3

The three operating points of the earlier aluminium study: OP1 9000 rpm at maximum power, OP2 9339 rpm at 3.24 N·m (light-load high-speed cruise), OP3 2000 rpm at maximum torque (360 A rms line). In the earlier study OP3 was set at 44.34 N·m, the peak torque of that motor. Design9795 copper makes 44.11 N·m at 2000 rpm (Motor-CAD), so here OP3 is each design's own maximum at 360 A. Each point uses the least current that meets the torque within the 52 V, 360 A and 280 A DC limits (MTPA, with field weakening where needed). Winding and magnets are at 100 °C. Where Motor-CAD's envelope export has the point, copper is also shown as Motor-CAD computes it.

Loss breakdown at OP1-OP3

Loss breakdown at the three operating points; the label gives total loss and efficiency.

Efficiency change vs copper (points) | Recommended | Cooler alternative | Least range loss | Drop-in
OP1: 9000 rpm, maximum power | +0.97 | +1.89 | +2.65 | -0.59
OP2: 9339 rpm, 3.24 N·m | +1.39 | +0.95 | +0.50 | -0.07
OP3: 2000 rpm, maximum torque | -1.77 | -0.49 | +0.38 | -4.57

### OP1: 9000 rpm, maximum power

OP1 | Motor-CAD, copper | Copper (Design9795_1) | Recommended | Cooler alternative | Least range loss | Drop-in
Speed (rpm) | 9000 | 9000 | 9000 | 9000 | 9000 | 9000
Shaft torque (N·m) | 13.98 | 14.05 | 14.20 | 14.34 | 14.44 | 13.93
Electromagnetic torque (N·m) | 14.46 | 14.50 | 14.71 | 14.85 | 14.94 | 14.39
Shaft power (W) | 13178 | 13239 | 13379 | 13518 | 13609 | 13128
Input power (W) | 14560 | 14552 | 14551 | 14557 | 14537 | 14525
Efficiency (%) | 90.51 | 90.97 | 91.95 | 92.86 | 93.62 | 90.38
Line current (A rms) | 247.2 | 236.3 | 252.7 | 248.3 | 242.2 | 240.8
Phase current (A rms, delta) | 142.7 | 136.4 | 145.9 | 143.3 | 139.9 | 139.0
Id, phase (A peak) | -184.2 | -173.3 | -188.8 | -183.5 | -175.9 | -177.7
Iq, phase (A peak) | 82.5 | 84.7 | 83.3 | 86.1 | 90.4 | 84.0
Phase advance (° el) | 65.9 | 63.9 | 66.2 | 64.9 | 62.8 | 64.7
Phase voltage (V peak; limit 49.4) | 49.40 | 49.38 | 49.23 | 47.91 | 48.88 | 49.21
Power factor | 0.974 | 0.983 | 0.946 | 0.992 | 0.997 | 0.979
ψd (mV·s) | 1.72 | 2.68 | 0.73 | 3.00 | 5.27 | 2.26
ψq (mV·s) | 9.69 | 9.85 | 10.06 | 9.38 | 8.61 | 9.73
DC bus current (A) | 280.0 | 279.9 | 279.8 | 279.9 | 279.6 | 279.3
Current density (A/mm² rms) | — | 10.0 | 8.0 | 7.1 | 6.6 | 10.2
Active limit | — | voltage, DC current | voltage, DC current | DC current | DC current | voltage
DC winding loss (W) | 411.7 | 376.2 | 551.0 | 456.8 | 385.7 | 646.9
AC winding loss (W) | 526.5 | 505.5 | 138.9 | 105.2 | 73.4 | 316.4
Stator iron, hysteresis (W) | — | 71.6 | 83.8 | 85.6 | 85.1 | 71.1
Stator iron, eddy (W) | — | 125.7 | 152.1 | 150.8 | 147.3 | 126.1
Stator iron, total (W) | 205.3 | 197.4 | 235.9 | 236.3 | 232.4 | 197.2
Rotor iron (W) | 89.4 | 85.7 | 96.0 | 86.5 | 77.1 | 87.5
Iron, total (W) | 294.7 | 283.1 | 331.9 | 322.8 | 309.5 | 284.7
Bearings + windage (W) | 148.9 | 148.9 | 150.3 | 154.4 | 158.6 | 148.9
Total loss (W) | 1381.8 | 1313.6 | 1172.1 | 1039.3 | 927.2 | 1396.9

### OP2: 9339 rpm, 3.24 N·m

OP2 | Copper (Design9795_1) | Recommended | Cooler alternative | Least range loss | Drop-in
Speed (rpm) | 9339 | 9339 | 9339 | 9339 | 9339
Shaft torque (N·m) | 3.27 | 3.26 | 3.28 | 3.26 | 3.29
Electromagnetic torque (N·m) | 3.62 | 3.64 | 3.68 | 3.68 | 3.64
Shaft power (W) | 3195 | 3193 | 3209 | 3188 | 3218
Input power (W) | 3785 | 3722 | 3760 | 3755 | 3816
Efficiency (%) | 84.41 | 85.80 | 85.36 | 84.90 | 84.33
Line current (A rms) | 120.7 | 121.5 | 131.2 | 141.0 | 121.5
Phase current (A rms, delta) | 69.7 | 70.1 | 75.8 | 81.4 | 70.1
Id, phase (A peak) | -96.2 | -96.9 | -104.9 | -112.8 | -96.8
Iq, phase (A peak) | 21.8 | 21.3 | 21.9 | 22.8 | 21.9
Phase advance (° el) | 77.2 | 77.6 | 78.2 | 78.6 | 77.2
Phase voltage (V peak; limit 49.4) | 49.22 | 49.15 | 49.17 | 49.31 | 49.20
Power factor | 0.499 | 0.504 | 0.471 | 0.438 | 0.509
ψd (mV·s) | 9.59 | 9.53 | 9.62 | 9.73 | 9.53
ψq (mV·s) | 2.84 | 2.92 | 2.67 | 2.38 | 2.86
DC bus current (A) | 72.8 | 71.6 | 72.3 | 72.2 | 73.4
Current density (A/mm² rms) | 5.1 | 3.9 | 3.8 | 3.8 | 5.1
Active limit | voltage | voltage | voltage | voltage | voltage
DC winding loss (W) | 98.3 | 127.3 | 127.7 | 130.7 | 164.8
AC winding loss (W) | 150.4 | 36.4 | 33.1 | 27.8 | 91.8
Stator iron, hysteresis (W) | 54.2 | 61.5 | 68.1 | 72.7 | 54.0
Stator iron, eddy (W) | 99.6 | 113.1 | 124.5 | 132.1 | 99.4
Stator iron, total (W) | 153.8 | 174.5 | 192.6 | 204.8 | 153.4
Rotor iron (W) | 31.6 | 32.6 | 35.0 | 37.1 | 31.7
Iron, total (W) | 185.4 | 207.2 | 227.5 | 241.8 | 185.1
Bearings + windage (W) | 156.2 | 157.7 | 162.0 | 166.4 | 156.2
Total loss (W) | 590.2 | 528.5 | 550.4 | 566.8 | 597.9

### OP3: 2000 rpm, maximum torque at 360 A

OP3 | Motor-CAD, copper | Copper (Design9795_1) | Recommended | Cooler alternative | Least range loss | Drop-in
Speed (rpm) | 2000 | 2000 | 2000 | 2000 | 2000 | 2000
Shaft torque (N·m) | 44.11 | 44.06 | 44.55 | 44.39 | 43.81 | 44.06
Electromagnetic torque (N·m) | 44.76 | 44.67 | 45.26 | 45.11 | 44.52 | 44.67
Shaft power (W) | 9239 | 9227 | 9331 | 9296 | 9176 | 9227
Input power (W) | 10306 | 10284 | 10609 | 10418 | 10184 | 10835
Efficiency (%) | 89.65 | 89.73 | 87.96 | 89.23 | 90.10 | 85.16
Line current (A rms) | 360.0 | 360.0 | 360.0 | 360.0 | 360.0 | 360.0
Phase current (A rms, delta) | 207.8 | 207.8 | 207.8 | 207.8 | 207.8 | 207.8
Id, phase (A peak) | -85.0 | -90.8 | -98.1 | -92.7 | -82.6 | -90.8
Iq, phase (A peak) | 281.4 | 279.6 | 277.1 | 279.0 | 282.1 | 279.6
Phase advance (° el) | 16.8 | 18.0 | 19.5 | 18.4 | 16.3 | 18.0
Phase voltage (V peak; limit 49.4) | 34.36 | 33.85 | 34.87 | 32.92 | 30.96 | 34.75
Power factor | 0.680 | 0.685 | 0.689 | 0.717 | 0.746 | 0.705
ψd (mV·s) | 12.48 | 12.00 | 11.30 | 12.51 | 13.85 | 12.00
ψq (mV·s) | 28.90 | 28.65 | 29.60 | 27.24 | 24.58 | 28.65
DC bus current (A) | 198.2 | 197.8 | 204.0 | 200.3 | 195.8 | 208.4
Current density (A/mm² rms) | — | 15.2 | 11.4 | 10.3 | 9.8 | 15.2
Active limit | — | 360 A | 360 A | 360 A | 360 A | 360 A
DC winding loss (W) | 873.5 | 873.5 | 1117.8 | 960.6 | 851.9 | 1446.5
AC winding loss (W) | 57.4 | 54.7 | 12.6 | 10.1 | 7.7 | 33.0
Stator iron, hysteresis (W) | — | 61.2 | 75.2 | 78.5 | 76.5 | 61.2
Stator iron, eddy (W) | — | 20.4 | 24.9 | 25.3 | 24.3 | 20.4
Stator iron, total (W) | 87.4 | 81.5 | 100.1 | 103.7 | 100.8 | 81.5
Rotor iron (W) | 27.7 | 25.9 | 26.1 | 25.4 | 25.0 | 25.9
Iron, total (W) | 115.1 | 107.4 | 126.2 | 129.2 | 125.8 | 107.4
Bearings + windage (W) | 21.1 | 21.1 | 21.3 | 21.9 | 22.4 | 21.1
Total loss (W) | 1067.1 | 1056.6 | 1277.8 | 1121.7 | 1007.8 | 1608.0

Torque at OP2 within +0.05 N·m of 3.24 (current grid step). Motor-CAD splits its iron loss into stator and rotor, and into hysteresis and eddy over the whole machine (OP1: hysteresis 111 W, eddy 184 W; OP3: 86 W and 30 W), so its stator rows show the total only. At OP1, FEMM's copper iron loss is lower than Motor-CAD's (the residual hysteresis gap noted in the Lab validation) and its AC loss 4 % lower. Copper's efficiency is +0.46 points against Motor-CAD at OP1 and +0.08 at OP3.

- OP1 (9000 rpm): all three aluminium designs are more efficient than copper (+0.97, +1.89 and +2.65 points). Copper's single 2.95 mm wire has 505 W of AC (eddy) winding loss at 750 Hz. Aluminium's thinner strands (1.50–1.70 mm) and higher resistivity cut this to 73–139 W, more than the extra DC loss. The 280 A DC limit applies, so the lower loss leaves more for the shaft.
- OP2 (cruise): AC loss drops in the same way, and the recommended design is +1.39 points against copper. The longer stacks add iron loss and windage, so the least-range-loss design gains less here (+0.50).
- OP3 (peak torque): this is where aluminium costs efficiency. DC winding loss is 1118 W against copper's 873 W in the recommended design (-1.77 points), 961 W in the cooler alternative (-0.49) and 852 W in the least-range-loss design (+0.38, at -0.6 % torque). The drop-in loses 4.6 points.

Over the telematics cycle (section 4 table), the AC winding loss saved by aluminium is smaller than the extra DC winding loss and iron loss, so the range change stays negative even though aluminium wins at OP1 and OP2.

## 6. Aluminium price sensitivity

Design | Saving, Al ₹230/kg | Saving, Al ₹370/kg (base) | Saving, Al ₹450/kg
Least range loss | 841 | 747 | 693
Cooler alternative | 1143 | 1047 | 993
Recommended | 1405 | 1314 | 1262
Drop-in (same wire size) | 1610 | 1544 | 1506

Base ₹370/kg = copper ₹1100 ÷ 3.0 (Indian enamelled aluminium wire is quoted at 2.6–3× below copper; on the metal alone, LME, the ratio is about 4.8×). Aluminium wire is only about 8 % of the motor's material cost, so its price moves the saving by about ±₹100. The ranking of the designs does not change.

## 7. Complete list of changes (recommended design)

Stator lamination

OD 160 → 167 mm. Slot depth 17.65 → 22.15 mm (slot bottom radius 71.15 → 75.65 mm). Back-iron 8.85 → 7.85 mm. Unchanged: bore 107 mm, 12 slots, tooth width 15.54 mm, tooth tip, slot opening, slot-bottom corner radius, M235-35A 0.35 mm. Slot area 281.2 → 383.8 mm² (×1.365). New lamination die and a new housing bore (167 mm).

Stack length

64 → 66 mm for the stator, rotor laminations and magnets (same cross-sections; magnets +2 mm long). Shaft, bearing span and housing length to suit (+2 mm, plus the longer end windings).

Winding

Copper SWG 11 (2.946 mm), 1 strand → aluminium EC-1350 grade 2 enamel, 4 strands in hand of 1.70 mm (IEC size, about 1.77 mm over enamel). 10 turns per coil, delta, 2 parallel paths, concentrated (one coil per tooth), same as copper. Insulated wire fill 0.510 (copper 0.513). Mean turn length 0.2 mm; resistance 17.25 mΩ per path at 100 °C (copper 13.48).

Terminations

Aluminium needs welded or crimped joints with aluminium-compatible lugs or Al-Cu bimetal transitions (no soldering), with sealing against galvanic corrosion at the Al-Cu interface. 4 strands make the coils easier to wind and to form round the tooth than one 2.95 mm wire.

Drive and calibration

Same 52 V / 360 A rms / 280 A DC limits. New flux-linkage and resistance tables in the controller (ψ and torque per amp change by about +3 % with the 66 mm stack). Resistance temperature coefficient 0.00403/K for aluminium.

Thermal

Winding loss at peak torque rises from 885 W to 1119 W (+26 %). The current density falls from 15.2 to 11.4 A/mm², the stator surface is larger and the winding is spread over a longer stack. Check the peak-torque duration in Motor-CAD Thermal before release. If it does not pass, the cooler alternative (72 mm stack, 9 turns of 5 × 1.60 mm) adds only +9 % winding loss, for ₹267 less saving and -0.14 % range.

Mass

Winding 1.49 → 0.62 kg; stator steel 3.64 → 4.02 kg; rotor laminations + magnets 2.83 → 2.92 kg; active total 7.96 → 7.56 kg.

Slot drawing

One slot of the copper stator and of the recommended stator. The tooth, tip and opening are unchanged; the slot is deeper and the OD larger.

## 8. Stator variants solved in FEMM

17 stators, each solved at a 4 × 4 grid of d-q currents over the 360 A circle at 2 rotor positions (half model, magnets 100 °C), on top of the Motor-CAD-equivalent copper model (skew, Motor-CAD torque, v3 iron loss). The differences against the copper stator (flux linkage, stator iron-loss sums, slot field) are applied to the copper Lab model.

Stator | OD | Yoke (mm) | Tooth (mm) | Slot (mm²) | Max torque, 64 mm, 10 turns (N·m, 2D) | Tooth B 99th pct (T) | Yoke B 99th pct (T) | Stator steel (kg, 64 mm)
D0 | 160 | 8.85 | 15.54 | 281.2 | 50.62 | 2.28 | 1.70 | 3.635
A1 | 160 | 7.85 | 15.54 | 303.1 | 49.97 | 2.28 | 1.78 | 3.510
A4 | 160 | 7.85 | 14.54 | 319.0 | 49.16 | 2.26 | 1.76 | 3.419
G1 | 163 | 8.85 | 15.54 | 314.3 | 50.48 | 2.29 | 1.71 | 3.808
B1 | 165 | 8.85 | 15.54 | 336.9 | 50.41 | 2.28 | 1.70 | 3.923
F1 | 167 | 8.85 | 15.54 | 360.2 | 50.31 | 2.28 | 1.70 | 4.038
F2 | 167 | 7.85 | 15.54 | 383.8 | 49.58 | 2.27 | 1.78 | 3.903
F3 | 167 | 7.85 | 14.54 | 403.3 | 48.67 | 2.26 | 1.76 | 3.792
F4 | 167 | 6.85 | 14.54 | 428.6 | 47.25 | 2.24 | 1.82 | 3.647

Thinning the yoke by 1 mm costs about 1.3 % of peak torque (yoke flux density 1.70 → 1.78 T); thinning the teeth by 1 mm costs about 1.9 %. A larger OD with the same yoke and teeth costs only 0.6 % at most (the slot gets deeper, so slot leakage rises slightly). That is why the best designs keep the teeth and thin the yoke by at most 1 mm.

### Check of the interpolation against direct FEMM solves

Stator | id (A) | iq (A) | ψq copper stator (mV·s) | Δψq FEMM | Δψq model | ψd copper stator | Δψd FEMM | Δψd model | Iron-loss ratio FEMM | Iron-loss ratio model
F2 | -22 | 132 | 26.91 | +0.08 | +0.06 | 16.24 | -0.46 | -0.45 | 1.191 | 1.192
F2 | -44 | 88 | 20.64 | +0.33 | +0.29 | 12.74 | -0.32 | -0.33 | 1.211 | 1.204
F2 | -15 | 44 | 12.05 | +0.22 | +0.19 | 17.79 | -0.10 | -0.12 | 1.200 | 1.194
F2 | -73 | 59 | 13.70 | +0.31 | +0.28 | 6.15 | -0.41 | -0.42 | 1.187 | 1.182
F2 | -103 | 103 | 22.21 | +0.41 | +0.40 | 1.65 | -0.59 | -0.59 | 1.232 | 1.232
A4 | -22 | 132 | 26.91 | -0.86 | -0.88 | 16.24 | -0.42 | -0.44 | 1.061 | 1.060
A4 | -44 | 88 | 20.64 | -0.49 | -0.50 | 12.74 | -0.18 | -0.20 | 1.082 | 1.079
A4 | -15 | 44 | 12.05 | -0.30 | -0.33 | 17.79 | -0.10 | -0.13 | 1.104 | 1.098
A4 | -73 | 59 | 13.70 | -0.28 | -0.28 | 6.15 | -0.08 | -0.08 | 1.075 | 1.077
A4 | -103 | 103 | 22.21 | -0.46 | -0.45 | 1.65 | -0.12 | -0.12 | 1.080 | 1.083

Currents between the grid nodes, 4 rotor positions (0, 3, 6, 9°). Largest error of the model in ψq: 0.27 % of ψq; in the stator iron-loss ratio: 0.6 %.

## 9. Method and assumptions

Electromagnetics

Motor-CAD-equivalent FEMM Lab model of Design9795_1 (efficiency within 0.28 points of Motor-CAD over 840 map points), with the stator-variant corrections from FEMM. Turns: currents scaled by turns (same ampere-turns, same field), flux linkage × turns, end-winding inductance × turns². Stack length: flux, torque, iron loss and windage scale with length (2D); end-winding length is unchanged.

Winding

Aluminium EC-1350, 2.826 × 10⁻⁸ Ω·m at 20 °C, 0.00403/K, 2703 kg/m³; winding at 100 °C. Insulated fill held at or below copper's 0.513 (grade-2 enamel build 0.042 + 0.014 d mm). Wire sizes: IEC 60317 and SWG from 1.0 mm, 1–6 strands in hand. Mean turn length from the stack length, tooth width and coil thickness. AC loss by the hybrid method (factor 2), slot field from FEMM.

Range

Telematics speed trace (Spoke V2, 10.7 km) and WMTC Class 1 (2 × part 1 reduced, 7.7 km). Vehicle GVW 757 kg, CdA 1.117 m², wheel radius 0.30 m, ratio 13.9; assumed Crr 0.015, gearbox 0.95, rotating mass factor 1.05, flat road, regenerative braking down to −26.4 N·m. Range change = energy per km at the motor terminals, copper ÷ aluminium − 1; inverter and battery taken as equal for all designs, so the battery-level change is about the same.

Cost

Active materials only, INR/kg: copper wire 1100, aluminium wire 370 (sensitivity 230–450), ferrite 800, M235-35A finished laminations 300 (net mass, stator + rotor), wire waste 5 %. Not included: lamination die, housing, terminations, winding process, scrap from the larger blank (the gross blank goes from 12.77 to 14.32 kg).

Performance criteria

Full: peak torque at 1000 rpm ≥ 99.5 % of copper's and envelope ≥ 99 % of copper's at every speed from 0 to 9500 rpm. Relaxed: envelope ≥ 97 %.

Files

alu9795_femm.py (FEMM stator variants), alu9795_study.py (aluminium design model), alu9795_search.py (designs, cycles, cost), alu9795_analyse.py (best designs), alu9795_verify.py (FEMM check), alu9795_ops.py (OP1–OP3), build_alu9795_report.py (this report).
