mishravipul361-blip/Ferrite-motor-design/busbar/optimisation_report/report.html

# Single-plane busbar: optimisation report

Every design below was produced by the optimiser of busbar_singleplane_study.html (concept C: one copper plane, continuous coil pairs, 12 welds) and then loaded back into the page to measure it and take the pictures. Base rules: terminals within 35°, current density ≤ 12 A/mm², path imbalance ≤ 4 %, line-line imbalance ≤ 1.5 %, minimum web 1 × sheet thickness, 96 V insulation, path balancing off unless stated. Line current 360 A rms, 20 °C. Run 2026-10-08 18:37 UTC.

## How the copper cross-section is chosen

- Uniform: each track is one width all the way round.
- Each section at the J limit: every track segment, spoke body and the swap piece is cut to I ÷ (J × t), never narrower than the sheet thickness.
- Least copper: every section is first cut to the current-density limit; then the fewest grams are added back, widening the segments that lower the imbalance most per gram, until the imbalance limit is met.
- Sized for balance: each track segment is set narrow (J limit), normal, or widened into the free band around the lead circle between other-net weld pads, whichever gives the lowest worst-phase imbalance. Copper weight is ignored.
- Path balancing (separate switch): extra series resistance in the stronger path of each phase; brings the imbalance to 0 % but is an extra part to build.

Why the imbalance cannot reach zero with copper alone: each phase has two parallel paths that join the open rings about half a ring apart, while the three terminals must sit close together for one cable exit. The path whose welds are far from the terminals sees more ring resistance, and the ring segments also carry the neighbouring phase's current. More terminal span or wider copper on the weaker path reduce it; only extra resistance removes it.

## How the goals are scored

Each goal is a weighted sum of six terms, each divided by its v7 value or its rule limit (so 1.0 = as v7 / at the limit): busbar loss, height, copper, path imbalance, terminal span, cable exit. The named goal puts weight 4 on its own term and 0.3 or less on the others, so “Least copper” is mostly copper but still breaks ties on loss and imbalance. Every design must first pass every busbar rule. Search: (1) every terminal arrangement on a reference geometry, (2) a Latin-hypercube sample of all geometry inputs, uniform and J-limit sections, (3) a pattern search per goal, (4) the 10 lowest-imbalance geometries sized for balance, (5) the 10 lightest J-limit designs widened to meet the imbalance limit, (6) a final polish of each goal's winner: every section mode, then ±1 grid step on every input until nothing improves.

## v7 as built (4 stacked levels)

The design as built: three 210° rings and six series links on four stacked levels, 24 welds. Reference numbers from the explorer page.

Busbar copper

394 g

Busbar + joint loss

42.8 W

Path imbalance

2.92 %

Line-line imbalance

1.49 %

Weld plane

z 66 mm

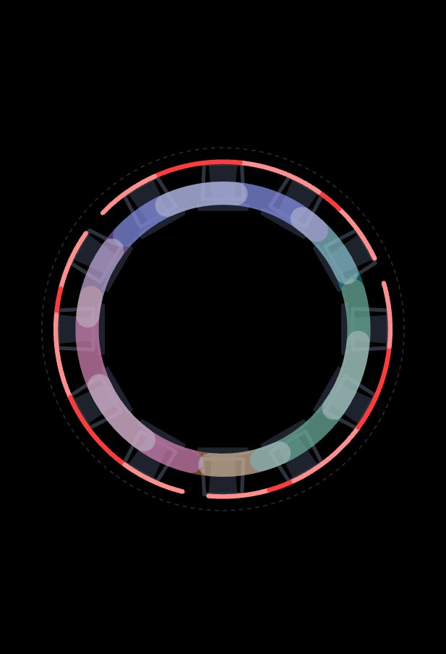
[picture p50: busbar/optimisation_report/img/v7_planJ.jpg]
v7 plan


Plan: all rings share one band (red = overlap), which is why v7 stacks them

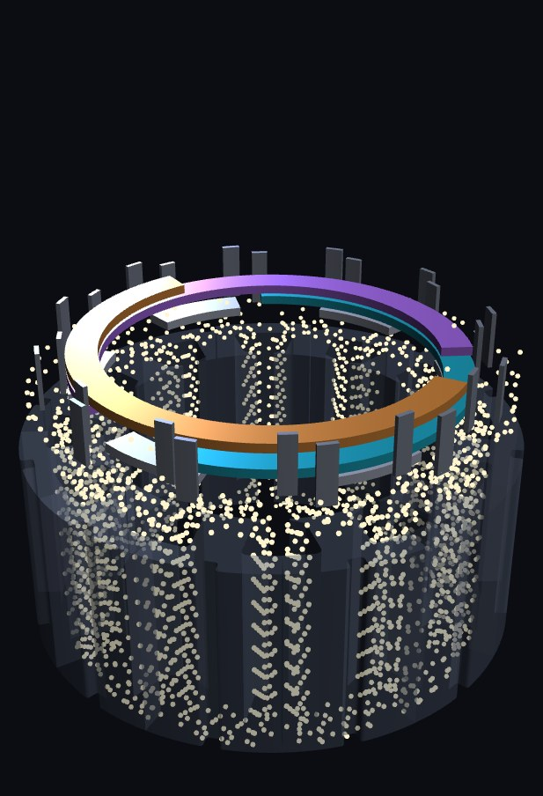
[picture p51: busbar/optimisation_report/img/v7_d3.jpg]
v7 3D


3D

## Page default (earlier balanced optimum)

Uniform: each track is one width all the way round. Against the page default: copper +0 g, worst path imbalance +0.00 points, busbar loss +0.0 W.

Why this is the optimum

Reference only (not produced by the optimiser): uniform t = 4 mm, 186.8 g, 30.85 W, imbalance 3.69 % (92 % of the 4 % limit), 19.25 mm, 34.7° span. In-plane gap (4.05 vs 4.00 mm), web, outer radius (77.98 vs 78.00) and J (12) are all at their limits. Every goal winner below beats it on its own goal.

Worst path imbalance

3.69 %

R 1.91 · Y 3.07 · B 3.69

Busbar copper

187 g

v7 394 g

Busbar + joint loss

30.9 W

total 664.7 W

Max current density

12.00 A/mm²

track 10.0 · spoke 5.3 · trans 11.0 · term 12.0

Height above stack

19.2 mm

v7 35.5 mm

Line-line imbalance

0.63 %

R_LL 3.419 mΩ

Rules

all pass

min gap 4.05 mm

What to look for in the pictures: Constant-width rings: a wide inner track and a narrow outer track. The thin outer swap piece at upper left is the hottest track part (11 A/mm²).

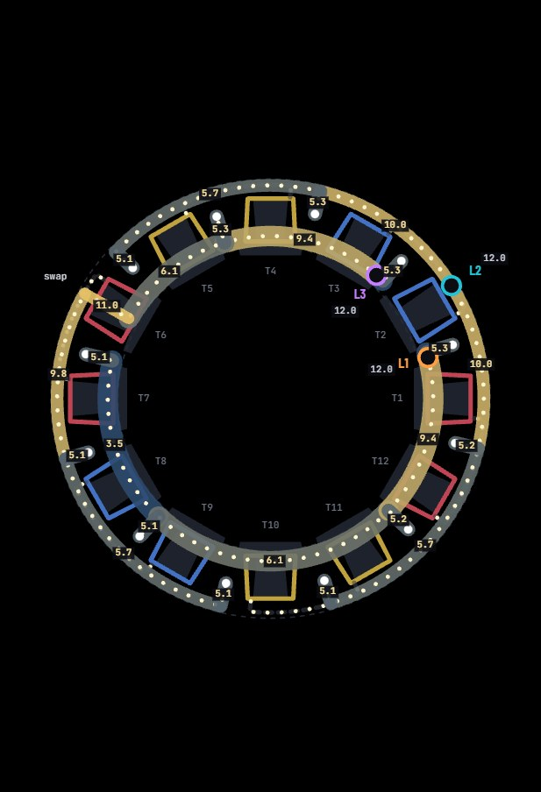
[picture p52: busbar/optimisation_report/img/default_planJ.jpg]
plan, current density


Plan coloured and labelled by current density (A/mm²)

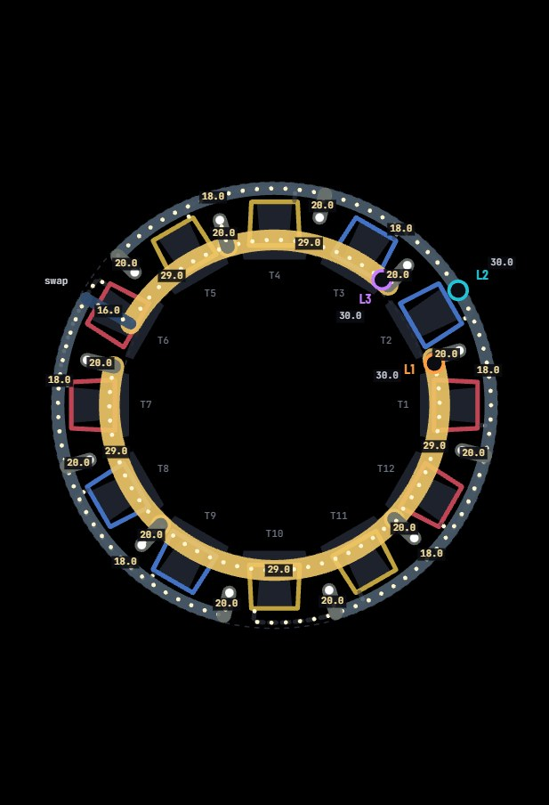
[picture p53: busbar/optimisation_report/img/default_planA.jpg]
plan, cross-section


Plan coloured and labelled by cross-section (mm²)

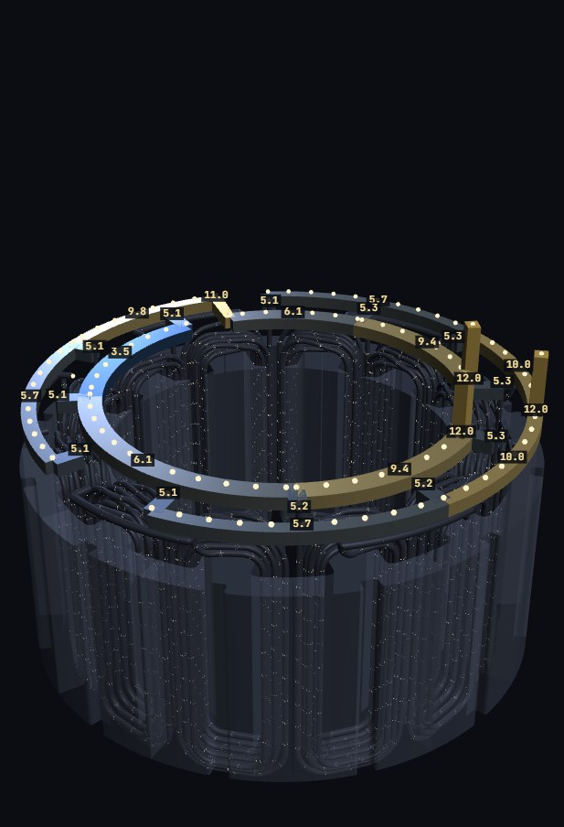
[picture p54: busbar/optimisation_report/img/default_d3.jpg]


3D, coloured by current density

### Parameters

Rings | L1 in / L2 out / L3 swaps
Sheet thickness t | 4 mm
Inner track width / centre r | 7.25 / 57.75 mm
Outer track width / centre r | 4.50 / 75.73 mm
Swap piece width | 4 mm
Weld pad (spoke) width | 5 mm
Lead circle r | 67.43 mm
Plane bottom z | 45.75 mm
Jumper r / z | 76 / 43.25 mm
Terminals L1 / L2 / L3 | 14.6° (inner) / 32.0° (outer) / 49.4° (inner)
Terminal span | 34.7°
Swap angle | 150.5°
Cross-section | uniform
Path balancing | off

### Parallel paths per phase

phase | path 1 | R mΩ | I A | path 2 | R mΩ | I A | imb %
R | T12+T1 | 9.9682 | 104.73 | T7+T6 | 10.1323 | 102.75 | 1.91
Y | T4+T5 | 9.9662 | 105.24 | T11+T10 | 10.2216 | 102.06 | 3.07
B | T3+T2 | 9.8799 | 106.31 | T8+T9 | 10.1023 | 102.45 | 3.69

I = rms coil current with all three phases running at 360 A line current.

Every busbar part: width, area, current, current density, resistance, loss

part | w mm | A mm² | I A | J A/mm² | R µΩ | loss W
ring L1 inner 166°→226° | 7.25 | 29.0 | 102.8 | 3.54 | 35.9 | 0.38
ring L1 inner 226°→316° | 7.25 | 29.0 | 177.5 | 6.12 | 53.8 | 1.69
ring L1 inner 316°→15° | 7.25 | 29.0 | 273.3 | 9.43 | 34.8 | 2.60
ring L1 inner 15°→16° | 7.25 | 29.0 | 106.3 | 3.67 | 1.1 | 0.01
spoke to weld F12 | 5.00 | 20.0 | 104.7 | 5.24 | 8.3 | 0.09
spoke to weld F7 | 5.00 | 20.0 | 102.8 | 5.14 | 8.3 | 0.09
spoke to weld F2 | 5.00 | 20.0 | 106.3 | 5.32 | 8.3 | 0.09
spoke to weld F9 | 5.00 | 20.0 | 102.5 | 5.12 | 8.3 | 0.09
ring L2 outer 286°→346° | 4.50 | 18.0 | 102.1 | 5.67 | 75.8 | 0.79
ring L2 outer 346°→32° | 4.50 | 18.0 | 179.6 | 9.98 | 57.5 | 1.85
ring L2 outer 32°→76° | 4.50 | 18.0 | 180.4 | 10.02 | 56.2 | 1.83
ring L2 outer 76°→136° | 4.50 | 18.0 | 102.8 | 5.71 | 75.8 | 0.80
spoke to weld F1 | 5.00 | 20.0 | 104.7 | 5.24 | 7.1 | 0.08
spoke to weld F6 | 5.00 | 20.0 | 102.8 | 5.14 | 7.1 | 0.08
spoke to weld F4 | 5.00 | 20.0 | 105.2 | 5.26 | 7.1 | 0.08
spoke to weld F11 | 5.00 | 20.0 | 102.1 | 5.10 | 7.1 | 0.07
ring L3 inner 46°→49° | 7.25 | 29.0 | 106.3 | 3.67 | 1.7 | 0.02
ring L3 inner 49°→106° | 7.25 | 29.0 | 273.0 | 9.41 | 34.1 | 2.54
ring L3 inner 106°→151° | 7.25 | 29.0 | 176.6 | 6.09 | 26.3 | 0.82
spoke to weld F5 | 5.00 | 20.0 | 105.2 | 5.26 | 8.3 | 0.09
spoke to weld F3 | 5.00 | 20.0 | 106.3 | 5.32 | 8.3 | 0.09
ring L3 outer 151°→196° | 4.50 | 18.0 | 176.6 | 9.81 | 58.1 | 1.81
ring L3 outer 196°→256° | 4.50 | 18.0 | 102.1 | 5.67 | 75.8 | 0.79
spoke to weld F10 | 5.00 | 20.0 | 102.1 | 5.10 | 7.1 | 0.07
spoke to weld F8 | 5.00 | 20.0 | 102.5 | 5.12 | 7.1 | 0.07
swap piece, ring L3 | 4.00 | 16.0 | 176.6 | 11.04 | 19.3 | 0.60
terminal post L1 | — | 30.0 | 360.0 | 12.00 | 10.9 | 1.41
terminal post L2 | — | 30.0 | 360.0 | 12.00 | 10.9 | 1.41
terminal post L3 | — | 30.0 | 360.0 | 12.00 | 10.9 | 1.41

Every rule (all busbar rules pass)

rule | value | limit
Lead bends | 24.7 % | ≤ 25 % | ✓
Coil corner bends | 26.8 % | ≤ 25 % | ✗
Layer-change step on the end turn | 35.1 % | ≤ 25 % | ✗
Routing with no crossings | swap 150.5° | | ✓
F-lead jog to the lead circle | straight | | ✓
Jumper bends (start lead out to the jumper) | 24.6 % | ≤ 25 % | ✓
Terminal blades | welded on | | ✓
In-plane gap between different nets | 4.05 mm | ≥ 4.00 mm | ✓
Plane above the coil heads | 0.91 mm | ≥ 0.80 mm | ✓
Jumper to the plane | 0.99 mm | ≥ 0.80 mm | ✓
Jumper to the coil body | 2.70 mm | ≥ 0.80 mm | ✓
Enamel grade (wire) | Grade 1 | | i
Copper ≥ 2 mm inside the stator OD | r 77.98 | ≤ 78.00 | ✓
Copper outside the coil bore | r 54.13 | ≥ 54.09 | ✓
Narrowest web ≥ sheet thickness | 4.00 mm | ≥ 4.00 mm | ✓
Weld pad around each lead | 5.0 mm | ≥ 4.5 mm | ✓
Weld to weld, different nets | 29.9 mm | ≥ 4.0 mm | ✓
Current density, worst | 12.0 A/mm² | ≤ 12 | ✓
Path current imbalance | 3.69 % | ≤ 4 % | ✓
Path balancing resistance | off | | i
Line-to-line resistance imbalance | 0.63 % | ≤ 1.5 % | ✓
Terminals on their own ring | yes | | ✓
Terminals close together | 34.7° | ≤ 35° | ✓
Terminal pitch for lugs | 17.5 mm | ≥ 15 mm | ✓

## Goal: Balanced

Balanced score of busbar loss, height and copper (with smaller weights on imbalance, terminal span and cable exit). Sized for balance: each track segment is set narrow (J limit), normal, or widened into the free band around the lead circle between other-net weld pads, whichever gives the lowest worst-phase imbalance. Copper weight is ignored. 7 of 13 track segments are widened between the weld pads. Against the page default: copper +27 g, worst path imbalance -0.91 points, busbar loss -2.6 W.

Why this is the optimum

Best combined score (2.3500), only 0.07 % ahead of Terminals closest (2.3516). t = 3.75 mm with 7 widened segments. Against the default: +27 g (214 g), but −2.6 W loss (28.25 W), −0.91 points imbalance (2.78 %), −0.25 mm height (19.0 mm) and a 30.5° span. Binding: web = t, in-plane gap, lug pitch (15.2 vs 15 mm), J 12 at the terminals. Terminals closest has the same span with lower loss and imbalance but needs 17 g more copper at t = 4.

Worst path imbalance

2.78 %

R 2.39 · Y 2.77 · B 2.78

Busbar copper

214 g

v7 394 g

Busbar + joint loss

28.3 W

total 662.0 W

Max current density

12.00 A/mm²

track 10.7 · spoke 5.6 · trans 4.1 · term 12.0

Height above stack

19.0 mm

v7 35.5 mm

Line-line imbalance

0.55 %

R_LL 3.405 mΩ

Rules

all pass

min gap 3.80 mm

What to look for in the pictures: A 3.75 mm plate: the busy sections step outward into the band between the rings, the lightly loaded ends are trimmed narrow, so the track currents even out at 10–11 A/mm². Widened parts show their area as a range (normal – widened).

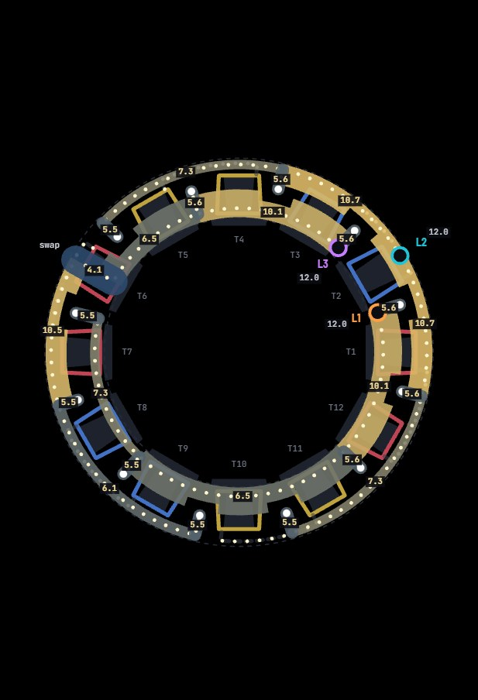
[picture p55: busbar/optimisation_report/img/g_bal_planJ.jpg]
plan, current density


Plan coloured and labelled by current density (A/mm²)

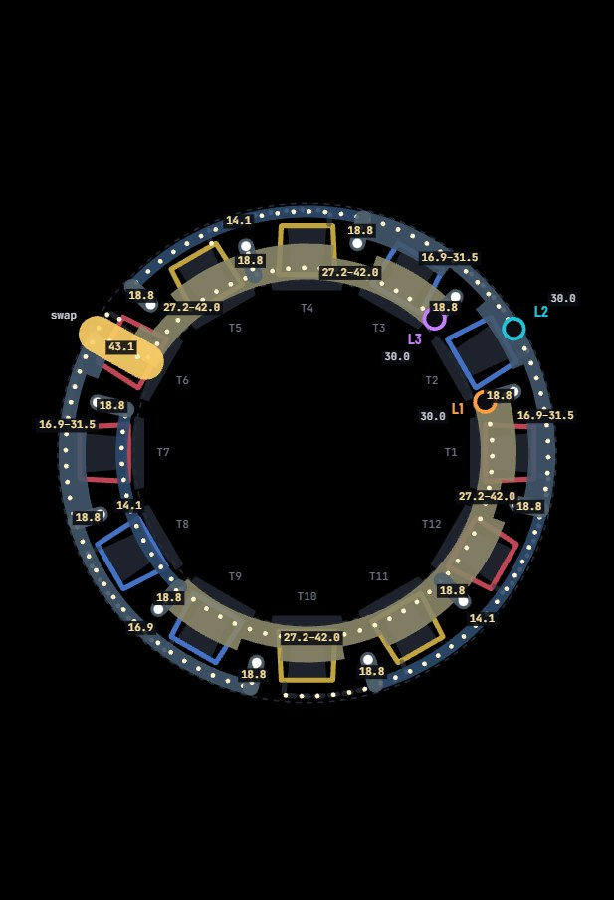
[picture p56: busbar/optimisation_report/img/g_bal_planA.jpg]
plan, cross-section


Plan coloured and labelled by cross-section (mm²)

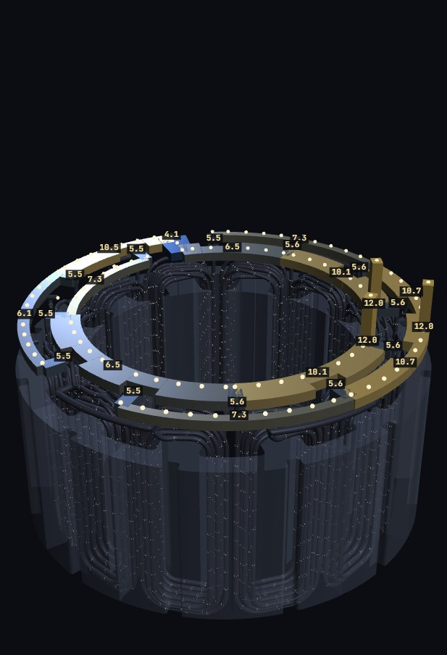
[picture p57: busbar/optimisation_report/img/g_bal_d3.jpg]


3D, coloured by current density

### Parameters

Rings | L1 in / L2 out / L3 swaps
Sheet thickness t | 3.75 mm
Inner track width / centre r | 7.25 / 57.95 mm
Outer track width / centre r | 4.50 / 75.48 mm
Swap piece width | 11.5 mm
Weld pad (spoke) width | 5 mm
Lead circle r | 67.43 mm
Plane bottom z | 45.75 mm
Jumper r / z | 76 / 43.25 mm
Terminals L1 / L2 / L3 | 16.0° (inner) / 31.0° (outer) / 46.5° (inner)
Terminal span | 30.5°
Swap angle | 150.5°
Cross-section | widened for balance
Path balancing | off

### Parallel paths per phase

phase | path 1 | R mΩ | I A | path 2 | R mΩ | I A | imb %
R | T12+T1 | 9.9417 | 104.92 | T7+T6 | 10.1572 | 102.45 | 2.39
Y | T4+T5 | 9.9430 | 105.11 | T11+T10 | 10.1861 | 102.24 | 2.77
B | T3+T2 | 9.8772 | 105.87 | T8+T9 | 10.0432 | 102.96 | 2.78

I = rms coil current with all three phases running at 360 A line current.

Every busbar part: width, area, current, current density, resistance, loss

part | w mm | A mm² | I A | J A/mm² | R µΩ | loss W
ring L1 inner 166°→226° | 3.75 | 14.1 | 102.4 | 7.29 | 74.2 | 0.78
ring L1 inner 226°→316° | 7.25 – 11.20 | 27.2 | 177.6 | 6.53 | 43.6 | 1.38
ring L1 inner 316°→16° | 7.25 – 11.20 | 27.2 | 273.6 | 10.06 | 27.9 | 2.09
ring L1 inner 16°→16° | 3.75 | 14.1 | 105.9 | 7.53 | 0.6 | 0.01
spoke to weld F12 | 5.00 | 18.8 | 104.9 | 5.60 | 8.7 | 0.10
spoke to weld F7 | 5.00 | 18.8 | 102.4 | 5.46 | 8.7 | 0.09
spoke to weld F2 | 5.00 | 18.8 | 105.9 | 5.65 | 8.7 | 0.10
spoke to weld F9 | 5.00 | 18.8 | 103.0 | 5.49 | 8.7 | 0.09
ring L2 outer 286°→346° | 3.75 | 14.1 | 102.2 | 7.27 | 96.7 | 1.01
ring L2 outer 346°→31° | 4.50 – 8.40 | 16.9 | 179.9 | 10.66 | 38.5 | 1.25
ring L2 outer 31°→76° | 4.50 – 8.40 | 16.9 | 180.1 | 10.67 | 39.6 | 1.28
ring L2 outer 76°→136° | 3.75 | 14.1 | 102.4 | 7.29 | 96.7 | 1.01
spoke to weld F1 | 5.00 | 18.8 | 104.9 | 5.60 | 7.4 | 0.08
spoke to weld F6 | 5.00 | 18.8 | 102.4 | 5.46 | 7.4 | 0.08
spoke to weld F4 | 5.00 | 18.8 | 105.1 | 5.61 | 7.4 | 0.08
spoke to weld F11 | 5.00 | 18.8 | 102.2 | 5.45 | 7.4 | 0.08
ring L3 inner 46°→47° | 3.75 | 14.1 | 105.9 | 7.53 | 0.0 | 0.00
ring L3 inner 47°→106° | 7.25 – 11.20 | 27.2 | 273.4 | 10.06 | 28.2 | 2.11
ring L3 inner 106°→151° | 7.25 – 11.20 | 27.2 | 177.3 | 6.52 | 21.3 | 0.67
spoke to weld F5 | 5.00 | 18.8 | 105.1 | 5.61 | 8.7 | 0.10
spoke to weld F3 | 5.00 | 18.8 | 105.9 | 5.65 | 8.7 | 0.10
ring L3 outer 151°→196° | 4.50 – 8.40 | 16.9 | 177.3 | 10.51 | 39.9 | 1.25
ring L3 outer 196°→256° | 4.50 | 16.9 | 102.2 | 6.06 | 80.6 | 0.84
spoke to weld F10 | 5.00 | 18.8 | 102.2 | 5.45 | 7.4 | 0.08
spoke to weld F8 | 5.00 | 18.8 | 103.0 | 5.49 | 7.4 | 0.08
swap piece, ring L3 | 11.50 | 43.1 | 177.3 | 4.11 | 7.0 | 0.22
terminal post L1 | — | 30.0 | 360.0 | 12.00 | 10.9 | 1.41
terminal post L2 | — | 30.0 | 360.0 | 12.00 | 10.9 | 1.41
terminal post L3 | — | 30.0 | 360.0 | 12.00 | 10.9 | 1.41

Every rule (all busbar rules pass)

rule | value | limit
Lead bends | 24.7 % | ≤ 25 % | ✓
Coil corner bends | 26.8 % | ≤ 25 % | ✗
Layer-change step on the end turn | 35.1 % | ≤ 25 % | ✗
Routing with no crossings | swap 150.5° | | ✓
F-lead jog to the lead circle | straight | | ✓
Jumper bends (start lead out to the jumper) | 24.6 % | ≤ 25 % | ✓
Terminal blades | welded on | | ✓
In-plane gap between different nets | 3.80 mm | ≥ 3.75 mm | ✓
Plane above the coil heads | 0.91 mm | ≥ 0.80 mm | ✓
Jumper to the plane | 0.99 mm | ≥ 0.80 mm | ✓
Jumper to the coil body | 2.70 mm | ≥ 0.80 mm | ✓
Enamel grade (wire) | Grade 1 | | i
Copper ≥ 2 mm inside the stator OD | r 77.73 | ≤ 78.00 | ✓
Copper outside the coil bore | r 54.33 | ≥ 54.09 | ✓
Narrowest web ≥ sheet thickness | 3.75 mm | ≥ 3.75 mm | ✓
Weld pad around each lead | 5.0 mm | ≥ 4.5 mm | ✓
Weld to weld, different nets | 29.9 mm | ≥ 4.0 mm | ✓
Current density, worst | 12.0 A/mm² | ≤ 12 | ✓
Path current imbalance | 2.78 % | ≤ 4 % | ✓
Path balancing resistance | off | | i
Line-to-line resistance imbalance | 0.55 % | ≤ 1.5 % | ✓
Terminals on their own ring | yes | | ✓
Terminals close together | 30.5° | ≤ 35° | ✓
Terminal pitch for lugs | 15.2 mm | ≥ 15 mm | ✓

## Goal: Lowest loss

Lowest busbar + joint loss. Sized for balance: each track segment is set narrow (J limit), normal, or widened into the free band around the lead circle between other-net weld pads, whichever gives the lowest worst-phase imbalance. Copper weight is ignored. 8 of 13 track segments are widened between the weld pads. Against the page default: copper +52 g, worst path imbalance -1.18 points, busbar loss -4.1 W.

Why this is the optimum

Lowest loss (score 3.1359): 26.78 W, 4.08 W (13 %) below the default, bought with +51.5 g copper (238.4 g) in 8 widened segments at t = 4: more copper on the busy ring sections lowers their resistance. Runner-up Lowest imbalance is 0.31 W worse with 8.7 g less copper. The 35° terminal span binds: allowing 60° or 90° lowers the loss further. Also at limit: web, gap, outer radius, lug pitch.

Worst path imbalance

2.51 %

R 2.12 · Y 2.27 · B 2.51

Busbar copper

238 g

v7 394 g

Busbar + joint loss

26.8 W

total 660.5 W

Max current density

12.00 A/mm²

track 10.0 · spoke 5.3 · trans 3.7 · term 12.0

Height above stack

19.2 mm

v7 35.5 mm

Line-line imbalance

0.41 %

R_LL 3.398 mΩ

Rules

all pass

min gap 4.05 mm

What to look for in the pictures: A full 4 mm plate with stepped, widened busy sections (including the lower-left outer arc) and a large, cool swap piece (3.7 A/mm²).

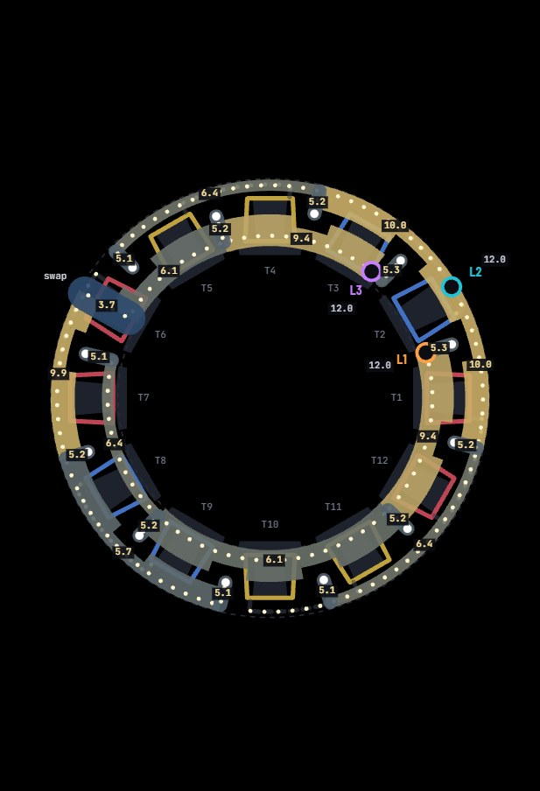
[picture p58: busbar/optimisation_report/img/g_loss_planJ.jpg]
plan, current density


Plan coloured and labelled by current density (A/mm²)

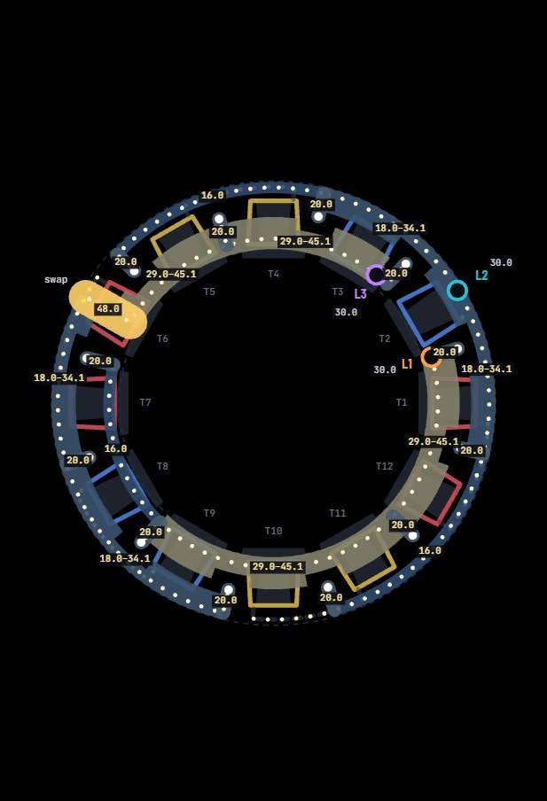
[picture p59: busbar/optimisation_report/img/g_loss_planA.jpg]
plan, cross-section


Plan coloured and labelled by cross-section (mm²)

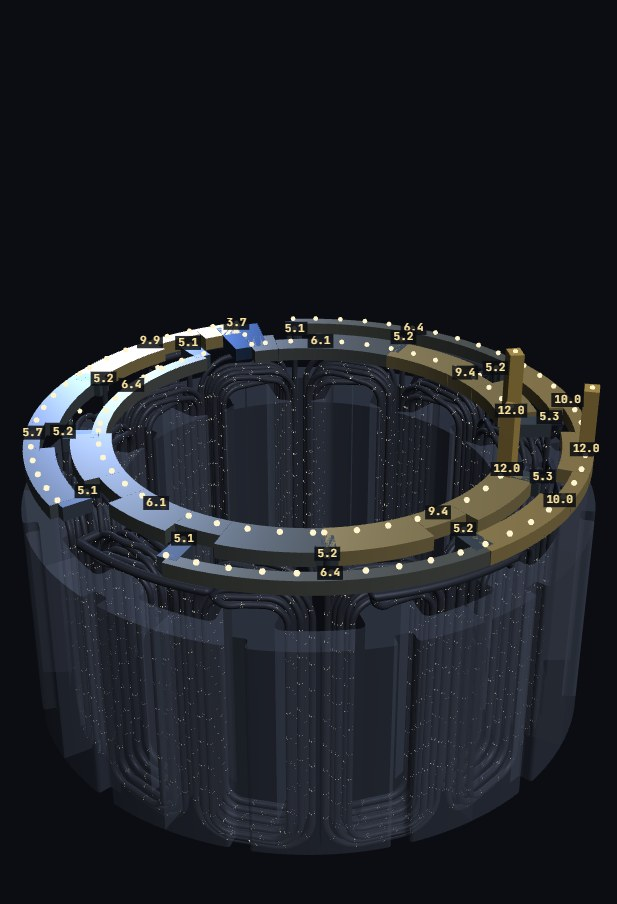
[picture p60: busbar/optimisation_report/img/g_loss_d3.jpg]


3D, coloured by current density

### Parameters

Rings | L1 in / L2 out / L3 swaps
Sheet thickness t | 4 mm
Inner track width / centre r | 7.25 / 57.75 mm
Outer track width / centre r | 4.50 / 75.73 mm
Swap piece width | 12 mm
Weld pad (spoke) width | 5 mm
Lead circle r | 67.43 mm
Plane bottom z | 45.75 mm
Jumper r / z | 76 / 43.25 mm
Terminals L1 / L2 / L3 | 16.2° (inner) / 31.5° (outer) / 51.2° (inner)
Terminal span | 35.0°
Swap angle | 150.5°
Cross-section | widened for balance
Path balancing | off

### Parallel paths per phase

phase | path 1 | R mΩ | I A | path 2 | R mΩ | I A | imb %
R | T12+T1 | 9.9386 | 104.79 | T7+T6 | 10.1295 | 102.59 | 2.12
Y | T4+T5 | 9.9368 | 104.93 | T11+T10 | 10.1306 | 102.58 | 2.27
B | T3+T2 | 9.8825 | 105.64 | T8+T9 | 10.0305 | 103.02 | 2.51

I = rms coil current with all three phases running at 360 A line current.

Every busbar part: width, area, current, current density, resistance, loss

part | w mm | A mm² | I A | J A/mm² | R µΩ | loss W
ring L1 inner 166°→226° | 4.00 | 16.0 | 102.6 | 6.41 | 65.0 | 0.68
ring L1 inner 226°→316° | 7.25 – 11.27 | 29.0 | 177.9 | 6.13 | 40.6 | 1.28
ring L1 inner 316°→16° | 7.25 – 11.27 | 29.0 | 273.7 | 9.44 | 26.2 | 1.96
ring L1 inner 16°→16° | 4.00 | 16.0 | 105.6 | 6.60 | 0.2 | 0.00
spoke to weld F12 | 5.00 | 20.0 | 104.8 | 5.24 | 8.3 | 0.09
spoke to weld F7 | 5.00 | 20.0 | 102.6 | 5.13 | 8.3 | 0.09
spoke to weld F2 | 5.00 | 20.0 | 105.6 | 5.28 | 8.3 | 0.09
spoke to weld F9 | 5.00 | 20.0 | 103.0 | 5.15 | 8.3 | 0.09
ring L2 outer 286°→346° | 4.00 | 16.0 | 102.6 | 6.41 | 85.2 | 0.90
ring L2 outer 346°→32° | 4.50 – 8.52 | 18.0 | 180.0 | 10.00 | 36.5 | 1.18
ring L2 outer 32°→76° | 4.50 – 8.52 | 18.0 | 180.0 | 10.00 | 36.5 | 1.18
ring L2 outer 76°→136° | 4.00 | 16.0 | 102.6 | 6.41 | 85.2 | 0.90
spoke to weld F1 | 5.00 | 20.0 | 104.8 | 5.24 | 7.1 | 0.08
spoke to weld F6 | 5.00 | 20.0 | 102.6 | 5.13 | 7.1 | 0.08
spoke to weld F4 | 5.00 | 20.0 | 104.9 | 5.25 | 7.1 | 0.08
spoke to weld F11 | 5.00 | 20.0 | 102.6 | 5.13 | 7.1 | 0.08
ring L3 inner 46°→51° | 4.00 | 16.0 | 105.6 | 6.60 | 5.2 | 0.06
ring L3 inner 51°→106° | 7.25 – 11.27 | 29.0 | 273.6 | 9.44 | 24.4 | 1.82
ring L3 inner 106°→151° | 7.25 – 11.27 | 29.0 | 177.7 | 6.13 | 19.9 | 0.63
spoke to weld F5 | 5.00 | 20.0 | 104.9 | 5.25 | 8.3 | 0.09
spoke to weld F3 | 5.00 | 20.0 | 105.6 | 5.28 | 8.3 | 0.09
ring L3 outer 151°→196° | 4.50 – 8.52 | 18.0 | 177.7 | 9.87 | 37.2 | 1.17
ring L3 outer 196°→256° | 4.50 – 8.52 | 18.0 | 102.6 | 5.70 | 46.3 | 0.49
spoke to weld F10 | 5.00 | 20.0 | 102.6 | 5.13 | 7.1 | 0.08
spoke to weld F8 | 5.00 | 20.0 | 103.0 | 5.15 | 7.1 | 0.08
swap piece, ring L3 | 12.00 | 48.0 | 177.7 | 3.70 | 6.4 | 0.20
terminal post L1 | — | 30.0 | 360.0 | 12.00 | 10.9 | 1.41
terminal post L2 | — | 30.0 | 360.0 | 12.00 | 10.9 | 1.41
terminal post L3 | — | 30.0 | 360.0 | 12.00 | 10.9 | 1.41

Every rule (all busbar rules pass)

rule | value | limit
Lead bends | 24.7 % | ≤ 25 % | ✓
Coil corner bends | 26.8 % | ≤ 25 % | ✗
Layer-change step on the end turn | 35.1 % | ≤ 25 % | ✗
Routing with no crossings | swap 150.5° | | ✓
F-lead jog to the lead circle | straight | | ✓
Jumper bends (start lead out to the jumper) | 24.6 % | ≤ 25 % | ✓
Terminal blades | welded on | | ✓
In-plane gap between different nets | 4.05 mm | ≥ 4.00 mm | ✓
Plane above the coil heads | 0.91 mm | ≥ 0.80 mm | ✓
Jumper to the plane | 0.99 mm | ≥ 0.80 mm | ✓
Jumper to the coil body | 2.70 mm | ≥ 0.80 mm | ✓
Enamel grade (wire) | Grade 1 | | i
Copper ≥ 2 mm inside the stator OD | r 77.98 | ≤ 78.00 | ✓
Copper outside the coil bore | r 54.13 | ≥ 54.09 | ✓
Narrowest web ≥ sheet thickness | 4.00 mm | ≥ 4.00 mm | ✓
Weld pad around each lead | 5.0 mm | ≥ 4.5 mm | ✓
Weld to weld, different nets | 29.9 mm | ≥ 4.0 mm | ✓
Current density, worst | 12.0 A/mm² | ≤ 12 | ✓
Path current imbalance | 2.51 % | ≤ 4 % | ✓
Path balancing resistance | off | | i
Line-to-line resistance imbalance | 0.41 % | ≤ 1.5 % | ✓
Terminals on their own ring | yes | | ✓
Terminals close together | 35.0° | ≤ 35° | ✓
Terminal pitch for lugs | 15.4 mm | ≥ 15 mm | ✓

## Goal: Lowest height

Lowest axial height above the stack. Sized for balance: each track segment is set narrow (J limit), normal, or widened into the free band around the lead circle between other-net weld pads, whichever gives the lowest worst-phase imbalance. Copper weight is ignored. 7 of 13 track segments are widened between the weld pads. Against the page default: copper +4 g, worst path imbalance -0.67 points, busbar loss -1.0 W.

Why this is the optimum

Lowest height (score 2.7372): 18.25 mm, 1.0 mm below the default, at t = 3 mm with 7 widened segments. It also beats the default on loss (29.84 W) and imbalance (3.03 %) for +3.9 g copper (190.7 g). The least-copper design is physically 0.25 mm lower (18.0 mm at t = 2.75) but scores worse on this goal because of its 35.2 W loss and 3.81 % imbalance. Binding: web = t, gap, outer radius, lug pitch.

Worst path imbalance

3.03 %

R 2.63 · Y 2.88 · B 3.03

Busbar copper

191 g

v7 394 g

Busbar + joint loss

29.8 W

total 663.3 W

Max current density

12.00 A/mm²

track 11.8 · spoke 7.1 · trans 4.9 · term 12.0

Height above stack

18.2 mm

v7 35.5 mm

Line-line imbalance

0.46 %

R_LL 3.412 mΩ

Rules

all pass

min gap 3.05 mm

What to look for in the pictures: The thinnest balanced plate (3 mm): wide stepped arcs and a fat swap piece, with only one thin inner arc (T7–T8) running near the limit.

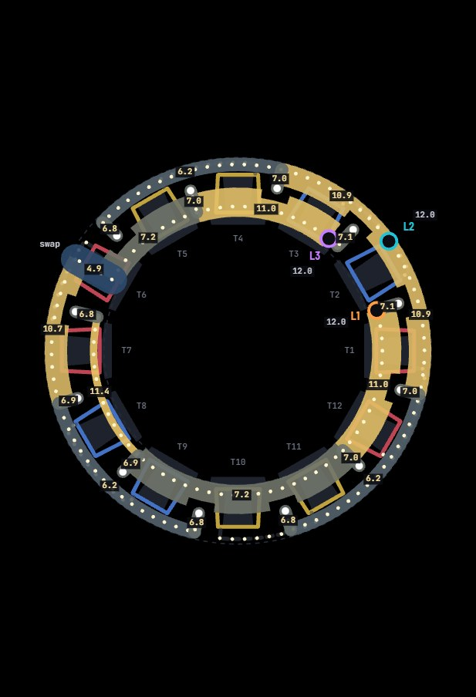
[picture p61: busbar/optimisation_report/img/g_height_planJ.jpg]
plan, current density


Plan coloured and labelled by current density (A/mm²)

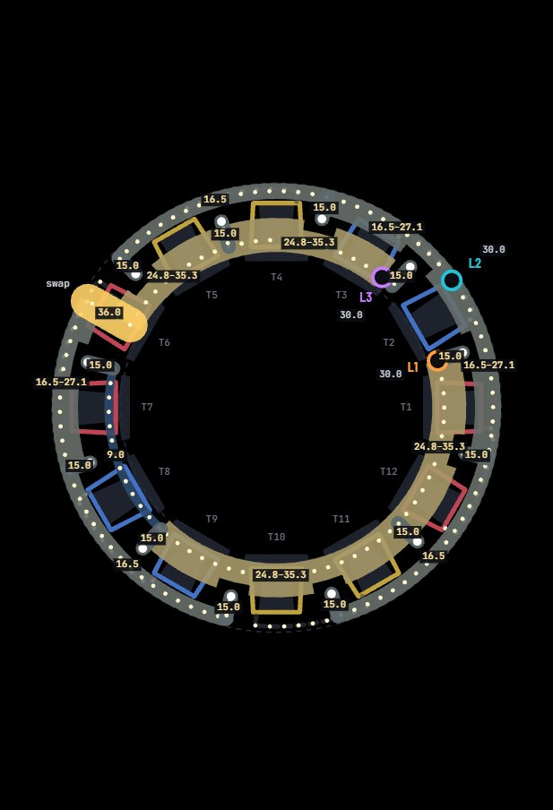
[picture p62: busbar/optimisation_report/img/g_height_planA.jpg]
plan, cross-section


Plan coloured and labelled by cross-section (mm²)

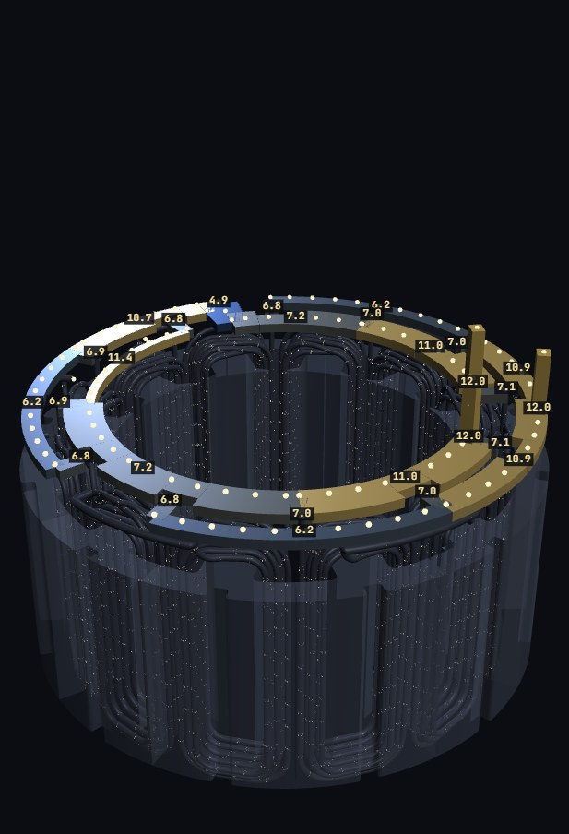
[picture p63: busbar/optimisation_report/img/g_height_d3.jpg]


3D, coloured by current density

### Parameters

Rings | L1 in / L2 out / L3 swaps
Sheet thickness t | 3 mm
Inner track width / centre r | 8.25 / 58.25 mm
Outer track width / centre r | 5.50 / 75.23 mm
Swap piece width | 12 mm
Weld pad (spoke) width | 5 mm
Lead circle r | 67.43 mm
Plane bottom z | 45.75 mm
Jumper r / z | 76 / 43.25 mm
Terminals L1 / L2 / L3 | 16.2° (inner) / 36.0° (outer) / 51.0° (inner)
Terminal span | 34.8°
Swap angle | 150.5°
Cross-section | widened for balance
Path balancing | off

### Parallel paths per phase

phase | path 1 | R mΩ | I A | path 2 | R mΩ | I A | imb %
R | T12+T1 | 9.9535 | 104.98 | T7+T6 | 10.1944 | 102.26 | 2.63
Y | T4+T5 | 9.9436 | 105.22 | T11+T10 | 10.1895 | 102.23 | 2.88
B | T3+T2 | 9.8857 | 106.01 | T8+T9 | 10.0631 | 102.85 | 3.03

I = rms coil current with all three phases running at 360 A line current.

Every busbar part: width, area, current, current density, resistance, loss

part | w mm | A mm² | I A | J A/mm² | R µΩ | loss W
ring L1 inner 166°→226° | 3.00 | 9.0 | 102.3 | 11.36 | 116.6 | 1.22
ring L1 inner 226°→316° | 8.25 – 11.77 | 24.8 | 177.4 | 7.17 | 49.8 | 1.57
ring L1 inner 316°→16° | 8.25 – 11.77 | 24.8 | 273.4 | 11.05 | 32.5 | 2.43
ring L1 inner 16°→16° | 3.00 | 9.0 | 106.0 | 11.78 | 0.4 | 0.00
spoke to weld F12 | 5.00 | 15.0 | 105.0 | 7.00 | 10.5 | 0.12
spoke to weld F7 | 5.00 | 15.0 | 102.3 | 6.82 | 10.5 | 0.11
spoke to weld F2 | 5.00 | 15.0 | 106.0 | 7.07 | 10.5 | 0.12
spoke to weld F9 | 5.00 | 15.0 | 102.9 | 6.86 | 10.5 | 0.11
ring L2 outer 286°→346° | 5.50 | 16.5 | 102.2 | 6.20 | 82.1 | 0.86
ring L2 outer 346°→36° | 5.50 – 9.02 | 16.5 | 179.9 | 10.90 | 46.1 | 1.49
ring L2 outer 36°→76° | 5.50 – 9.02 | 16.5 | 180.1 | 10.92 | 38.5 | 1.25
ring L2 outer 76°→136° | 5.50 | 16.5 | 102.3 | 6.20 | 82.1 | 0.86
spoke to weld F1 | 5.00 | 15.0 | 105.0 | 7.00 | 8.9 | 0.10
spoke to weld F6 | 5.00 | 15.0 | 102.3 | 6.82 | 8.9 | 0.09
spoke to weld F4 | 5.00 | 15.0 | 105.2 | 7.01 | 8.9 | 0.10
spoke to weld F11 | 5.00 | 15.0 | 102.2 | 6.82 | 8.9 | 0.09
ring L3 inner 46°→51° | 3.00 | 9.0 | 106.0 | 11.78 | 8.8 | 0.10
ring L3 inner 51°→106° | 8.25 – 11.77 | 24.8 | 273.4 | 11.04 | 30.3 | 2.26
ring L3 inner 106°→151° | 8.25 – 11.77 | 24.8 | 177.1 | 7.16 | 24.5 | 0.77
spoke to weld F5 | 5.00 | 15.0 | 105.2 | 7.01 | 10.5 | 0.12
spoke to weld F3 | 5.00 | 15.0 | 106.0 | 7.07 | 10.5 | 0.12
ring L3 outer 151°→196° | 5.50 – 9.02 | 16.5 | 177.1 | 10.74 | 43.0 | 1.35
ring L3 outer 196°→256° | 5.50 | 16.5 | 102.2 | 6.20 | 82.1 | 0.86
spoke to weld F10 | 5.00 | 15.0 | 102.2 | 6.82 | 8.9 | 0.09
spoke to weld F8 | 5.00 | 15.0 | 102.9 | 6.86 | 8.9 | 0.09
swap piece, ring L3 | 12.00 | 36.0 | 177.1 | 4.92 | 8.1 | 0.25
terminal post L1 | — | 30.0 | 360.0 | 12.00 | 10.9 | 1.41
terminal post L2 | — | 30.0 | 360.0 | 12.00 | 10.9 | 1.41
terminal post L3 | — | 30.0 | 360.0 | 12.00 | 10.9 | 1.41

Every rule (all busbar rules pass)

rule | value | limit
Lead bends | 24.7 % | ≤ 25 % | ✓
Coil corner bends | 26.8 % | ≤ 25 % | ✗
Layer-change step on the end turn | 35.1 % | ≤ 25 % | ✗
Routing with no crossings | swap 150.5° | | ✓
F-lead jog to the lead circle | straight | | ✓
Jumper bends (start lead out to the jumper) | 24.6 % | ≤ 25 % | ✓
Terminal blades | welded on | | ✓
In-plane gap between different nets | 3.05 mm | ≥ 3.00 mm | ✓
Plane above the coil heads | 0.91 mm | ≥ 0.80 mm | ✓
Jumper to the plane | 0.99 mm | ≥ 0.80 mm | ✓
Jumper to the coil body | 2.70 mm | ≥ 0.80 mm | ✓
Enamel grade (wire) | Grade 1 | | i
Copper ≥ 2 mm inside the stator OD | r 77.98 | ≤ 78.00 | ✓
Copper outside the coil bore | r 54.13 | ≥ 54.09 | ✓
Narrowest web ≥ sheet thickness | 3.00 mm | ≥ 3.00 mm | ✓
Weld pad around each lead | 5.0 mm | ≥ 4.5 mm | ✓
Weld to weld, different nets | 29.9 mm | ≥ 4.0 mm | ✓
Current density, worst | 12.0 A/mm² | ≤ 12 | ✓
Path current imbalance | 3.03 % | ≤ 4 % | ✓
Path balancing resistance | off | | i
Line-to-line resistance imbalance | 0.46 % | ≤ 1.5 % | ✓
Terminals on their own ring | yes | | ✓
Terminals close together | 34.8° | ≤ 35° | ✓
Terminal pitch for lugs | 15.3 mm | ≥ 15 mm | ✓

## Goal: Least copper

Least busbar copper. Least copper: every section is first cut to the current-density limit; then the fewest grams are added back, widening the segments that lower the imbalance most per gram, until the imbalance limit is met. 3 of 13 track segments are widened between the weld pads. Against the page default: copper -40 g, worst path imbalance +0.12 points, busbar loss +4.4 W.

Why this is the optimum

Least copper (score 2.2741): 146.8 g, 40 g (21 %) below the default, at t = 2.75 mm with every section cut to the J limit (9 parts within 3 % of 12 A/mm²) and 3 segments widened back to meet the 4 % imbalance limit; 18.0 mm tall. Costs: 35.2 W (+4.4 W) and 3.81 % imbalance (95 % of the limit). Binding: outer and inner radius exactly at their limits, gap, span. Runner-up (Lowest height) carries 44 g more copper.

Worst path imbalance

3.81 %

R 3.55 · Y 3.81 · B 3.79

Busbar copper

147 g

v7 394 g

Busbar + joint loss

35.2 W

total 668.7 W

Max current density

12.00 A/mm²

track 11.9 · spoke 11.8 · trans 11.7 · term 12.0

Height above stack

18.0 mm

v7 35.5 mm

Line-line imbalance

0.86 %

R_LL 3.440 mΩ

Rules

all pass

min gap 2.80 mm

What to look for in the pictures: Least copper: nearly every piece is slimmed until it runs at 11–12 A/mm², so the plan glows an almost uniform hot colour; only the arcs the imbalance limit needs are widened.

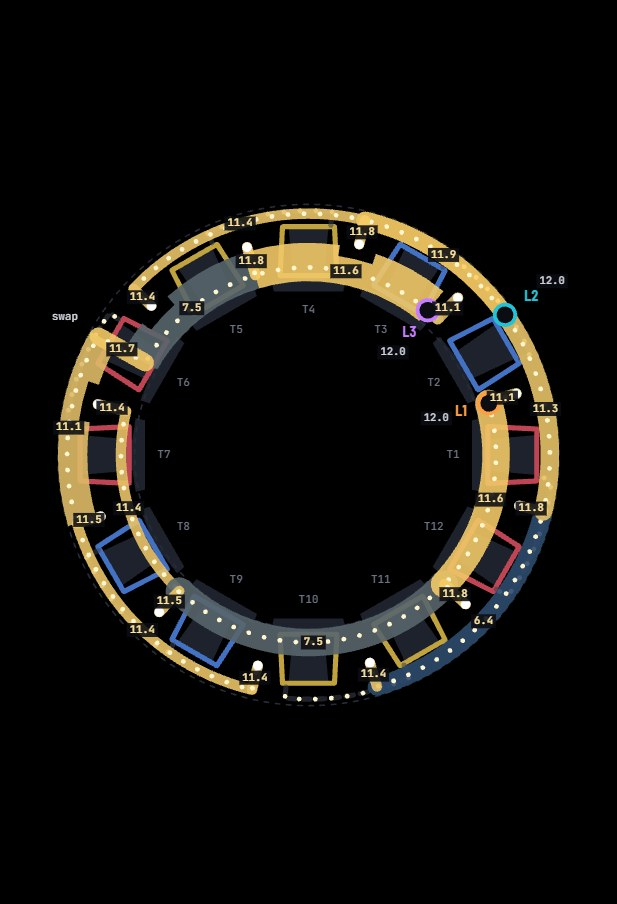
[picture p64: busbar/optimisation_report/img/g_mass_planJ.jpg]
plan, current density


Plan coloured and labelled by current density (A/mm²)

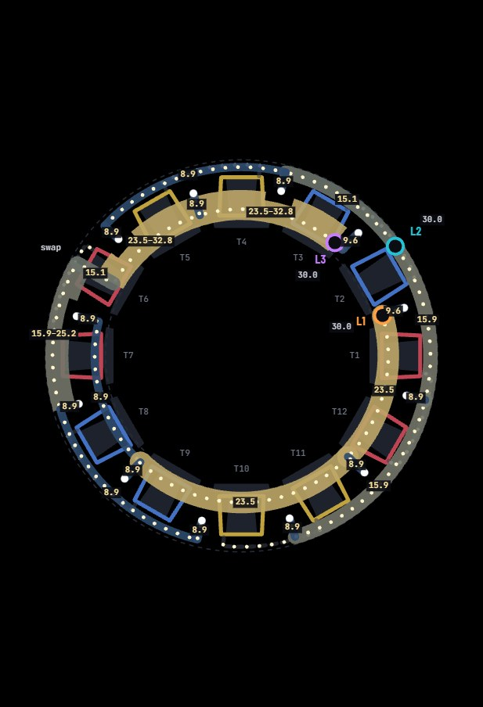
[picture p65: busbar/optimisation_report/img/g_mass_planA.jpg]
plan, cross-section


Plan coloured and labelled by cross-section (mm²)

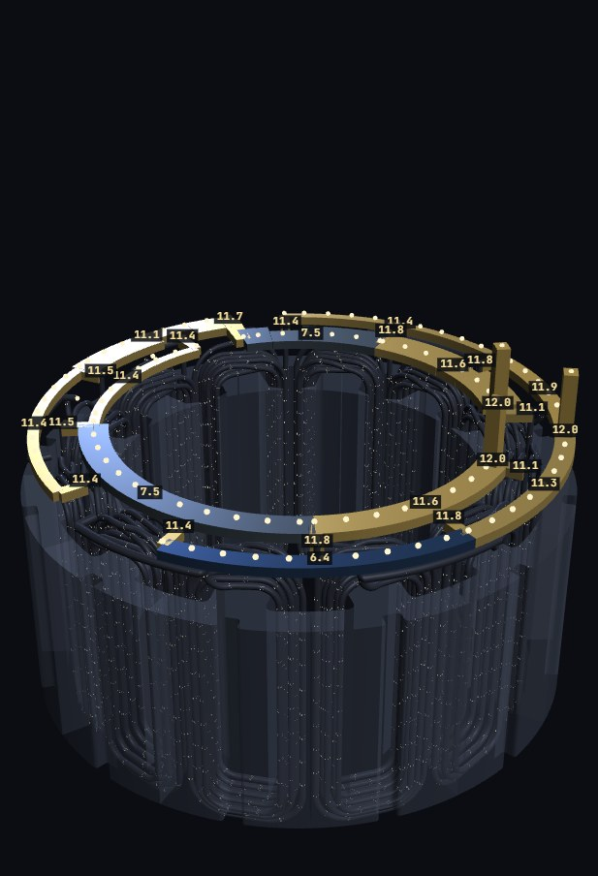
[picture p66: busbar/optimisation_report/img/g_mass_d3.jpg]


3D, coloured by current density

### Parameters

Rings | L1 in / L2 out / L3 swaps
Sheet thickness t | 2.75 mm
Inner track width / centre r | 8.54 / 58.36 mm
Outer track width / centre r | 5.77 / 75.11 mm
Swap piece width | 10.5 mm
Weld pad (spoke) width | 5 mm
Lead circle r | 67.43 mm
Plane bottom z | 45.75 mm
Jumper r / z | 76 / 43.25 mm
Terminals L1 / L2 / L3 | 16.0° (inner) / 35.5° (outer) / 50.5° (inner)
Terminal span | 34.5°
Swap angle | 150.5°
Cross-section | J limit + widened for imbalance (sized at J 12)
Path balancing | off

### Parallel paths per phase

phase | path 1 | R mΩ | I A | path 2 | R mΩ | I A | imb %
R | T12+T1 | 9.9944 | 105.35 | T7+T6 | 10.3220 | 101.67 | 3.55
Y | T4+T5 | 9.9741 | 105.64 | T11+T10 | 10.3074 | 101.69 | 3.81
B | T3+T2 | 9.8899 | 106.58 | T8+T9 | 10.1154 | 102.62 | 3.79

I = rms coil current with all three phases running at 360 A line current.

Every busbar part: width, area, current, current density, resistance, loss

part | w mm | A mm² | I A | J A/mm² | R µΩ | loss W
ring L1 inner 166°→226° | 3.25 | 8.9 | 101.7 | 11.38 | 117.6 | 1.22
ring L1 inner 226°→316° | 8.54 | 23.5 | 176.5 | 7.52 | 67.2 | 2.09
ring L1 inner 316°→16° | 8.54 | 23.5 | 272.9 | 11.63 | 44.4 | 3.31
ring L1 inner 16°→16° | 3.50 | 9.6 | 106.6 | 11.07 | 0.9 | 0.01
spoke to weld F12 | 3.25 | 8.9 | 105.3 | 11.79 | 14.4 | 0.16
spoke to weld F7 | 3.25 | 8.9 | 101.7 | 11.38 | 14.4 | 0.15
spoke to weld F2 | 3.50 | 9.6 | 106.6 | 11.07 | 13.8 | 0.16
spoke to weld F9 | 3.25 | 8.9 | 102.6 | 11.48 | 14.4 | 0.15
ring L2 outer 286°→346° | 5.77 | 15.9 | 101.7 | 6.40 | 85.2 | 0.88
ring L2 outer 346°→36° | 5.77 | 15.9 | 179.9 | 11.33 | 69.6 | 2.25
ring L2 outer 36°→76° | 5.50 | 15.1 | 180.1 | 11.91 | 61.1 | 1.98
ring L2 outer 76°→136° | 3.25 | 8.9 | 101.7 | 11.38 | 151.4 | 1.56
spoke to weld F1 | 3.25 | 8.9 | 105.3 | 11.79 | 11.8 | 0.13
spoke to weld F6 | 3.25 | 8.9 | 101.7 | 11.38 | 11.8 | 0.12
spoke to weld F4 | 3.25 | 8.9 | 105.6 | 11.82 | 11.8 | 0.13
spoke to weld F11 | 3.25 | 8.9 | 101.7 | 11.38 | 11.8 | 0.12
ring L3 inner 46°→51° | 3.50 | 9.6 | 106.6 | 11.07 | 7.3 | 0.08
ring L3 inner 51°→106° | 8.54 – 11.94 | 23.5 | 273.0 | 11.63 | 32.7 | 2.44
ring L3 inner 106°→151° | 8.54 – 11.94 | 23.5 | 176.4 | 7.51 | 26.1 | 0.81
spoke to weld F5 | 3.25 | 8.9 | 105.6 | 11.82 | 14.4 | 0.16
spoke to weld F3 | 3.50 | 9.6 | 106.6 | 11.07 | 13.8 | 0.16
ring L3 outer 151°→196° | 5.77 – 9.17 | 15.9 | 176.4 | 11.11 | 45.6 | 1.42
ring L3 outer 196°→256° | 3.25 | 8.9 | 101.7 | 11.38 | 151.4 | 1.57
spoke to weld F10 | 3.25 | 8.9 | 101.7 | 11.38 | 11.8 | 0.12
spoke to weld F8 | 3.25 | 8.9 | 102.6 | 11.48 | 11.8 | 0.12
swap piece, ring L3 | 5.50 | 15.1 | 176.4 | 11.66 | 19.1 | 0.59
terminal post L1 | — | 30.0 | 360.0 | 12.00 | 10.9 | 1.41
terminal post L2 | — | 30.0 | 360.0 | 12.00 | 10.9 | 1.41
terminal post L3 | — | 30.0 | 360.0 | 12.00 | 10.9 | 1.41

Every rule (all busbar rules pass)

rule | value | limit
Lead bends | 24.7 % | ≤ 25 % | ✓
Coil corner bends | 26.8 % | ≤ 25 % | ✗
Layer-change step on the end turn | 35.1 % | ≤ 25 % | ✗
Routing with no crossings | swap 150.5° | | ✓
F-lead jog to the lead circle | straight | | ✓
Jumper bends (start lead out to the jumper) | 24.6 % | ≤ 25 % | ✓
Terminal blades | welded on | | ✓
In-plane gap between different nets | 2.80 mm | ≥ 2.75 mm | ✓
Plane above the coil heads | 0.91 mm | ≥ 0.80 mm | ✓
Jumper to the plane | 0.99 mm | ≥ 0.80 mm | ✓
Jumper to the coil body | 2.70 mm | ≥ 0.80 mm | ✓
Enamel grade (wire) | Grade 1 | | i
Copper ≥ 2 mm inside the stator OD | r 78.00 | ≤ 78.00 | ✓
Copper outside the coil bore | r 54.09 | ≥ 54.09 | ✓
Narrowest web ≥ sheet thickness | 3.25 mm | ≥ 2.75 mm | ✓
Weld pad around each lead | 5.0 mm | ≥ 4.5 mm | ✓
Weld to weld, different nets | 29.9 mm | ≥ 4.0 mm | ✓
Current density, worst | 12.0 A/mm² | ≤ 12 | ✓
Path current imbalance | 3.81 % | ≤ 4 % | ✓
Path balancing resistance | off | | i
Line-to-line resistance imbalance | 0.86 % | ≤ 1.5 % | ✓
Terminals on their own ring | yes | | ✓
Terminals close together | 34.5° | ≤ 35° | ✓
Terminal pitch for lugs | 15.3 mm | ≥ 15 mm | ✓

## Goal: Lowest imbalance

Lowest worst-phase path current imbalance. Sized for balance: each track segment is set narrow (J limit), normal, or widened into the free band around the lead circle between other-net weld pads, whichever gives the lowest worst-phase imbalance. Copper weight is ignored. 7 of 13 track segments are widened between the weld pads. Against the page default: copper +43 g, worst path imbalance -1.18 points, busbar loss -3.8 W.

Why this is the optimum

Lowest imbalance with copper only (score 3.1426): 2.514 %, 1.18 points below the default, with +42.8 g copper (229.6 g) and −3.77 W (27.09 W), t = 4, 7 widened segments on the weaker paths. Lowest loss is within 0.001 points on raw imbalance but carries 8.7 g more copper. The 35° terminal span binds: 60° and 90° spans reach about 2.0 % and 1.5 %. Also at limit: web, gap, outer radius, lug pitch.

Worst path imbalance

2.51 %

R 2.17 · Y 2.51 · B 2.51

Busbar copper

230 g

v7 394 g

Busbar + joint loss

27.1 W

total 660.8 W

Max current density

12.00 A/mm²

track 10.0 · spoke 5.3 · trans 3.7 · term 12.0

Height above stack

19.2 mm

v7 35.5 mm

Line-line imbalance

0.50 %

R_LL 3.399 mΩ

Rules

all pass

min gap 4.05 mm

What to look for in the pictures: The stepped, widened 4 mm layout, with terminal L2 moved lowest (29°) to even out the two paths of each phase.

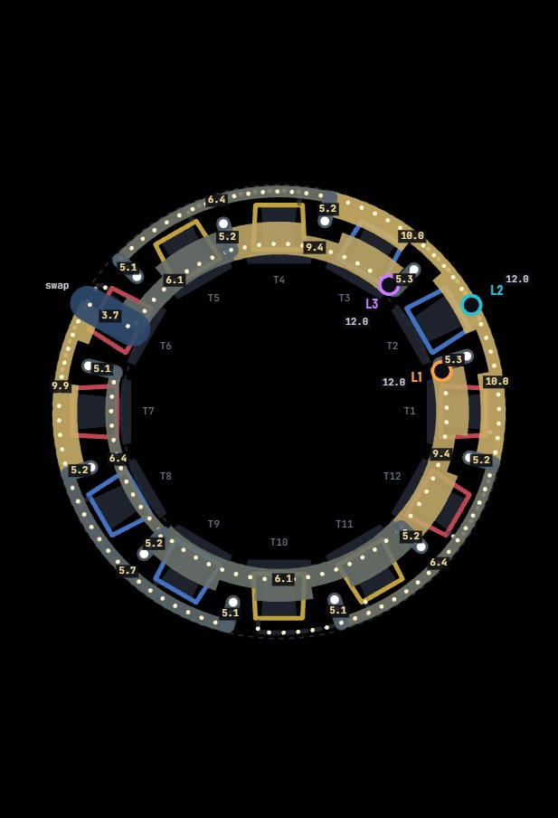
[picture p67: busbar/optimisation_report/img/g_imb_planJ.jpg]
plan, current density


Plan coloured and labelled by current density (A/mm²)

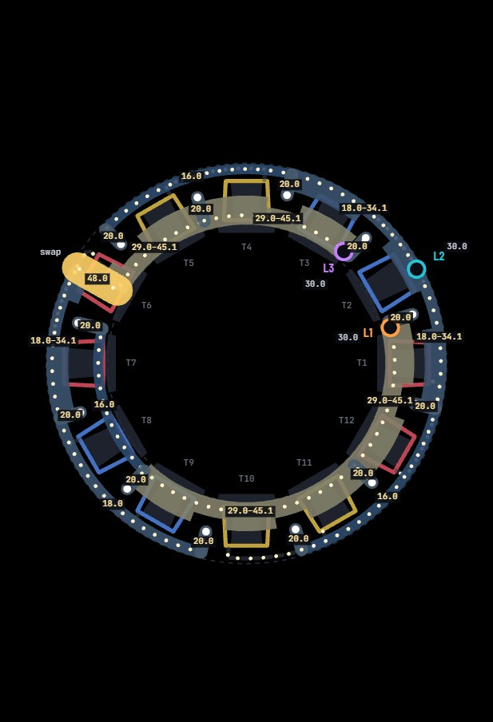
[picture p68: busbar/optimisation_report/img/g_imb_planA.jpg]
plan, cross-section


Plan coloured and labelled by cross-section (mm²)

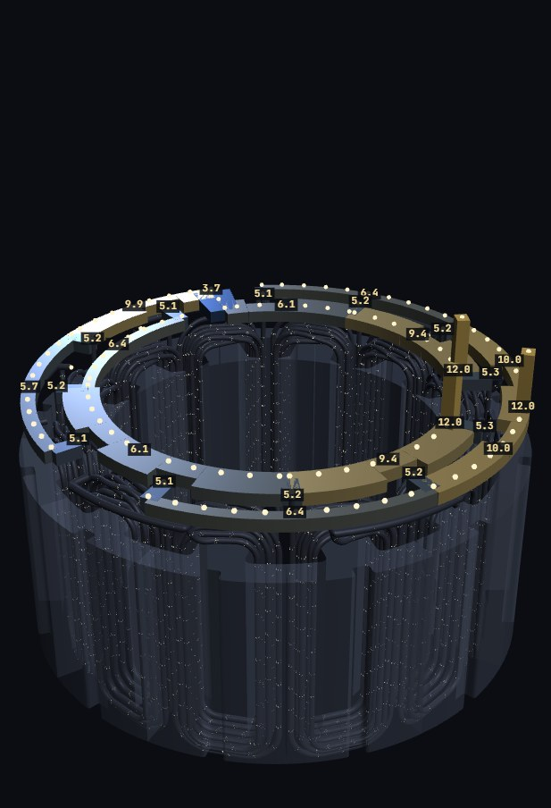
[picture p69: busbar/optimisation_report/img/g_imb_d3.jpg]


3D, coloured by current density

### Parameters

Rings | L1 in / L2 out / L3 swaps
Sheet thickness t | 4 mm
Inner track width / centre r | 7.25 / 57.75 mm
Outer track width / centre r | 4.50 / 75.73 mm
Swap piece width | 12 mm
Weld pad (spoke) width | 5 mm
Lead circle r | 67.43 mm
Plane bottom z | 45.75 mm
Jumper r / z | 76 / 43.25 mm
Terminals L1 / L2 / L3 | 14.0° (inner) / 29.0° (outer) / 49.0° (inner)
Terminal span | 35.0°
Swap angle | 150.5°
Cross-section | widened for balance
Path balancing | off

### Parallel paths per phase

phase | path 1 | R mΩ | I A | path 2 | R mΩ | I A | imb %
R | T12+T1 | 9.9361 | 104.85 | T7+T6 | 10.1303 | 102.59 | 2.17
Y | T4+T5 | 9.9393 | 105.00 | T11+T10 | 10.1594 | 102.39 | 2.51
B | T3+T2 | 9.8825 | 105.67 | T8+T9 | 10.0306 | 103.04 | 2.51

I = rms coil current with all three phases running at 360 A line current.

Every busbar part: width, area, current, current density, resistance, loss

part | w mm | A mm² | I A | J A/mm² | R µΩ | loss W
ring L1 inner 166°→226° | 4.00 | 16.0 | 102.6 | 6.41 | 65.0 | 0.68
ring L1 inner 226°→316° | 7.25 – 11.27 | 29.0 | 177.9 | 6.13 | 40.6 | 1.28
ring L1 inner 316°→14° | 7.25 – 11.27 | 29.0 | 273.7 | 9.44 | 25.4 | 1.90
ring L1 inner 14°→16° | 4.00 | 16.0 | 105.7 | 6.60 | 2.7 | 0.03
spoke to weld F12 | 5.00 | 20.0 | 104.8 | 5.24 | 8.3 | 0.09
spoke to weld F7 | 5.00 | 20.0 | 102.6 | 5.13 | 8.3 | 0.09
spoke to weld F2 | 5.00 | 20.0 | 105.7 | 5.28 | 8.3 | 0.09
spoke to weld F9 | 5.00 | 20.0 | 103.0 | 5.15 | 8.3 | 0.09
ring L2 outer 286°→346° | 4.00 | 16.0 | 102.4 | 6.40 | 85.2 | 0.89
ring L2 outer 346°→29° | 4.50 – 8.52 | 18.0 | 179.9 | 10.00 | 34.9 | 1.13
ring L2 outer 29°→76° | 4.50 – 8.52 | 18.0 | 180.1 | 10.01 | 38.2 | 1.24
ring L2 outer 76°→136° | 4.00 | 16.0 | 102.6 | 6.41 | 85.2 | 0.90
spoke to weld F1 | 5.00 | 20.0 | 104.8 | 5.24 | 7.1 | 0.08
spoke to weld F6 | 5.00 | 20.0 | 102.6 | 5.13 | 7.1 | 0.08
spoke to weld F4 | 5.00 | 20.0 | 105.0 | 5.25 | 7.1 | 0.08
spoke to weld F11 | 5.00 | 20.0 | 102.4 | 5.12 | 7.1 | 0.07
ring L3 inner 46°→49° | 4.00 | 16.0 | 105.7 | 6.60 | 2.7 | 0.03
ring L3 inner 49°→106° | 7.25 – 11.27 | 29.0 | 273.6 | 9.43 | 25.3 | 1.89
ring L3 inner 106°→151° | 7.25 – 11.27 | 29.0 | 177.5 | 6.12 | 19.9 | 0.63
spoke to weld F5 | 5.00 | 20.0 | 105.0 | 5.25 | 8.3 | 0.09
spoke to weld F3 | 5.00 | 20.0 | 105.7 | 5.28 | 8.3 | 0.09
ring L3 outer 151°→196° | 4.50 – 8.52 | 18.0 | 177.5 | 9.86 | 37.2 | 1.17
ring L3 outer 196°→256° | 4.50 | 18.0 | 102.4 | 5.69 | 75.8 | 0.79
spoke to weld F10 | 5.00 | 20.0 | 102.4 | 5.12 | 7.1 | 0.07
spoke to weld F8 | 5.00 | 20.0 | 103.0 | 5.15 | 7.1 | 0.08
swap piece, ring L3 | 12.00 | 48.0 | 177.5 | 3.70 | 6.4 | 0.20
terminal post L1 | — | 30.0 | 360.0 | 12.00 | 10.9 | 1.41
terminal post L2 | — | 30.0 | 360.0 | 12.00 | 10.9 | 1.41
terminal post L3 | — | 30.0 | 360.0 | 12.00 | 10.9 | 1.41

Every rule (all busbar rules pass)

rule | value | limit
Lead bends | 24.7 % | ≤ 25 % | ✓
Coil corner bends | 26.8 % | ≤ 25 % | ✗
Layer-change step on the end turn | 35.1 % | ≤ 25 % | ✗
Routing with no crossings | swap 150.5° | | ✓
F-lead jog to the lead circle | straight | | ✓
Jumper bends (start lead out to the jumper) | 24.6 % | ≤ 25 % | ✓
Terminal blades | welded on | | ✓
In-plane gap between different nets | 4.05 mm | ≥ 4.00 mm | ✓
Plane above the coil heads | 0.91 mm | ≥ 0.80 mm | ✓
Jumper to the plane | 0.99 mm | ≥ 0.80 mm | ✓
Jumper to the coil body | 2.70 mm | ≥ 0.80 mm | ✓
Enamel grade (wire) | Grade 1 | | i
Copper ≥ 2 mm inside the stator OD | r 77.98 | ≤ 78.00 | ✓
Copper outside the coil bore | r 54.13 | ≥ 54.09 | ✓
Narrowest web ≥ sheet thickness | 4.00 mm | ≥ 4.00 mm | ✓
Weld pad around each lead | 5.0 mm | ≥ 4.5 mm | ✓
Weld to weld, different nets | 29.9 mm | ≥ 4.0 mm | ✓
Current density, worst | 12.0 A/mm² | ≤ 12 | ✓
Path current imbalance | 2.51 % | ≤ 4 % | ✓
Path balancing resistance | off | | i
Line-to-line resistance imbalance | 0.50 % | ≤ 1.5 % | ✓
Terminals on their own ring | yes | | ✓
Terminals close together | 35.0° | ≤ 35° | ✓
Terminal pitch for lugs | 15.1 mm | ≥ 15 mm | ✓

## Goal: Terminals closest

Terminals as close together as the rules allow. Sized for balance: each track segment is set narrow (J limit), normal, or widened into the free band around the lead circle between other-net weld pads, whichever gives the lowest worst-phase imbalance. Copper weight is ignored. 7 of 13 track segments are widened between the weld pads. Against the page default: copper +44 g, worst path imbalance -1.09 points, busbar loss -3.7 W.

Why this is the optimum

Smallest terminal span (score 4.2107): 30.5° (gaps 15° + 15.5°, held by the 15 mm lug pitch), 4.2° tighter than the default. The balanced design reaches the same 30.5° but scores worse because of 1.09 W more loss and 0.18 points more imbalance. Itself t = 4, 7 widened segments: 230.9 g, 27.16 W, 2.60 %, 19.25 mm.

Worst path imbalance

2.60 %

R 2.13 · Y 2.55 · B 2.60

Busbar copper

231 g

v7 394 g

Busbar + joint loss

27.2 W

total 660.9 W

Max current density

12.00 A/mm²

track 10.0 · spoke 5.3 · trans 3.7 · term 12.0

Height above stack

19.2 mm

v7 35.5 mm

Line-line imbalance

0.51 %

R_LL 3.400 mΩ

Rules

all pass

min gap 4.05 mm

What to look for in the pictures: The same stepped, widened copper as Lowest imbalance, with the terminals packed into the tightest cluster the lug pitch allows (30.5°).

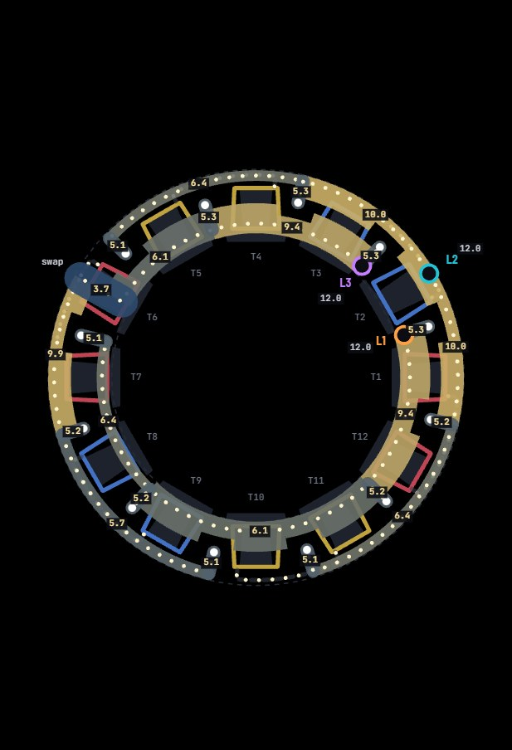
[picture p70: busbar/optimisation_report/img/g_close_planJ.jpg]
plan, current density


Plan coloured and labelled by current density (A/mm²)

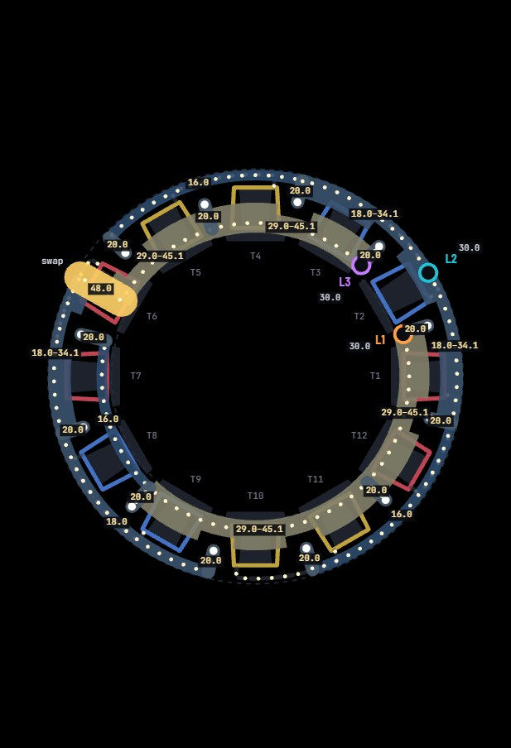
[picture p71: busbar/optimisation_report/img/g_close_planA.jpg]
plan, cross-section


Plan coloured and labelled by cross-section (mm²)

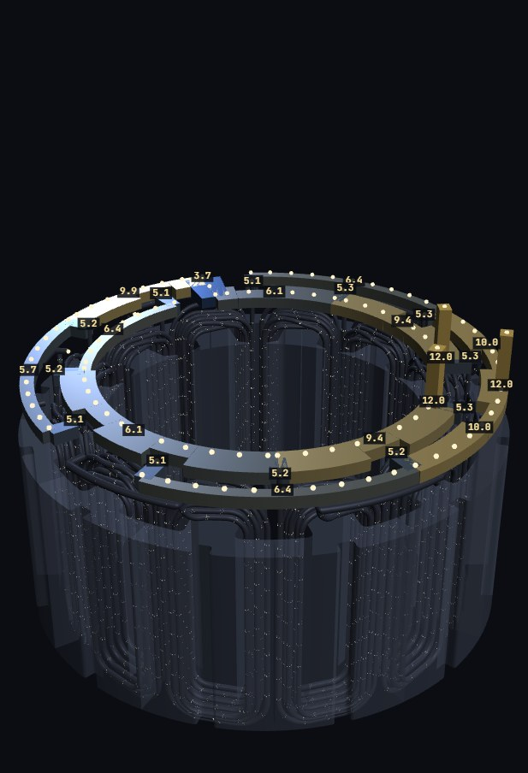
[picture p72: busbar/optimisation_report/img/g_close_d3.jpg]


3D, coloured by current density

### Parameters

Rings | L1 in / L2 out / L3 swaps
Sheet thickness t | 4 mm
Inner track width / centre r | 7.25 / 57.75 mm
Outer track width / centre r | 4.50 / 75.73 mm
Swap piece width | 12 mm
Weld pad (spoke) width | 5 mm
Lead circle r | 67.43 mm
Plane bottom z | 45.75 mm
Jumper r / z | 76 / 43.25 mm
Terminals L1 / L2 / L3 | 16.0° (inner) / 31.0° (outer) / 46.5° (inner)
Terminal span | 30.5°
Swap angle | 150.5°
Cross-section | widened for balance
Path balancing | off

### Parallel paths per phase

phase | path 1 | R mΩ | I A | path 2 | R mΩ | I A | imb %
R | T12+T1 | 9.9382 | 104.82 | T7+T6 | 10.1298 | 102.61 | 2.13
Y | T4+T5 | 9.9390 | 105.01 | T11+T10 | 10.1617 | 102.37 | 2.55
B | T3+T2 | 9.8776 | 105.73 | T8+T9 | 10.0324 | 103.01 | 2.60

I = rms coil current with all three phases running at 360 A line current.

Every busbar part: width, area, current, current density, resistance, loss

part | w mm | A mm² | I A | J A/mm² | R µΩ | loss W
ring L1 inner 166°→226° | 4.00 | 16.0 | 102.6 | 6.41 | 65.0 | 0.68
ring L1 inner 226°→316° | 7.25 – 11.27 | 29.0 | 177.8 | 6.13 | 40.6 | 1.28
ring L1 inner 316°→16° | 7.25 – 11.27 | 29.0 | 273.7 | 9.44 | 26.2 | 1.96
ring L1 inner 16°→16° | 4.00 | 16.0 | 105.7 | 6.61 | 0.5 | 0.01
spoke to weld F12 | 5.00 | 20.0 | 104.8 | 5.24 | 8.3 | 0.09
spoke to weld F7 | 5.00 | 20.0 | 102.6 | 5.13 | 8.3 | 0.09
spoke to weld F2 | 5.00 | 20.0 | 105.7 | 5.29 | 8.3 | 0.09
spoke to weld F9 | 5.00 | 20.0 | 103.0 | 5.15 | 8.3 | 0.09
ring L2 outer 286°→346° | 4.00 | 16.0 | 102.4 | 6.40 | 85.2 | 0.89
ring L2 outer 346°→31° | 4.50 – 8.52 | 18.0 | 179.9 | 9.99 | 36.2 | 1.17
ring L2 outer 31°→76° | 4.50 – 8.52 | 18.0 | 180.1 | 10.01 | 36.9 | 1.20
ring L2 outer 76°→136° | 4.00 | 16.0 | 102.6 | 6.41 | 85.2 | 0.90
spoke to weld F1 | 5.00 | 20.0 | 104.8 | 5.24 | 7.1 | 0.08
spoke to weld F6 | 5.00 | 20.0 | 102.6 | 5.13 | 7.1 | 0.08
spoke to weld F4 | 5.00 | 20.0 | 105.0 | 5.25 | 7.1 | 0.08
spoke to weld F11 | 5.00 | 20.0 | 102.4 | 5.12 | 7.1 | 0.07
ring L3 inner 46°→47° | 4.00 | 16.0 | 105.7 | 6.61 | 0.0 | 0.00
ring L3 inner 47°→106° | 7.25 – 11.27 | 29.0 | 273.5 | 9.43 | 26.3 | 1.96
ring L3 inner 106°→151° | 7.25 – 11.27 | 29.0 | 177.5 | 6.12 | 19.9 | 0.63
spoke to weld F5 | 5.00 | 20.0 | 105.0 | 5.25 | 8.3 | 0.09
spoke to weld F3 | 5.00 | 20.0 | 105.7 | 5.29 | 8.3 | 0.09
ring L3 outer 151°→196° | 4.50 – 8.52 | 18.0 | 177.5 | 9.86 | 37.2 | 1.17
ring L3 outer 196°→256° | 4.50 | 18.0 | 102.4 | 5.69 | 75.8 | 0.79
spoke to weld F10 | 5.00 | 20.0 | 102.4 | 5.12 | 7.1 | 0.07
spoke to weld F8 | 5.00 | 20.0 | 103.0 | 5.15 | 7.1 | 0.08
swap piece, ring L3 | 12.00 | 48.0 | 177.5 | 3.70 | 6.4 | 0.20
terminal post L1 | — | 30.0 | 360.0 | 12.00 | 10.9 | 1.41
terminal post L2 | — | 30.0 | 360.0 | 12.00 | 10.9 | 1.41
terminal post L3 | — | 30.0 | 360.0 | 12.00 | 10.9 | 1.41

Every rule (all busbar rules pass)

rule | value | limit
Lead bends | 24.7 % | ≤ 25 % | ✓
Coil corner bends | 26.8 % | ≤ 25 % | ✗
Layer-change step on the end turn | 35.1 % | ≤ 25 % | ✗
Routing with no crossings | swap 150.5° | | ✓
F-lead jog to the lead circle | straight | | ✓
Jumper bends (start lead out to the jumper) | 24.6 % | ≤ 25 % | ✓
Terminal blades | welded on | | ✓
In-plane gap between different nets | 4.05 mm | ≥ 4.00 mm | ✓
Plane above the coil heads | 0.91 mm | ≥ 0.80 mm | ✓
Jumper to the plane | 0.99 mm | ≥ 0.80 mm | ✓
Jumper to the coil body | 2.70 mm | ≥ 0.80 mm | ✓
Enamel grade (wire) | Grade 1 | | i
Copper ≥ 2 mm inside the stator OD | r 77.98 | ≤ 78.00 | ✓
Copper outside the coil bore | r 54.13 | ≥ 54.09 | ✓
Narrowest web ≥ sheet thickness | 4.00 mm | ≥ 4.00 mm | ✓
Weld pad around each lead | 5.0 mm | ≥ 4.5 mm | ✓
Weld to weld, different nets | 29.9 mm | ≥ 4.0 mm | ✓
Current density, worst | 12.0 A/mm² | ≤ 12 | ✓
Path current imbalance | 2.60 % | ≤ 4 % | ✓
Path balancing resistance | off | | i
Line-to-line resistance imbalance | 0.51 % | ≤ 1.5 % | ✓
Terminals on their own ring | yes | | ✓
Terminals close together | 30.5° | ≤ 35° | ✓
Terminal pitch for lugs | 15.1 mm | ≥ 15 mm | ✓

## Lowest imbalance, terminals within 60°

Lowest worst-phase path current imbalance. Rule changed: terminals may spread over 60° instead of 35°. Sized for balance: each track segment is set narrow (J limit), normal, or widened into the free band around the lead circle between other-net weld pads, whichever gives the lowest worst-phase imbalance. Copper weight is ignored. 9 of 13 track segments are widened between the weld pads. Against the page default: copper +62 g, worst path imbalance -1.67 points, busbar loss -5.3 W.

Why this is the optimum

Allowing a 60° terminal span (fully used) gives 2.021 % imbalance (score 2.6541 vs 3.1426 for the 35° optimum): 0.49 points lower, for +19.7 g copper (249.3 g) and −1.5 W loss (25.57 W), height unchanged at 19.25 mm. The terminals spread so the path that was far from its terminal gets closer, and 9 ring segments are widened. Binding: span 60°, web = t, in-plane gap, outer radius, J 12 at the terminals. This design was confirmed against the best of three independent runs.

Worst path imbalance

2.02 %

R 1.77 · Y 1.94 · B 2.02

Busbar copper

249 g

v7 394 g

Busbar + joint loss

25.6 W

total 659.3 W

Max current density

12.00 A/mm²

track 10.0 · spoke 5.3 · trans 3.7 · term 12.0

Height above stack

19.2 mm

v7 35.5 mm

Line-line imbalance

0.32 %

R_LL 3.391 mΩ

Rules

all pass

min gap 4.05 mm

What to look for in the pictures: With a 60° terminal spread the terminals move apart and a short narrow stub joins the moved terminal to its ring; the rest of the stepped, widened layout is unchanged.

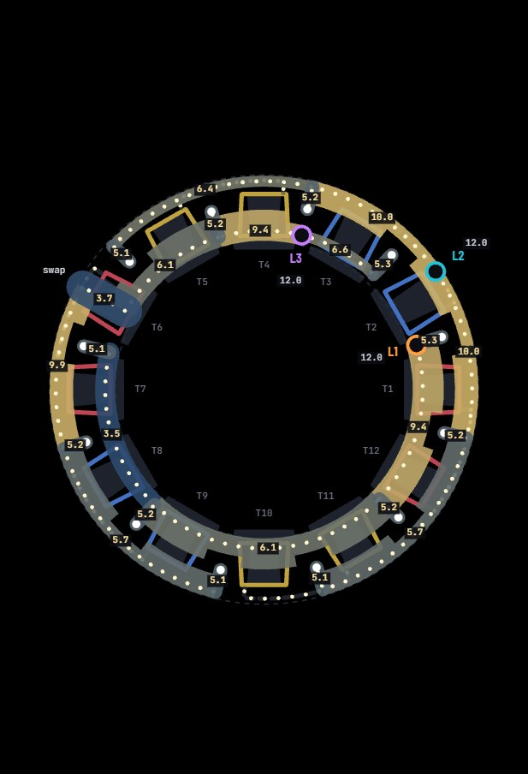
[picture p73: busbar/optimisation_report/img/v_span60_planJ.jpg]
plan, current density


Plan coloured and labelled by current density (A/mm²)

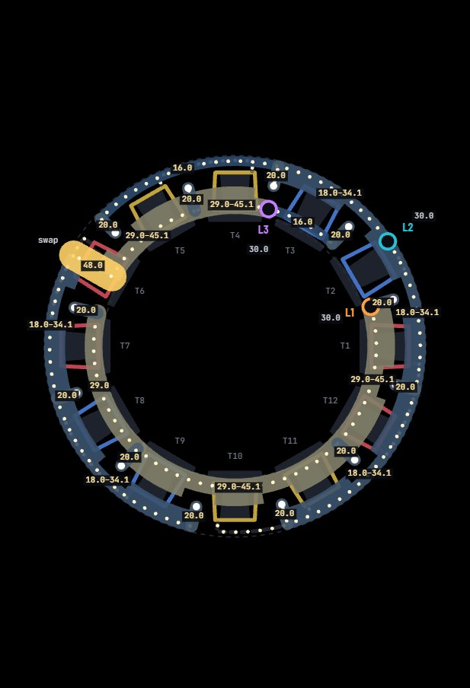
[picture p74: busbar/optimisation_report/img/v_span60_planA.jpg]
plan, cross-section


Plan coloured and labelled by cross-section (mm²)

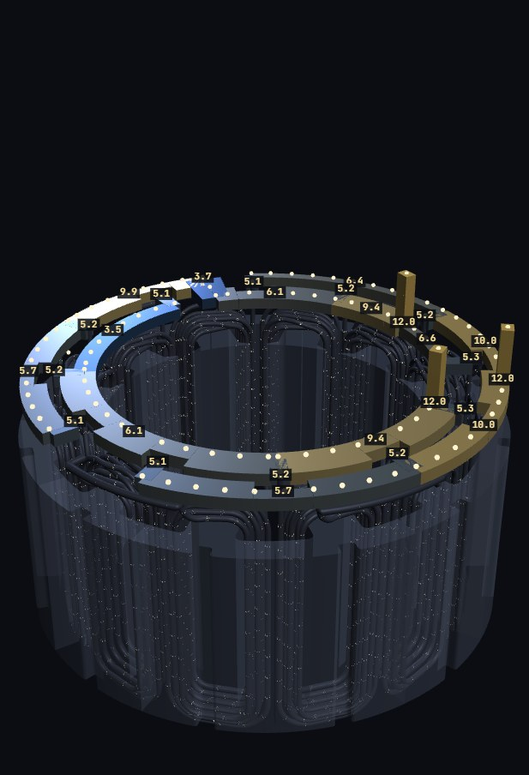
[picture p75: busbar/optimisation_report/img/v_span60_d3.jpg]


3D, coloured by current density

### Parameters

Rings | L1 in / L2 out / L3 swaps
Sheet thickness t | 4 mm
Inner track width / centre r | 7.25 / 57.75 mm
Outer track width / centre r | 4.50 / 75.73 mm
Swap piece width | 12 mm
Weld pad (spoke) width | 5 mm
Lead circle r | 67.43 mm
Plane bottom z | 45.75 mm
Jumper r / z | 76 / 43.25 mm
Terminals L1 / L2 / L3 | 16.2° (inner) / 34.5° (outer) / 76.2° (inner)
Terminal span | 60.0°
Swap angle | 150.5°
Cross-section | widened for balance
Path balancing | off

### Parallel paths per phase

phase | path 1 | R mΩ | I A | path 2 | R mΩ | I A | imb %
R | T12+T1 | 9.9408 | 104.64 | T7+T6 | 10.0984 | 102.80 | 1.77
Y | T4+T5 | 9.9238 | 104.87 | T11+T10 | 10.0829 | 102.86 | 1.94
B | T3+T2 | 9.9096 | 105.24 | T8+T9 | 10.0195 | 103.13 | 2.02

I = rms coil current with all three phases running at 360 A line current.

Every busbar part: width, area, current, current density, resistance, loss

part | w mm | A mm² | I A | J A/mm² | R µΩ | loss W
ring L1 inner 166°→226° | 7.25 | 29.0 | 102.8 | 3.54 | 35.9 | 0.38
ring L1 inner 226°→316° | 7.25 – 11.27 | 29.0 | 178.2 | 6.14 | 40.6 | 1.29
ring L1 inner 316°→16° | 7.25 – 11.27 | 29.0 | 273.9 | 9.44 | 26.2 | 1.96
ring L1 inner 16°→16° | 4.00 | 16.0 | 105.2 | 6.58 | 0.2 | 0.00
spoke to weld F12 | 5.00 | 20.0 | 104.6 | 5.23 | 8.3 | 0.09
spoke to weld F7 | 5.00 | 20.0 | 102.8 | 5.14 | 8.3 | 0.09
spoke to weld F2 | 5.00 | 20.0 | 105.2 | 5.26 | 8.3 | 0.09
spoke to weld F9 | 5.00 | 20.0 | 103.1 | 5.16 | 8.3 | 0.09
ring L2 outer 286°→346° | 4.50 – 8.52 | 18.0 | 102.9 | 5.71 | 46.3 | 0.49
ring L2 outer 346°→35° | 4.50 – 8.52 | 18.0 | 180.0 | 10.00 | 38.8 | 1.26
ring L2 outer 35°→76° | 4.50 – 8.52 | 18.0 | 180.1 | 10.00 | 34.6 | 1.12
ring L2 outer 76°→136° | 4.00 | 16.0 | 102.8 | 6.43 | 85.2 | 0.90
spoke to weld F1 | 5.00 | 20.0 | 104.6 | 5.23 | 7.1 | 0.08
spoke to weld F6 | 5.00 | 20.0 | 102.8 | 5.14 | 7.1 | 0.08
spoke to weld F4 | 5.00 | 20.0 | 104.9 | 5.24 | 7.1 | 0.08
spoke to weld F11 | 5.00 | 20.0 | 102.9 | 5.14 | 7.1 | 0.08
ring L3 inner 46°→76° | 4.00 | 16.0 | 105.2 | 6.58 | 32.3 | 0.36
ring L3 inner 76°→106° | 7.25 – 11.27 | 29.0 | 274.0 | 9.45 | 13.3 | 1.00
ring L3 inner 106°→151° | 7.25 – 11.27 | 29.0 | 178.1 | 6.14 | 19.9 | 0.63
spoke to weld F5 | 5.00 | 20.0 | 104.9 | 5.24 | 8.3 | 0.09
spoke to weld F3 | 5.00 | 20.0 | 105.2 | 5.26 | 8.3 | 0.09
ring L3 outer 151°→196° | 4.50 – 8.52 | 18.0 | 178.1 | 9.89 | 37.2 | 1.18
ring L3 outer 196°→256° | 4.50 – 8.52 | 18.0 | 102.9 | 5.71 | 46.3 | 0.49
spoke to weld F10 | 5.00 | 20.0 | 102.9 | 5.14 | 7.1 | 0.08
spoke to weld F8 | 5.00 | 20.0 | 103.1 | 5.16 | 7.1 | 0.08
swap piece, ring L3 | 12.00 | 48.0 | 178.1 | 3.71 | 6.4 | 0.20
terminal post L1 | — | 30.0 | 360.0 | 12.00 | 10.9 | 1.41
terminal post L2 | — | 30.0 | 360.0 | 12.00 | 10.9 | 1.41
terminal post L3 | — | 30.0 | 360.0 | 12.00 | 10.9 | 1.41

Every rule (all busbar rules pass)

rule | value | limit
Lead bends | 24.7 % | ≤ 25 % | ✓
Coil corner bends | 26.8 % | ≤ 25 % | ✗
Layer-change step on the end turn | 35.1 % | ≤ 25 % | ✗
Routing with no crossings | swap 150.5° | | ✓
F-lead jog to the lead circle | straight | | ✓
Jumper bends (start lead out to the jumper) | 24.6 % | ≤ 25 % | ✓
Terminal blades | welded on | | ✓
In-plane gap between different nets | 4.05 mm | ≥ 4.00 mm | ✓
Plane above the coil heads | 0.91 mm | ≥ 0.80 mm | ✓
Jumper to the plane | 0.99 mm | ≥ 0.80 mm | ✓
Jumper to the coil body | 2.70 mm | ≥ 0.80 mm | ✓
Enamel grade (wire) | Grade 1 | | i
Copper ≥ 2 mm inside the stator OD | r 77.98 | ≤ 78.00 | ✓
Copper outside the coil bore | r 54.13 | ≥ 54.09 | ✓
Narrowest web ≥ sheet thickness | 4.00 mm | ≥ 4.00 mm | ✓
Weld pad around each lead | 5.0 mm | ≥ 4.5 mm | ✓
Weld to weld, different nets | 29.9 mm | ≥ 4.0 mm | ✓
Current density, worst | 12.0 A/mm² | ≤ 12 | ✓
Path current imbalance | 2.02 % | ≤ 4 % | ✓
Path balancing resistance | off | | i
Line-to-line resistance imbalance | 0.32 % | ≤ 1.5 % | ✓
Terminals on their own ring | yes | | ✓
Terminals close together | 60.0° | ≤ 60° | ✓
Terminal pitch for lugs | 18.4 mm | ≥ 15 mm | ✓

## Lowest imbalance, terminals within 90°

Lowest worst-phase path current imbalance. Rule changed: terminals may spread over 90° instead of 35°. Sized for balance: each track segment is set narrow (J limit), normal, or widened into the free band around the lead circle between other-net weld pads, whichever gives the lowest worst-phase imbalance. Copper weight is ignored. 10 of 13 track segments are widened between the weld pads. Against the page default: copper +90 g, worst path imbalance -2.16 points, busbar loss -7.3 W.

Why this is the optimum

A 90° span (fully used) lets the optimiser change the ring arrangement (L2 inside, L3 outside, L1 swaps) and go to t = 4.5 mm with widened segments: 1.529 % imbalance (score 2.2326), 0.49 points below the 60° case, and the lowest loss of all (23.56 W). Costs: 277.0 g copper (+48 % vs the default) and the tallest stack (23.75 mm, because the thicker plane sits higher). Binding: span 90°, web = t, in-plane gap, outer radius. Confirmed as the best of three independent runs.

Worst path imbalance

1.53 %

R 1.53 · Y 1.53 · B 1.52

Busbar copper

277 g

v7 394 g

Busbar + joint loss

23.6 W

total 659.1 W

Max current density

12.00 A/mm²

track 10.6 · spoke 4.7 · trans 3.3 · term 12.0

Height above stack

23.8 mm

v7 35.5 mm

Line-line imbalance

0.63 %

R_LL 3.390 mΩ

Rules

all pass

min gap 4.55 mm

What to look for in the pictures: With a 90° spread the layout changes: ring L2 rides the inner track, L3 the outer, and L1 swaps tracks; both rings are widened, so the currents stay low.

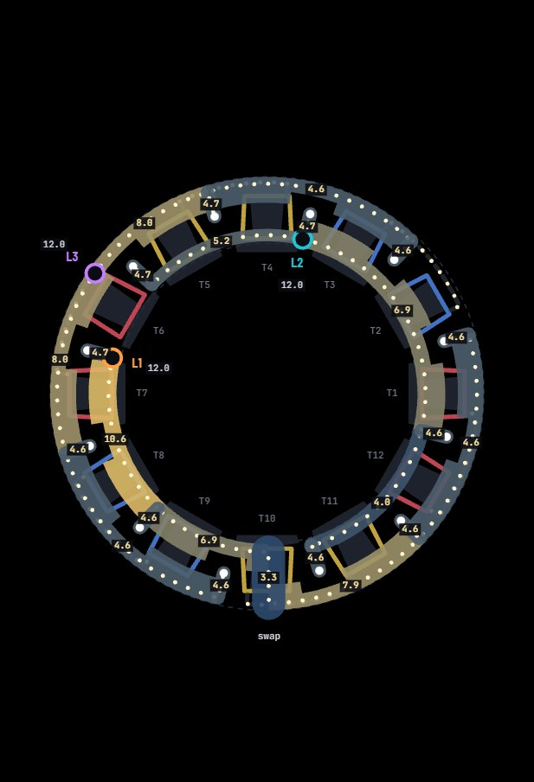
[picture p76: busbar/optimisation_report/img/v_span90_planJ.jpg]
plan, current density


Plan coloured and labelled by current density (A/mm²)

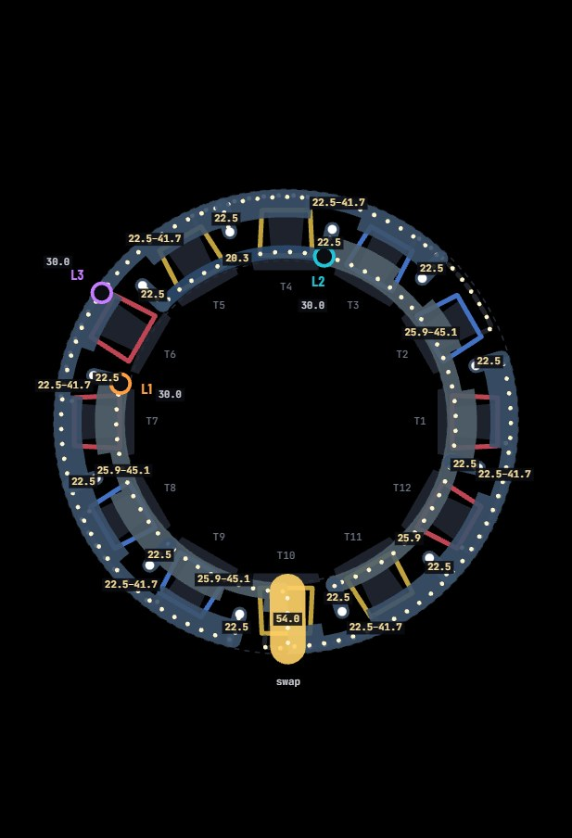
[picture p77: busbar/optimisation_report/img/v_span90_planA.jpg]
plan, cross-section


Plan coloured and labelled by cross-section (mm²)

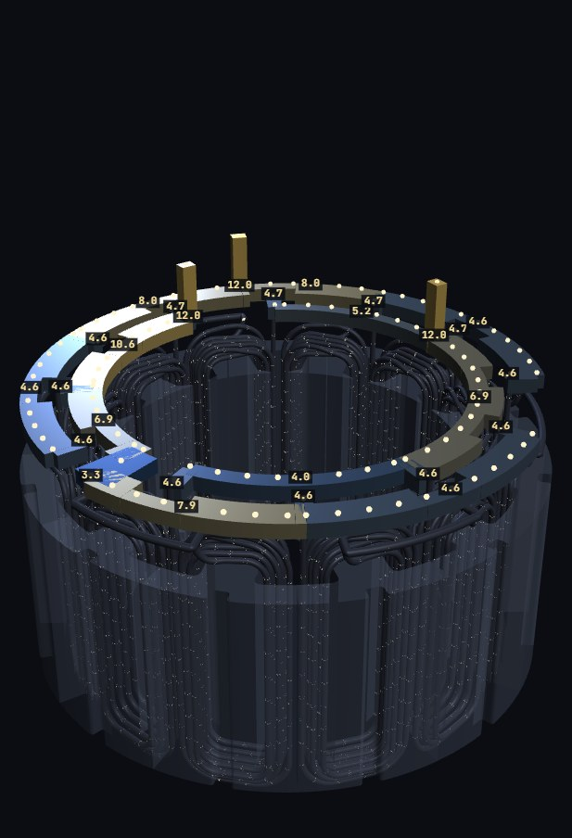
[picture p78: busbar/optimisation_report/img/v_span90_d3.jpg]


3D, coloured by current density

### Parameters

Rings | L2 in / L3 out / L1 swaps
Sheet thickness t | 4.5 mm
Inner track width / centre r | 5.75 / 57.00 mm
Outer track width / centre r | 5.00 / 75.48 mm
Swap piece width | 12 mm
Weld pad (spoke) width | 5 mm
Lead circle r | 66.43 mm
Plane bottom z | 49.75 mm
Jumper r / z | 76 / 43.25 mm
Terminals L1 / L2 / L3 | 167.0° (inner) / 77.0° (inner) / 145.0° (outer)
Terminal span | 90.0°
Swap angle | 270.5°
Cross-section | widened for balance
Path balancing | off

### Parallel paths per phase

phase | path 1 | R mΩ | I A | path 2 | R mΩ | I A | imb %
R | T12+T1 | 10.0290 | 103.27 | T7+T6 | 9.9533 | 104.86 | 1.53
Y | T4+T5 | 9.9290 | 104.71 | T11+T10 | 10.0558 | 103.13 | 1.53
B | T3+T2 | 10.0886 | 103.00 | T8+T9 | 9.9626 | 104.58 | 1.52

I = rms coil current with all three phases running at 360 A line current.

Every busbar part: width, area, current, current density, resistance, loss

part | w mm | A mm² | I A | J A/mm² | R µΩ | loss W
ring L2 inner 286°→346° | 5.75 | 25.9 | 103.1 | 3.99 | 39.7 | 0.42
ring L2 inner 346°→76° | 5.75 – 10.02 | 25.9 | 178.7 | 6.91 | 42.4 | 1.35
ring L2 inner 76°→77° | 5.75 – 10.02 | 25.9 | 274.5 | 10.61 | 0.2 | 0.02
ring L2 inner 77°→136° | 4.50 | 20.2 | 104.9 | 5.18 | 50.3 | 0.55
spoke to weld F1 | 5.00 | 22.5 | 103.3 | 4.59 | 7.2 | 0.08
spoke to weld F6 | 5.00 | 22.5 | 104.9 | 4.66 | 7.2 | 0.08
spoke to weld F4 | 5.00 | 22.5 | 104.7 | 4.65 | 7.2 | 0.08
spoke to weld F11 | 5.00 | 22.5 | 103.1 | 4.58 | 7.2 | 0.08
ring L3 outer 46°→106° | 5.00 – 9.27 | 22.5 | 103.0 | 4.58 | 38.1 | 0.40
ring L3 outer 106°→145° | 5.00 – 9.27 | 22.5 | 180.1 | 8.00 | 26.5 | 0.86
ring L3 outer 145°→196° | 5.00 – 9.27 | 22.5 | 179.9 | 8.00 | 33.4 | 1.08
ring L3 outer 196°→256° | 5.00 – 9.27 | 22.5 | 103.1 | 4.58 | 37.9 | 0.40
spoke to weld F5 | 5.00 | 22.5 | 104.7 | 4.65 | 6.9 | 0.08
spoke to weld F10 | 5.00 | 22.5 | 103.1 | 4.58 | 6.9 | 0.07
spoke to weld F3 | 5.00 | 22.5 | 103.0 | 4.58 | 6.9 | 0.07
spoke to weld F8 | 5.00 | 22.5 | 104.6 | 4.65 | 6.9 | 0.08
ring L1 inner 166°→167° | 4.50 | 20.2 | 104.9 | 5.18 | 0.4 | 0.00
ring L1 inner 167°→226° | 5.75 – 10.02 | 25.9 | 274.0 | 10.59 | 26.9 | 2.02
ring L1 inner 226°→271° | 5.75 – 10.02 | 25.9 | 178.3 | 6.89 | 20.9 | 0.66
spoke to weld F7 | 5.00 | 22.5 | 104.9 | 4.66 | 7.2 | 0.08
spoke to weld F9 | 5.00 | 22.5 | 104.6 | 4.65 | 7.2 | 0.08
ring L1 outer 271°→316° | 5.00 – 9.27 | 22.5 | 178.3 | 7.93 | 30.5 | 0.97
ring L1 outer 316°→16° | 5.00 – 9.27 | 22.5 | 103.0 | 4.58 | 37.9 | 0.40
spoke to weld F12 | 5.00 | 22.5 | 103.3 | 4.59 | 6.9 | 0.07
spoke to weld F2 | 5.00 | 22.5 | 103.0 | 4.58 | 6.9 | 0.07
swap piece, ring L1 | 12.00 | 54.0 | 178.3 | 3.30 | 5.9 | 0.19
terminal post L1 | — | 30.0 | 360.0 | 12.00 | 10.9 | 1.41
terminal post L2 | — | 30.0 | 360.0 | 12.00 | 10.9 | 1.41
terminal post L3 | — | 30.0 | 360.0 | 12.00 | 10.9 | 1.41

Every rule (all busbar rules pass)

rule | value | limit
Lead bends | 24.7 % | ≤ 25 % | ✓
Coil corner bends | 26.8 % | ≤ 25 % | ✗
Layer-change step on the end turn | 35.1 % | ≤ 25 % | ✗
Routing with no crossings | swap 270.5° | | ✓
F-lead jog to the lead circle | 1.00 mm jog | needs 4.8 mm height, has 4.9 | ✓
Jumper bends (start lead out to the jumper) | 24.6 % | ≤ 25 % | ✓
Terminal blades | welded on | | ✓
In-plane gap between different nets | 4.55 mm | ≥ 4.50 mm | ✓
Plane above the coil heads | 4.91 mm | ≥ 0.80 mm | ✓
Jumper to the plane | 4.99 mm | ≥ 0.80 mm | ✓
Jumper to the coil body | 2.70 mm | ≥ 0.80 mm | ✓
Enamel grade (wire) | Grade 1 | | i
Copper ≥ 2 mm inside the stator OD | r 77.98 | ≤ 78.00 | ✓
Copper outside the coil bore | r 54.13 | ≥ 54.09 | ✓
Narrowest web ≥ sheet thickness | 4.50 mm | ≥ 4.50 mm | ✓
Weld pad around each lead | 5.0 mm | ≥ 4.5 mm | ✓
Weld to weld, different nets | 29.4 mm | ≥ 4.0 mm | ✓
Current density, worst | 12.0 A/mm² | ≤ 12 | ✓
Path current imbalance | 1.53 % | ≤ 4 % | ✓
Path balancing resistance | off | | i
Line-to-line resistance imbalance | 0.63 % | ≤ 1.5 % | ✓
Terminals on their own ring | yes | | ✓
Terminals close together | 90.0° | ≤ 90° | ✓
Terminal pitch for lugs | 21.9 mm | ≥ 15 mm | ✓

## Least copper, current density ≤ 15 A/mm²

Least busbar copper. Rule changed: current density ≤ 15 A/mm² instead of 12. Least copper: every section is first cut to the current-density limit; then the fewest grams are added back, widening the segments that lower the imbalance most per gram, until the imbalance limit is met. 2 of 13 track segments are widened between the weld pads. Against the page default: copper -46 g, worst path imbalance +0.27 points, busbar loss +5.4 W.

Why this is the optimum

Least copper with J ≤ 15 (score 2.2327), better than the 12 A/mm² least-copper design (2.2741), which also meets these rules. 140.8 g, 6 g (4 %) lighter at the same t = 2.75 mm and 18.0 mm. Peak busbar J is only 12.43 (spoke F9): the 15 A/mm² allowance is not what limits it; the 4 % imbalance (3.96 %), the radial limits and the gap are. Cost: 36.3 W (+1.1 W).

Worst path imbalance

3.96 %

R 3.78 · Y 3.96 · B 3.96

Busbar copper

141 g

v7 394 g

Busbar + joint loss

36.3 W

total 669.8 W

Max current density

12.43 A/mm²

track 12.3 · spoke 12.4 · trans 12.2 · term 12.0

Height above stack

18.0 mm

v7 35.5 mm

Line-line imbalance

0.81 %

R_LL 3.446 mΩ

Rules

all pass

min gap 2.80 mm

What to look for in the pictures: Least copper with a 15 A/mm² allowance: thinner narrow pieces than the 12 A/mm² design, peaking at 12.4 A/mm². The higher limit is never reached because the 4 % imbalance limit binds first.

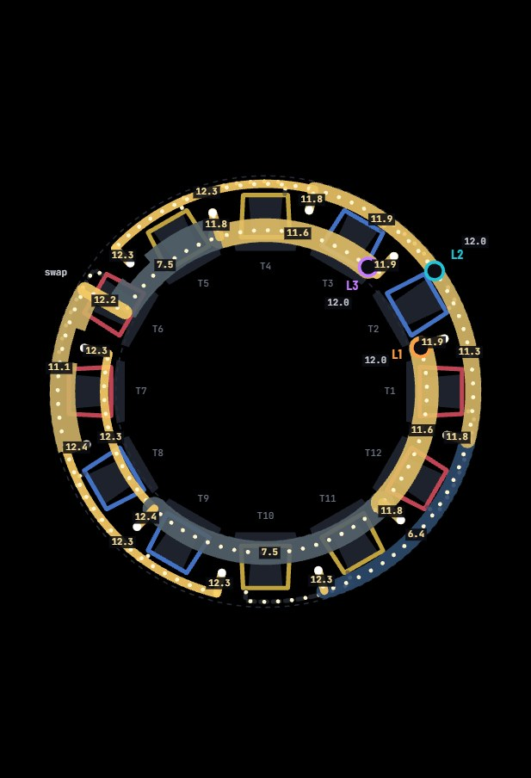
[picture p79: busbar/optimisation_report/img/v_j15_planJ.jpg]
plan, current density


Plan coloured and labelled by current density (A/mm²)

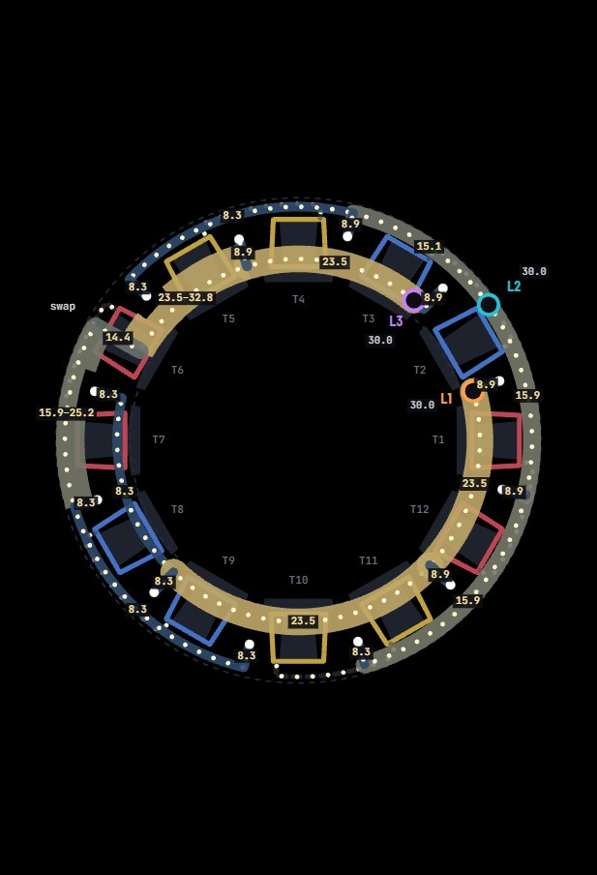
[picture p80: busbar/optimisation_report/img/v_j15_planA.jpg]
plan, cross-section


Plan coloured and labelled by cross-section (mm²)

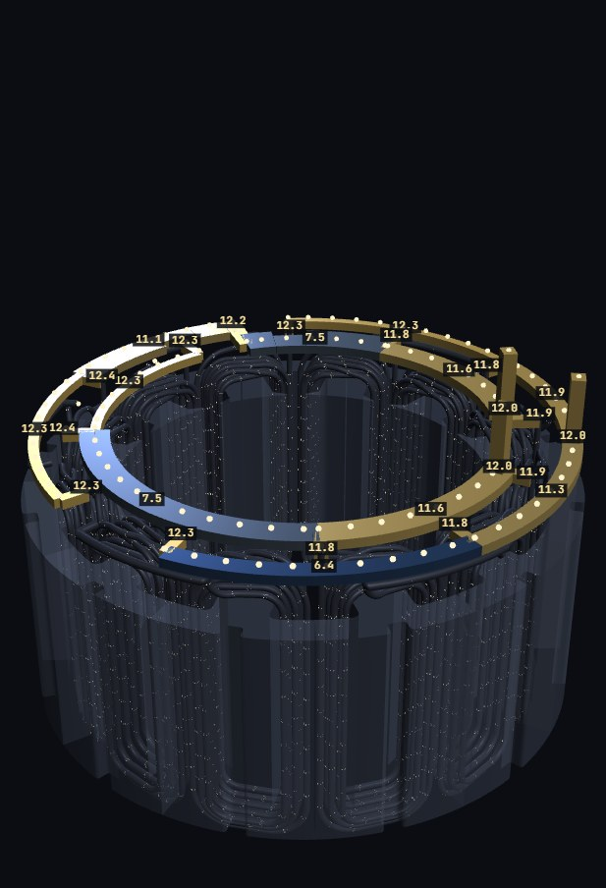
[picture p81: busbar/optimisation_report/img/v_j15_d3.jpg]


3D, coloured by current density

### Parameters

Rings | L1 in / L2 out / L3 swaps
Sheet thickness t | 2.75 mm
Inner track width / centre r | 8.54 / 58.36 mm
Outer track width / centre r | 5.77 / 75.11 mm
Swap piece width | 10.5 mm
Weld pad (spoke) width | 5 mm
Lead circle r | 67.43 mm
Plane bottom z | 45.75 mm
Jumper r / z | 76 / 43.25 mm
Terminals L1 / L2 / L3 | 15.8° (inner) / 35.5° (outer) / 50.5° (inner)
Terminal span | 34.8°
Swap angle | 150.5°
Cross-section | J limit + widened for imbalance (sized at J 12.5)
Path balancing | off

### Parallel paths per phase

phase | path 1 | R mΩ | I A | path 2 | R mΩ | I A | imb %
R | T12+T1 | 9.9942 | 105.45 | T7+T6 | 10.3454 | 101.54 | 3.78
Y | T4+T5 | 9.9832 | 105.67 | T11+T10 | 10.3310 | 101.57 | 3.96
B | T3+T2 | 9.8923 | 106.73 | T8+T9 | 10.1264 | 102.58 | 3.96

I = rms coil current with all three phases running at 360 A line current.

Every busbar part: width, area, current, current density, resistance, loss

part | w mm | A mm² | I A | J A/mm² | R µΩ | loss W
ring L1 inner 166°→226° | 3.00 | 8.2 | 101.5 | 12.31 | 127.4 | 1.31
ring L1 inner 226°→316° | 8.54 | 23.5 | 176.4 | 7.51 | 67.2 | 2.09
ring L1 inner 316°→16° | 8.54 | 23.5 | 272.8 | 11.62 | 44.2 | 3.29
ring L1 inner 16°→16° | 3.25 | 8.9 | 106.7 | 11.94 | 1.4 | 0.02
spoke to weld F12 | 3.25 | 8.9 | 105.5 | 11.80 | 14.4 | 0.16
spoke to weld F7 | 3.00 | 8.2 | 101.5 | 12.31 | 15.2 | 0.16
spoke to weld F2 | 3.25 | 8.9 | 106.7 | 11.94 | 14.4 | 0.16
spoke to weld F9 | 3.00 | 8.2 | 102.6 | 12.43 | 15.2 | 0.16
ring L2 outer 286°→346° | 5.77 | 15.9 | 101.6 | 6.40 | 85.2 | 0.88
ring L2 outer 346°→36° | 5.77 | 15.9 | 180.0 | 11.33 | 69.6 | 2.25
ring L2 outer 36°→76° | 5.50 | 15.1 | 180.1 | 11.91 | 61.1 | 1.98
ring L2 outer 76°→136° | 3.00 | 8.2 | 101.5 | 12.31 | 164.0 | 1.69
spoke to weld F1 | 3.25 | 8.9 | 105.5 | 11.80 | 11.8 | 0.13
spoke to weld F6 | 3.00 | 8.2 | 101.5 | 12.31 | 12.3 | 0.13
spoke to weld F4 | 3.25 | 8.9 | 105.7 | 11.82 | 11.8 | 0.13
spoke to weld F11 | 3.00 | 8.2 | 101.6 | 12.31 | 12.3 | 0.13
ring L3 inner 46°→51° | 3.25 | 8.9 | 106.7 | 11.94 | 7.9 | 0.09
ring L3 inner 51°→106° | 8.54 | 23.5 | 272.8 | 11.62 | 41.8 | 3.11
ring L3 inner 106°→151° | 8.54 – 11.94 | 23.5 | 176.2 | 7.51 | 26.1 | 0.81
spoke to weld F5 | 3.25 | 8.9 | 105.7 | 11.82 | 14.4 | 0.16
spoke to weld F3 | 3.25 | 8.9 | 106.7 | 11.94 | 14.4 | 0.16
ring L3 outer 151°→196° | 5.77 – 9.17 | 15.9 | 176.2 | 11.10 | 45.6 | 1.42
ring L3 outer 196°→256° | 3.00 | 8.2 | 101.6 | 12.31 | 164.0 | 1.69
spoke to weld F10 | 3.00 | 8.2 | 101.6 | 12.31 | 12.3 | 0.13
spoke to weld F8 | 3.00 | 8.2 | 102.6 | 12.43 | 12.3 | 0.13
swap piece, ring L3 | 5.25 | 14.4 | 176.2 | 12.21 | 20.0 | 0.62
terminal post L1 | — | 30.0 | 360.0 | 12.00 | 10.9 | 1.41
terminal post L2 | — | 30.0 | 360.0 | 12.00 | 10.9 | 1.41
terminal post L3 | — | 30.0 | 360.0 | 12.00 | 10.9 | 1.41

Every rule (all busbar rules pass)

rule | value | limit
Lead bends | 24.7 % | ≤ 25 % | ✓
Coil corner bends | 26.8 % | ≤ 25 % | ✗
Layer-change step on the end turn | 35.1 % | ≤ 25 % | ✗
Routing with no crossings | swap 150.5° | | ✓
F-lead jog to the lead circle | straight | | ✓
Jumper bends (start lead out to the jumper) | 24.6 % | ≤ 25 % | ✓
Terminal blades | welded on | | ✓
In-plane gap between different nets | 2.80 mm | ≥ 2.75 mm | ✓
Plane above the coil heads | 0.91 mm | ≥ 0.80 mm | ✓
Jumper to the plane | 0.99 mm | ≥ 0.80 mm | ✓
Jumper to the coil body | 2.70 mm | ≥ 0.80 mm | ✓
Enamel grade (wire) | Grade 1 | | i
Copper ≥ 2 mm inside the stator OD | r 78.00 | ≤ 78.00 | ✓
Copper outside the coil bore | r 54.09 | ≥ 54.09 | ✓
Narrowest web ≥ sheet thickness | 3.00 mm | ≥ 2.75 mm | ✓
Weld pad around each lead | 5.0 mm | ≥ 4.5 mm | ✓
Weld to weld, different nets | 29.9 mm | ≥ 4.0 mm | ✓
Current density, worst | 12.4 A/mm² | ≤ 15 | ✓
Path current imbalance | 3.96 % | ≤ 4 % | ✓
Path balancing resistance | off | | i
Line-to-line resistance imbalance | 0.81 % | ≤ 1.5 % | ✓
Terminals on their own ring | yes | | ✓
Terminals close together | 34.8° | ≤ 35° | ✓
Terminal pitch for lugs | 15.3 mm | ≥ 15 mm | ✓

## Least copper, path imbalance ≤ 6 %

Least busbar copper. Rule changed: path imbalance ≤ 6 % instead of 4 %. Each section at the J limit: every track segment, spoke body and the swap piece is cut to I ÷ (J × t), never narrower than the sheet thickness. Against the page default: copper -68 g, worst path imbalance +1.52 points, busbar loss +8.4 W.

Why this is the optimum

Least copper with 6 % imbalance allowed (score 1.9971): 119.1 g, 27.7 g below the 4 % least-copper design and 36 % below the default, at t = 2.75 and 18.0 mm, every section at the J limit (11 parts within 3 % of 12 A/mm²) and nothing widened. Imbalance ends at 5.21 %, so J, the outer radius, span and gap are what limit it. Cost: 39.24 W (+8.4 W vs the default).

Worst path imbalance

5.21 %

R 4.04 · Y 5.20 · B 5.21

Busbar copper

119 g

v7 394 g

Busbar + joint loss

39.2 W

total 672.9 W

Max current density

12.00 A/mm²

track 12.0 · spoke 11.9 · trans 11.6 · term 12.0

Height above stack

18.0 mm

v7 35.5 mm

Line-line imbalance

0.72 %

R_LL 3.461 mΩ

Rules

all pass

min gap 2.82 mm

What to look for in the pictures: Each ring tapers from thin far ends (8.9 mm²) to wide sections at the terminals (23 mm²), so almost every label reads 11–12 A/mm²; no widening is needed because 6 % imbalance is allowed.

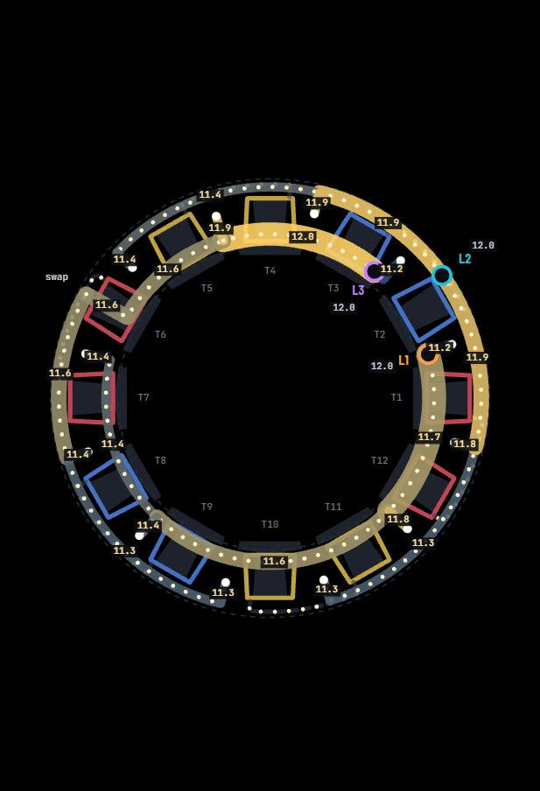
[picture p82: busbar/optimisation_report/img/v_pi6_planJ.jpg]
plan, current density


Plan coloured and labelled by current density (A/mm²)

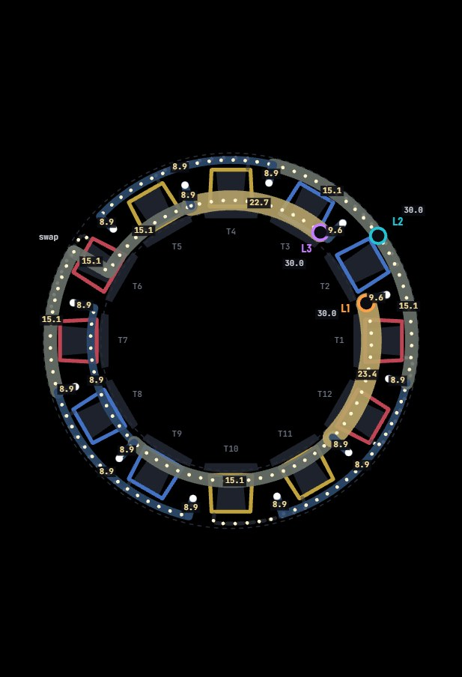
[picture p83: busbar/optimisation_report/img/v_pi6_planA.jpg]
plan, cross-section


Plan coloured and labelled by cross-section (mm²)

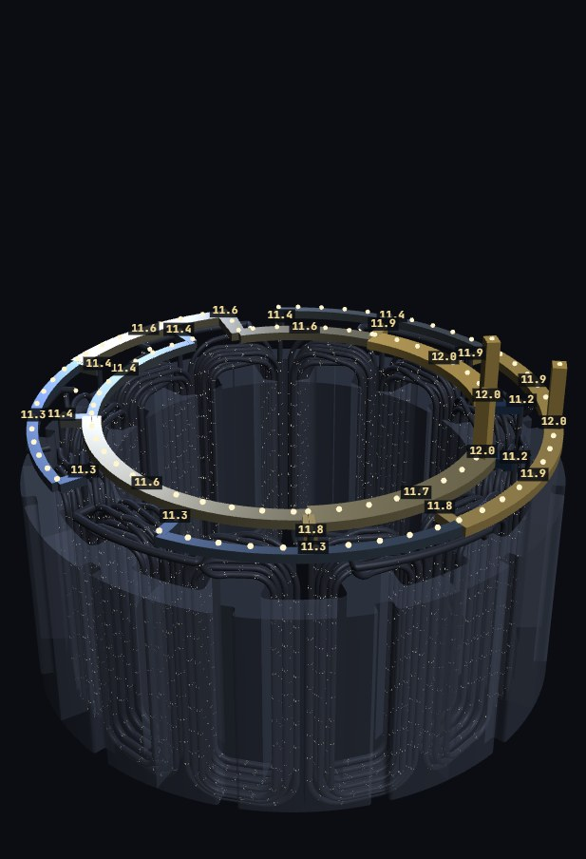
[picture p84: busbar/optimisation_report/img/v_pi6_d3.jpg]


3D, coloured by current density

### Parameters

Rings | L1 in / L2 out / L3 swaps
Sheet thickness t | 2.75 mm
Inner track width / centre r | 8.54 / 58.36 mm
Outer track width / centre r | 5.77 / 75.11 mm
Swap piece width | 10 mm
Weld pad (spoke) width | 5 mm
Lead circle r | 67.43 mm
Plane bottom z | 45.75 mm
Jumper r / z | 76 / 43.25 mm
Terminals L1 / L2 / L3 | 15.5° (inner) / 35.5° (outer) / 50.5° (inner)
Terminal span | 35.0°
Swap angle | 150.5°
Cross-section | J limit (sized at J 12)
Path balancing | off

### Parallel paths per phase

phase | path 1 | R mΩ | I A | path 2 | R mΩ | I A | imb %
R | T12+T1 | 9.9976 | 105.67 | T7+T6 | 10.3589 | 101.49 | 4.04
Y | T4+T5 | 9.9846 | 106.20 | T11+T10 | 10.4353 | 100.82 | 5.20
B | T3+T2 | 9.8908 | 107.41 | T8+T9 | 10.2106 | 101.96 | 5.21

I = rms coil current with all three phases running at 360 A line current.

Every busbar part: width, area, current, current density, resistance, loss

part | w mm | A mm² | I A | J A/mm² | R µΩ | loss W
ring L1 inner 166°→226° | 3.25 | 8.9 | 101.5 | 11.36 | 117.6 | 1.21
ring L1 inner 226°→316° | 5.50 | 15.1 | 175.7 | 11.61 | 104.2 | 3.22
ring L1 inner 316°→16° | 8.50 | 23.4 | 272.4 | 11.66 | 44.2 | 3.28
ring L1 inner 16°→16° | 3.50 | 9.6 | 107.4 | 11.16 | 1.8 | 0.02
spoke to weld F12 | 3.25 | 8.9 | 105.7 | 11.82 | 14.4 | 0.16
spoke to weld F7 | 3.25 | 8.9 | 101.5 | 11.36 | 14.4 | 0.15
spoke to weld F2 | 3.50 | 9.6 | 107.4 | 11.16 | 13.8 | 0.16
spoke to weld F9 | 3.25 | 8.9 | 102.0 | 11.41 | 14.4 | 0.15
ring L2 outer 286°→346° | 3.25 | 8.9 | 100.8 | 11.28 | 151.4 | 1.54
ring L2 outer 346°→36° | 5.50 | 15.1 | 179.5 | 11.87 | 73.1 | 2.36
ring L2 outer 36°→76° | 5.50 | 15.1 | 180.5 | 11.94 | 61.1 | 1.99
ring L2 outer 76°→136° | 3.25 | 8.9 | 101.5 | 11.36 | 151.4 | 1.56
spoke to weld F1 | 3.25 | 8.9 | 105.7 | 11.82 | 11.8 | 0.13
spoke to weld F6 | 3.25 | 8.9 | 101.5 | 11.36 | 11.8 | 0.12
spoke to weld F4 | 3.25 | 8.9 | 106.2 | 11.88 | 11.8 | 0.13
spoke to weld F11 | 3.25 | 8.9 | 100.8 | 11.28 | 11.8 | 0.12
ring L3 inner 46°→51° | 3.50 | 9.6 | 107.4 | 11.16 | 7.3 | 0.08
ring L3 inner 51°→106° | 8.25 | 22.7 | 272.2 | 12.00 | 43.2 | 3.20
ring L3 inner 106°→151° | 5.50 | 15.1 | 175.0 | 11.57 | 51.0 | 1.56
spoke to weld F5 | 3.25 | 8.9 | 106.2 | 11.88 | 14.4 | 0.16
spoke to weld F3 | 3.50 | 9.6 | 107.4 | 11.16 | 13.8 | 0.16
ring L3 outer 151°→196° | 5.50 | 15.1 | 175.0 | 11.57 | 68.5 | 2.10
ring L3 outer 196°→256° | 3.25 | 8.9 | 100.8 | 11.28 | 151.4 | 1.54
spoke to weld F10 | 3.25 | 8.9 | 100.8 | 11.28 | 11.8 | 0.12
spoke to weld F8 | 3.25 | 8.9 | 102.0 | 11.41 | 11.8 | 0.12
swap piece, ring L3 | 5.50 | 15.1 | 175.0 | 11.57 | 19.1 | 0.58
terminal post L1 | — | 30.0 | 360.0 | 12.00 | 10.9 | 1.41
terminal post L2 | — | 30.0 | 360.0 | 12.00 | 10.9 | 1.41
terminal post L3 | — | 30.0 | 360.0 | 12.00 | 10.9 | 1.41

Every rule (all busbar rules pass)

rule | value | limit
Lead bends | 24.7 % | ≤ 25 % | ✓
Coil corner bends | 26.8 % | ≤ 25 % | ✗
Layer-change step on the end turn | 35.1 % | ≤ 25 % | ✗
Routing with no crossings | swap 150.5° | | ✓
F-lead jog to the lead circle | straight | | ✓
Jumper bends (start lead out to the jumper) | 24.6 % | ≤ 25 % | ✓
Terminal blades | welded on | | ✓
In-plane gap between different nets | 2.82 mm | ≥ 2.75 mm | ✓
Plane above the coil heads | 0.91 mm | ≥ 0.80 mm | ✓
Jumper to the plane | 0.99 mm | ≥ 0.80 mm | ✓
Jumper to the coil body | 2.70 mm | ≥ 0.80 mm | ✓
Enamel grade (wire) | Grade 1 | | i
Copper ≥ 2 mm inside the stator OD | r 77.86 | ≤ 78.00 | ✓
Copper outside the coil bore | r 54.11 | ≥ 54.09 | ✓
Narrowest web ≥ sheet thickness | 3.25 mm | ≥ 2.75 mm | ✓
Weld pad around each lead | 5.0 mm | ≥ 4.5 mm | ✓
Weld to weld, different nets | 29.9 mm | ≥ 4.0 mm | ✓
Current density, worst | 12.0 A/mm² | ≤ 12 | ✓
Path current imbalance | 5.21 % | ≤ 6 % | ✓
Path balancing resistance | off | | i
Line-to-line resistance imbalance | 0.72 % | ≤ 1.5 % | ✓
Terminals on their own ring | yes | | ✓
Terminals close together | 35.0° | ≤ 35° | ✓
Terminal pitch for lugs | 15.3 mm | ≥ 15 mm | ✓

## Lowest imbalance with path balancing (extra resistance) allowed

Lowest worst-phase path current imbalance. Path balancing allowed: up to 500 µΩ of extra series resistance per path. Sized for balance: each track segment is set narrow (J limit), normal, or widened into the free band around the lead circle between other-net weld pads, whichever gives the lowest worst-phase imbalance. Copper weight is ignored. Balancing resistances used: balancing resistance at T3 314 µΩ, balancing resistance at T4 276 µΩ, balancing resistance at T12 274 µΩ. These are extra wire (≈ 75–150 mm each) that must be built in. 7 of 13 track segments are widened between the weld pads. Against the page default: copper +5 g, worst path imbalance -3.69 points, busbar loss +8.7 W.

Why this is the optimum

With path balancing allowed, imbalance is essentially zero (0.0001 %, score 0.6655). Balancing resistances 314, 276 and 274 µΩ (largest 63 % of the 500 µΩ bound) at three welds; the other three paths need none. t = 3 mm with 7 widened segments: 191.6 g, 18.25 mm, 30.5° span. Cost: 39.53 W busbar + joint loss including 9.34 W in the balancing resistances, 12.4 W above the copper-only lowest-imbalance design, plus three extra wire lengths to build.

Worst path imbalance

0.00 %

R 0.00 · Y 0.00 · B 0.00

Busbar copper

192 g

v7 394 g

Busbar + joint loss

39.5 W

total 672.9 W

Max current density

12.00 A/mm²

track 11.6 · spoke 7.0 · trans 5.2 · term 12.0

Height above stack

18.2 mm

v7 35.5 mm

Line-line imbalance

0.39 %

R_LL 3.461 mΩ

Rules

all pass

min gap 3.05 mm

What to look for in the pictures: The thin, stepped plate of Lowest height plus three welds where balancing resistance is added (red rings on the plan with their values, red markers in 3D).

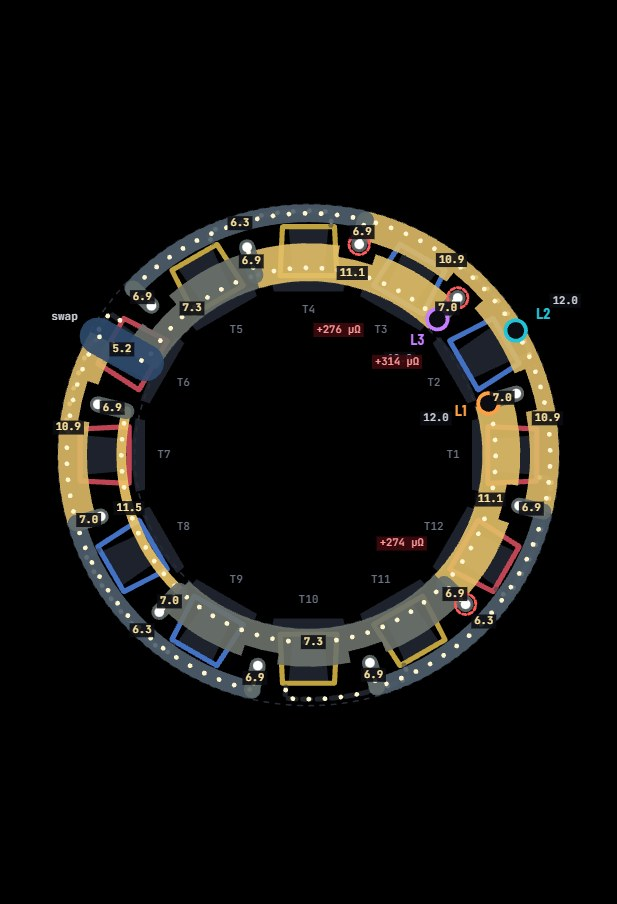
[picture p85: busbar/optimisation_report/img/v_bal_planJ.jpg]
plan, current density


Plan coloured and labelled by current density (A/mm²)

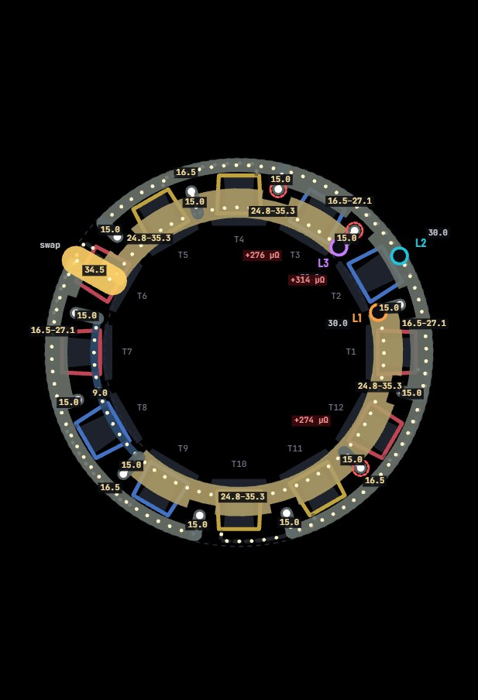
[picture p86: busbar/optimisation_report/img/v_bal_planA.jpg]
plan, cross-section


Plan coloured and labelled by cross-section (mm²)

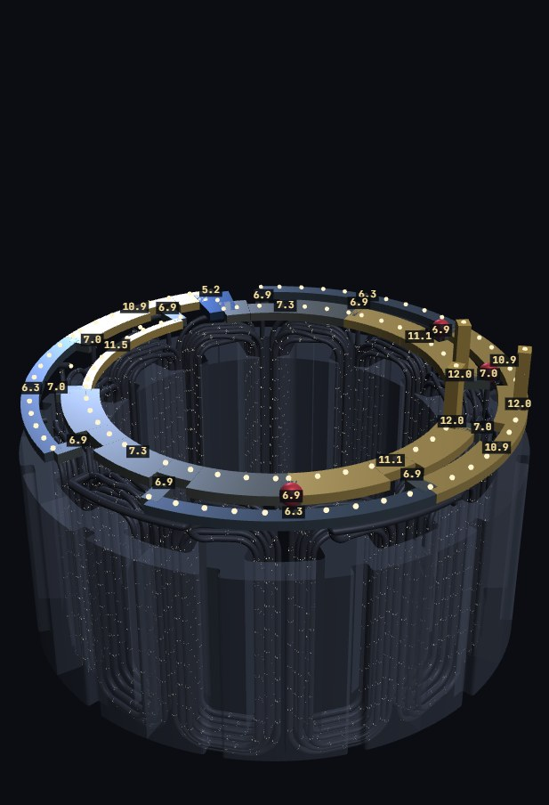
[picture p87: busbar/optimisation_report/img/v_bal_d3.jpg]


3D, coloured by current density

### Parameters

Rings | L1 in / L2 out / L3 swaps
Sheet thickness t | 3 mm
Inner track width / centre r | 8.25 / 58.25 mm
Outer track width / centre r | 5.50 / 75.23 mm
Swap piece width | 11.5 mm
Weld pad (spoke) width | 5 mm
Lead circle r | 67.43 mm
Plane bottom z | 45.75 mm
Jumper r / z | 76 / 43.25 mm
Terminals L1 / L2 / L3 | 16.0° (inner) / 31.0° (outer) / 46.5° (inner)
Terminal span | 30.5°
Swap angle | 150.5°
Cross-section | widened for balance
Path balancing | on

### Parallel paths per phase

phase | path 1 | R mΩ | I A | path 2 | R mΩ | I A | imb %
R | T12+T1 | 10.2235 | 103.65 | T7+T6 | 10.1985 | 103.65 | 0.00
Y | T4+T5 | 10.2255 | 103.74 | T11+T10 | 10.1881 | 103.74 | 0.00
B | T3+T2 | 10.1915 | 104.39 | T8+T9 | 10.0657 | 104.39 | 0.00

I = rms coil current with all three phases running at 360 A line current.

Every busbar part: width, area, current, current density, resistance, loss

part | w mm | A mm² | I A | J A/mm² | R µΩ | loss W
ring L1 inner 166°→226° | 3.00 | 9.0 | 103.6 | 11.52 | 116.6 | 1.25
ring L1 inner 226°→316° | 8.25 – 11.77 | 24.8 | 179.9 | 7.27 | 49.8 | 1.61
ring L1 inner 316°→16° | 8.25 – 11.77 | 24.8 | 274.6 | 11.10 | 32.4 | 2.44
ring L1 inner 16°→16° | 3.00 | 9.0 | 104.4 | 11.60 | 0.9 | 0.01
spoke to weld F12 | 5.00 | 15.0 | 103.6 | 6.91 | 10.5 | 0.11
spoke to weld F7 | 5.00 | 15.0 | 103.6 | 6.91 | 10.5 | 0.11
spoke to weld F2 | 5.00 | 15.0 | 104.4 | 6.96 | 10.5 | 0.11
spoke to weld F9 | 5.00 | 15.0 | 104.4 | 6.96 | 10.5 | 0.11
ring L2 outer 286°→346° | 5.50 | 16.5 | 103.7 | 6.29 | 82.1 | 0.88
ring L2 outer 346°→31° | 5.50 – 9.02 | 16.5 | 180.1 | 10.91 | 42.0 | 1.36
ring L2 outer 31°→76° | 5.50 – 9.02 | 16.5 | 179.9 | 10.91 | 42.6 | 1.38
ring L2 outer 76°→136° | 5.50 | 16.5 | 103.6 | 6.28 | 82.1 | 0.88
spoke to weld F1 | 5.00 | 15.0 | 103.6 | 6.91 | 8.9 | 0.10
spoke to weld F6 | 5.00 | 15.0 | 103.6 | 6.91 | 8.9 | 0.10
spoke to weld F4 | 5.00 | 15.0 | 103.7 | 6.92 | 8.9 | 0.10
spoke to weld F11 | 5.00 | 15.0 | 103.7 | 6.92 | 8.9 | 0.10
ring L3 inner 46°→47° | 3.00 | 9.0 | 104.4 | 11.60 | 0.1 | 0.00
ring L3 inner 47°→106° | 8.25 – 11.77 | 24.8 | 274.6 | 11.09 | 32.5 | 2.45
ring L3 inner 106°→151° | 8.25 – 11.77 | 24.8 | 179.8 | 7.26 | 24.5 | 0.79
spoke to weld F5 | 5.00 | 15.0 | 103.7 | 6.92 | 10.5 | 0.11
spoke to weld F3 | 5.00 | 15.0 | 104.4 | 6.96 | 10.5 | 0.11
ring L3 outer 151°→196° | 5.50 – 9.02 | 16.5 | 179.8 | 10.90 | 43.0 | 1.39
ring L3 outer 196°→256° | 5.50 | 16.5 | 103.7 | 6.29 | 82.1 | 0.88
spoke to weld F10 | 5.00 | 15.0 | 103.7 | 6.92 | 8.9 | 0.10
spoke to weld F8 | 5.00 | 15.0 | 104.4 | 6.96 | 8.9 | 0.10
swap piece, ring L3 | 11.50 | 34.5 | 179.8 | 5.21 | 8.5 | 0.27
terminal post L1 | — | 30.0 | 360.0 | 12.00 | 10.9 | 1.41
terminal post L2 | — | 30.0 | 360.0 | 12.00 | 10.9 | 1.41
terminal post L3 | — | 30.0 | 360.0 | 12.00 | 10.9 | 1.41

Every rule (all busbar rules pass)

rule | value | limit
Lead bends | 24.7 % | ≤ 25 % | ✓
Coil corner bends | 26.8 % | ≤ 25 % | ✗
Layer-change step on the end turn | 35.1 % | ≤ 25 % | ✗
Routing with no crossings | swap 150.5° | | ✓
F-lead jog to the lead circle | straight | | ✓
Jumper bends (start lead out to the jumper) | 24.6 % | ≤ 25 % | ✓
Terminal blades | welded on | | ✓
In-plane gap between different nets | 3.05 mm | ≥ 3.00 mm | ✓
Plane above the coil heads | 0.91 mm | ≥ 0.80 mm | ✓
Jumper to the plane | 0.99 mm | ≥ 0.80 mm | ✓
Jumper to the coil body | 2.70 mm | ≥ 0.80 mm | ✓
Enamel grade (wire) | Grade 1 | | i
Copper ≥ 2 mm inside the stator OD | r 77.98 | ≤ 78.00 | ✓
Copper outside the coil bore | r 54.13 | ≥ 54.09 | ✓
Narrowest web ≥ sheet thickness | 3.00 mm | ≥ 3.00 mm | ✓
Weld pad around each lead | 5.0 mm | ≥ 4.5 mm | ✓
Weld to weld, different nets | 29.9 mm | ≥ 4.0 mm | ✓
Current density, worst | 12.0 A/mm² | ≤ 12 | ✓
Path current imbalance | 0.00 % | ≤ 4 % | ✓
Path balancing resistance | 314 µΩ max | ≤ 500 µΩ | ✓
Line-to-line resistance imbalance | 0.39 % | ≤ 1.5 % | ✓
Terminals on their own ring | yes | | ✓
Terminals close together | 30.5° | ≤ 35° | ✓
Terminal pitch for lugs | 15.3 mm | ≥ 15 mm | ✓

## Comparison

design | section | worst path imb % | busbar Cu g | busbar loss W | total loss W | J max | height mm | span | LL imb %
v7 as built | 4 stacked levels | 2.92 | 394 | 42.8 | 684.6 | 12 | 35.5 | 60° | 1.49
Page default (earlier balanced optimum) | uniform | 3.69 | 187 | 30.9 | 664.7 | 12.00 | 19.2 | 35° | 0.63
Goal: Balanced | widened for balance | 2.78 | 214 | 28.3 | 662.0 | 12.00 | 19.0 | 30° | 0.55
Goal: Lowest loss | widened for balance | 2.51 | 238 | 26.8 | 660.5 | 12.00 | 19.2 | 35° | 0.41
Goal: Lowest height | widened for balance | 3.03 | 191 | 29.8 | 663.3 | 12.00 | 18.2 | 35° | 0.46
Goal: Least copper | J limit + widened for imbalance | 3.81 | 147 | 35.2 | 668.7 | 12.00 | 18.0 | 34° | 0.86
Goal: Lowest imbalance | widened for balance | 2.51 | 230 | 27.1 | 660.8 | 12.00 | 19.2 | 35° | 0.50
Goal: Terminals closest | widened for balance | 2.60 | 231 | 27.2 | 660.9 | 12.00 | 19.2 | 30° | 0.51
Lowest imbalance, terminals within 60° | widened for balance | 2.02 | 249 | 25.6 | 659.3 | 12.00 | 19.2 | 60° | 0.32
Lowest imbalance, terminals within 90° | widened for balance | 1.53 | 277 | 23.6 | 659.1 | 12.00 | 23.8 | 90° | 0.63
Least copper, current density ≤ 15 A/mm² | J limit + widened for imbalance | 3.96 | 141 | 36.3 | 669.8 | 12.43 | 18.0 | 35° | 0.81
Least copper, path imbalance ≤ 6 % | J limit | 5.21 | 119 | 39.2 | 672.9 | 12.00 | 18.0 | 35° | 0.72
Lowest imbalance with path balancing (extra resistance) allowed | widened for balance + balancing | 0.00 | 192 | 39.5 | 672.9 | 12.00 | 18.2 | 30° | 0.39

### Trade-offs

● uniform ● each section at the J limit ● J limit + widened for imbalance ● widened for balance ● with balancing resistance ● v7

Lower-left is better in both charts. Copper buys lower loss and lower imbalance; the least-copper designs sit at the top-left, the widened designs at the bottom-right. The balancing design reaches 0 % imbalance but has the highest loss.

### Worst path imbalance

v7 as built (4 stacked levels)2.92 %

Page default (earlier balanced optimum)3.69 %

Goal: Balanced2.78 %

Goal: Lowest loss2.51 %

Goal: Lowest height3.03 %

Goal: Least copper3.81 %

Goal: Lowest imbalance2.51 %

Goal: Terminals closest2.60 %

Lowest imbalance, terminals within 60°2.02 %

Lowest imbalance, terminals within 90°1.53 %

Least copper, current density ≤ 15 A/mm²3.96 %

Least copper, path imbalance ≤ 6 %5.21 %

Lowest imbalance with path balancing (extra resistance) allowed0.00 %

### Busbar copper

v7 as built (4 stacked levels)394 g

Page default (earlier balanced optimum)187 g

Goal: Balanced214 g

Goal: Lowest loss238 g

Goal: Lowest height191 g

Goal: Least copper147 g

Goal: Lowest imbalance230 g

Goal: Terminals closest231 g

Lowest imbalance, terminals within 60°249 g

Lowest imbalance, terminals within 90°277 g

Least copper, current density ≤ 15 A/mm²141 g

Least copper, path imbalance ≤ 6 %119 g

Lowest imbalance with path balancing (extra resistance) allowed192 g

### Busbar + joint loss

v7 as built (4 stacked levels)42.8 W

Page default (earlier balanced optimum)30.9 W

Goal: Balanced28.3 W

Goal: Lowest loss26.8 W

Goal: Lowest height29.8 W

Goal: Least copper35.2 W

Goal: Lowest imbalance27.1 W

Goal: Terminals closest27.2 W

Lowest imbalance, terminals within 60°25.6 W

Lowest imbalance, terminals within 90°23.6 W

Least copper, current density ≤ 15 A/mm²36.3 W

Least copper, path imbalance ≤ 6 %39.2 W

Lowest imbalance with path balancing (extra resistance) allowed39.5 W

### What to take from it

- Copper alone (no extra resistance) gets the worst path imbalance from 3.69 % (page default) to 2.51 % with terminals within 35°, by widening the weaker paths' ring segments into the free room between the weld pads; allowing the terminals to spread to 60° / 90° gives 2.02 % / 1.53 %.
- The least-copper design (147 g, 37 % of v7) cuts every section to the current-density limit and adds back only what the 4 % imbalance limit needs. Allowing 6 % imbalance saves 28 g more; raising the current-density limit to 15 A/mm² saves almost nothing, because the imbalance limit is what binds.
- Path balancing reaches 0 % imbalance but adds +12.4 W against the widened design and needs extra parts.
- Every single-plane design is 16.2–17.5 mm lower than v7 and uses 12 welds instead of 24.

## Circulating currents from the imbalances

Both imbalances can be read as an extra current that flows round a loop on top of the useful current. Values below are at the line current used throughout, 360 A rms (phase current 207.8 A rms in the delta); “peak” is the instantaneous peak (× √2). Everything here is linear in current: at k × this current, multiply by k (the extra-loss percentages stay the same).

### 1 · Path imbalance → current circulating between the two parallel paths of a phase

With two paths per phase, I₁ = I(1 + p/2) and I₂ = I(1 − p/2), each I = Iphase/2. The part that only goes round the loop formed by the two paths is (I₁ − I₂)/2 = p · Iphase/4. The hotter path's two coils carry p/2 more current and so dissipate about p more copper loss; the whole winding's extra loss is only (p/2)².

path imbalance p | circulating A rms | circulating A peak | hotter path current | hotter path coil loss | whole-winding loss
0.5 % | 0.26 | 0.37 | +0.25 % | +0.5 % | +0.001 %
1 % | 0.52 | 0.73 | +0.50 % | +1.0 % | +0.003 %
2 % | 1.04 | 1.47 | +1.00 % | +2.0 % | +0.010 %
3 % | 1.56 | 2.20 | +1.50 % | +3.0 % | +0.022 %
4 % | 2.08 | 2.94 | +2.00 % | +4.0 % | +0.040 %
5 % | 2.60 | 3.67 | +2.50 % | +5.1 % | +0.063 %
6 % | 3.12 | 4.41 | +3.00 % | +6.1 % | +0.090 %
8 % | 4.16 | 5.88 | +4.00 % | +8.2 % | +0.160 %
10 % | 5.20 | 7.35 | +5.00 % | +10.3 % | +0.250 %

### 2 · Line-to-line (delta) imbalance → current circulating round the delta

If the three phase branches differ in resistance, an inverter that imposes balanced line currents still drives a common current round the closed delta (zero sequence). For a branch spread ε, I₀ ≈ ε · Iphase/√3, and the line-to-line resistance imbalance shown on the page is about ε. Its loss, 3 R I₀², is negligible. This estimate is an upper bound: part of the line-to-line imbalance sits in the rings and terminals (outside the delta), which drives no circulating current.

line-to-line imbalance | delta circulating A rms | A peak | whole-winding loss
0.25 % | 0.30 | 0.42 | +0.0002 %
0.5 % | 0.60 | 0.85 | +0.0008 %
1 % | 1.20 | 1.70 | +0.0033 %
1.5 % | 1.80 | 2.55 | +0.0075 %
2 % | 2.40 | 3.39 | +0.0133 %
3 % | 3.60 | 5.09 | +0.0300 %
5 % | 6.00 | 8.49 | +0.0833 %

### 3 · The designs in this report (exact, from each design's circuit)

Solved from the exported circuit with all three phases running: the path value is the largest (I₁ − I₂)/2 over the three phases (phasors), the delta value is the zero-sequence current (IR + IY + IB)/3 round the delta. The balancing design shows a small path value although its imbalance is 0 %: the two paths then carry equal magnitudes but slightly different phase angles, because the shared rings also carry the neighbouring phase's current.

design | path imb % | path circ A rms | A peak | LL imb % | delta circ A rms | A peak
Page default (earlier balanced optimum) | 3.69 | 1.94 | 2.74 | 0.63 | 0.92 | 1.30
Goal: Balanced | 2.78 | 1.47 | 2.08 | 0.55 | 0.98 | 1.39
Goal: Lowest loss | 2.51 | 1.31 | 1.86 | 0.41 | 0.82 | 1.16
Goal: Lowest height | 3.03 | 1.58 | 2.24 | 0.46 | 1.03 | 1.45
Goal: Least copper | 3.81 | 2.01 | 2.84 | 0.86 | 1.37 | 1.94
Goal: Lowest imbalance | 2.51 | 1.33 | 1.89 | 0.50 | 0.87 | 1.22
Goal: Terminals closest | 2.60 | 1.36 | 1.92 | 0.51 | 0.90 | 1.27
Lowest imbalance, terminals within 60° | 2.02 | 1.05 | 1.49 | 0.32 | 0.55 | 0.78
Lowest imbalance, terminals within 90° | 1.53 | 0.85 | 1.21 | 0.63 | 0.32 | 0.45
Least copper, current density ≤ 15 A/mm² | 3.96 | 2.08 | 2.94 | 0.81 | 1.47 | 2.09
Least copper, path imbalance ≤ 6 % | 5.21 | 2.74 | 3.88 | 0.72 | 1.53 | 2.16
Lowest imbalance with path balancing (extra resistance) allowed | 0.00 | 0.34 | 0.48 | 0.39 | 0.94 | 1.32

### How much is acceptable?

- The cost of path imbalance is heat in the hotter path's two coils: about p % more copper loss there, so roughly p % more copper-loss temperature rise in those coils (e.g. 4 % → +4 %, i.e. +3.2 K on an 80 K copper-loss rise). Below about 2 % this is lost in the tolerance of the wire and the welds; 2–5 % is acceptable if the hot-spot margin covers +p %; above 5 % it starts to eat a real part of the thermal margin. This is an engineering guide, not a standard: use your own hot-spot margin.
- The current circulating round the delta is about 1 A here (under 0.5 % of the phase current) and its loss is below 0.01 %: line-to-line imbalance at these levels is a measurement/tolerance matter, not a thermal one. The 1.5 % rule on the page is the usual end-of-line acceptance check for winding resistance.
- These are DC (stall / low-speed) values, the worst case: at speed the coil inductance dominates the path impedance and the split evens out. Coils of identical geometry give no EMF-driven circulating current; unequal back-EMF (eccentricity, magnet tolerance) would add a separate circulating current that this resistive model does not include.

## How these results were checked

### How the checking was done

Four independent checks ran in parallel on the exported results, each by a separate agent that did not share the page's code: (1) a mathematical re-solve of every design's circuit in Python/numpy, (2) a cross-case consistency check of every number and rule, with a written reason why each winner is the optimum, (3) a local-optimality test that nudged every input of every winner one and two grid steps in the real page, and (4) a visual check of all 38 pictures against the data. A fifth agent reviewed the page's code for bugs. Every bug they confirmed was fixed, the cases were re-run, and the checks were repeated on the final results.

### 1 · Mathematics (independent re-solve)

An agent wrote its own nodal solver in Python/numpy and re-solved every design's exported circuit (the exact branches and resistances the page used), with all three phases at 360 A. Result: 0 discrepancies in all 12 designs, largest differences ≈ 10⁻⁹ to 10⁻¹¹. It reproduced every path current and path imbalance per phase, all three line-to-line resistances, every loss, each part's current and current density (J = I/A), and J max. Kirchhoff's current law holds at every node, the two coils of each series pair carry identical current, and the numbers stored by the optimiser equal the numbers measured after loading each design.

### 2 · Consistency and why each design is optimal

A second agent checked every design against every rule and against the other designs. All 12 designs are feasible (the only failing rules are the two coil-bend rules, which belong to the coil CAD). Each goal's winner has the best score for its goal among all designs that satisfy that case's rules, and every relaxation moves the right way: terminals within 60° and 90° lower the imbalance, a 15 A/mm² limit and a 6 % imbalance limit lower the copper. Masses, losses, imbalances and J are internally consistent (every part loss = I²R, every mass = length × width × thickness × density). Its written reasons are in each design's “Why this is the optimum” box.

### 3 · Local optimality (every input nudged ±1 and ±2 grid steps in the page)

A third agent took each winner into the real page and tried 44–48 neighbours: every input ±1 and ±2 grid steps, every terminal order, every ring arrangement and every cross-section mode. In the final run 8 of 11 winners are strict local optima; the other three (balanced, least copper, J ≤ 15) can be improved by at most 0.05 % by a half-step move. The binding constraints are the same everywhere: any thicker or wider copper hits the in-plane gap and the radial limits, and the terminals are boxed by the lug pitch, the span limit and “terminal on its own ring”. Earlier rounds of this test found that the optimiser was not fully converged (up to 1.7 % left on the table) and that the 60°/90° cases could land in a worse region; both were fixed (final polish stage; earlier winners fed back as seeds).

### 4 · Pictures checked against the data

A fourth agent looked at all 38 pictures and compared them with the data: the cross-section style claimed (uniform / at the J limit / widened), the largest current-density label against J max and the limit, sampled area labels against each part's area (widened parts show “normal – widened” and the widened value equals t × widened width), and the terminal positions against the span. All checks pass. It found and we fixed: a wrong “widened” label on the 6 % design (nothing was widened there), area labels that hid the widening, and balancing labels overlapping terminal labels (now on the plan only; 3D shows red markers).

### Bugs found during this check and fixed

- Optimiser ignored your operating conditions (line current, temperature, joint resistances): every candidate was solved at the defaults, and loading a result overwrote your settings. Now it always uses the settings on screen.
- Least-copper sizing leaked between designs: loading one design after another kept the previous design's sizing density (a design shown as 148 g came out as 180 g). Fixed; the “Optimised default” button also resets the section mode.
- Custom weights: the goal table kept the scores from the run; it now recomputes every goal score when weights change.
- Feasibility verdicts disagreed between the top strip, Checks, Results and Optimize tabs (different rule sets). All now use one verdict: every busbar rule plus the Geometry-tab limits.
- Weld pads under-modelled when spokes are narrowed (4 mm instead of 5 mm), which overstated clearances by 0.5 mm; the weld-to-weld rule had the same 4 mm assumption. Both now use the real pad width.
- Widened segments drawn with rounded ends in the clearance check, which reported false 2.3 mm gaps; they are now square steps, as stamped.
- Optimiser not fully converged: winners could still be improved by 0.01–1.7 % by another section mode or a small step. A final polish stage now tries every section mode and then steps every input until nothing improves, and earlier winners are fed back in so a relaxed rule never gives a worse result.
- Terminal gaps capped at 25°, so “terminals within” above 50° had no effect; terminal blade fixed at 10 × 3 mm, so no current-density limit below 12 A/mm² was feasible; joint resistance 0 µΩ gave NaN; the balancing switch turned itself on during re-runs; labels overlapped (balancing values, widened areas). All fixed.

### Known limits of the model

- DC/low-frequency resistive model: at speed the coil inductance dominates and evens out the path split, so the path imbalance shown is the stall (worst) case.
- The two coil-bend rules (corner bends 26.8 %, layer-change step 35.1 % against ≤ 25 %) fail in every design: they are properties of the coil CAD, not the busbar.
- Path balancing resistances are modelled as extra jumper wire; the routing room for that wire is not checked.
- Widened segments are modelled as square steps; current crowding at the steps is not modelled (it slightly raises local J at the step corners).
- The terminal blade (≥ 30 mm²) carries the full line current, so the current-density rule is set by the terminals (12.0 A/mm²) in every design.
