mishravipul361-blip/Ferrite-motor-design/femm_em/report/v7_motor_report.html

Electromagnetic design report · FEMM 4.2 · 2D magnetostatic

# v7 Motor EM Report

12-slot / 10-pole spoke-ferrite PMSM for an EV two-wheeler, 52 V battery, delta winding. Model calibrated to the Motor-CAD peak torque of 45 N·m. All figures below come from the FEMM solutions in femm_em/.

Report date 2026-10-09Stack 65 mmRated 360 A rms lineBattery 52 V, 11 kW DC limit

## Summary

key results, calibrated model

Peak torque @ 360 A rms45.0N·mcurrent angle 23.2°

Base speed (11 kW DC limit)2200rpm3300 rpm without the DC limit

Max shaft power10.5kWheld to 12 000 rpm (battery-limited)

Peak motor efficiency97.0%at 5250 rpm, 16 N·m

Back-EMF, line-line7.80V rms/krpmψm 0.0211 Wb-turn per path

Magnet demag at rated-664kA/mHcJ −340; 0.2 % of magnet area past HcJ

- The motor makes 45.0 N·m at 360 A rms with a torque ripple of 5.0 % and cogging of only 0.075 N·m peak-to-peak.
- On the 52 V battery the 11 kW DC limit, not the motor, sets the speed range: full torque to about 2200 rpm, then about 10.5 kW at the shaft up to 12 000 rpm.
- Saliency Lq/Ld ≈ 1.22 gives useful reluctance torque, so the best current angle is 23.2° rather than 0°.
- Action needed: at rated current the field at the magnet tips beside the slot opening passes the ferrite HcJ (local irreversible demagnetisation). See Demagnetisation.

## Inputs and assumptions

what the model was built from

Geometry and winding
Stator | 12 segmented teeth, exact v7 lamination profile (cad/ folder), bore Ø107.0 mm, OD Ø160 mm
Rotor | 10-pole spoke, OD Ø106 mm, shaft Ø30 mm, magnet 28 mm radial, bridge 2 mm
Air gap | 0.50 mm
Stack length | 65 mm
Winding | Concentrated, delta, 2 parallel × 2 series per phase, 10 turns/coil, Ø2.90 mm wire
Rated current | 360 A rms line = 207.8 A rms phase = 103.9 A rms per coil
Phase resistance | 6.732 mΩ per coil (= per phase) at 100 °C

Materials and limits
Magnet | Sintered ferrite, Br 0.45 T @ 20 °C, −0.20 %/K, HcJ 340 kA/m
Laminations | M235-35A, 0.35 mm, typical B-H curve
Battery | 52 V, SVPWM, phase voltage limit 49.4 V peak (95 %)
DC power limit | 11 kW battery side, inverter efficiency 97 %
Copper loss | DC resistance at 100 °C
Iron loss | Steinmetz/Bertotti fit to M235-35A (2.35 W/kg @ 1.5 T 50 Hz, ≈17 W/kg @ 1 T 400 Hz) × 1.5 build factor; rotor +10 %
Mechanical loss | ≈14 W @ 3000 rpm, ≈80 W @ 12 000 rpm

Calibration to Motor-CAD (motor_config.json) | Setting | Effect on peak torque
Magnet temperature (Br 0.436 T) | 35 °C | −0.18 %/°C
Stacking factor | 0.95 | -0.7 % (0.97 → 0.95)
Magnet recoil permeability μr | 1.10 | -1.3 % (1.05 → 1.10)
Result | 45.0 N·m | uncalibrated 47.1 N·m · Motor-CAD 45 N·m

## Field maps

|B| with flux lines, rotor at 0°

Flux density map at no load

No load. Magnet flux only. Spoke magnets concentrate flux into the pole pieces.

Flux density map at rated current

Rated 360 A rms, γ 23.2°. Tooth-body |B| 1.61 T; only the tooth-tip corners and rotor bridges saturate (stator mean 0.98 T).

Flux density zoom at no load

One pole pair, no load. Rotor bridges (2 mm) run saturated, which is what limits magnet leakage.

Flux density zoom at rated current

One pole pair, rated. Armature reaction shifts flux to one side of each tooth.

## No-load performance

magnets only

Back-EMF at 1000 rpm per phase (= line-line in delta). Fundamental 7.80 V rms.

Cogging torque over one 6° cogging period: 0.075 N·m peak-to-peak (0.17 % of rated torque).

Air-gap radial flux density around the full machine, no load vs rated. Peak no-load 0.81 T.

## Rated-load performance

360 A rms

Torque vs current angle. Maximum at γ = 23.2° (advance from the q-axis), reluctance torque from Lq > Ld.

Torque over one electrical period at the best angle: mean 45.0 N·m, ripple 5.0 % peak-to-peak.

Torque vs line current at the rated current angle. Kt 0.125 N·m/A rms; saturation bends the curve above ~300 A.

Rated operating point
Average torque | 45.0 N·m
Torque ripple | 5.0 %
Torque, magnets at 80 °C | 41.2 N·m
Stator tooth / yoke |B| (sample points) | 1.61 / 1.50 T
Copper loss (100 °C) | 872 W
Current density in wire | 15.8 A/mm² rms

## Flux linkage and inductances

d-q map, 25 current points × 3 rotor positions

ψd vs id (per parallel path, peak). Slope = Ld; ψd crosses zero near id ≈ −96 A: the magnet flux can be fully cancelled.

ψq vs iq. Lq falls with load as the q-axis path saturates.

Quantity | Per parallel path | Per delta phase
Magnet flux linkage ψm | 0.0211 Wb-turn | —
Ld, light load | 219 µH | 110 µH
Lq, light load | 307 µH | 154 µH
Ld, near rated | 187 µH | 94 µH
Lq, near rated | 229 µH | 114 µH
Characteristic current ψm/Ld | 96 A peak | 236 A rms line

## Torque–speed capability

52 V battery, winding at 100 °C

Maximum shaft torque vs speed. Solid: 360 A rms with the 11 kW DC limit. Dashed: 180 A rms. Dotted: 360 A rms with no DC limit.

Shaft power vs speed, same three cases. The DC limit flattens power at ≈10.5 kW from 2200 rpm.

Line current along the 360 A + 11 kW envelope. Current drops once the battery limit takes over, so copper loss falls from 872 W.

rpm | Torque N·m | Shaft kW | DC kW | I A rms | Cu loss W

## Efficiency and loss maps

minimum-loss current at every point inside the envelope

Motor efficiencySystem efficiency Total lossCopper lossIron loss Line currentPower factorBattery power

Motor efficiency. Peak 97.0 % at 5250 rpm, 16 N·m. The heavy line is the operating boundary including all losses and the 11 kW DC limit.

Iron loss is an estimate from the no-load flux distribution scaled with the operating flux and a typical M235-35A loss curve. Treat efficiency above ~6000 rpm as ±1–2 %. AC copper (proximity) loss in the Ø2.9 mm wire is not included and will lower high-speed efficiency.

## Magnet demagnetisation check

H along the magnetisation direction

Demagnetising field in the magnets at rated current

Rated current, rotor 0°. Red = demagnetising field. The outer corners beside the slot opening go furthest negative.

Case | Most negative H (kA/m) | vs HcJ −340
No load | -179 | OK
Rated, γ 23.2° | -664 | past HcJ
Rated, pure −d (γ 90°) | -495 | past HcJ
Magnet area past HcJ (rated) | 0.2 %
Magnet area past 80 % of HcJ | 0.8 %

Local irreversible demagnetisation is predicted at the magnet tips at rated current. Ferrite HcJ also falls in the cold (≈ −0.2 to −0.3 %/K), so a cold start at full current is the worst case. Options: a higher-HcJ ferrite grade, thicker pole-piece lips over the magnet top, a smaller magnet opening, or a lower peak current.

## Verification data

every material value and adjustable setting, for checking in Motor-CAD

All values below are the ones FEMM used for this report. The last column of the settings table says where each one lives, so a change can be made and the report rebuilt.

Magnet: sintered ferrite
Remanence Br at 20 °C | 0.450 T
Br temperature coefficient | -0.20 %/K
Magnet temperature (calibrated) | 35 °C
Br used | 0.4365 T
Recoil permeability μr | 1.10
Coercivity HcB = Br/(μ0·μr) | 316 kA/m
Intrinsic coercivity HcJ (demag check) | 340 kA/m
Br at 80 °C (hot case) | 0.396 T
Magnetisation | tangential, alternating
Electrical conductivity | 0 (no eddy loss)
Density (mass only) | 4.9 g/cm³
Model | linear recoil line

Lamination steel: M235-35A
Thickness | 0.35 mm
Stacking factor | 0.95
Density | 7650 kg/m³
Initial relative permeability | ≈ 12 000
B at 2500 / 5000 A/m | 1.53 / 1.63 T
Loss, catalogue | 2.35 W/kg @ 1.5 T 50 Hz; ≈17 W/kg @ 1 T 400 Hz
Hysteresis coefficient kh | 0.0177 W/(kg·Hz·T²)
Eddy coefficient ke | 6.20e-05 W/(kg·Hz²·T²)
Iron-loss build factor | 1.5
Rotor iron loss | +10 % of stator
Stator lamination mass | 3.37 kg
Same steel in rotor and stator | yes

M235-35A B-H curve used by FEMM (DC magnetisation, solid steel; FEMM applies the 0.95 stacking factor). Compare with the Motor-CAD library curve.

H (A/m) | B (T) | μr
0 | 0.00 | —
50 | 0.75 | 11937
100 | 1.00 | 7958
150 | 1.12 | 5942
200 | 1.20 | 4775
300 | 1.29 | 3422
500 | 1.38 | 2196
1000 | 1.45 | 1154
2500 | 1.53 | 487
5000 | 1.63 | 259
10000 | 1.75 | 139
20000 | 1.87 | 74
50000 | 2.02 | 32
100000 | 2.13 | 17
200000 | 2.30 | 9

Winding resistance (DC) | 20 °C | 100 °C | 150 °C | 180 °C
Per coil = per phase (2 series × 2 parallel) | 5.122 mΩ | 6.732 mΩ | 7.739 mΩ | 8.343 mΩ
Line-line (delta: R·2R/3R) | 3.415 mΩ | 4.488 mΩ | 5.159 mΩ | 5.562 mΩ
Per parallel path (2 coils) | 10.244 mΩ | 13.465 mΩ | 15.478 mΩ | 16.685 mΩ
Copper loss at 360 A rms | 664 W | 873 W | 1003 W | 1081 W

Copper and winding data
Wire | Ø2.90 mm bare, 6.605 mm² copper
Resistivity at 20 °C | 1.724e-8 Ω·m
Temperature coefficient | 0.00393 /K
Coil length, lead tip to lead tip | 1962.4 mm (CAD)
Turns per coil / conductors per slot | 10 / 20
Current density at 360 A rms | 15.73 A/mm² rms
Copper mass (12 coils) | ≈1.39 kg
Temperature used for losses and voltage | 100 °C
Busbar loss (not in maps) | ≈33 W at 100 °C (RESISTANCE_v7.txt)
AC / proximity loss | not included

Adjustable setting | Value used | Effect | Where to change
Magnet temperature | 35 °C | −0.18 % torque per °C | motor_config.json: magnet_temp_C
Stacking factor | 0.95 | 0.97→0.95: −0.7 % torque | motor_config.json: stacking
Magnet μr | 1.10 | 1.05→1.10: −1.3 % torque | motor_config.json: mu_mag
Br at 20 °C, temp. coeff., HcJ | 0.45 T, -0.20 %/K, 340 kA/m | torque ∝ ~Br; demag margin | femm_motor.py: BR20, BR_TC, HCJ
Steel B-H curve | M235-35A typical | saturation, peak torque | femm_motor.py: BH
Rotor geometry | see Inputs | everything | femm_motor.py: ROTOR
Stack length | 65 mm | torque, EMF ∝ length | femm_motor.py: STACK
Rated current | 360 A rms line | torque, demag | femm_motor.py: I_LINE_RMS
Coil resistance | 6.732 mΩ @100 °C | copper loss, voltage | femm_motor.py: R_COIL
DC bus voltage | 52 V | base speed | femm_motor.py: VDC
Voltage utilisation | 95 % | base speed | dq_study.py: V_MAX
Battery DC power limit | 11 kW | power above base speed | dq_study.py: P_DC_MAX
Inverter efficiency | 97 % | DC power, system efficiency | dq_study.py: ETA_INV
Iron-loss coefficients / build factor | kh 0.0177, ke 6.2e-05, ×1.5 | efficiency map | eff_map.py: KH, KE, BUILD
Mechanical loss | 4e-03·n + 2.2e-07·n² W | efficiency at speed | eff_map.py: MECH_A, MECH_B
Solver mesh sizes | gap 0.25, rotor 1.0, stator 1.5 mm | accuracy vs time | femm_motor.py: build()

## Limitations

what a 2D magnetostatic model leaves out

- End-winding leakage inductance (end turns ≈ ⅓ of the wire length) is not in Ld/Lq: real base speed will be a few hundred rpm lower.
- 3D end effects of the ferrite spoke rotor (axial leakage) typically cost 5–15 % torque. The calibration to Motor-CAD absorbs part of this only if Motor-CAD included it.
- Iron loss is estimated, not solved per element over time; AC copper and magnet eddy losses are omitted.
- Thermal: 360 A rms is ≈15.8 A/mm² in the wire, a short-time rating. Continuous capability needs a thermal model.
- Mechanical: rotor bridge stress at 12 000 rpm is not checked.

## Files

C:\Users\vibhe\Downloads\OUTPUT\OUTPUT\femm_em\

File | Contents
README.md | How to rerun everything, inputs, run order
motor_config.json | Calibration knobs (magnet temperature, stacking, μr)
femm_motor.py → results.json, summary.txt | No-load, cogging, current angle, ripple, torque vs current, demag
dq_study.py → dq.json, dq_summary.txt | d-q flux map, inductances, torque–speed envelopes
eff_map.py → eff.json | Efficiency, loss, current, power-factor maps
field_maps.py → field_*.fem/.ans | Field pictures; open the .ans files in FEMM
build_report.py | Rebuilds this report from the result files
