mishravipul361-blip/Ferrite-motor-design/Design9795_1/mcad_lab/envelop_1.xlsx

Sheet: Speed
0
500
1000
1500
2000
2500
3000
3500
4000
4500
5000
5500
6000
6500
7000
7500
8000
8500
9000
9500

Sheet: Shaft_Torque
44.76344846
44.25300121
44.20218046
44.15613121
44.11233283
44.06988743
42.65959065
36.95416009
32.45213008
28.86618799
25.95518344
23.54797268
21.52456598
19.79957093
18.31087458
17.01233452
15.87223427
14.87365823
13.98245251
13.18193804

Sheet: Shaft_Power
0
2317.081725
4628.841513
6936.028871
9238.865384
11537.46955
13401.90566
13544.40708
13593.51646
13602.87062
13590.10227
13562.65863
13524.28367
13477.14042
13422.57211
13361.45629
13297.09189
13239.3097
13178.15103
13113.88858

Sheet: Efficiency
0
71.9399751
83.02266639
87.38755189
89.64602091
90.97555279
92.04605535
93.02477392
93.36206363
93.4263092
93.33861448
93.15012793
92.88656365
92.56277764
92.18799527
91.76824372
91.32618055
90.92932489
90.50927904
90.06791606

Sheet: Efficiency_Motor
0
71.9399751
83.02266639
87.38755189
89.64602091
90.97555279
92.04605535
93.02477392
93.36206363
93.4263092
93.33861448
93.15012793
92.88656365
92.56277764
92.18799527
91.76824372
91.32618055
90.92932489
90.50927904
90.06791606
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
