mishravipul361-blip/Ferrite-motor-design/Design9795_1/mcad_lab/Grid.xlsx

Sheet: Speed
0 | 500 | 1000 | 1500 | 2000 | 2500 | 0 | 0 | 0 | 0 | 0 | 0 | 0 | 0 | 0 | 0 | 0 | 0 | 0 | 0
0 | 500 | 1000 | 1500 | 2000 | 2500 | 3000 | 0 | 0 | 0 | 0 | 0 | 0 | 0 | 0 | 0 | 0 | 0 | 0 | 0
0 | 500 | 1000 | 1500 | 2000 | 2500 | 3000 | 0 | 0 | 0 | 0 | 0 | 0 | 0 | 0 | 0 | 0 | 0 | 0 | 0
0 | 500 | 1000 | 1500 | 2000 | 2500 | 3000 | 0 | 0 | 0 | 0 | 0 | 0 | 0 | 0 | 0 | 0 | 0 | 0 | 0
0 | 500 | 1000 | 1500 | 2000 | 2500 | 3000 | 3500 | 0 | 0 | 0 | 0 | 0 | 0 | 0 | 0 | 0 | 0 | 0 | 0
0 | 500 | 1000 | 1500 | 2000 | 2500 | 3000 | 3500 | 0 | 0 | 0 | 0 | 0 | 0 | 0 | 0 | 0 | 0 | 0 | 0
0 | 500 | 1000 | 1500 | 2000 | 2500 | 3000 | 3500 | 4000 | 0 | 0 | 0 | 0 | 0 | 0 | 0 | 0 | 0 | 0 | 0
0 | 500 | 1000 | 1500 | 2000 | 2500 | 3000 | 3500 | 4000 | 0 | 0 | 0 | 0 | 0 | 0 | 0 | 0 | 0 | 0 | 0
0 | 500 | 1000 | 1500 | 2000 | 2500 | 3000 | 3500 | 4000 | 4500 | 0 | 0 | 0 | 0 | 0 | 0 | 0 | 0 | 0 | 0
0 | 500 | 1000 | 1500 | 2000 | 2500 | 3000 | 3500 | 4000 | 4500 | 5000 | 0 | 0 | 0 | 0 | 0 | 0 | 0 | 0 | 0
0 | 500 | 1000 | 1500 | 2000 | 2500 | 3000 | 3500 | 4000 | 4500 | 5000 | 5500 | 0 | 0 | 0 | 0 | 0 | 0 | 0 | 0
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
