mishravipul361-blip/Ferrite-motor-design/Design9795_1/mcad_lab/M235-35A.xlsx

Sheet: BH
B | H
0 | 0
0.1 | 24.7
0.2 | 32.6
0.3 | 38.1
0.4 | 43.1
0.5 | 48.2
0.6 | 53.9
0.7 | 60.7
0.8 | 68.8
0.9 | 79.3
1 | 93.7
1.1 | 115
1.2 | 156
1.3 | 260
1.4 | 690
1.5 | 1950
1.6 | 4410
1.7 | 7630
1.8 | 12000

Sheet: Steel Loss
Frequency | Loss density | Flux Density
Hz | W/Kg | Tesla
50 | 0.02 | 0.1
50 | 0.06 | 0.2
50 | 0.11 | 0.3
50 | 0.2 | 0.4
50 | 0.29 | 0.5
50 | 0.38 | 0.6
50 | 0.5 | 0.7
50 | 0.62 | 0.8
50 | 0.77 | 0.9
50 | 0.92 | 1
50 | 1.1 | 1.1
50 | 1.31 | 1.2
50 | 1.56 | 1.3
50 | 1.92 | 1.4
50 | 2.25 | 1.5
50 | 2.53 | 1.6
50 | 2.75 | 1.7
50 | 2.94 | 1.8
100 | 0.04 | 0.1
100 | 0.14 | 0.2
100 | 0.3 | 0.3
100 | 0.49 | 0.4
100 | 0.71 | 0.5
100 | 0.97 | 0.6
100 | 1.25 | 0.7
100 | 1.57 | 0.8
100 | 1.92 | 0.9
100 | 2.31 | 1
100 | 2.75 | 1.1
100 | 3.26 | 1.2
100 | 3.88 | 1.3
100 | 4.67 | 1.4
100 | 5.54 | 1.5
200 | 0.08 | 0.1
200 | 0.32 | 0.2
200 | 0.73 | 0.3
200 | 1.21 | 0.4
200 | 1.78 | 0.5
200 | 2.44 | 0.6
200 | 3.19 | 0.7
200 | 4.03 | 0.8
200 | 4.97 | 0.9
200 | 6.01 | 1
200 | 7.19 | 1.1
200 | 8.54 | 1.2
200 | 10.1 | 1.3
200 | 12.2 | 1.4
200 | 14.4 | 1.5
400 | 0.19 | 0.1
400 | 0.87 | 0.2
400 | 1.88 | 0.3
400 | 3.17 | 0.4
400 | 4.73 | 0.5
400 | 6.56 | 0.6
400 | 8.67 | 0.7
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
