mishravipul361-blip/Ferrite-motor-design/Design9795_1/backemf.png

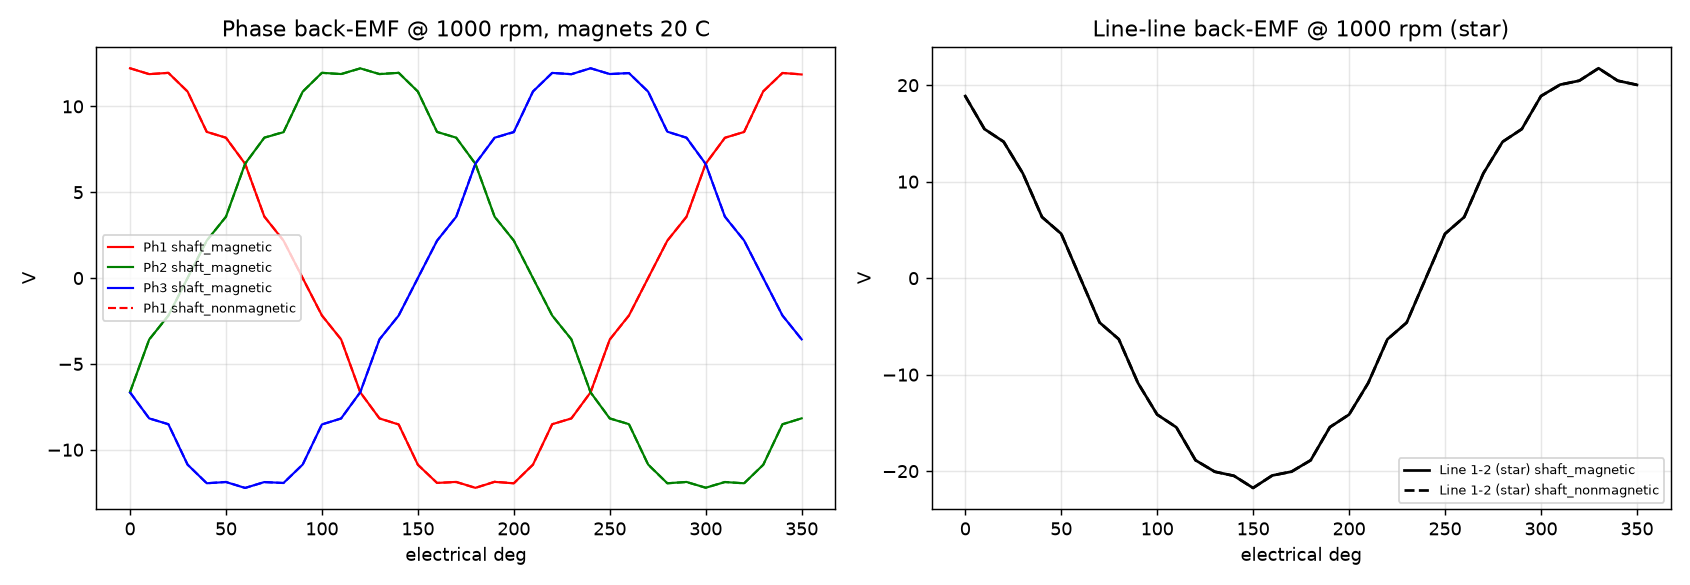
Design9795_1/backemf.png
