mishravipul361-blip/Ferrite-motor-design/Design9795_1/report_emf/emf.png

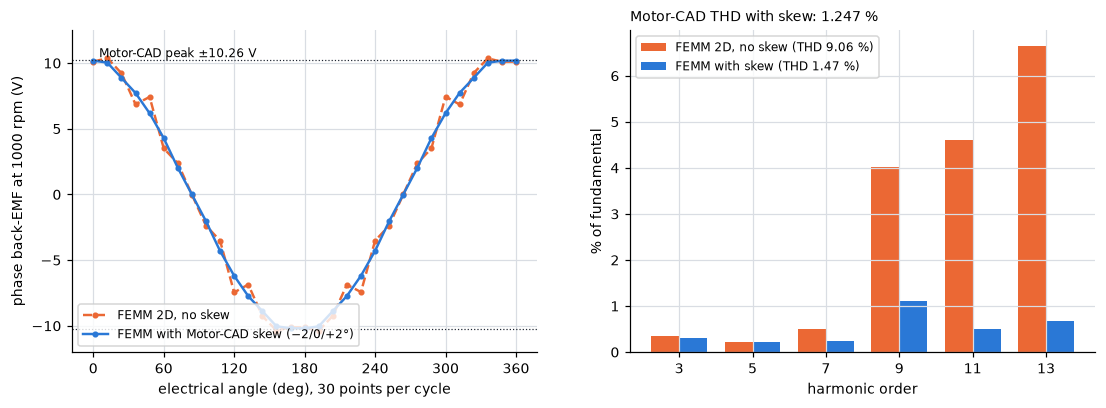
Design9795_1/report_emf/emf.png
