mishravipul361-blip/Ferrite-motor-design/femm_em/fig_B_noload.png

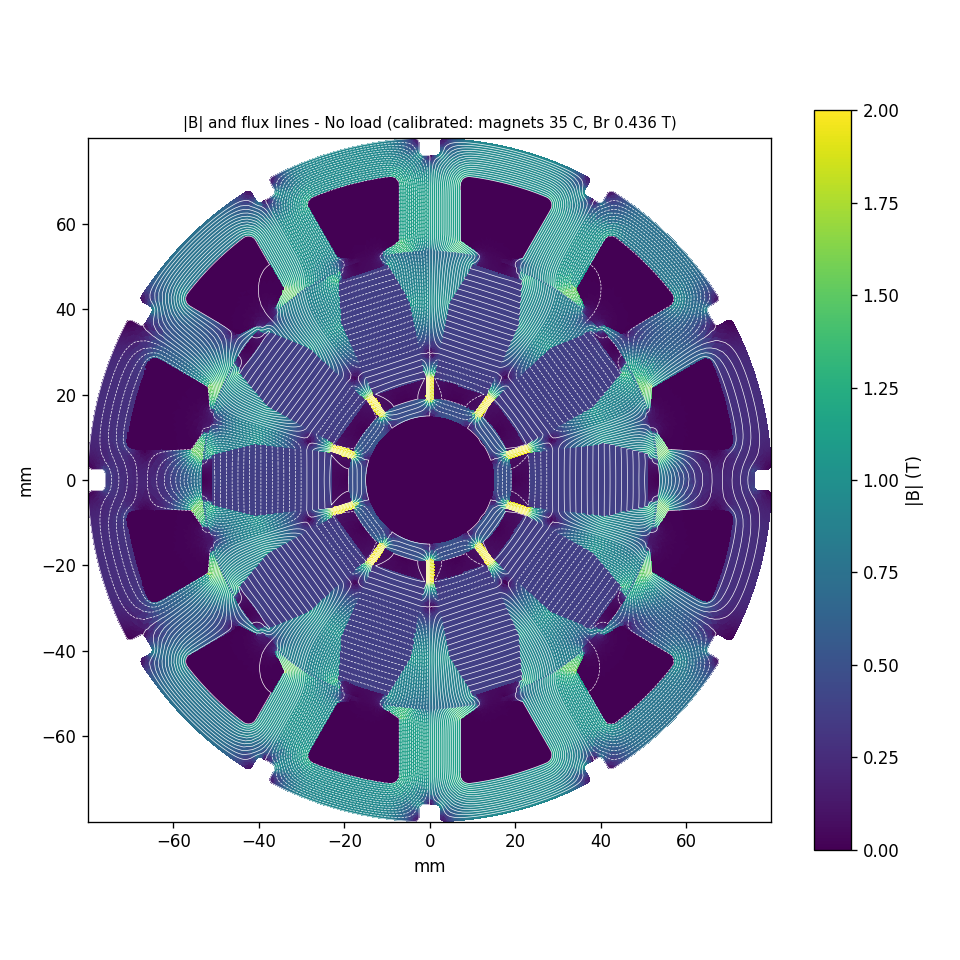
femm_em/fig_B_noload.png
