mishravipul361-blip/Ferrite-motor-design/femm_em/fig_B_rated_zoom.png

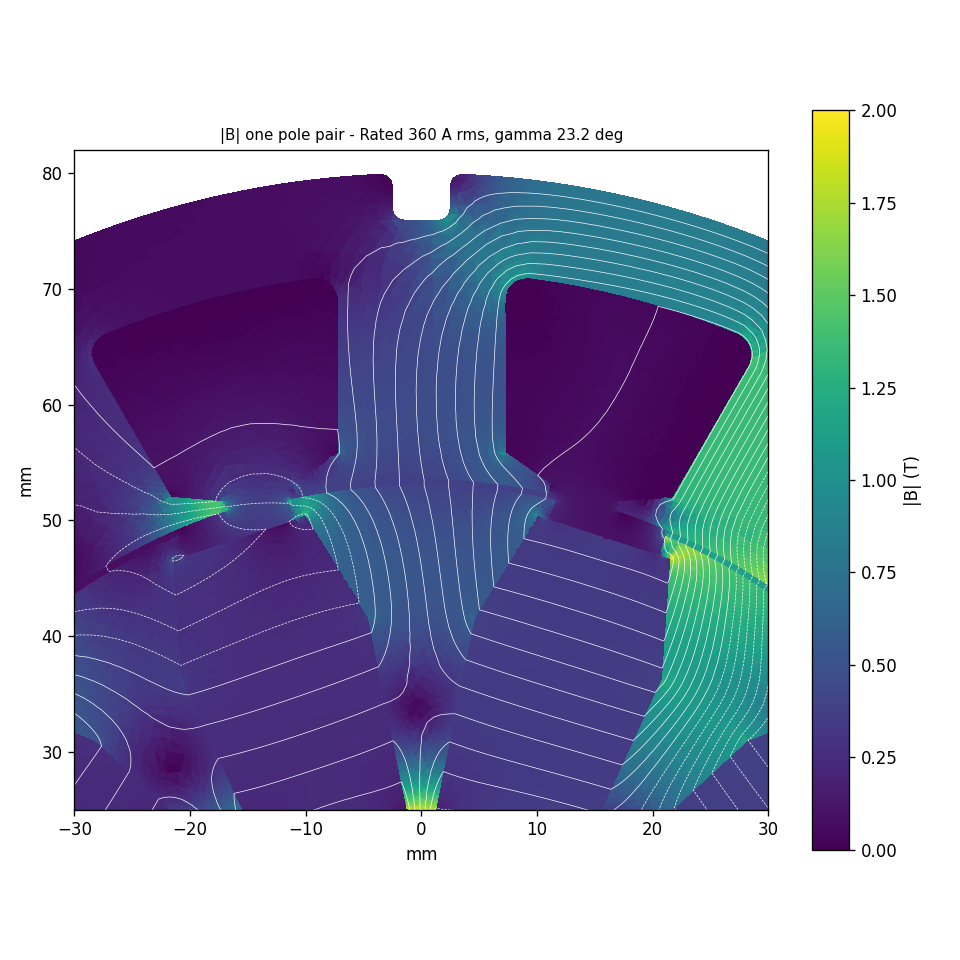
femm_em/fig_B_rated_zoom.png
