mishravipul361-blip/Ferrite-motor-design/femm_em/fig_demag.png

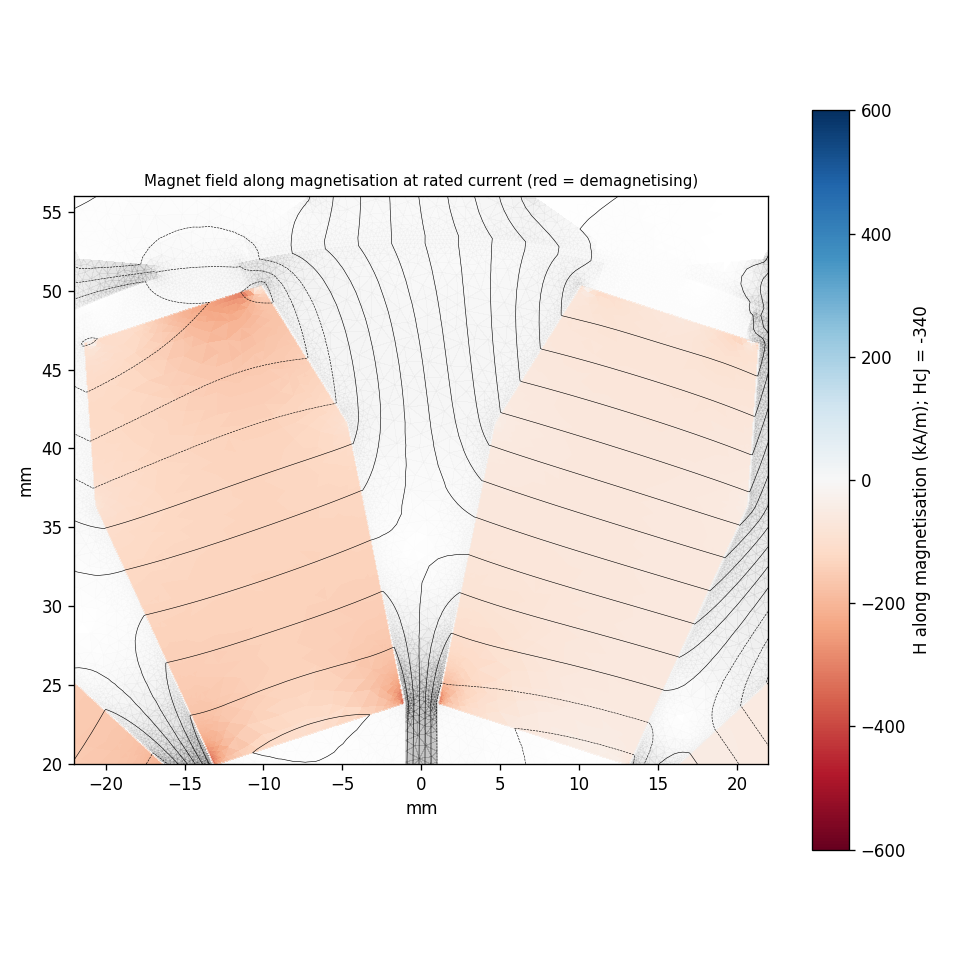
femm_em/fig_demag.png
