mishravipul361-blip/Ferrite-motor-design/femm_em/fig_eff.png

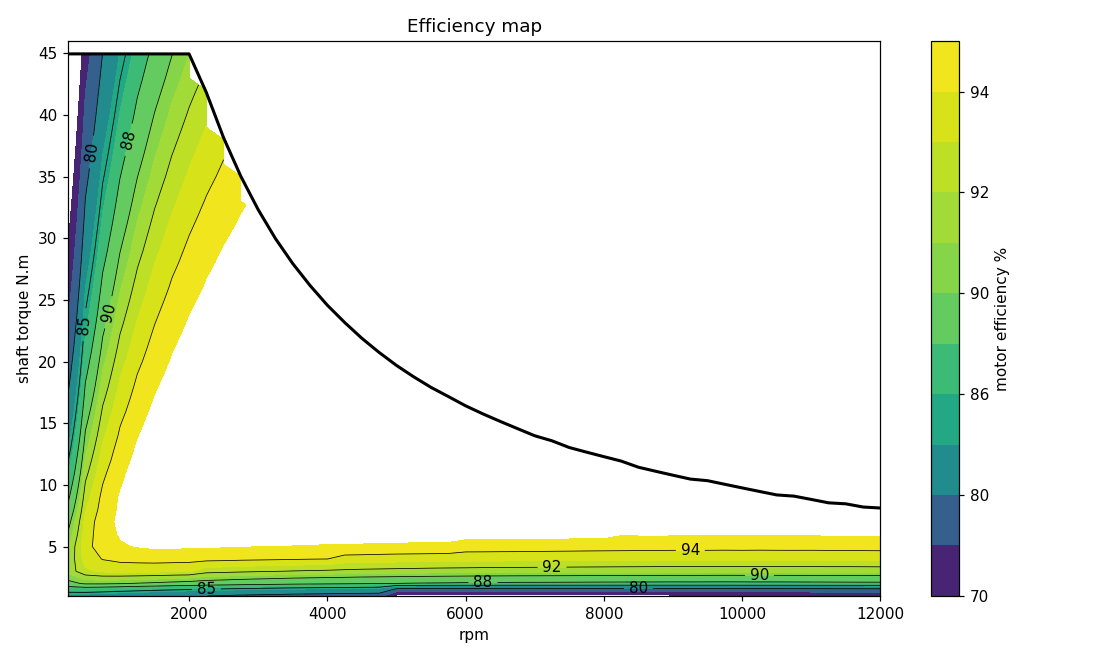
femm_em/fig_eff.png
