mishravipul361-blip/Ferrite-motor-design/Spoke_V2_backemf/backemf.png

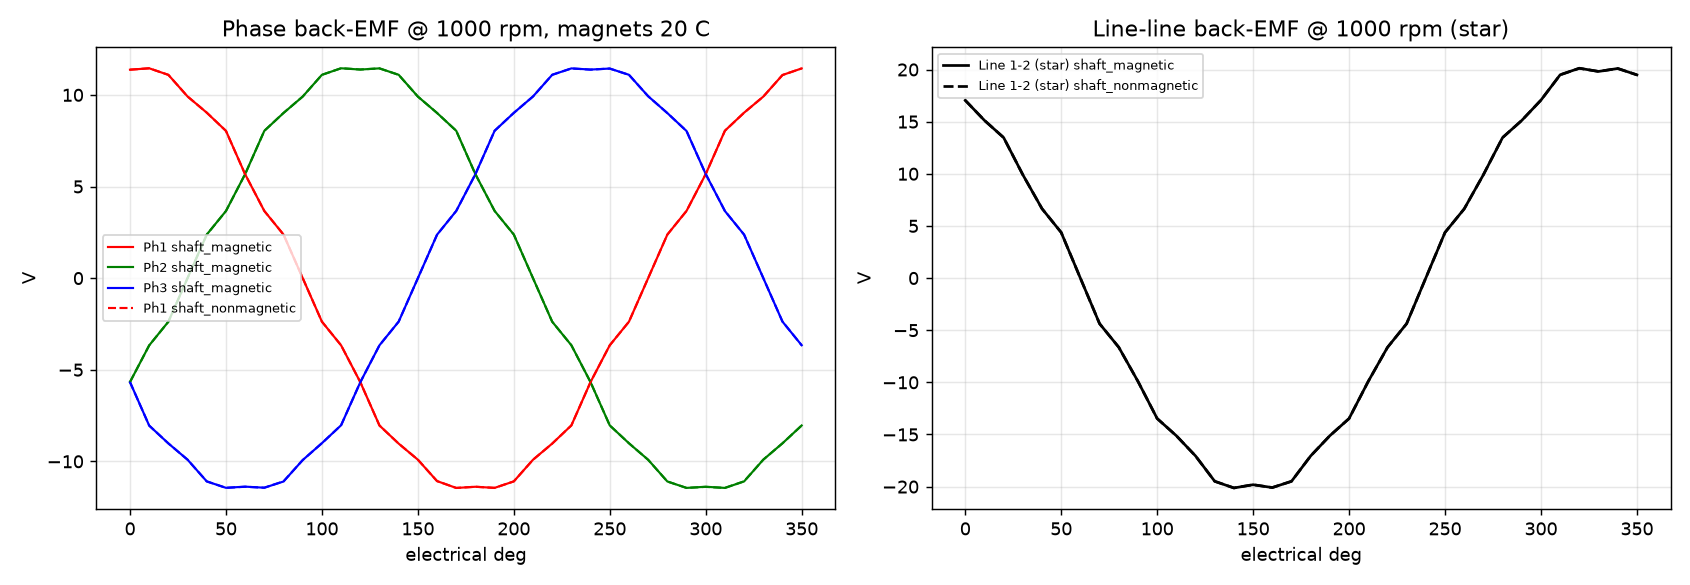
Spoke_V2_backemf/backemf.png
