mishravipul361-blip/Ferrite-motor-design/Spoke_V2_backemf/check_B.png

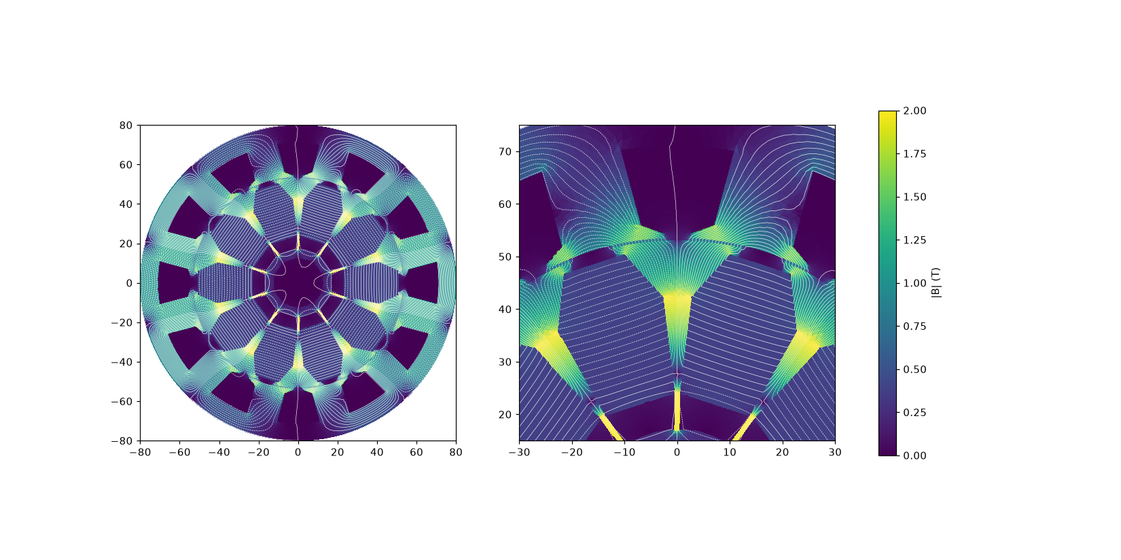
Spoke_V2_backemf/check_B.png
