mishravipul361-blip/Ferrite-motor-design/Spoke_V2_backemf/cmp_fine.png

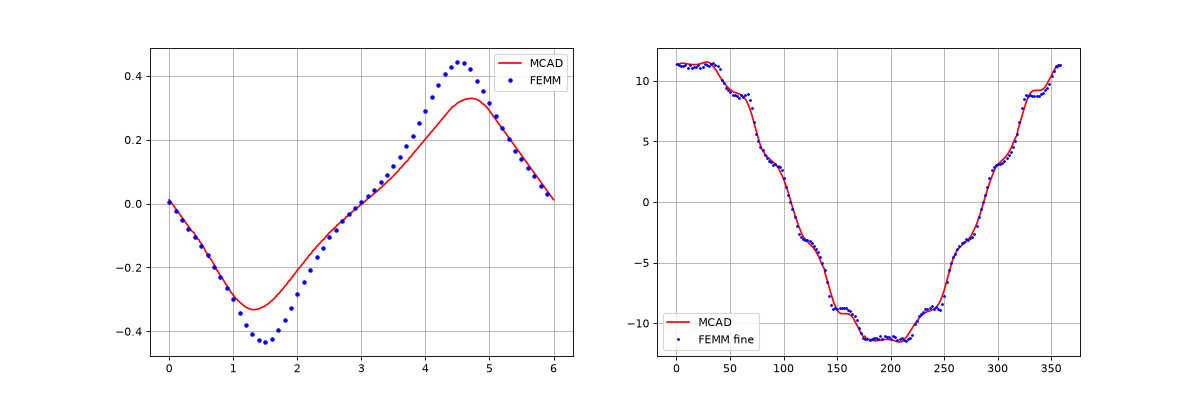
Spoke_V2_backemf/cmp_fine.png
