mishravipul361-blip/Ferrite-motor-design/Spoke_V2_backemf/cmp_probe.png

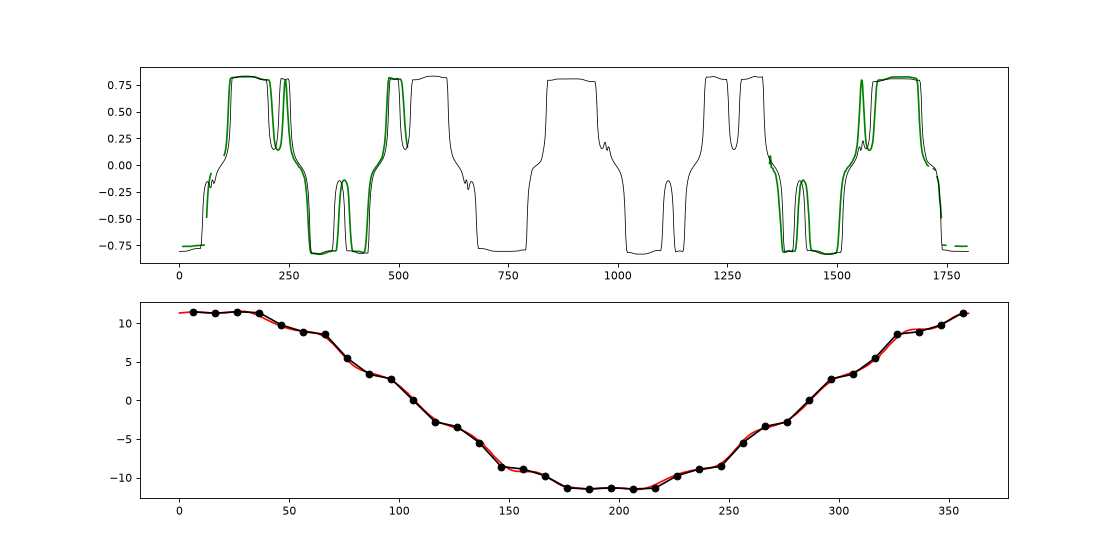
Spoke_V2_backemf/cmp_probe.png
