mishravipul361-blip/Ferrite-motor-design/Spoke_V2_backemf/fluxmap_full.png

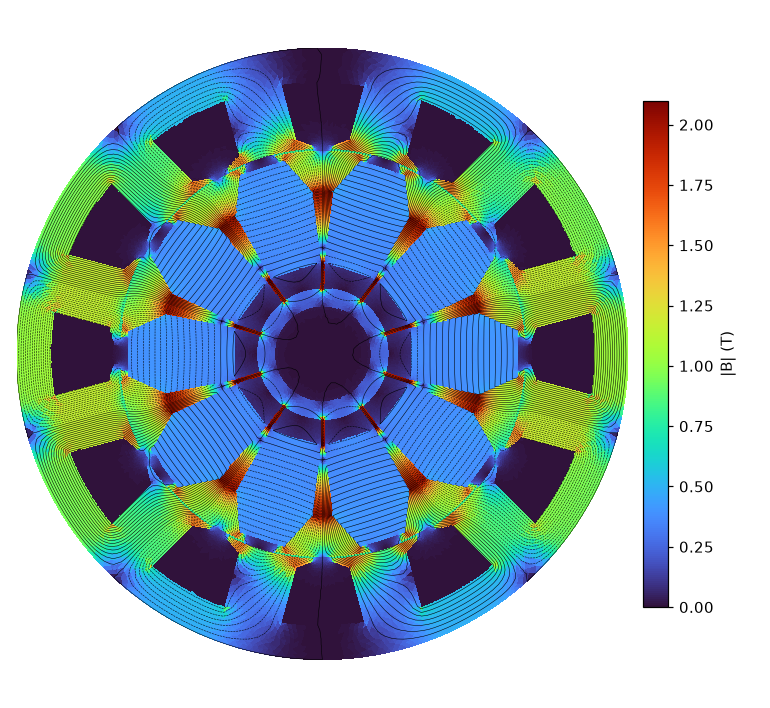
Spoke_V2_backemf/fluxmap_full.png
