mishravipul361-blip/Ferrite-motor-design/Spoke_V2_backemf/fluxmap_zoom.png

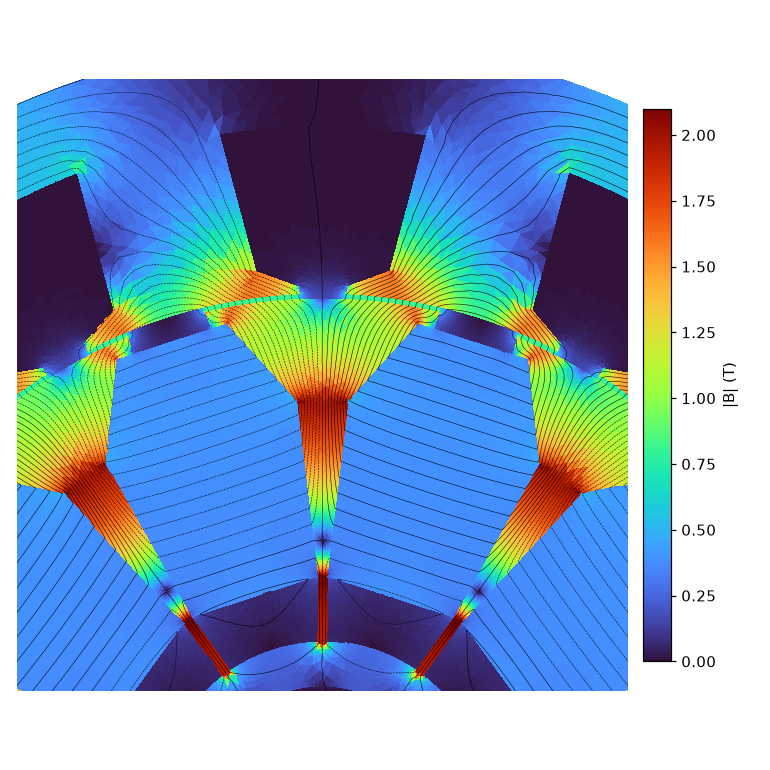
Spoke_V2_backemf/fluxmap_zoom.png
