mishravipul361-blip/Ferrite-motor-design/Spoke_V2_backemf/mcad/check_airgap.png

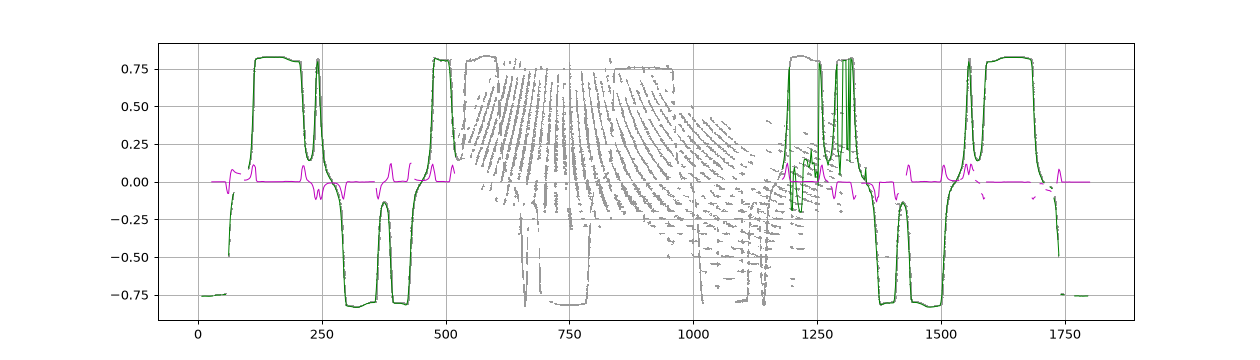
Spoke_V2_backemf/mcad/check_airgap.png
