mishravipul361-blip/Ferrite-motor-design/Spoke_V2_backemf/mcad/check_backemf.png

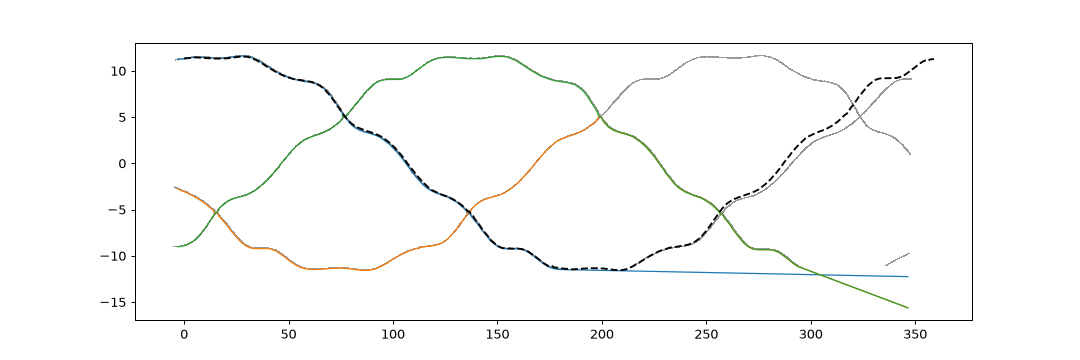
Spoke_V2_backemf/mcad/check_backemf.png
