mishravipul361-blip/Ferrite-motor-design/Spoke_V2_backemf/mcad/probe_dark.png

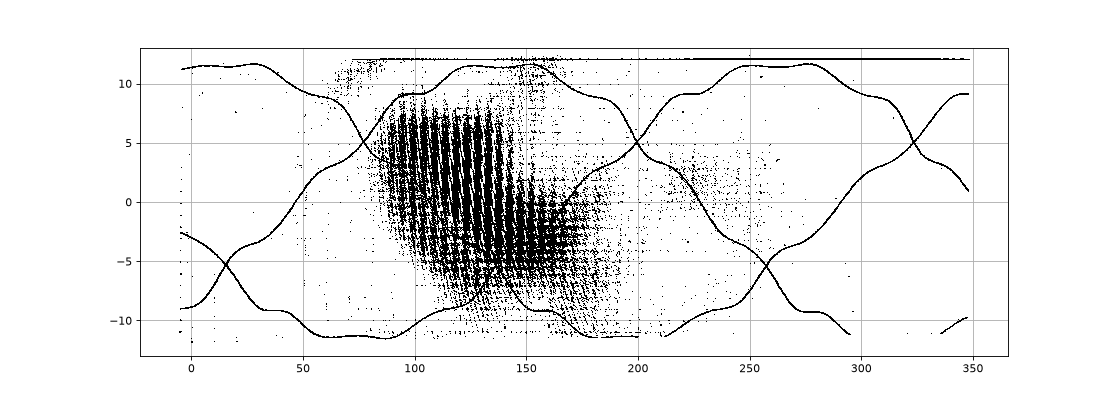
Spoke_V2_backemf/mcad/probe_dark.png
