mishravipul361-blip/Ferrite-motor-design/Spoke_V2_backemf/report_full/fig/op_losses.png

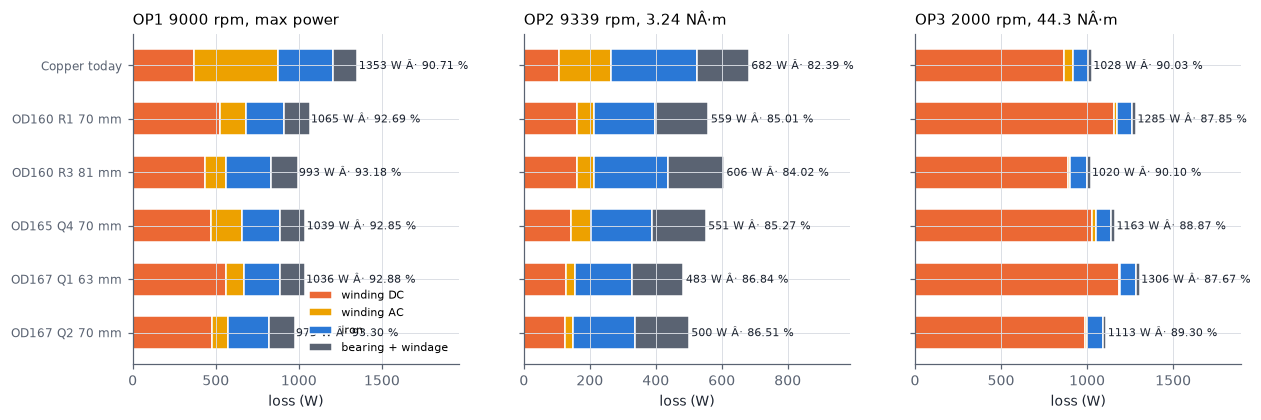
Spoke_V2_backemf/report_full/fig/op_losses.png
