mishravipul361-blip/Ferrite-motor-design/(list of files, cad)

Other CAD files:
cad/busbar/busbar_L3.stp
cad/SEGMENT_ttab_v7.stp
cad/busbar/link_Y_T4_T5.stp
cad/RING_dovetail_v7.stp
cad/03_bobbin_half_B_v7.stp
cad/busbar/busbar_L2.stp
cad/busbar/link_R_T7_T6.stp
cad/STATOR_v7.step
cad/busbar/busbar_L1.stp
cad/SEGMENT_butt_v7.stp
cad/busbar/busbar_carrier.stp
cad/RING_ttab_v7.stp
cad/02_bobbin_half_A_v7.stp
cad/busbar/link_R_T12_T1.stp
cad/busbar/link_B_T8_T9.stp
cad/RING_butt_v7.stp
cad/busbar/link_B_T3_T2.stp
cad/SEGMENT_v7.step
cad/01_tooth_segment_v7.stp
cad/busbar/link_Y_T11_T10.stp
cad/BUSBAR_v7.step
cad/SEGMENT_dovetail_v7.stp
cad/04_coil_3mm_v7.step
cad/01_tooth_segment_v7.SLDPRT
cad/02_bobbin_half_A_v7.SLDPRT
cad/03_bobbin_half_B_v7.SLDPRT
cad/04_coil_3mm_v7.SLDPRT
cad/BUSBAR_v7.SLDASM
cad/SEGMENT_v7.SLDASM
cad/STATOR_v7.SLDASM
cad/busbar/busbar_L1.SLDPRT
cad/busbar/busbar_L2.SLDPRT
cad/busbar/busbar_L3.SLDPRT
cad/busbar/busbar_carrier.SLDPRT
cad/busbar/link_B_T3_T2.SLDPRT
cad/busbar/link_B_T8_T9.SLDPRT
cad/busbar/link_R_T12_T1.SLDPRT
cad/busbar/link_R_T7_T6.SLDPRT
cad/busbar/link_Y_T11_T10.SLDPRT
cad/busbar/link_Y_T4_T5.SLDPRT
