mishravipul361-blip/Ferrite-motor-design/cad/VERIFICATION_v7.html

# Stator v7 — busbar verified against the wiring diagram

ALL CLEARANCES >= 0.10 mm, ALL 24 CONNECTIONS MATCH THE WIRING DIAGRAM (52s)

R phaseY phaseB phase L1 ringL2 ringL3 ring

## 1. The diagram, as built

- Coil groups and polarity: R = +1 +6 −7 −12, Y = −4 +5 +10 −11, B = +2 −3 −8 +9 (12 slots, 10 poles)
- Delta: L1 = R + B′, L2 = R′ + Y, L3 = Y′ + B — one copper ring per line terminal
- Each phase: 2 parallel paths × 2 coils in series; coil 104 A, phase 208 A, line 360 A
- All 12 coils are the same part; a coil's polarity is set only by which lead is fed. “+” = current enters at S (start), “−” = enters at F (finish).

## 2. Every parallel path traced through the busbar

Read left to right: line ring → coil lead → coil (polarity) → series link → coil (polarity) → coil lead → line ring. Both paths of a phase must give the same EMF (otherwise they short each other), and the three phases must close the delta (sum = 0).

phase | from | lead | coil | series link | coil | lead | to | path EMF | polarity
R | L1 | T12.F | −12 | T12.S-T1.S | +1 | T1.F | L2 | 1.932 ∠ +15° | OK
R | L1 | T7.F | −7 | T7.S-T6.S | +6 | T6.F | L2 | 1.932 ∠ +15° | OK
Y | L2 | T4.F | −4 | T4.S-T5.S | +5 | T5.F | L3 | 1.932 ∠ -105° | OK
Y | L2 | T11.F | −11 | T11.S-T10.S | +10 | T10.F | L3 | 1.932 ∠ -105° | OK
B | L3 | T3.F | −3 | T3.S-T2.S | +2 | T2.F | L1 | 1.932 ∠ +135° | OK
B | L3 | T8.F | −8 | T8.S-T9.S | +9 | T9.F | L1 | 1.932 ∠ +135° | OK

Delta EMF sum: 1.6e-15 (closed and balanced). Each path EMF 1.932 = two coils adding (a reversed coil would give 0.518).

## 3. Busbar layout

Four copper levels in the carrier, bottom to top: series links, L2, L3, L1. Every ring is 10 × 3 mm (30 mm²). Each coil lead has its own tab that stands up beside the lead to the weld plane (z 66.0); lead and tab end flush and are welded there. Terminals L1/L2/L3: vertical blades with Ø6.6 holes.

### Busbar, carrier hidden: every conductor a separate part

### Busbar top view

### One tooth: start lead (inner layer) steps out once then rises; finish lead rises straight from the slot

### Full stator

## 4. Every coil lead, measured on the 3D model

For each of the 24 lead tops: the nearest copper part found in the solids, its gap (the weld gap, 0.105 mm by design), the next-nearest part, and what the circuit requires.

lead | touches | gap mm | next nearest | mm | required
T1.S | link T12.S-T1.S | 0.105 | L2 | 8.9 | link T12.S-T1.S | OK
T1.F | L2 | 0.105 | L1 | 3.4 | L2 | OK
T2.S | link T3.S-T2.S | 0.105 | L1 | 8.9 | link T3.S-T2.S | OK
T2.F | L1 | 0.105 | link T3.S-T2.S | 6.1 | L1 | OK
T3.S | link T3.S-T2.S | 0.105 | L3 | 8.9 | link T3.S-T2.S | OK
T3.F | L3 | 0.105 | link T3.S-T2.S | 6.1 | L3 | OK
T4.S | link T4.S-T5.S | 0.105 | L2 | 8.9 | link T4.S-T5.S | OK
T4.F | L2 | 0.105 | link T4.S-T5.S | 6.1 | L2 | OK
T5.S | link T4.S-T5.S | 0.105 | L3 | 8.9 | link T4.S-T5.S | OK
T5.F | L3 | 0.105 | link T4.S-T5.S | 6.1 | L3 | OK
T6.S | link T7.S-T6.S | 0.105 | L2 | 8.9 | link T7.S-T6.S | OK
T6.F | L2 | 0.105 | link T7.S-T6.S | 6.1 | L2 | OK
T7.S | link T7.S-T6.S | 0.105 | L1 | 8.9 | link T7.S-T6.S | OK
T7.F | L1 | 0.105 | link T7.S-T6.S | 6.1 | L1 | OK
T8.S | link T8.S-T9.S | 0.105 | L3 | 8.9 | link T8.S-T9.S | OK
T8.F | L3 | 0.105 | L1 | 3.4 | L3 | OK
T9.S | link T8.S-T9.S | 0.105 | L1 | 8.9 | link T8.S-T9.S | OK
T9.F | L1 | 0.105 | link T8.S-T9.S | 6.1 | L1 | OK
T10.S | link T11.S-T10.S | 0.105 | L3 | 8.9 | link T11.S-T10.S | OK
T10.F | L3 | 0.105 | L1 | 3.4 | L3 | OK
T11.S | link T11.S-T10.S | 0.105 | L2 | 8.9 | link T11.S-T10.S | OK
T11.F | L2 | 0.105 | L1 | 3.4 | L2 | OK
T12.S | link T12.S-T1.S | 0.105 | L1 | 8.9 | link T12.S-T1.S | OK
T12.F | L1 | 0.105 | link T12.S-T1.S | 6.1 | L1 | OK

## 5. Current density (limit 18 A/mm²)

ring | segment | current A | J A/mm²
L1 | 166.5° → 226.5° | 104.0 | 3.47
L1 | 226.5° → 316.5° | 180.1 | 6.00
L1 | 316.5° → 5.5° | 275.2 | 9.17
L1 | 5.5° → 16.5° | 104.0 | 3.47
L2 | 286.5° → 346.5° | 104.0 | 3.47
L2 | 346.5° → 35.5° | 180.1 | 6.00
L2 | 35.5° → 76.5° | 180.1 | 6.00
L2 | 76.5° → 136.5° | 104.0 | 3.47
L3 | 46.5° → 65.5° | 104.0 | 3.47
L3 | 65.5° → 106.5° | 275.2 | 9.17
L3 | 106.5° → 196.5° | 180.1 | 6.00
L3 | 196.5° → 256.5° | 104.0 | 3.47

PEAK J ring 9.17 terminal blade 12.01 lead tab 11.56 A/mm2 (target 12, limit 18) OK

## 6. Clearances (rule: ≥ 0.10 mm everywhere)

pair | min gap mm
coil x lamination (own tooth) | 0.5034 | OK
coil x bobbin half A | 0.1104 | OK
coil x bobbin half B | 0.1099 | OK
coil x neighbour bobbin A | 6.6320 | OK
coil x neighbour bobbin B | 6.6344 | OK
coil x neighbour tooth | 2.9448 | OK
coil x neighbour coil (centrelines) | 0.4577 | OK
coil wire x itself (turn to turn) | 0.1017 | OK
bobbin x lamination (moulding fit) | 0.1500 | fit 0.15 by design
carrier x lamination (12 teeth) | 0.1050 | OK
carrier x 12 coils | 1.1654 | OK
busbar copper x lamination | 15.5000 | OK
busbar conductor to conductor (all 36 pairs) | 0.805 | OK
coil to any copper except its own two tabs | 2.4100 | OK

## 7. Wire gauge, insulation and slot fill

## Wire gauge, insulation and slot fill

Cut at mid-stack (z = 0), looking along the shaft: one slot with the two coils that share it (10 conductors each). Coil numbers are from the delivered CAD; the winding path and length are kept exactly as built for every gauge.

Wire Enamel show insulation show liner & separator

Temp | Coil = phase | Line-line | Winding loss | + busbar | Total

Coil, measured on the CAD

Lead tip | x | y | z | R | angle

Coil-local frame of one tooth (y radial, z axial, z = 0 mid-stack). In the stator, coil Tn's start lead sits at 30°×(n−1) , its finish lead at 30°×(n−1) . Both tips end at the weld plane.
