mishravipul361-blip/Ferrite-motor-design/Design9795_1/report_emf/backemf_validation.html

Design9795_1 · open circuit · magnets 100 °C · 1000 rpm · I = 0

# Back-EMF validation: FEMM against Motor-CAD

Verified. Back-EMF amplitude, fundamental, rms, Ke and magnet flux agree with Motor-CAD within 0.7 %. Air-gap, tooth and back-iron flux densities agree within 1 %. THD is 1.48 % against 1.25 %: 0.23 points higher, in the 9th to 13th harmonics that the rotor skew suppresses.

## How the comparison was made

FEMM model

2D magnetostatic, full machine, geometry from the Design9795_1 screenshots (slot area 281.2 mm² and wire fill 0.5129, both exactly as Motor-CAD). Stack 64 mm, DM4654 magnets at 100 °C (Br 0.394 T).

Rotor positions

1° mechanical steps over half an electrical cycle (36 solves); the second half follows from half-wave symmetry, giving 72 points per electrical cycle.

Skew

Motor-CAD rotor skew: 3 equal slices at −2 / 0 / +2° mechanical. FEMM is 2D, so the phase flux linkage is averaged over the three shifted rotor positions, exactly, on its Fourier series.

EMF and THD

Resampled at 30 points per cycle with a forward difference, like Motor-CAD's back-EMF calculation (30 points per cycle, 1 cycle). THD uses harmonics 2 to 15.

## Back-EMF and winding

Quantity | FEMM with skew | Motor-CAD | Difference | FEMM 2D, no skew
Back-EMF phase peak (V) | 10.146 | 10.260 | −1.11 % | 10.386
Back-EMF line-line peak (V), delta | 10.146 | 10.260 | −1.11 % | 10.386
Back-EMF fundamental peak (V) | 10.354 | 10.360 | −0.06 % | 10.460
Back-EMF phase rms (V) | 7.322 | 7.329 | −0.10 % | 7.426
Ke (V·s/rad) | 0.0969 | 0.0980 | −1.16 % | 0.0992
Ke fundamental (V·s/rad) | 0.0989 | 0.0990 | −0.09 % | 0.0999
Magnet flux linkage ψd (mV·s) | 19.77 | 19.83 | −0.28 % | 19.98
THD, phase (%) | 1.48 | 1.25 | +0.23 points | 8.99
Phase resistance at 100 °C (mΩ) | 6.740 | 6.740 | −0.00 % | –

Delta connection: line-line back-EMF equals phase back-EMF, as in Motor-CAD. Phase resistance: 10 turns per coil, 2 coils in series per path, 2 parallel paths, turn length 2 × 64 + 75.634 = 203.6 mm, SWG 11 copper at 100 °C.

Back-EMF waveform and harmonic content

Left: phase back-EMF at 1000 rpm, with and without the Motor-CAD skew. Right: harmonic content. The skew removes most of the 9th, 11th and 13th harmonics, the slot harmonics of a 12-slot, 10-pole machine.

## Harmonics, % of fundamental

FEMM | 3rd | 5th | 7th | 9th | 11th | 13th
With Motor-CAD skew | 0.53 | 0.24 | 0.27 | 1.02 | 0.56 | 0.65
2D, no skew | 0.59 | 0.26 | 0.50 | 3.78 | 5.14 | 6.28

## Flux densities, open circuit

Quantity | FEMM | Motor-CAD | Difference
Air-gap flux density, average | 0.4939 | 0.4956 | −0.3 %
Air-gap flux density, maximum | 0.7676 | 0.7731 | −0.7 %
Stator tooth flux density, maximum | 1.0408 | 1.0440 | −0.3 %
Stator back iron flux density, maximum | 0.9358 | 0.9289 | +0.7 %
Stator tooth tip flux density, maximum | 0.9819 | 1.4690 | different definition
Rotor back iron flux density, maximum | 1.0933 | 1.5180 | different definition

FEMM: air gap = radial B on the mid-gap circle; tooth = B averaged across the tooth width at mid height; back iron = B averaged across the yoke; maximum over all teeth and all 12 rotor positions of the 6° cogging period. Motor-CAD reads the tooth tip and rotor back iron at its own fixed points, so those two cannot be compared one-to-one with section averages.

## What this means for the Lab model

- The magnet flux, which sets torque per amp and the field-weakening speed, matches Motor-CAD to 0.28 %.
- Motor-CAD includes the rotor skew in all its results. The FEMM Lab model is built in 2D, so at the same current its torque will be about 1 % higher (fundamental skew factor 0.990) and its torque ripple higher, unless the same skew correction is applied. The Lab comparison will show both.
