mishravipul361-blip/Ferrite-motor-design/Design9795_1/report_lab/lab_validation.html

Design9795_1 · Lab model · winding and magnets 100 °C · 52 V · 360 A rms · Idc 280 A · MTPA

# FEMM Lab model against Motor-CAD Lab

Equivalent within engineering accuracy. Over the 840 points of the Motor-CAD efficiency map, the refined FEMM model is within 0.28 efficiency points on average, shaft torque within 1.6 %, total loss within 2.7 %. Over the 254 grid points: 0.15 points and 1.0 %. The largest remaining difference is the hysteresis part of the iron loss (-15 %); eddy loss agrees within 4 %, and iron loss overall is -7 %, a small share of the total.

Headline | Motor-CAD | FEMM
Peak efficiency | 95.24 % | 95.36 %
Torque at 0 rpm, 360 A | 44.76 N·m | 44.28 N·m
Efficiency, map points | mean |difference| | 0.28 points
Shaft torque, map points | mean |difference| | 1.6 %
Total loss, map points | mean |difference| | 2.7 %
Iron loss, map points | mean difference | -6.5 %
Efficiency, grid points | mean |difference| | 0.15 points

## 1. How the FEMM model was refined

The first FEMM Lab build (2D, full machine) matched the back-EMF but its torque at full current sat about 1 % under Motor-CAD, and adding the Motor-CAD rotor skew made that worse. The cause was traced to the q-axis flux, then fixed step by step:

Half-machine model

12 slots / 10 poles repeat every 180° with the sign flipped: the model is one half with anti-periodic boundaries and FEMM's air-gap element (fixed meshes, no remeshing per rotor position). Same results as the full machine within 0.1 % (flux linkage) and 0.2 % (torque), 2.2–2.8 × faster.

Stacking factor in the field solution

With the steel BH curve reduced by the 0.97 stacking factor, FEMM's q-axis flux was 3–8 % under Motor-CAD while the d axis matched. A one-at-a-time sensitivity study (table below) shows that only the stacking factor has that signature. Motor-CAD's flux map is reproduced with the BH curve applied unreduced (fill 1.0); 0.97 stays in the masses and the iron loss, which match Motor-CAD's masses exactly.

Rotor skew

Motor-CAD skews the rotor in 3 slices at −2 / 0 / +2° mechanical, and its Lab includes it (its d-axis flux at zero current, 19.835 mV·s, is the skewed open-circuit value). FEMM evaluates each slice with the stator current turned by ∓10° electrical in that slice's rotor frame, turns the flux back and averages: exact for the fundamental, and correct under saturation.

Torque

Motor-CAD Lab torque is 1.5 p (ψd iq − ψq id) (its 44.76 N·m at 1000 rpm reproduces exactly). The refined FEMM model uses the same expression; the FEMM air-gap force torque is shown as the 2D variant.

Iron-loss grid

Fixed-mesh, full-cycle field solutions (30 points per cycle, as Motor-CAD) at 4 d-axis × 5 q-axis currents (was 4 × 3), Motor-CAD's Steinmetz coefficients with the 2π² eddy convention and build factor 1.6. The finer grid showed that the first build's 3-level fit had over-predicted the loss at light load by 20–30 %, which happened to offset an under-prediction; on the true curve, the first-build formulation was 18 % low.

Iron-loss formulation

Motor-CAD's loss settings include a minor-loop factor Kc = 0.65 that the first build ignored. Hysteresis now uses the peak flux density per element and component with the Lavers minor-loop factor 1 + Kc·ΣΔBminor/Bpk; eddy loss uses the sum over harmonics (the dB/dt content). Both come from the same saved field solutions, with no new FEA and no fitted factors.

### What moves the q-axis flux (FEMM, rotor at 0°)

Change from the first build | ψq, iq 60 A | ψq, full current | ψd, iq 60 A | ψd, full current
shaft non-magnetic | -0.0 % | -0.0 % | -0.0 % | -0.0 %
magnet mu_r 1.15 | +2.0 % | +1.5 % | -1.0 % | -3.7 %
magnet mu_r 1.00 | -2.3 % | -1.8 % | +1.2 % | +4.3 %
stacking 1.00 | +4.1 % | +2.3 % | +0.0 % | +0.3 %
air-gap mesh x0.5 | +0.1 % | +0.0 % | -0.0 % | -0.0 %

Low current = id 0, iq 60 A phase peak; full current = Motor-CAD's 1000 rpm envelope point (id −85.0 A, iq 281.4 A phase peak). Single rotor position, so absolute values differ slightly from the position-averaged map. On the map points, the first FEMM build's ψq was -7.3 % (phase current under 100 A) and -2.5 % (over 250 A) against Motor-CAD.

### At Motor-CAD's full-current point, 1000 rpm

Model | ψd (mV·s) | ψq (mV·s) | Torque (N·m)
Motor-CAD Lab | 12.48 | 28.90 | 44.76
FEMM 2D, air-gap force torque | 12.70 (+1.7 %) | 28.83 (-0.2 %) | 44.82 (+0.1 %)
FEMM Motor-CAD equivalent | 12.49 (+0.0 %) | 28.73 (-0.6 %) | 44.67 (-0.2 %)

### Iron-loss formulations against Motor-CAD (same currents and speed, all map points)

Formulation (same FEMM fields) | Stator | Rotor | Hysteresis | Eddy | Total
Fundamental only | -24 % | -99 % | -34 % | -45 % | -38 %
Peak B per component (first build, stator) | -18 % | -77 % | -24 % | -37 % | -30 %
Every harmonic, hysteresis and eddy | -8 % | -25 % | -22 % | +2 % | -11 %
Peak B + minor loops (Kc 0.65) for hysteresis, harmonics for eddy (final) | -7 % | -14 % | -16 % | +2 % | -8 %

Mean signed difference from Motor-CAD.

### Effect of the refinement over all map points (same speed and torque)

FEMM build | Shaft torque | Efficiency (points) | Iron loss | Total loss | Line current
First build: 2D, FEA stacking 0.97, air-gap force torque, iron grid 4 × 3 | 1.5 % | 0.37 | 8.3 % | 3.4 % | 2.3 %
Refined fields: FEA stacking 1.0, skew slices −2/0/+2°, d-q flux torque, iron grid 4 × 5 (iron loss as first build) | 1.5 % | 0.54 | 17.9 % | 6.8 % | 1.5 %
Final: as above + Motor-CAD minor-loop hysteresis, harmonic eddy loss | 1.6 % | 0.28 | 6.6 % | 2.7 % | 1.3 %

Mean absolute difference from Motor-CAD (relative, except efficiency in points).

## 2. Torque-speed envelope

Envelope comparison

Motor-CAD envelope (envelop_1.xlsx) against the FEMM Lab model with the same limits: 52 V DC, modulation 0.95, 360 A rms, 280 A DC, MTPA with field weakening.

rpm | T Motor-CAD | T FEMM | ΔT | P MC (kW) | P FEMM | η MC (%) | η FEMM | I MC (A) | I FEMM | V MC | V FEMM
0 | 44.76 | 44.28 | -1.1 % | 0.00 | 0.00 | – | – | 360 | 360 | 2.0 | 2.0
1000 | 44.20 | 44.13 | -0.2 % | 4.63 | 4.62 | 83.02 | 83.08 | 360 | 360 | 17.8 | 17.7
2000 | 44.11 | 44.03 | -0.2 % | 9.24 | 9.22 | 89.65 | 89.72 | 360 | 360 | 34.4 | 34.0
3000 | 42.66 | 42.68 | +0.0 % | 13.40 | 13.41 | 92.05 | 92.11 | 347 | 349 | 49.4 | 48.4
4000 | 32.45 | 32.44 | -0.0 % | 13.59 | 13.59 | 93.36 | 93.37 | 289 | 293 | 49.4 | 48.6
5000 | 25.96 | 25.93 | -0.1 % | 13.59 | 13.58 | 93.34 | 93.28 | 269 | 274 | 49.4 | 48.4
6000 | 21.52 | 21.47 | -0.3 % | 13.52 | 13.49 | 92.89 | 92.67 | 259 | 267 | 49.4 | 47.8
7000 | 18.31 | 18.31 | -0.0 % | 13.42 | 13.42 | 92.19 | 92.20 | 253 | 255 | 49.4 | 48.2
8000 | 15.87 | 15.95 | +0.5 % | 13.30 | 13.36 | 91.33 | 91.82 | 249 | 241 | 49.4 | 49.4
9000 | 13.98 | 13.89 | -0.7 % | 13.18 | 13.09 | 90.51 | 89.98 | 247 | 254 | 49.4 | 46.9

## 3. Efficiency map

Efficiency maps and difference

Left: Motor-CAD map (Map_1.xlsx). Middle: FEMM. Right: FEMM − Motor-CAD at each Motor-CAD map point, FEMM run at the same speed and shaft torque (MTPA).

Grid comparison

Grid.xlsx: each Motor-CAD grid point (torque × speed), FEMM at the same point.

## 4. Losses, currents and voltage

Parity plots

Every Motor-CAD map point, FEMM at the same speed and shaft torque; colour = speed. Diagonal = perfect agreement.

### Mean absolute difference, Motor-CAD-equivalent FEMM

Quantity | Map: same (n, T) | Map: same currents | Grid: same (n, T) | Grid: same currents
Shaft torque | 1.6 % | 0.9 % | 1.0 % | 0.6 %
Electromagnetic torque | 1.5 % | 1.1 % | 1.0 % | 0.8 %
Efficiency (points) | 0.28 | 0.13 | 0.15 | 0.11
Line current | 1.3 % | 0.0 % | 0.9 % | 0.0 %
Id | 28.5 % | 0.0 % | 20.6 % | 0.0 %
Iq | 1.6 % | 0.0 % | 1.0 % | 0.0 %
Phase voltage | 0.8 % | 1.6 % | 1.0 % | 1.4 %
Power factor | 1.2 % | 0.8 % | 0.9 % | 0.4 %
d-axis flux | 3.2 % | 0.5 % | 2.5 % | 0.4 %
q-axis flux | 2.6 % | 2.5 % | 2.1 % | 2.1 %
DC copper loss | 2.6 % | 0.0 % | 1.7 % | 0.0 %
AC copper loss | 9.5 % | 9.7 % | 6.6 % | 6.6 %
Stator iron loss | 5.2 % | 5.7 % | 5.6 % | 5.9 %
Rotor iron loss | 13.3 % | 13.2 % | 14.0 % | 14.1 %
Hysteresis loss | 14.8 % | 15.4 % | 13.6 % | 14.2 %
Eddy-current loss | 3.8 % | 3.6 % | 4.6 % | 4.2 %
Iron loss | 6.6 % | 7.0 % | 7.0 % | 7.4 %
Mechanical loss | 0.0 % | 0.0 % | 0.0 % | 0.0 %
Total loss | 2.7 % | 2.0 % | 2.5 % | 2.0 %
DC current | 1.4 % | 0.9 % | 1.0 % | 0.7 %

"Same (n, T)": FEMM finds its own MTPA currents for Motor-CAD's speed and shaft torque (what a user of either Lab sees). "Same currents": FEMM evaluated at Motor-CAD's own id and iq, which isolates the flux and loss models. Efficiency in points; the rest relative. Green ≤ 3 % (≤ 0.5 points).

### FEMM 2D (no skew, air-gap force torque, for reference)

Quantity | Map: same (n, T) | Map: same currents | Grid: same (n, T) | Grid: same currents
Shaft torque | 1.6 % | 0.8 % | 0.9 % | 0.8 %
Electromagnetic torque | 1.5 % | 0.9 % | 1.0 % | 0.8 %
Efficiency (points) | 0.35 | 0.19 | 0.25 | 0.18
Line current | 2.1 % | 0.0 % | 1.7 % | 0.0 %
Id | 29.5 % | 0.0 % | 19.2 % | 0.0 %
Iq | 1.8 % | 0.0 % | 1.5 % | 0.0 %
Phase voltage | 0.9 % | 1.1 % | 1.0 % | 0.7 %
Power factor | 2.0 % | 1.1 % | 1.5 % | 0.7 %
d-axis flux | 4.6 % | 1.8 % | 3.6 % | 1.6 %
q-axis flux | 3.2 % | 2.4 % | 2.7 % | 1.8 %
DC copper loss | 4.3 % | 0.0 % | 3.4 % | 0.0 %
AC copper loss | 11.5 % | 9.6 % | 8.2 % | 6.4 %
Stator iron loss | 7.4 % | 6.7 % | 7.3 % | 6.4 %
Rotor iron loss | 15.9 % | 14.5 % | 16.8 % | 15.3 %
Hysteresis loss | 17.1 % | 16.4 % | 15.5 % | 14.7 %
Eddy-current loss | 2.9 % | 3.5 % | 2.9 % | 3.8 %
Iron loss | 8.9 % | 8.0 % | 9.1 % | 8.0 %
Mechanical loss | 0.0 % | 0.0 % | 0.0 % | 0.0 %
Total loss | 3.7 % | 2.3 % | 3.9 % | 2.2 %
DC current | 1.5 % | 0.8 % | 1.1 % | 0.7 %

## 5. d-q flux linkage and torque at the same currents

d-q flux comparison

FEMM against Motor-CAD at Motor-CAD's own id and iq (all map points), against phase current. These set Ld, Lq, the torque per amp and the field-weakening behaviour.

## 6. Open circuit (from the back-EMF validation)

Back-EMF fundamental 10.35 V against Motor-CAD 10.36 V at 1000 rpm, Ke 0.0969 against 0.0980 V·s/rad, magnet flux 19.77 against 19.83 mV·s, THD 1.48 % against 1.25 %.

## 7. What still differs, and why

- Hysteresis loss (-15 %, larger at high speed in field weakening). Eddy loss now agrees, so the field waveforms and frequencies are right; the remaining gap is in how the hysteresis loop is counted. Motor-CAD's exact minor-loop algorithm is not documented in the exported data. FEMM counts loops from 30 samples per cycle per flux component. A further candidate is the lamination fill: if Motor-CAD evaluates the loss at the steel flux density B/0.97, that alone adds about 6 % (0.97⁻².⁰⁷). It was not applied because it cannot be confirmed from the exports. Iron loss is 1–3 % of the input power, so efficiency stays within about 0.1 point.
- Rotor iron loss (-13 %). In a spoke ferrite rotor it comes only from slot and MMF harmonics, the most method-dependent term; a few watts.
- AC copper loss is a few watts; both use the hybrid method with adjustment factor 2, FEMM from its own slot field.
- Current and phase advance at high speed: where the voltage limit is active, small flux differences move the MTPA point along the voltage ellipse; the shaft torque and efficiency stay close because the operating point is defined by them.

## 8. Method and files

FEMM model

backemf.py (geometry from the Design9795_1 screenshots; SYM=1 half model; STACK_FEA), lab_map.py (d-q flux map 6 × 6 currents × 4 rotor positions), iron_loss_age.py (iron loss), iron_fit.py (iron-loss formulations from the saved fields), lab_model.py (Lab: losses, limits, skew slices, torque; loss model v3), make_lab_v2.py (maps), compare9795.py (this comparison).

Motor-CAD

Map_1.xlsx, envelop_1.xlsx, Grid.xlsx (Lab, 100 °C), M235-35A.xlsx; same BH curve and loss coefficients in FEMM.

Settings

DC 52 V, modulation index 0.95, 360 A rms line, Idc 280 A, delta, 10 turns/coil, 2 parallel paths, SWG 11, MLT 203.6 mm, end-winding inductance 1.954 µH, bearing and windage loss as Motor-CAD (148.9 W at 9000 rpm).
