mishravipul361-blip/Ferrite-motor-design/femm_em/archive_uncalibrated/dq_summary.txt

D-Q MAP  (path values, peak; phase current = 2 x path current)
  magnet flux linkage psi_m            0.0220 Wb-turn
  Ld per path, unsat (id=-37.5 A)      220.4 uH    -> per delta phase 110.2 uH
  Lq per path, unsat (iq=37.5 A)       304.3 uH    -> per delta phase 152.2 uH
  at load (id -75, iq 112.5, ~rated):    Ld 185.2 uH, Lq 226.1 uH per path (delta phase 92.6 / 113.0 uH), Lq/Ld 1.22
  characteristic current psi_m/Ld      100 A path peak = 244 A rms line  (current limit 360 A rms)
  d-q torque formula vs FEMM torque    max diff 3.2 N.m

TORQUE-SPEED ENVELOPE  360 A rms + 11 kW DC, 52 V (phase peak 49.4 V), R at 100 C, inverter eff 0.97
     rpm    T N.m  shaft kW  DC kW  Cu loss W  I A rms    id    iq   V peak
       0    48.17     0.00    0.90       871      360    -69   130     2.0
    1000    48.17     5.04    6.10       871      360    -69   130    16.9
    2000    47.03     9.85   11.00       819      349    -61   129    32.4
    3000    32.85    10.32   11.00       349      228    -29    88    43.6
    4000    24.97    10.46   11.00       209      176    -36    62    48.3
    5000    19.76    10.34   10.89       215      179    -55    48    46.1
    6000    16.64    10.46   11.00       211      177    -60    40    48.2
    7000    13.97    10.24   10.78       218      180    -65    34    48.8
    8000    12.34    10.34   10.90       235      187    -70    31    49.3
    9000    10.87    10.25   10.99       417      249    -98    27    35.2
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

Calibration (motor_config.json): {'magnet_temp_C': 20.0, 'stacking': 0.97, 'mu_mag': 1.05}
Not included: end-winding leakage inductance (adds to Ld and Lq -> lower base speed),
iron and mechanical losses (shaft power is a little lower, DC power a little higher), 3D magnet end leakage.
