mishravipul361-blip/Ferrite-motor-design/femm_em/dq_results.png

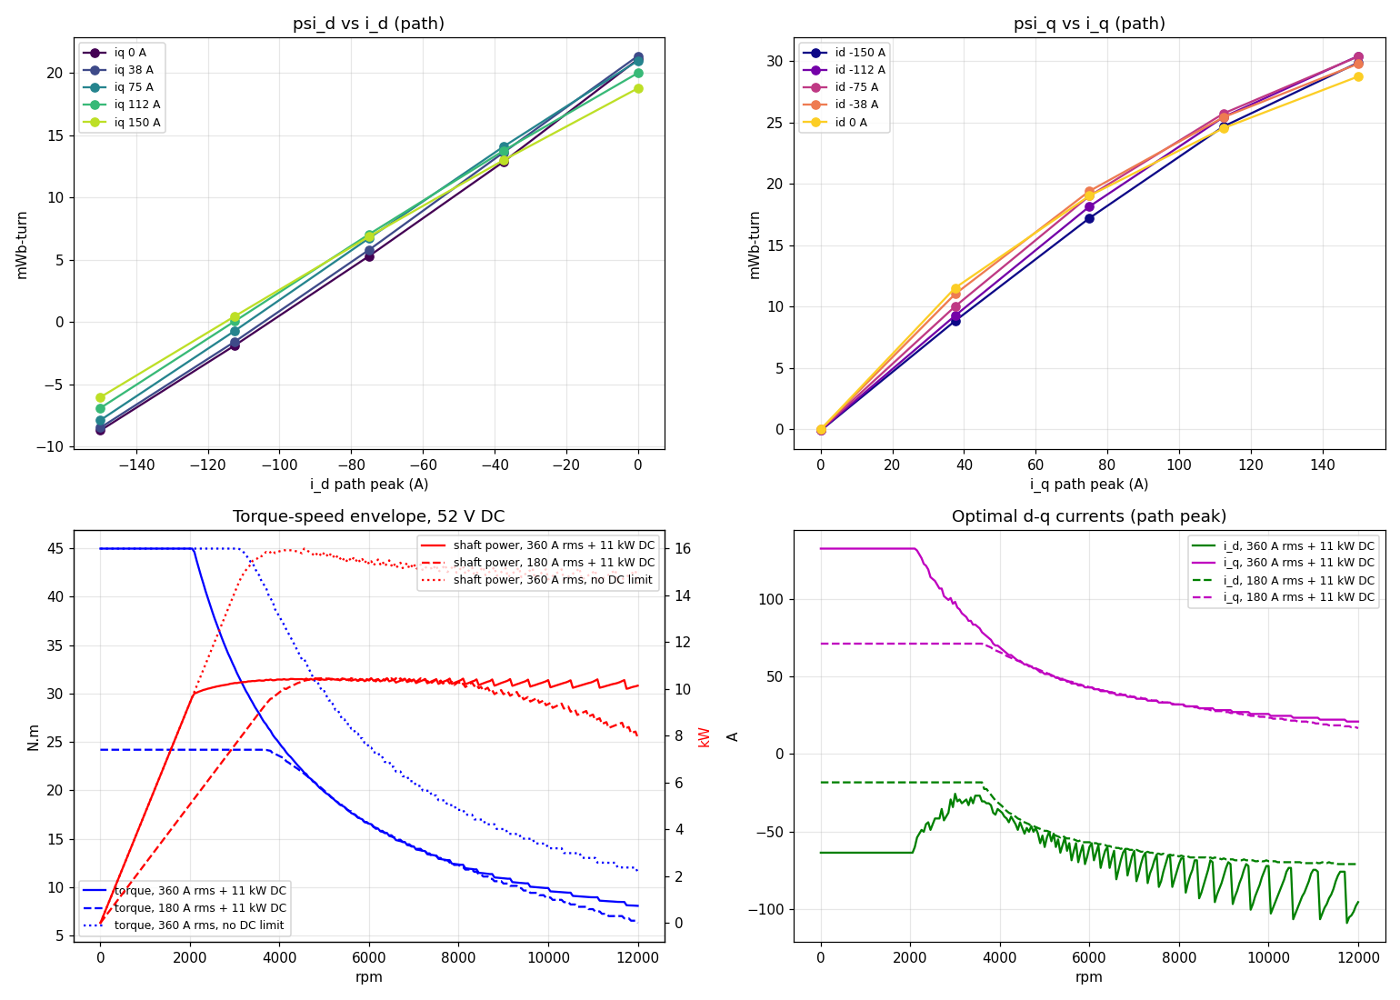
femm_em/dq_results.png
