mishravipul361-blip/Ferrite-motor-design/femm_em/results.png

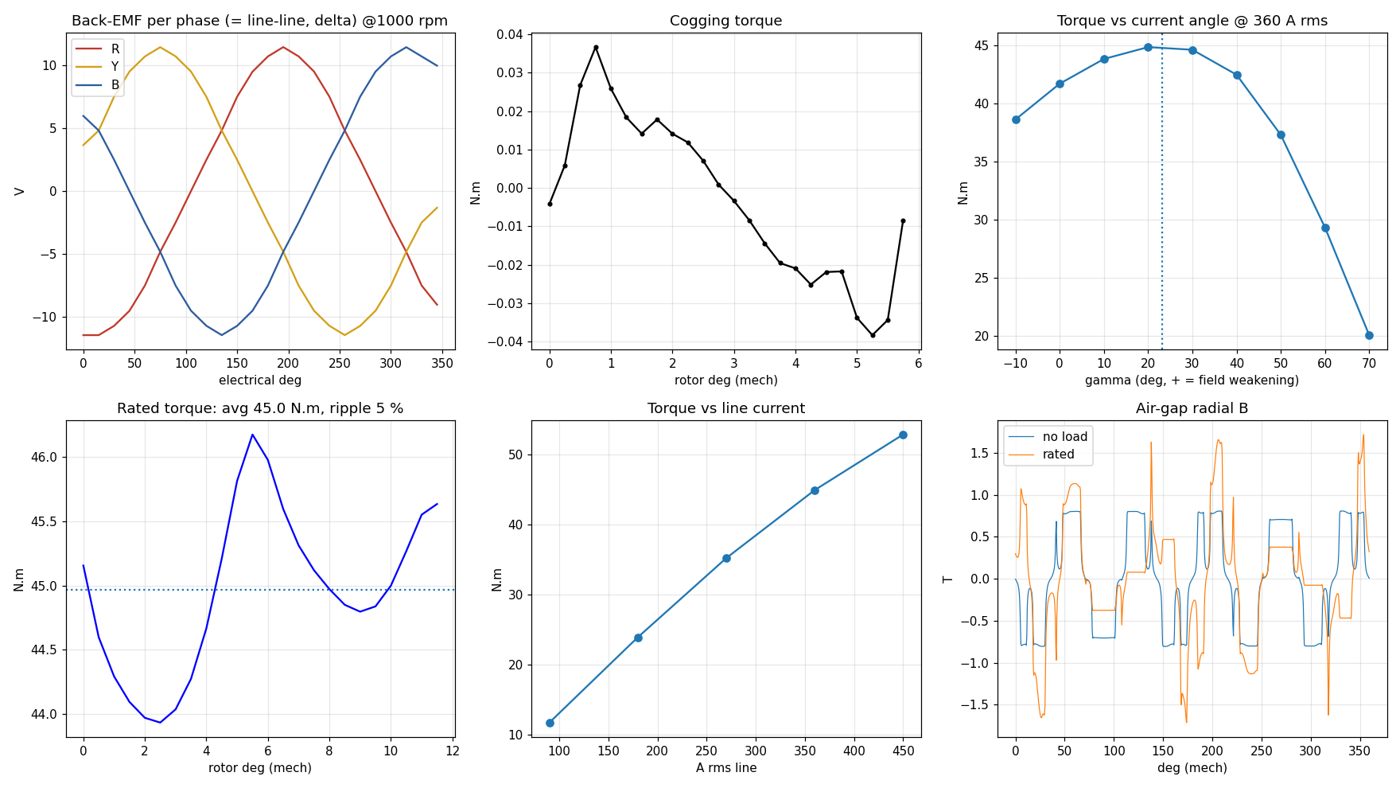
femm_em/results.png
