mishravipul361-blip/Ferrite-motor-design/(commit log)

2026-10-09 Add v7 ferrite motor design: CAD, busbar study, rotor, FEMM EM study
    - cad/: v7 segmented stator, coil, bobbins, busbar CAD (SolidWorks + STEP) and design checks
    - rotor/: spoke rotor parametric explorer
    - busbar/: busbar design study pages, animation scripts, optimisation report
    - femm_em/: FEMM 2D electromagnetic study calibrated to Motor-CAD (45 N.m at 360 A rms),
    torque-speed with 52 V / 11 kW DC limits, efficiency maps, demag check, HTML report
    - Git LFS for CAD and FEMM solution files; videos and old iterations kept local
    [01_tooth_segment_v7.SLDPRT, 01_tooth_segment_v7.stp, 02_bobbin_half_A_v7.SLDPRT, 02_bobbin_half_A_v7.stp, 03_bobbin_half_B_v7.SLDPRT, 03_bobbin_half_B_v7.stp, 04_coil_3mm_v7.SLDPRT, 04_coil_3mm_v7.step]
2026-10-17 Add Spoke V2 aluminium study and Design9795_1 FEMM vs Motor-CAD validation
    Spoke_V2_backemf: FEMM back-EMF, Lab model, aluminium winding sweep,
    drive-cycle and sensitivity studies with their reports.
    Design9795_1: FEMM model tuned to the Motor-CAD design Design9795_1.mot:
    - half-machine model (anti-periodic boundaries, air-gap element)
    - open-circuit back-EMF and flux-density validation (30 points)
    - Lab model at 100 C with Motor-CAD rotor skew slices, d-q flux torque,
    FEA stacking 1.0, refined 4x5 iron-loss grid, minor-loop hysteresis
    - comparison against the Motor-CAD envelope, map and grid exports
    (report_lab/lab_validation.html, report_emf/backemf_validation.html)
    FEMM .fem/.ans so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
    [Grid.xlsx, M235-35A.xlsx, Map_1.xlsx, Spoke_V2_sensitivity.xlsx, alu_tradeoff_summary.csv, envelop_1.xlsx, mcad_lab_envelope_100C.xlsx, mcad_lab_map_100C.xlsx]
2026-10-17 Design9795_1 aluminium study: OP1-OP3 currents, phase advance and loss breakdown
    Claude-Session: https://claude.ai/code/session_01KEjN6yHBH1AJLH2c4SvTCF
2026-10-17 Design9795 conventional aluminium winding at 40 % fill: results and report
    2946 designs (28 stators OD 160-170, stack 64-100 mm, 7-10 turns, fill <= 0.40,
    bundle-effect AC loss, Al end winding 1.136) against busbar copper.
    Full torque: OD 170 86 mm 8 t saves INR 418 at -3.73 % range; least range
    loss OD 170 90 mm 7 t -3.12 % / INR 124. FEMM check of K2, K6 stators.
    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
